TERA-TU-Graz/BatteryManagement_2017/readme.md

# Battery Management System (BMS) with use of STM32 CubeMX
