TERA-TU-Graz/BatteryManagement_2017/HW/projects/ibex/BMS_Ibex/Master/BMS_Master_V6.1_kicad/BMS_Master_V6_kicad.kicad_pcb

## KiCad design HW/projects/ibex/BMS_Ibex/Master/BMS_Master_V6.1_kicad/BMS_Master_V6_kicad.kicad_pcb (2018-10-28, an earlier design)

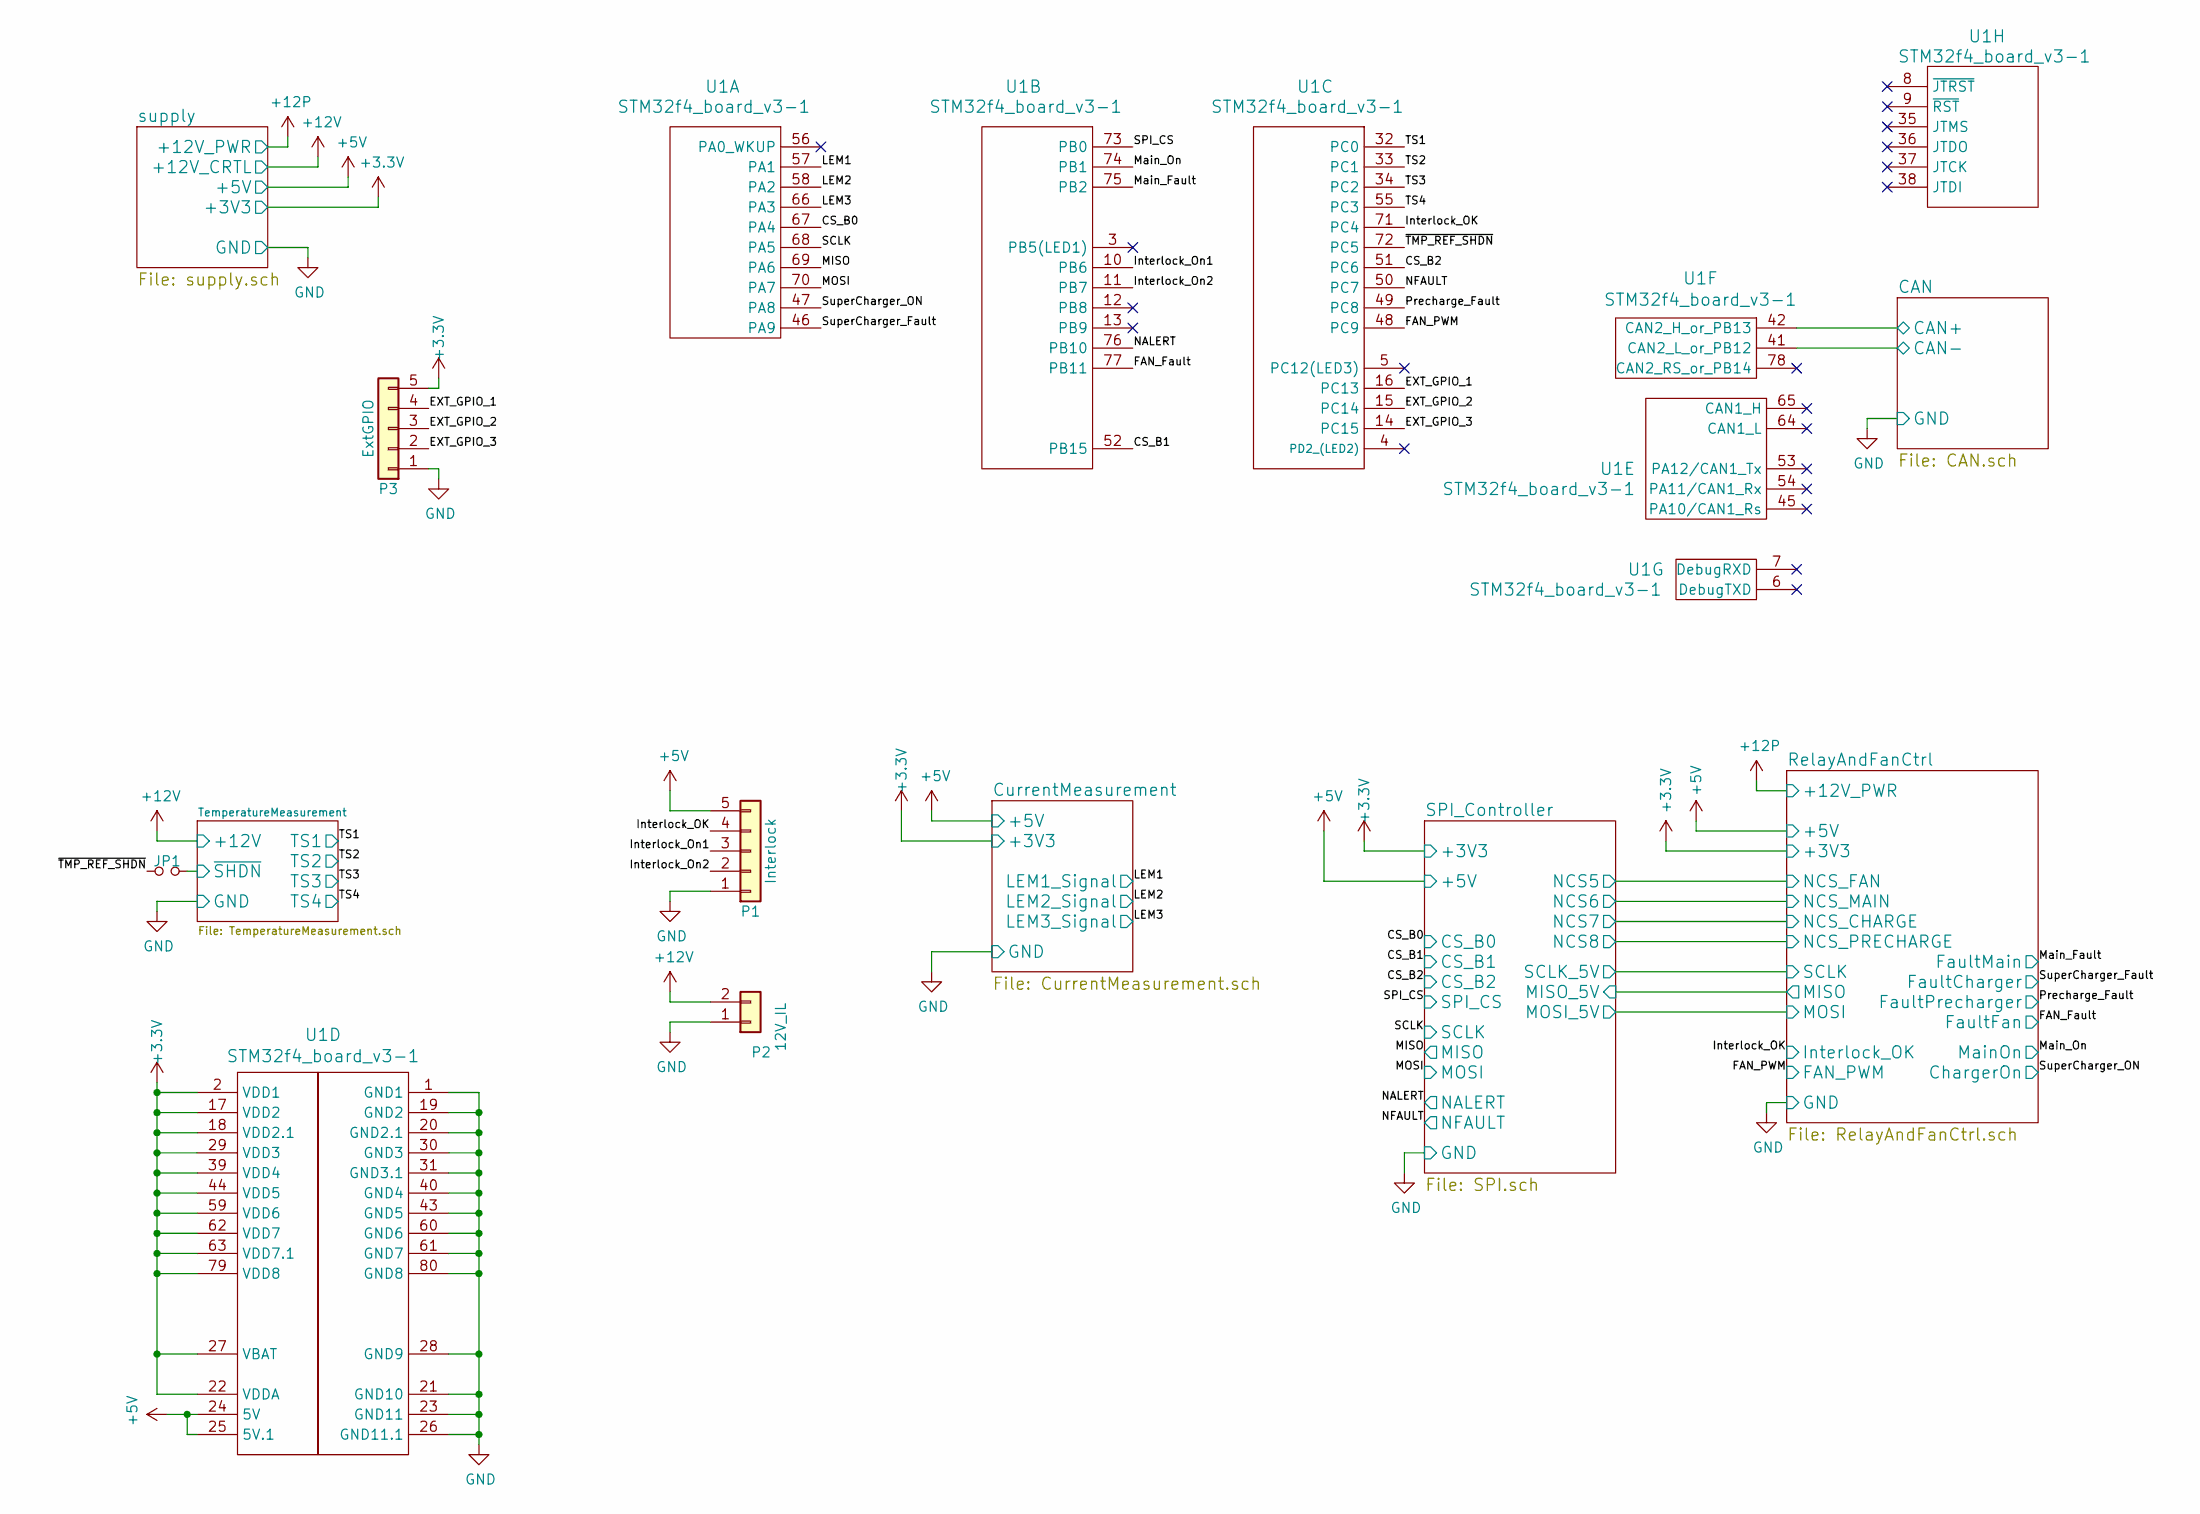
[picture p1: schematic BMS_Master_V6_kicad.sch, BMS Master]

Parts:
JP1: Jumper_NO_Small; SOLDERJUMPER_2
P1: Interlock; JST_XH_B05B-XH-A_05x2.50mm_Straight
P2: 12V_IL; JST_XH_B02B-XH-A_02x2.50mm_Straight
P3: ExtGPIO; JST_EH_B05B-EH-A_05x2.50mm_Straight
U1: STM32f4_board_v3-1; STM32f4-board_v3-1

Connections:
+3V3: P3.5, U1.2 (VDD1), U1.17 (VDD2), U1.18 (VDD2.1), U1.22 (VDDA), U1.27 (VBAT), U1.29 (VDD3), U1.39 (VDD4), U1.44 (VDD5), U1.59 (VDD6), U1.62 (VDD7), U1.63 (VDD7.1), U1.79 (VDD8); also elsewhere on the board
+5V: P1.5, U1.24 (5V), U1.25 (5V.1); also elsewhere on the board
+12V: P2.2; also elsewhere on the board
/CAN/CAN+: U1.42 (CAN2_H_or_PB13); also elsewhere on the board
/CAN/CAN-: U1.41 (CAN2_L_or_PB12); also elsewhere on the board
/CS_B0: U1.67 (PA4); also elsewhere on the board
/CS_B1: U1.52 (PB15); also elsewhere on the board
/CS_B2: U1.51 (PC6); also elsewhere on the board
/EXT_GPIO_1: P3.4, U1.16 (PC13)
/EXT_GPIO_2: P3.3, U1.15 (PC14)
/EXT_GPIO_3: P3.2, U1.14 (PC15)
/FAN_Fault: U1.77 (PB11); also elsewhere on the board
/FAN_PWM: U1.48 (PC9); also elsewhere on the board
/Interlock_OK: P1.4, U1.71 (PC4); also elsewhere on the board
/Interlock_On1: P1.3, U1.10 (PB6)
/Interlock_On2: P1.2, U1.11 (PB7)
/LEM1: U1.57 (PA1); also elsewhere on the board
/LEM2: U1.58 (PA2); also elsewhere on the board
/LEM3: U1.66 (PA3); also elsewhere on the board
/MISO: U1.69 (PA6); also elsewhere on the board
/MOSI: U1.70 (PA7); also elsewhere on the board
/Main_Fault: U1.75 (PB2); also elsewhere on the board
/Main_On: U1.74 (PB1); also elsewhere on the board
/NALERT: U1.76 (PB10); also elsewhere on the board
/NFAULT: U1.50 (PC7); also elsewhere on the board
/Precharge_Fault: U1.49 (PC8); also elsewhere on the board
/SCLK: U1.68 (PA5); also elsewhere on the board
/SPI_CS: U1.73 (PB0); also elsewhere on the board
/SuperCharger_Fault: U1.46 (PA9); also elsewhere on the board
/SuperCharger_ON: U1.47 (PA8); also elsewhere on the board
/TS1: U1.32 (PC0); also elsewhere on the board
/TS2: U1.33 (PC1); also elsewhere on the board
/TS3: U1.34 (PC2); also elsewhere on the board
/TS4: U1.55 (PC3); also elsewhere on the board
/TemperatureMeasurement/~SHDN: JP1.2; also elsewhere on the board
/~TMP_REF_SHDN: JP1.1, U1.72 (PC5)
GND: P1.1, P2.1, P3.1, U1.1 (GND1), U1.19 (GND2), U1.20 (GND2.1), U1.21 (GND10), U1.23 (GND11), U1.26 (GND11.1), U1.28 (GND9), U1.30 (GND3), U1.31 (GND3.1), U1.40 (GND4), U1.43 (GND5), U1.60 (GND6), U1.61 (GND7), U1.80 (GND8); also elsewhere on the board

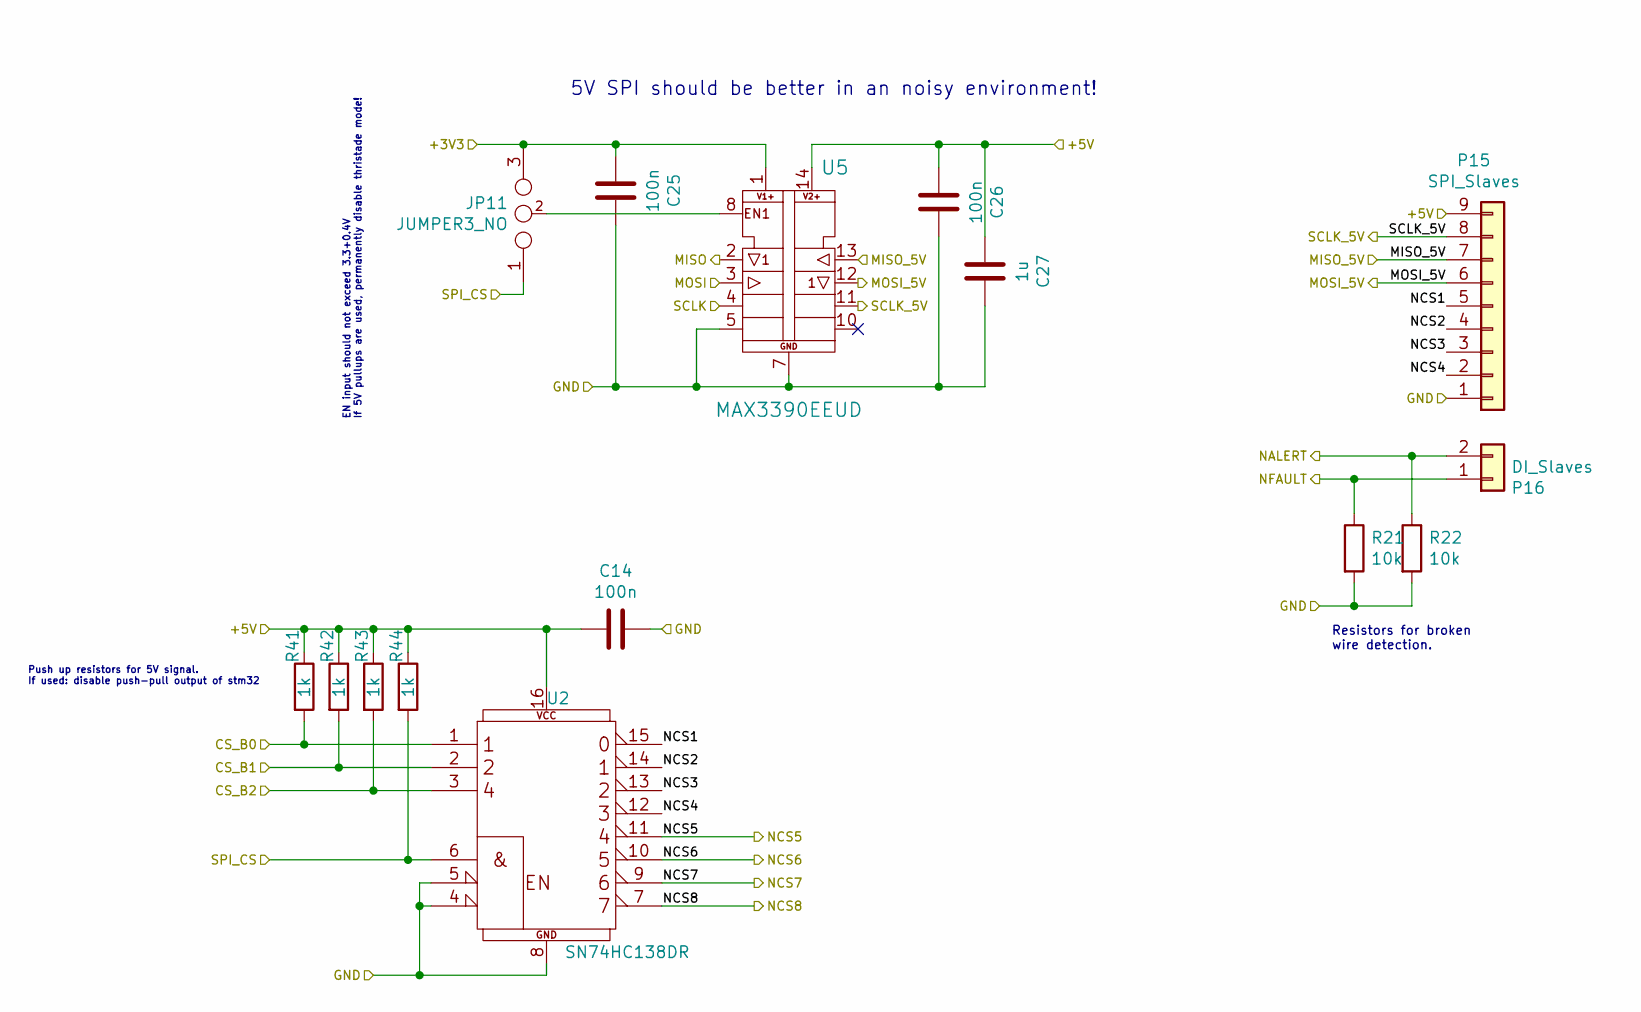
[picture p2: schematic SPI.sch, BMS Master]

Parts:
C14, C25, C26: 100n; C_0603in
C27: 1u; C_0805in
JP11: JUMPER3_NO; SOLDERJUMPER_3
P15: SPI_Slaves; Molex_PicoBlade_53398-0971_09x1.25mm_Straight
P16: DI_Slaves; JST_XH_B02B-XH-A_02x2.50mm_Straight
R21, R22: 10k; R_0805in
R41, R42, R43, R44: 1k; R_0805in
U2: SN74HC138DR
U5: MAX3390EEUD

Connections:
+3V3: C25.2, JP11.3, U5.1 (V1+); also elsewhere on the board
+5V: C14.2, C26.2, C27.2, P15.9, R41.1, R42.1, R43.1, R44.1, U2.16 (VCC), U5.14 (V2+); also elsewhere on the board
/CS_B0: R41.2, U2.1 (A1); also elsewhere on the board
/CS_B1: R42.2, U2.2 (A2); also elsewhere on the board
/CS_B2: R43.2, U2.3 (A4); also elsewhere on the board
/MISO: U5.2 (OUT1); also elsewhere on the board
/MOSI: U5.3 (IN2); also elsewhere on the board
/NALERT: P16.2, R22.1; also elsewhere on the board
/NFAULT: P16.1, R21.1; also elsewhere on the board
/RelayAndFanCtrl/MISO: P15.7, U5.13 (IN1); also elsewhere on the board
/RelayAndFanCtrl/MOSI: P15.6, U5.12 (OUT2); also elsewhere on the board
/RelayAndFanCtrl/SCLK: P15.8, U5.11 (OUT3); also elsewhere on the board
/SCLK: U5.4 (IN3); also elsewhere on the board
/SPI_CS: JP11.1 (m), R44.2, U2.6 (E3); also elsewhere on the board
/SPI_Controller/NCS1: P15.5, U2.15 (O0)
/SPI_Controller/NCS2: P15.4, U2.14 (O1)
/SPI_Controller/NCS3: P15.3, U2.13 (O2)
/SPI_Controller/NCS4: P15.2, U2.12 (O3)
/SPI_Controller/NCS5: U2.11 (O4); also elsewhere on the board
/SPI_Controller/NCS6: U2.10 (O5); also elsewhere on the board
/SPI_Controller/NCS7: U2.9 (O6); also elsewhere on the board
/SPI_Controller/NCS8: U2.7 (O7); also elsewhere on the board
GND: C14.1, C25.1, C26.1, C27.1, P15.1, R21.2, R22.2, U2.4 (E1), U2.5 (E2), U2.8 (GND), U5.5 (IN4), U5.7 (GND); also elsewhere on the board
unnamed: JP11.2, U5.8 (EN1)

Notes on the sheet:
Resistors for broken wire detection.
5V SPI should be better in an noisy environment!
EN input should not exceed 3.3+0.4V If 5V pullups are used, permanently disable thristade mode!
Push up resistors for 5V signal. If used: disable push-pull output of stm32

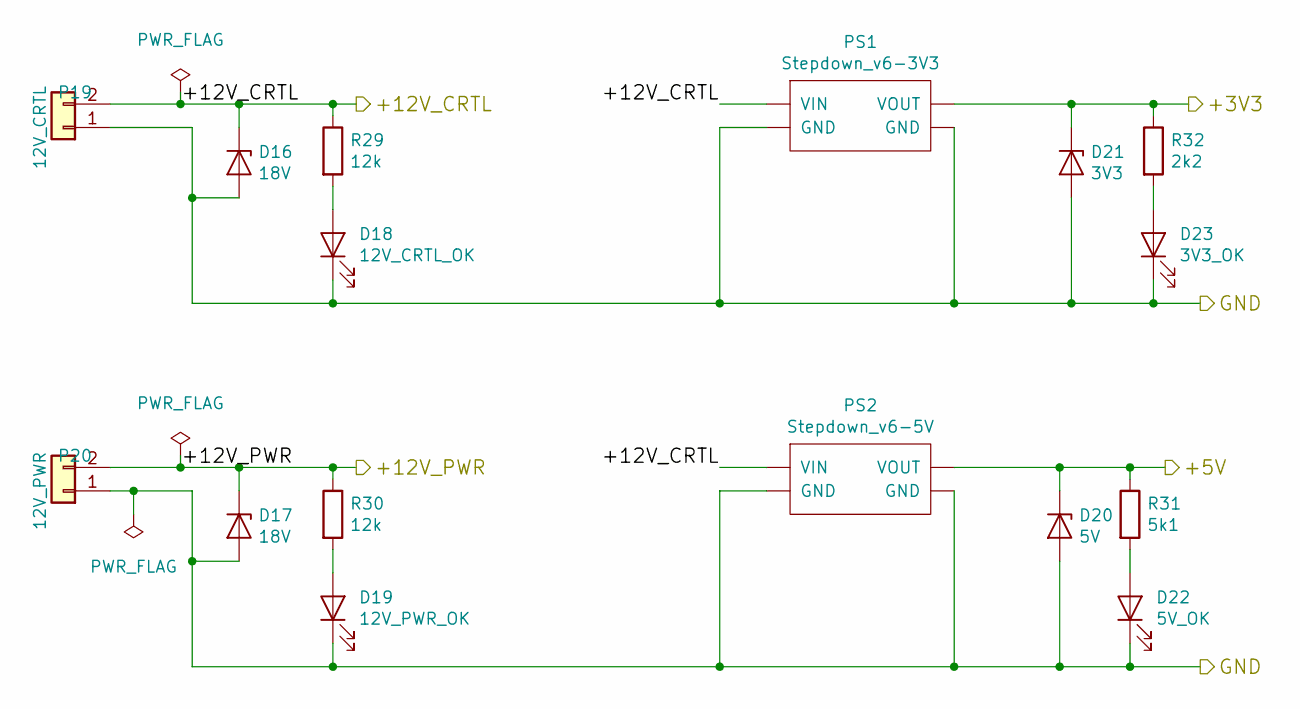
[picture p3: schematic supply.sch, BMS Master]

Parts:
D16, D17: 18V; DO-214AA_with_vias_in_pad
D18: 12V_CRTL_OK; LED_0805
D19: 12V_PWR_OK; LED_0805
D20: 5V; DO-216AA
D21: 3V3; DO-216AA
D22: 5V_OK; LED_0805
D23: 3V3_OK; LED_0805
P19: 12V_CRTL; JST_XH_B02B-XH-A_02x2.50mm_Straight
P20: 12V_PWR; MCV_1.5_2-GF-3.5
PS1: Stepdown_v6-3V3; DCDC_Stepdown_v6
PS2: Stepdown_v6-5V; DCDC_Stepdown_v6
R29, R30: 12k; R_0805in
R31: 5k1; R_0805in
R32: 2k2; R_0805in

Connections:
+3V3: D21.1 (K), PS1.2 (VOUT), R32.1; also elsewhere on the board
+5V: D20.1 (K), PS2.2 (VOUT), R31.1; also elsewhere on the board
+12P: D17.1 (K), P20.2, R30.1; also elsewhere on the board
+12V: D16.1 (K), P19.2, PS1.1 (VIN), PS2.1 (VIN), R29.1; also elsewhere on the board
GND: D16.2 (A), D17.2 (A), D18.1 (K), D19.1 (K), D20.2 (A), D21.2 (A), D22.1 (K), D23.1 (K), P19.1, P20.1, PS1.3 (GND), PS1.4 (GND), PS2.3 (GND), PS2.4 (GND); also elsewhere on the board
unnamed: D18.2 (A), R29.2
unnamed: D19.2 (A), R30.2
unnamed: D22.2 (A), R31.2
unnamed: D23.2 (A), R32.2

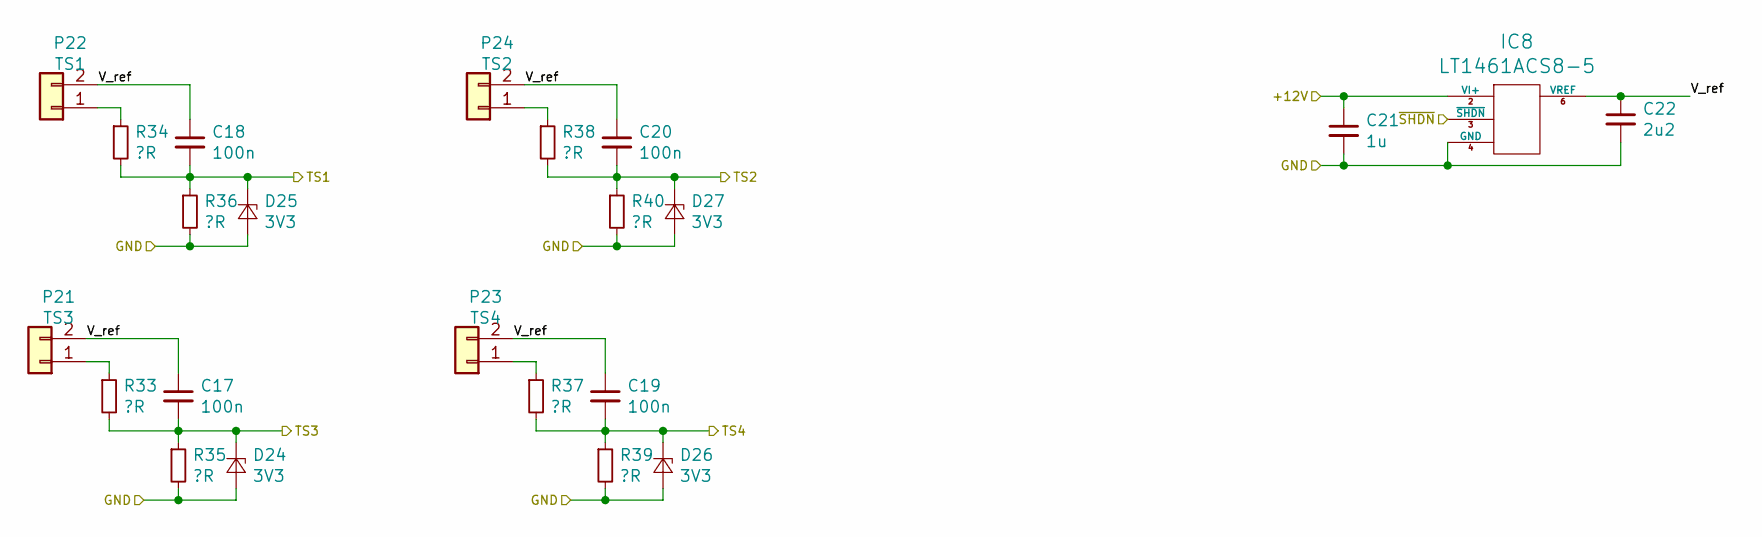
[picture p4: schematic TemperatureMeasurement.sch, BMS Master]

Parts:
C17, C18, C19, C20: 100n; C_0603in
C21: 1u; C_0805in
C22: 2u2; C_0805in
D24, D25, D26, D27: 3V3; DO-216AA
IC8: LT1461ACS8-5; LT1461ACS8
P21: TS3; Molex_PicoBlade_53398-0271_02x1.25mm_Straight
P22: TS1; Molex_PicoBlade_53398-0271_02x1.25mm_Straight
P23: TS4; Molex_PicoBlade_53398-0271_02x1.25mm_Straight
P24: TS2; Molex_PicoBlade_53398-0271_02x1.25mm_Straight
R33, R34, R35, R36, R37, R38, R39, R40: ?R; R_0603in

Connections:
+12V: C21.1, IC8.2 (VI+); also elsewhere on the board
/TS1: C18.2, D25.1 (K), R34.2, R36.1; also elsewhere on the board
/TS2: C20.2, D27.1 (K), R38.2, R40.1; also elsewhere on the board
/TS3: C17.2, D24.1 (K), R33.2, R35.1; also elsewhere on the board
/TS4: C19.2, D26.1 (K), R37.2, R39.1; also elsewhere on the board
/TemperatureMeasurement/V_ref: C17.1, C18.1, C19.1, C20.1, C22.1, IC8.6 (VREF), P21.2, P22.2, P23.2, P24.2
/TemperatureMeasurement/~SHDN: IC8.3 (~SHDN); also elsewhere on the board
GND: C21.2, C22.2, D24.2 (A), D25.2 (A), D26.2 (A), D27.2 (A), IC8.4 (GND), R35.2, R36.2, R39.2, R40.2; also elsewhere on the board
unnamed: P21.1, R33.1
unnamed: P22.1, R34.1
unnamed: P23.1, R37.1
unnamed: P24.1, R38.1

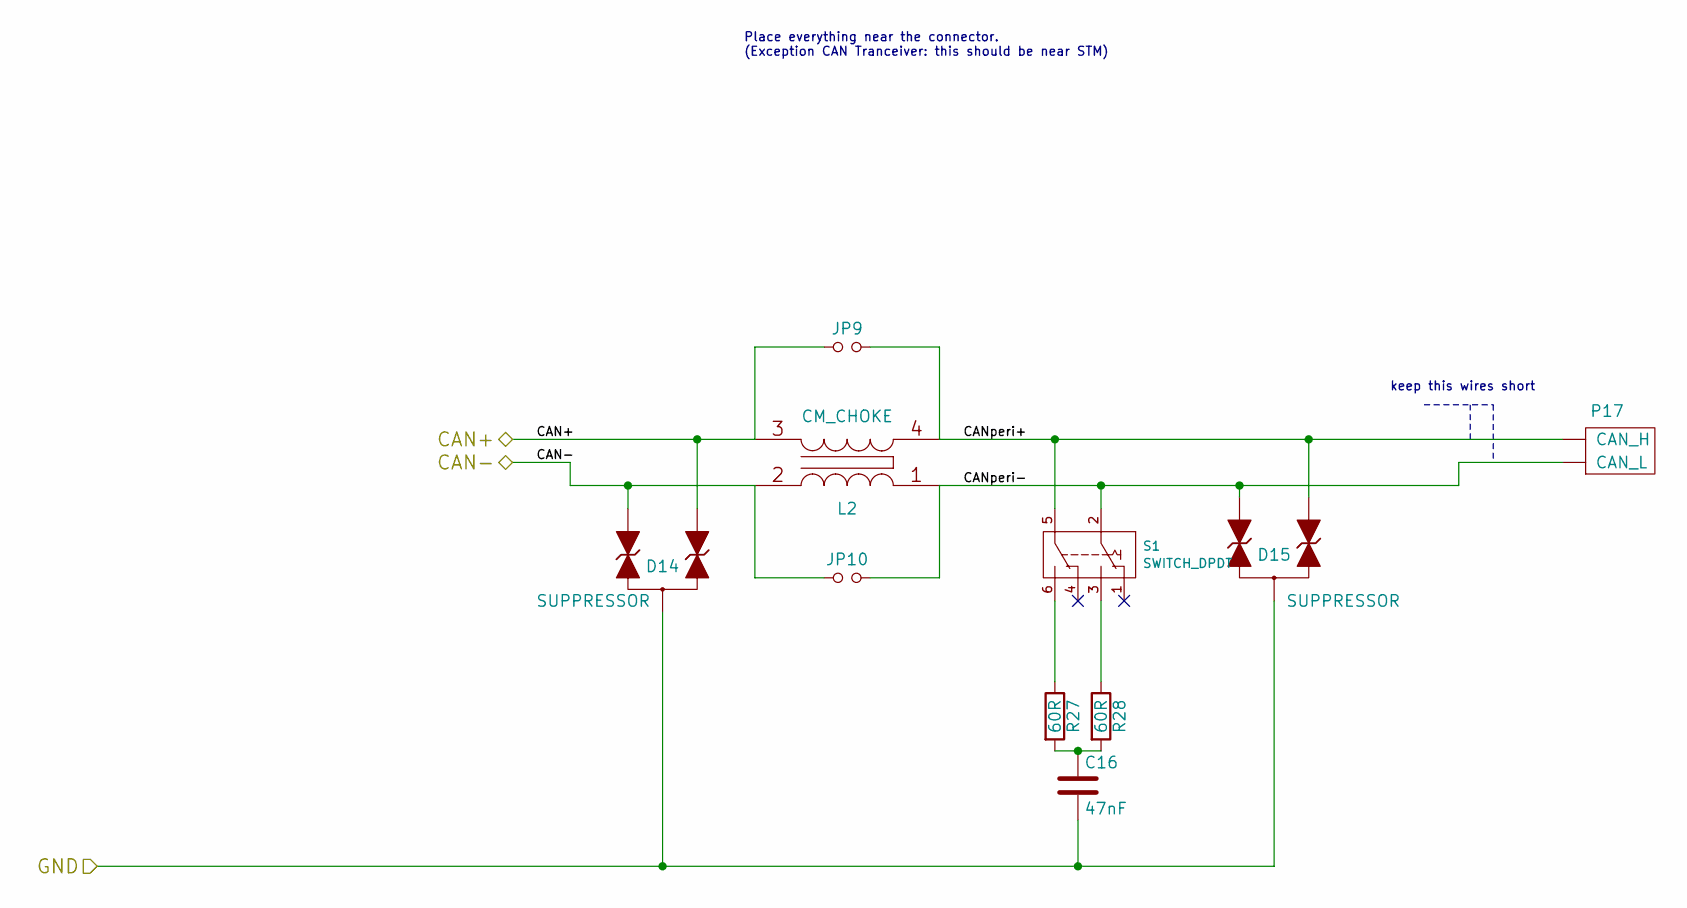
[picture p5: schematic CAN.sch, BMS Master]

Parts:
C15: 47nF; C_0603in
D12, D13: SUPPRESSOR; SOT-23
JP7, JP8: Jumper_NO_Small; SOLDERJUMPER_2
L1: CM_CHOKE; L_ACT45B-XXX-2P_common-mode-choke
P17: CAN_CON_2pol; JST_PH_B2B-PH-K_02x2.00mm_Straight
R24, R25: 60R; R_0603in
S1: SWITCH_DPDT; CuK_JS202011CQN_DPDT

Connections:
/CAN/CANperi+: P17.2 (CAN_H), S1.5; also elsewhere on the board
/CAN/CANperi-: P17.1 (CAN_L), S1.2; also elsewhere on the board
unnamed 93: S1.6; also elsewhere on the board
unnamed 94: S1.3; also elsewhere on the board

Parts of its further copies:
C16: 47nF; C_0603in
D14, D15: SUPPRESSOR; SOT-23
JP9, JP10: Jumper_NO_Small; SOLDERJUMPER_2
L2: CM_CHOKE; L_ACT45B-XXX-2P_common-mode-choke
R27, R28: 60R; R_0603in

Connections of its further copies:
/CAN/CAN+: D14.2 (Pin2), JP9.1, L2.3 (SA); also elsewhere on the board
/CAN/CAN-: D14.1 (Pin1), JP10.1, L2.2 (AB); also elsewhere on the board
/CAN/CANperi+: D15.2 (Pin2), JP9.2, L2.4 (SB); also elsewhere on the board
/CAN/CANperi-: D15.1 (Pin1), JP10.2, L2.1 (AA); also elsewhere on the board
GND: C16.2, D14.3 (Pin3), D15.3 (Pin3); also elsewhere on the board
unnamed: C16.1, R27.2, R28.2
unnamed 93: R27.1; also elsewhere on the board
unnamed 94: R28.1; also elsewhere on the board

Notes on the sheet:
Place everything near the connector. (Exception CAN Tranceiver: this should be near STM)
keep this wires short

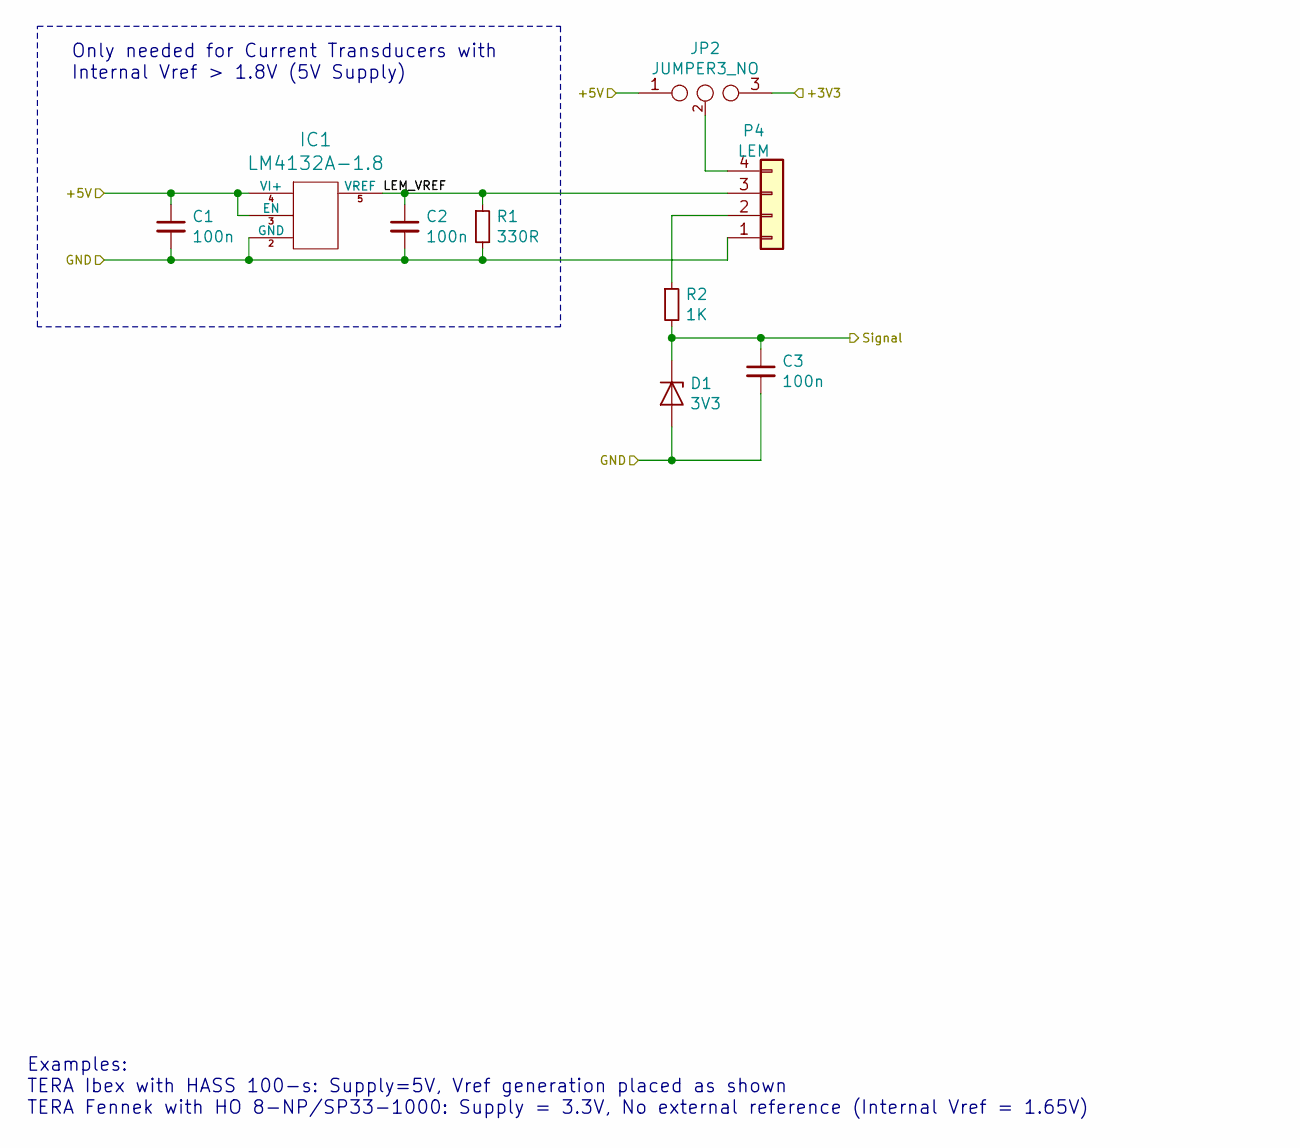
[picture p6: schematic LEM.sch, BMS Master]

Parts:
C1, C2, C3: 100n; C_0603in
D1: 3V3; DO-216AA
IC1: LM4132A-1.8; LM4132A
JP2: JUMPER3_NO; SOLDERJUMPER_3
P4: LEM; Molex_PicoBlade_53398-0471_04x1.25mm_Straight
R1: 330R; R_0603in
R2: 1K; R_0805in

Connections:
+3V3: JP2.3; also elsewhere on the board
+5V: C1.1, IC1.3 (EN), IC1.4 (VI+), JP2.1 (m); also elsewhere on the board
/CurrentMeasurement/LEM1/LEM_VREF: C2.1, IC1.5 (VREF), P4.3, R1.1
/LEM1: C3.1, D1.1 (K), R2.2; also elsewhere on the board
GND: C1.2, C2.2, C3.2, D1.2 (A), IC1.2 (GND), P4.1, R1.2; also elsewhere on the board
unnamed: JP2.2, P4.4
unnamed: P4.2, R2.1

Parts of its further copies:
C4, C5, C6, C7, C8, C9: 100n; C_0603in
D2, D3: 3V3; DO-216AA
IC2, IC3: LM4132A-1.8; LM4132A
JP3, JP4: JUMPER3_NO; SOLDERJUMPER_3
P5, P6: LEM; Molex_PicoBlade_53398-0471_04x1.25mm_Straight
R3, R5: 330R; R_0603in
R4, R6: 1K; R_0805in

Connections of its further copies:
+3V3: JP3.3, JP4.3; also elsewhere on the board
+5V: C4.1, C7.1, IC2.3 (EN), IC2.4 (VI+), IC3.3 (EN), IC3.4 (VI+), JP3.1 (m), JP4.1 (m); also elsewhere on the board
/CurrentMeasurement/LEM2/LEM_VREF: C5.1, IC2.5 (VREF), P5.3, R3.1
/CurrentMeasurement/LEM3/LEM_VREF: C8.1, IC3.5 (VREF), P6.3, R5.1
/LEM2: C6.1, D2.1 (K), R4.2; also elsewhere on the board
/LEM3: C9.1, D3.1 (K), R6.2; also elsewhere on the board
GND: C4.2, C5.2, C6.2, C7.2, C8.2, C9.2, D2.2 (A), D3.2 (A), IC2.2 (GND), IC3.2 (GND), P5.1, P6.1, R3.2, R5.2; also elsewhere on the board
unnamed: JP3.2, P5.4
unnamed: JP4.2, P6.4
unnamed: P5.2, R4.1
unnamed: P6.2, R6.1

Notes on the sheet:
Only needed for Current Transducers with Internal Vref > 1.8V (5V Supply)
Examples: TERA Ibex with HASS 100-s: Supply=5V, Vref generation placed as shown TERA Fennek with HO 8-NP/SP33-1000: Supply = 3.3V, No external reference (Internal Vref = 1.65V)

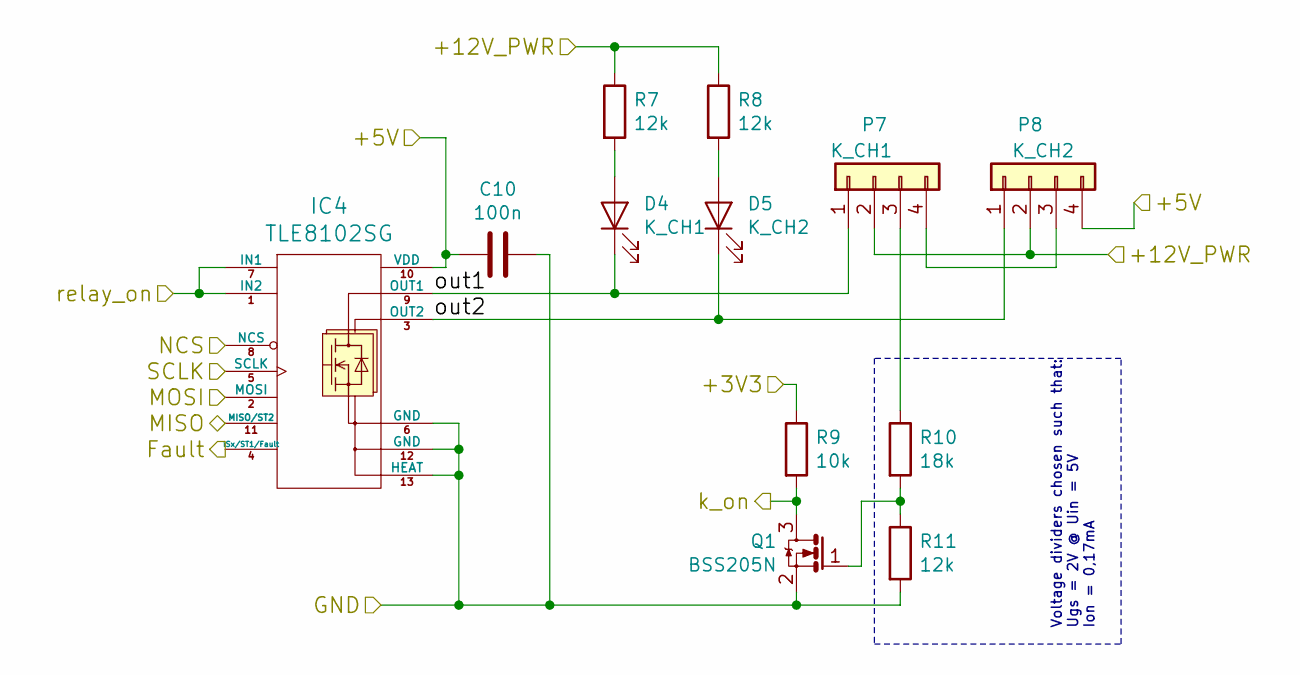
[picture p7: schematic 2xRelaisWithRM.sch, BMS Master]

Parts:
C10: 100n; C_0603in
D4: K_CH1; LED_0805
D5: K_CH2; LED_0805
IC4: TLE8102SG; INF-PG-DSO-12-11-EP_N_EPvias
P7: K_CH1; JST_XH_B04B-XH-A_04x2.50mm_Straight
P8: K_CH2; JST_XH_B04B-XH-A_04x2.50mm_Straight
Q1: BSS205N; SOT-23
R7, R8, R11: 12k; R_0805in
R9: 10k; R_0603in
R10: 18k; R_0805in

Connections:
+3V3: R9.1; also elsewhere on the board
+5V: C10.2, IC4.10 (VDD), P8.4; also elsewhere on the board
+12P: P7.2, P8.2, R7.1, R8.1; also elsewhere on the board
/Interlock_OK: IC4.1 (IN2), IC4.7 (IN1); also elsewhere on the board
/RelayAndFanCtrl/MISO: IC4.11 (MISO/ST2); also elsewhere on the board
/RelayAndFanCtrl/MOSI: IC4.2 (MOSI); also elsewhere on the board
/RelayAndFanCtrl/SCLK: IC4.5 (SCLK); also elsewhere on the board
/RelayAndFanCtrl/SuperChargerRelais/out1: D4.1 (K), IC4.9 (OUT1), P7.1
/RelayAndFanCtrl/SuperChargerRelais/out2: D5.1 (K), IC4.3 (OUT2), P8.1
/SPI_Controller/NCS7: IC4.8 (NCS); also elsewhere on the board
/SuperCharger_Fault: IC4.4 (ISx/ST1/Fault); also elsewhere on the board
/SuperCharger_ON: Q1.3 (D), R9.2; also elsewhere on the board
GND: C10.1, IC4.6 (GND), IC4.12 (GND), IC4.13 (HEAT), Q1.2 (S), R11.2; also elsewhere on the board
unnamed: D4.2 (A), R7.2
unnamed: D5.2 (A), R8.2
unnamed: P7.3, R10.1
unnamed: P7.4, P8.3
unnamed: Q1.1 (G), R10.2, R11.1

Parts of its further copies:
C11: 100n; C_0603in
D6: K_CH1; LED_0805
D7: K_CH2; LED_0805
IC5: TLE8102SG; INF-PG-DSO-12-11-EP_N_EPvias
P9: K_CH1; JST_XH_B04B-XH-A_04x2.50mm_Straight
P10: K_CH2; JST_XH_B04B-XH-A_04x2.50mm_Straight
Q2: BSS205N; SOT-23
R12, R13, R16: 12k; R_0805in
R14: 10k; R_0603in
R15: 18k; R_0805in

Connections of its further copies:
+3V3: R14.1; also elsewhere on the board
+5V: C11.2, IC5.10 (VDD), P10.4; also elsewhere on the board
+12P: P9.2, P10.2, R12.1, R13.1; also elsewhere on the board
/Interlock_OK: IC5.1 (IN2), IC5.7 (IN1); also elsewhere on the board
/Main_Fault: IC5.4 (ISx/ST1/Fault); also elsewhere on the board
/Main_On: Q2.3 (D), R14.2; also elsewhere on the board
/RelayAndFanCtrl/MISO: IC5.11 (MISO/ST2); also elsewhere on the board
/RelayAndFanCtrl/MOSI: IC5.2 (MOSI); also elsewhere on the board
/RelayAndFanCtrl/MainRelais/out1: D6.1 (K), IC5.9 (OUT1), P9.1
/RelayAndFanCtrl/MainRelais/out2: D7.1 (K), IC5.3 (OUT2), P10.1
/RelayAndFanCtrl/SCLK: IC5.5 (SCLK); also elsewhere on the board
/SPI_Controller/NCS6: IC5.8 (NCS); also elsewhere on the board
GND: C11.1, IC5.6 (GND), IC5.12 (GND), IC5.13 (HEAT), Q2.2 (S), R16.2; also elsewhere on the board
unnamed: D6.2 (A), R12.2
unnamed: D7.2 (A), R13.2
unnamed: P9.3, R15.1
unnamed: P9.4, P10.3
unnamed: Q2.1 (G), R15.2, R16.1

Notes on the sheet:
Voltage dividers chosen such that: Ugs = 2V @ Uin = 5V Ion = 0,17mA

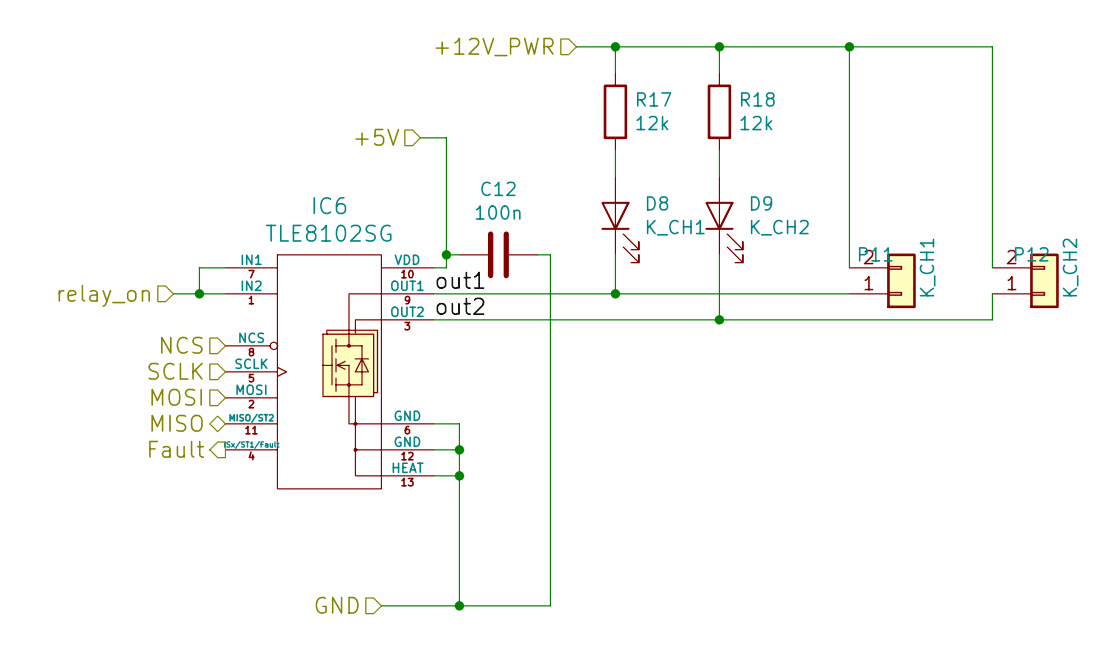
[picture p8: schematic 2xLowSideSwitch8A.sch, BMS Master]

Parts:
C12: 100n; C_0603in
D8: K_CH1; LED_0805
D9: K_CH2; LED_0805
IC6: TLE8102SG; INF-PG-DSO-12-11-EP_N_EPvias
P11: K_CH1; JST_XH_B02B-XH-A_02x2.50mm_Straight
P12: K_CH2; JST_XH_B02B-XH-A_02x2.50mm_Straight
R17, R18: 12k; R_0805in

Connections:
+5V: C12.2, IC6.10 (VDD); also elsewhere on the board
+12P: P11.2, P12.2, R17.1, R18.1; also elsewhere on the board
/Interlock_OK: IC6.1 (IN2), IC6.7 (IN1); also elsewhere on the board
/Precharge_Fault: IC6.4 (ISx/ST1/Fault); also elsewhere on the board
/RelayAndFanCtrl/MISO: IC6.11 (MISO/ST2); also elsewhere on the board
/RelayAndFanCtrl/MOSI: IC6.2 (MOSI); also elsewhere on the board
/RelayAndFanCtrl/PRECHARGER/out1: D8.1 (K), IC6.9 (OUT1), P11.1
/RelayAndFanCtrl/PRECHARGER/out2: D9.1 (K), IC6.3 (OUT2), P12.1
/RelayAndFanCtrl/SCLK: IC6.5 (SCLK); also elsewhere on the board
/SPI_Controller/NCS8: IC6.8 (NCS); also elsewhere on the board
GND: C12.1, IC6.6 (GND), IC6.12 (GND), IC6.13 (HEAT); also elsewhere on the board
unnamed: D8.2 (A), R17.2
unnamed: D9.2 (A), R18.2

Parts of its further copies:
C13: 100n; C_0603in
D10: K_CH1; LED_0805
D11: K_CH2; LED_0805
IC7: TLE8102SG; INF-PG-DSO-12-11-EP_N_EPvias
P13: K_CH1; JST_XH_B02B-XH-A_02x2.50mm_Straight
P14: K_CH2; JST_XH_B02B-XH-A_02x2.50mm_Straight
R19, R20: 12k; R_0805in

Connections of its further copies:
+5V: C13.2, IC7.10 (VDD); also elsewhere on the board
+12P: P13.2, P14.2, R19.1, R20.1; also elsewhere on the board
/FAN_Fault: IC7.4 (ISx/ST1/Fault); also elsewhere on the board
/FAN_PWM: IC7.1 (IN2), IC7.7 (IN1); also elsewhere on the board
/RelayAndFanCtrl/FANS/out1: D10.1 (K), IC7.9 (OUT1), P13.1
/RelayAndFanCtrl/FANS/out2: D11.1 (K), IC7.3 (OUT2), P14.1
/RelayAndFanCtrl/MISO: IC7.11 (MISO/ST2); also elsewhere on the board
/RelayAndFanCtrl/MOSI: IC7.2 (MOSI); also elsewhere on the board
/RelayAndFanCtrl/SCLK: IC7.5 (SCLK); also elsewhere on the board
/SPI_Controller/NCS5: IC7.8 (NCS); also elsewhere on the board
GND: C13.1, IC7.6 (GND), IC7.12 (GND), IC7.13 (HEAT); also elsewhere on the board
unnamed: D10.2 (A), R19.2
unnamed: D11.2 (A), R20.2

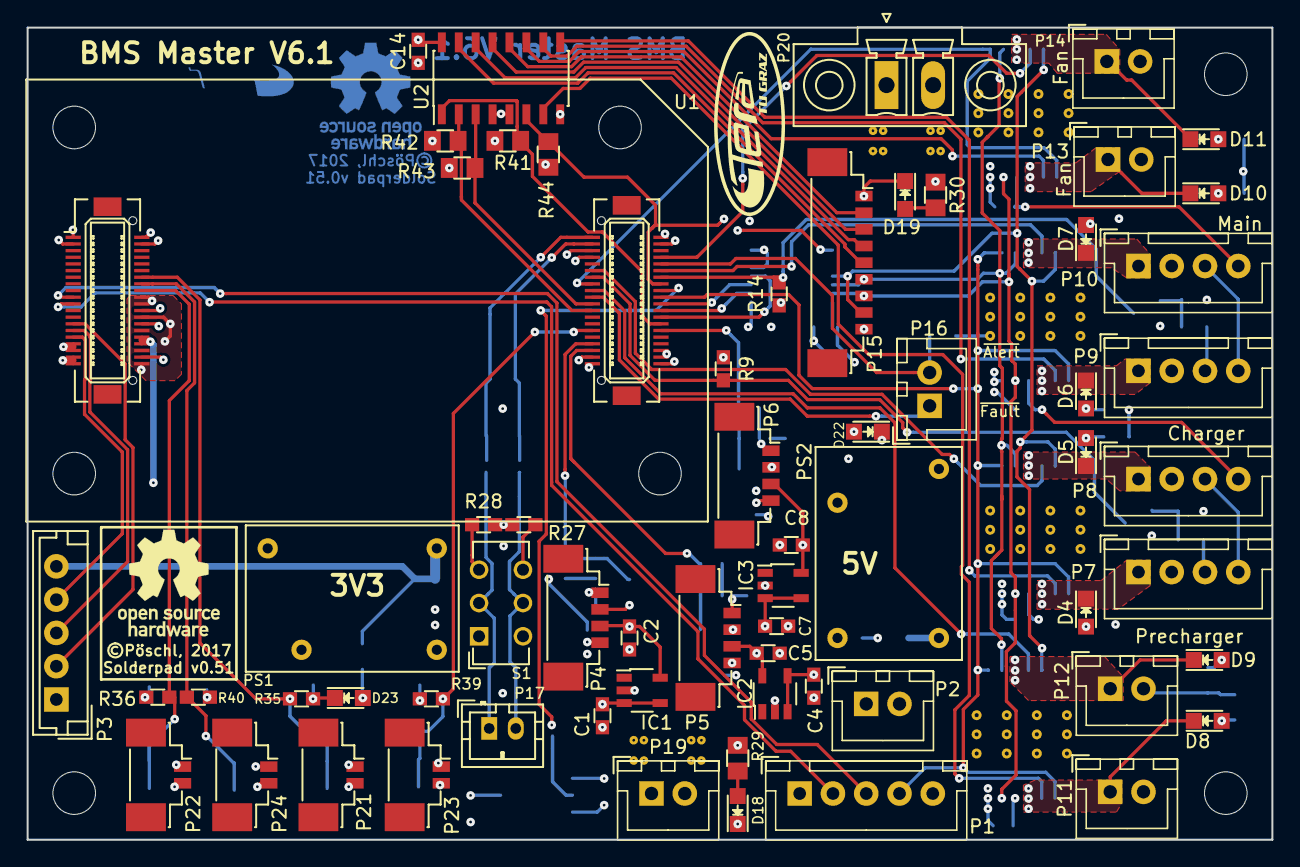
[picture p9: board BMS_Master_V6_kicad.kicad_pcb from above]

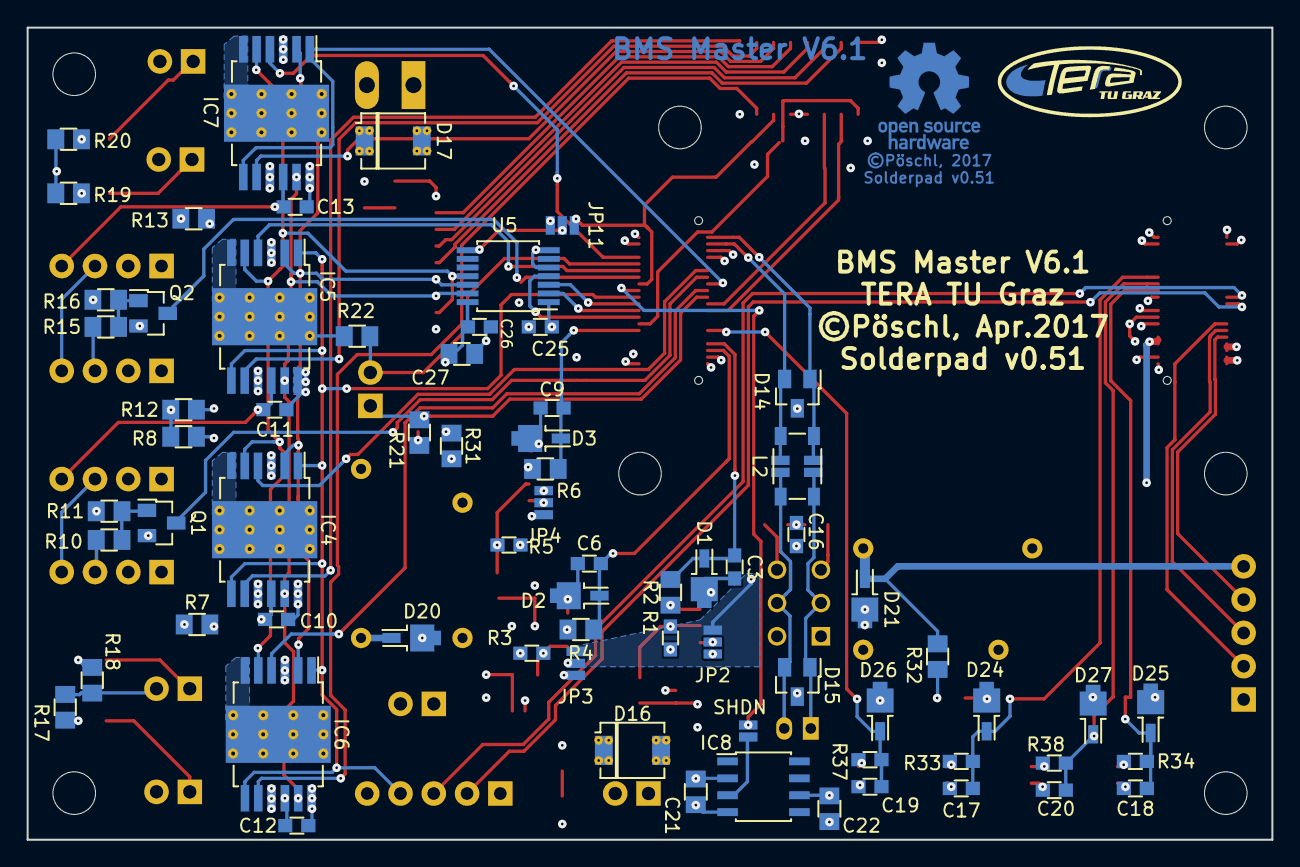
[picture p10: board BMS_Master_V6_kicad.kicad_pcb from below]

Board: 4 copper layers, 93.5 x 61.0 mm, 138 parts (73 on the bottom side), 95 nets.

Other parts of the board:
svg2mod: G***; TERA_Logo_SilkS_5x12.5mm
svg2mod#2: G***; TERA_Logo_SilkS_and_Cu_5x12.5mm
