TERA-TU-Graz/BatteryManagement_2017/HW/projects/ibex/BMS_Ibex/Interlock/InterlockV2.1-kicad/Interlock.kicad_pcb

## KiCad design HW/projects/ibex/BMS_Ibex/Interlock/InterlockV2.1-kicad/Interlock.kicad_pcb (2018-10-28, an earlier design)

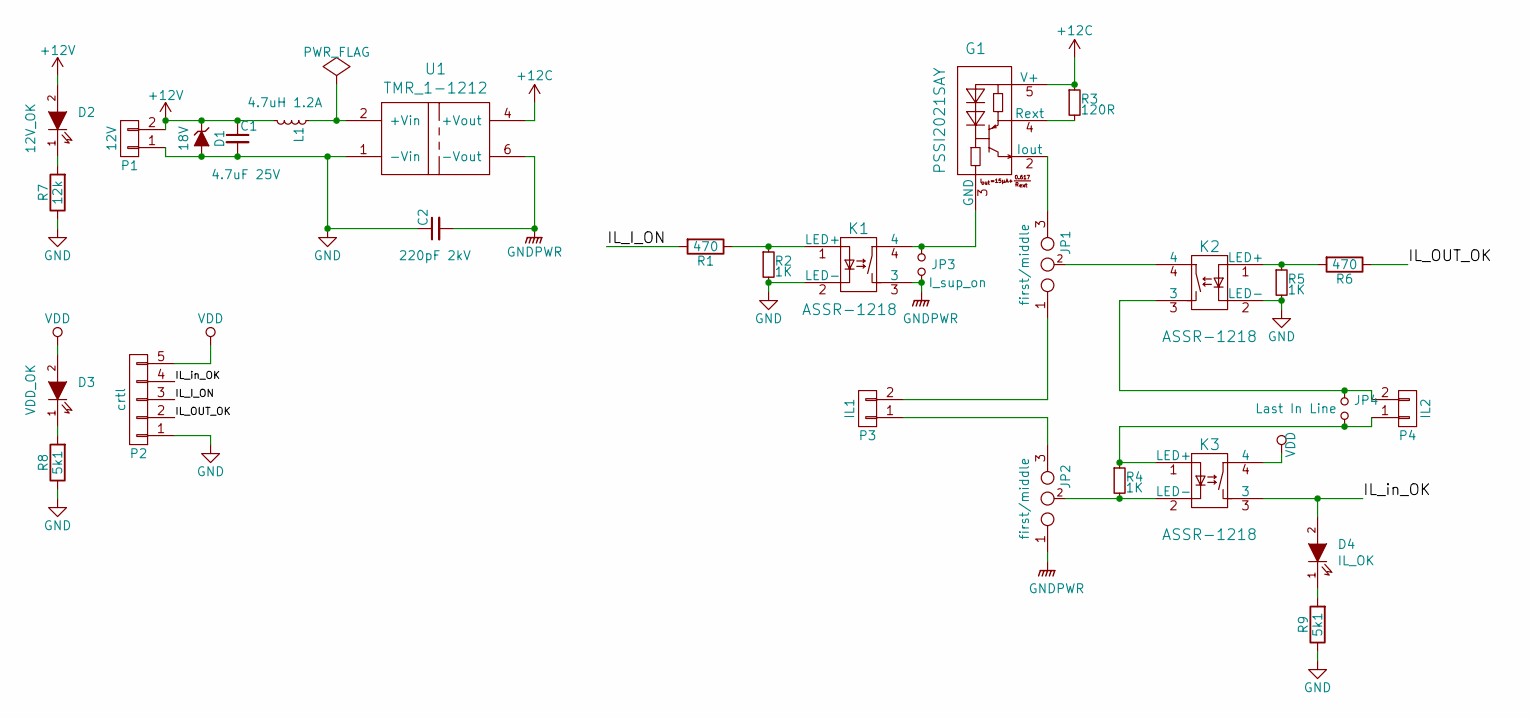
[picture p11: schematic Interlock.sch, BMS Interlock]

Parts:
C1: 4.7uF 25V; C_0805in
C2: 220pF 2kV; C_1206in_HV
D1: 18V; DO-214AA
D2: 12V_OK; LED_0805
D3: VDD_OK; LED_0805
D4: IL_OK; LED_0805
G1: PSSI2021SAY
JP1, JP2: first/middle; SOLDERJUMPER_3
JP3: I_sup_on; SOLDERJUMPER_2
JP4: Last In Line; SOLDERJUMPER_2
K1, K2, K3: ASSR-1218; SO-4
L1: 4.7uH 1.2A; L_muarta_LQH32PN
P1: 12V; JST_XH_B02B-XH-A_02x2.50mm_Straight
P2: crtl; JST_XH_B05B-XH-A_05x2.50mm_Straight
P3: IL1; JST_EH_B02B-EH-A_02x2.50mm_Straight
P4: IL2; JST_EH_B02B-EH-A_02x2.50mm_Straight
R1, R6: 470; R_0603in
R2, R4, R5: 1K; R_0603in
R3: 120R; R_0603in
R7: 12k; R_0603in
R8, R9: 5k1; R_0603in
U1: TMR_1-1212; TMR_1-XX1X

Connections:
+12C: G1.5 (V+), R3.1, U1.4 (+Vout)
+12V: C1.1, D1.1 (K), D2.2 (A), L1.2, P1.2
/IL_I_ON: P2.3, R1.2
/IL_OUT_OK: P2.2, R6.1
/IL_in_OK: D4.2 (A), K3.3, P2.4
GND: C1.2, C2.1, D1.2 (A), K1.2 (LED-), K2.2 (LED-), P1.1, P2.1, R2.2, R5.2, R7.1, R8.1, R9.1, U1.1 (-Vin)
GNDPWR: C2.2, JP2.1 (m), JP3.2, K1.3, U1.6 (-Vout)
unnamed: D2.1 (K), R7.2
unnamed: D3.1 (K), R8.2
unnamed: D4.1 (K), R9.2
unnamed: G1.2 (Iout), JP1.3
unnamed: G1.3 (GND), JP3.1, K1.4
unnamed: G1.4 (Rext), R3.2
unnamed: JP1.1 (m), P3.2
unnamed: JP1.2, K2.4
unnamed: JP2.2, K3.2 (LED-), R4.2
unnamed: JP2.3, P3.1
unnamed: JP4.1, K2.3, P4.2
unnamed: JP4.2, K3.1 (LED+), P4.1, R4.1
unnamed: K1.1 (LED+), R1.1, R2.1
unnamed: K2.1 (LED+), R5.1, R6.2
unnamed: L1.1, U1.2 (+Vin)
VDD: D3.2 (A), K3.4, P2.5

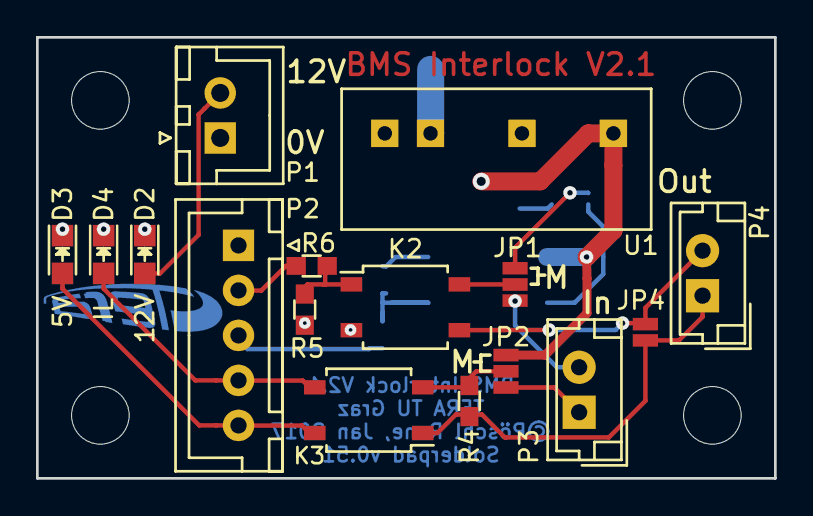
[picture p12: board Interlock.kicad_pcb from above]

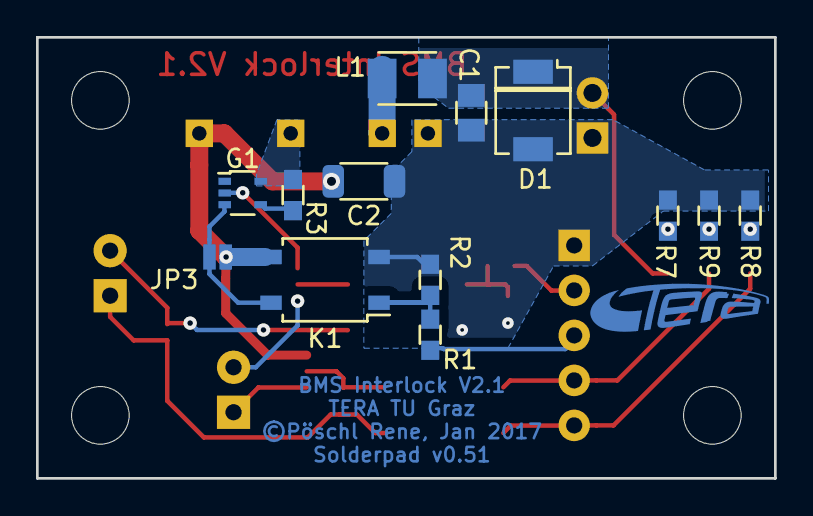
[picture p13: board Interlock.kicad_pcb from below]

Board: 2 copper layers, 41.0 x 24.5 mm, 30 parts (14 on the bottom side), 23 nets.

Other parts of the board:
svg2mod: G***; TERA_TextOnly_Cu_2.5x9.5mm
