TERA-TU-Graz/BatteryManagement_2017/HW/projects/ibex/BMS_Ibex/Vorladeschaltung/PreCharger V2/PreCharger V2.kicad_pcb

## KiCad design HW/projects/ibex/BMS_Ibex/Vorladeschaltung/PreCharger V2/PreCharger V2.kicad_pcb (2018-10-28)

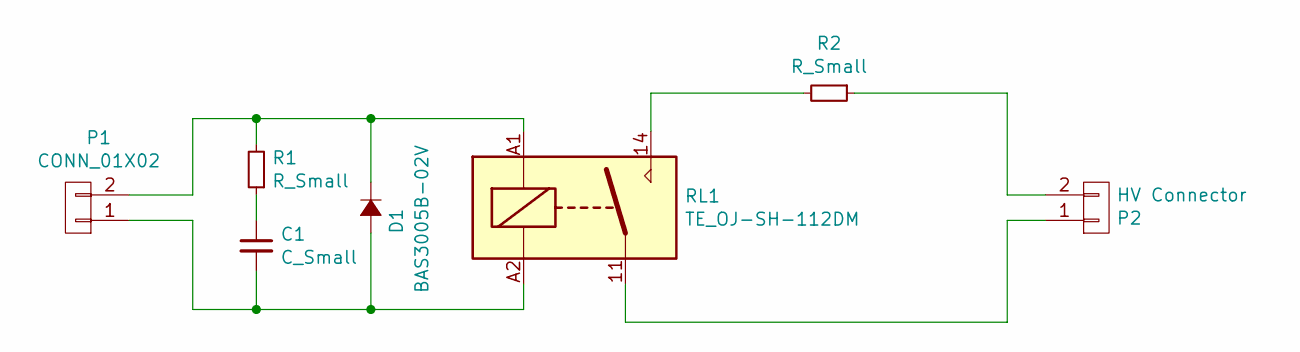
[picture p14: schematic PreCharger V2.sch]

Parts:
C1: C_Small; C_0805in
D1: BAS3005B-02V; BAS3005B-02V__sc79
P1: CONN_01X02; JST_XH_B02B-XH-A_02x2.50mm_Straight
P2: HV Connector; MCV_1.5_2-GF-3.5_MountHole
R1: R_Small; R_0805in
R2: R_Small; R_WH25
RL1: TE_OJ-SH-112DM; RELAIS-TE-OJ

Connections:
unnamed: C1.1, R1.1
unnamed: C1.2, D1.2 (A), P1.1, RL1.A2
unnamed: D1.1 (K), P1.2, R1.2, RL1.A1
unnamed: P2.1, RL1.11
unnamed: P2.2, R2.1
unnamed: R2.2, RL1.14

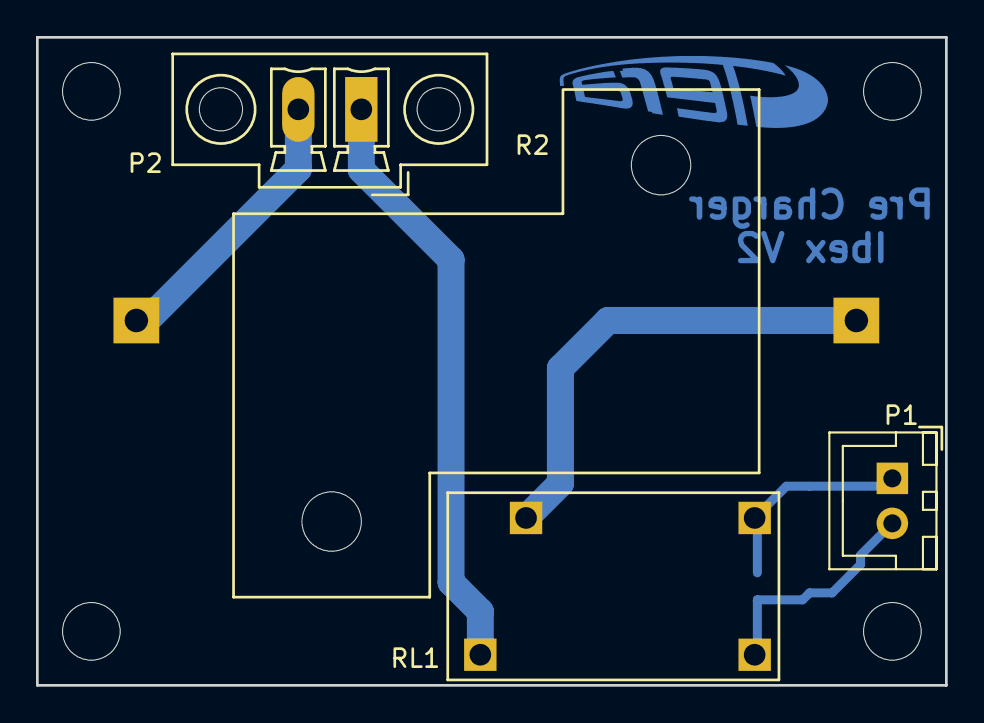
[picture p15: board PreCharger V2.kicad_pcb from above]

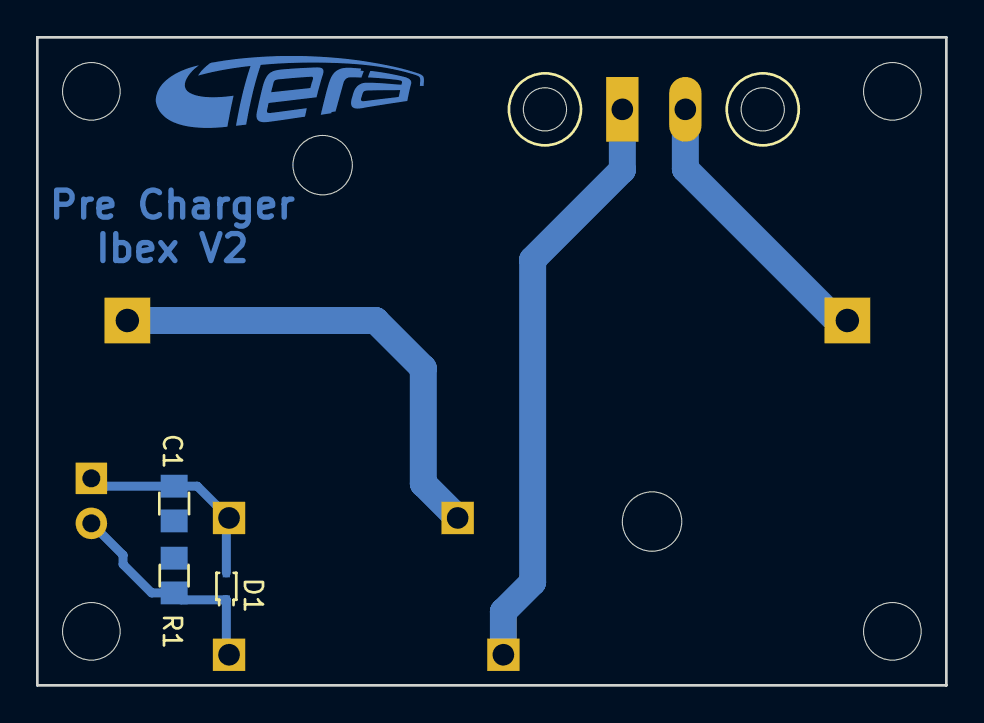
[picture p16: board PreCharger V2.kicad_pcb from below]

Board: 2 copper layers, 50.5 x 36.0 mm, 8 parts (4 on the bottom side), 6 nets.

Other parts of the board:
svg2mod: G***; TERA_TextOnly_Cu_3.75x14mm
