TERA-TU-Graz/BatteryManagement_2017/HW/projects/ibex/BMS_Ibex/Messboard/bms_board_V5.1/bms_board.kicad_pcb

## KiCad design HW/projects/ibex/BMS_Ibex/Messboard/bms_board_V5.1/bms_board.kicad_pcb (2018-10-28)

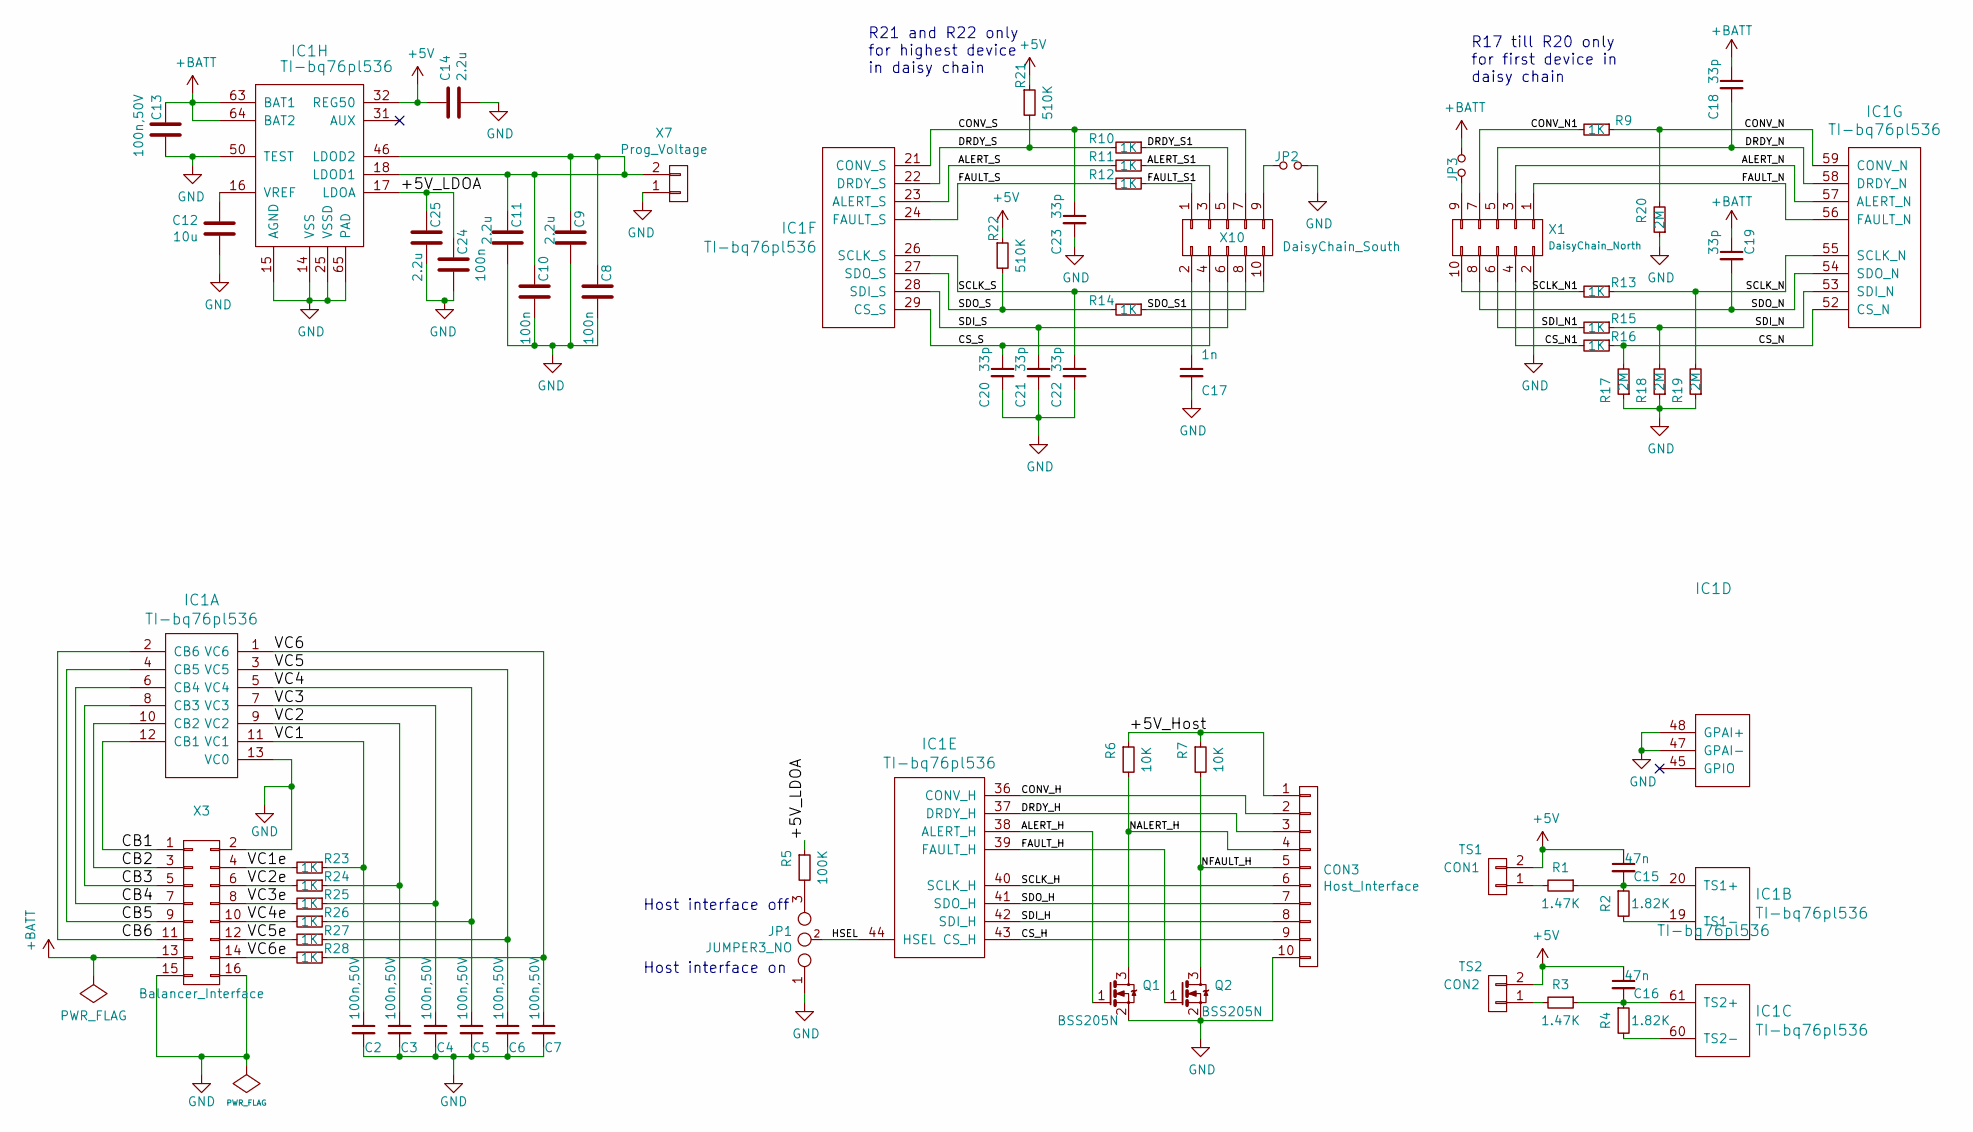
[picture p17: schematic bms_board.sch, BMS Monitor]

Parts:
C2, C3, C4, C5, C6, C7, C13: 100n,50V; C_0805in
C8, C10, C24: 100n; C_0603in
C9, C11, C14, C25: 2.2u; C_0805in
C12: 10u; C_0805in
C15, C16: 47n; C_0603in
C17: 1n; C_0603in
C18, C19, C20, C21, C22, C23: 33p; C_0603in
CON1: TS1; Molex_PicoBlade_53398-0271_02x1.25mm_Straight
CON2: TS2; Molex_PicoBlade_53398-0271_02x1.25mm_Straight
CON3: Host_Interface; Molex_PicoBlade_53261-1071_10x1.25mm_Angled
IC1: TI-bq76pl536; TI_bq76PL536
JP1: JUMPER3_NO; SOLDERJUMPER_3
JP2, JP3: Jumper_NO_Small; SOLDERJUMPER_2_1mm
Q1, Q2: BSS205N
R1, R3: 1.47K; R_0603in
R2, R4: 1.82K; R_0603in
R5: 100K; R_0603in
R6, R7: 10K; R_0603in
R9, R10, R11, R12, R13, R14, R15, R16, R23, R24, R25, R26, R27, R28: 1K; R_0603in
R17, R18, R19, R20: 2M; R_0603in
R21, R22: 510K; R_0603in
X1: DaisyChain_North; IDC_02X05_Angled
X3: Balancer_Interface; Socket_Strip_Straight_2x08
X7: Prog_Voltage; Socket_Strip_Straight_1x02
X10: DaisyChain_South; IDC_02X05_Angled

Connections:
+5V: C14.1, C15.1, C16.1, CON1.2, CON2.2, IC1.32 (REG50), R21.1, R22.1
+BATT: C13.2, C18.1, C19.1, IC1.63 (BAT1), IC1.64 (BAT2), JP3.1, X3.13
/+5V_Host: CON3.1, R6.1, R7.1
/+5V_LDOA: C24.1, C25.1, IC1.17 (LDOA), R5.1
/ALERT_H: IC1.38 (ALERT_H), Q1.1 (G)
/ALERT_N: IC1.57 (ALERT_N), X1.3
/ALERT_S: IC1.23 (ALERT_S), R11.2
/ALERT_S1: R11.1, X10.3
/CB1: IC1.12 (CB1), X3.1
/CB2: IC1.10 (CB2), X3.3
/CB3: IC1.8 (CB3), X3.5
/CB4: IC1.6 (CB4), X3.7
/CB5: IC1.4 (CB5), X3.9
/CB6: IC1.2 (CB6), X3.11
/CONV_H: CON3.2, IC1.36 (CONV_H)
/CONV_N: IC1.59 (CONV_N), R9.1, R20.2
/CONV_N1: R9.2, X1.7
/CONV_S: C23.1, IC1.21 (CONV_S), X10.7
/CS_H: CON3.9, IC1.43 (CS_H)
/CS_N: IC1.52 (CS_N), R16.1, R17.2
/CS_N1: R16.2, X1.4
/CS_S: C20.1, IC1.29 (CS_S), X10.4
/DRDY_H: CON3.3, IC1.37 (DRDY_H)
/DRDY_N: C18.2, IC1.58 (DRDY_N), X1.5
/DRDY_S: IC1.22 (DRDY_S), R10.2, R21.2
/DRDY_S1: R10.1, X10.5
/FAULT_H: IC1.39 (FAULT_H), Q2.1 (G)
/FAULT_N: IC1.56 (FAULT_N), X1.1
/FAULT_S: IC1.24 (FAULT_S), R12.2
/FAULT_S1: R12.1, X10.1
/HSEL: IC1.44 (HSEL), JP1.2
/NALERT_H: CON3.4, Q1.3 (D), R6.2
/NFAULT_H: CON3.5, Q2.3 (D), R7.2
/SCLK_H: CON3.6, IC1.40 (SCLK_H)
/SCLK_N: IC1.55 (SCLK_N), R13.1, R19.2
/SCLK_N1: R13.2, X1.10
/SCLK_S: C22.1, IC1.26 (SCLK_S), X10.10
/SDI_H: CON3.8, IC1.42 (SDI_H)
/SDI_N: IC1.53 (SDI_N), R15.1, R18.2
/SDI_N1: R15.2, X1.6
/SDI_S: C21.1, IC1.28 (SDI_S), X10.6
/SDO_H: CON3.7, IC1.41 (SDO_H)
/SDO_N: C19.2, IC1.54 (SDO_N), X1.8
/SDO_S: IC1.27 (SDO_S), R14.2, R22.2
/SDO_S1: R14.1, X10.8
/VC1: C2.1, IC1.11 (VC1), R23.1
/VC1e: R23.2, X3.4
/VC2: C3.1, IC1.9 (VC2), R24.1
/VC2e: R24.2, X3.6
/VC3: C4.1, IC1.7 (VC3), R25.1
/VC3e: R25.2, X3.8
/VC4: C5.1, IC1.5 (VC4), R26.1
/VC4e: R26.2, X3.10
/VC5: C6.1, IC1.3 (VC5), R27.1
/VC5e: R27.2, X3.12
/VC6: C7.1, IC1.1 (VC6), R28.1
/VC6e: R28.2, X3.14
GND: C2.2, C3.2, C4.2, C5.2, C6.2, C7.2, C8.2, C9.2, C10.2, C11.2, C12.2, C13.1, C14.2, C17.2, C20.2, C21.2, C22.2, C23.2, C24.2, C25.2, CON3.10, IC1.13 (VC0), IC1.14 (VSS), IC1.15 (AGND), IC1.25 (VSSD), IC1.33 (VSS), IC1.34 (VSS), IC1.35 (VSS), IC1.47 (GPAI-), IC1.48 (GPAI+), IC1.49 (VSSD), IC1.50 (TEST), IC1.65 (PAD), JP1.1 (m), JP2.1, Q1.2 (S), Q2.2 (S), R17.1, R18.1, R19.1, R20.1, X1.2, X3.2, X3.15, X3.16, X7.1
unnamed: C8.1, C9.1, C10.1, C11.1, IC1.18 (LDOD1), IC1.46 (LDOD2), X7.2
unnamed: C12.1, IC1.16 (VREF)
unnamed: C15.2, IC1.20 (TS1+), R1.1, R2.1
unnamed: C16.2, IC1.61 (TS2+), R3.1, R4.1
unnamed: C17.1, X10.2
unnamed: CON1.1, R1.2
unnamed: CON2.1, R3.2
unnamed: IC1.19 (TS1-), R2.2
unnamed: IC1.60 (TS2-), R4.2
unnamed: JP1.3, R5.2
unnamed: JP2.2, X10.9
unnamed: JP3.2, X1.9

Notes on the sheet:
R21 and R22 only for highest device in daisy chain
R17 till R20 only for first device in daisy chain
Host interface on
Host interface off

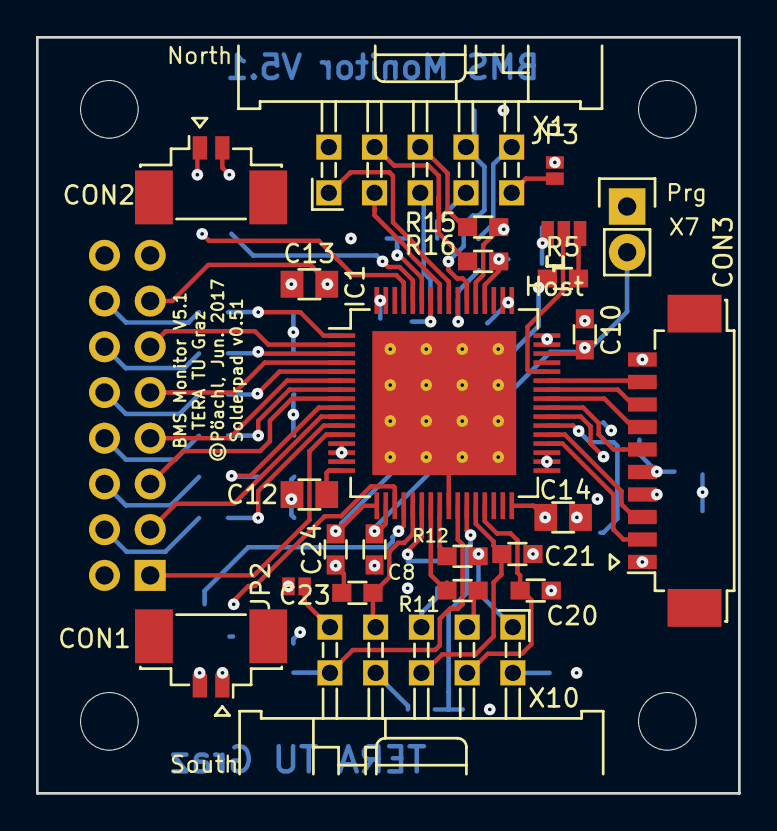
[picture p18: board HW/projects/ibex/BMS_Ibex/Messboard/bms_board_V5.1/bms_board.kicad_pcb from above]

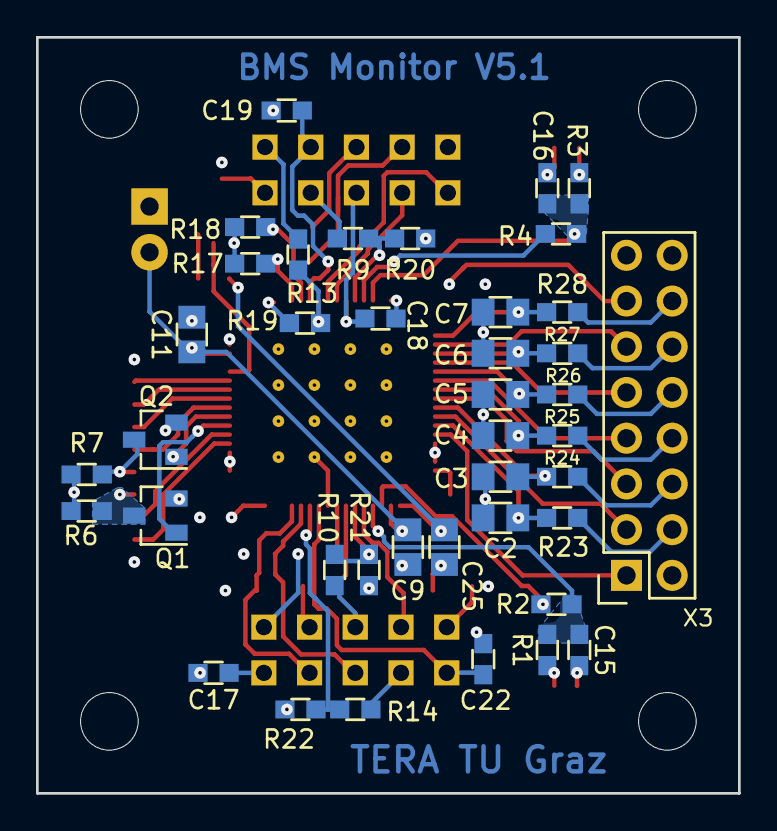
[picture p19: board HW/projects/ibex/BMS_Ibex/Messboard/bms_board_V5.1/bms_board.kicad_pcb from below]

Board: 4 copper layers, 39.0 x 42.0 mm, 64 parts (40 on the bottom side), 70 nets.
