TERA-TU-Graz/BatteryManagement_2017/HW/projects/ibex/BMS_Ibex/HostInterfaceFilter/HostInterfaceFilter.kicad_pcb

## KiCad design HW/projects/ibex/BMS_Ibex/HostInterfaceFilter/HostInterfaceFilter.kicad_pcb (2018-10-28)

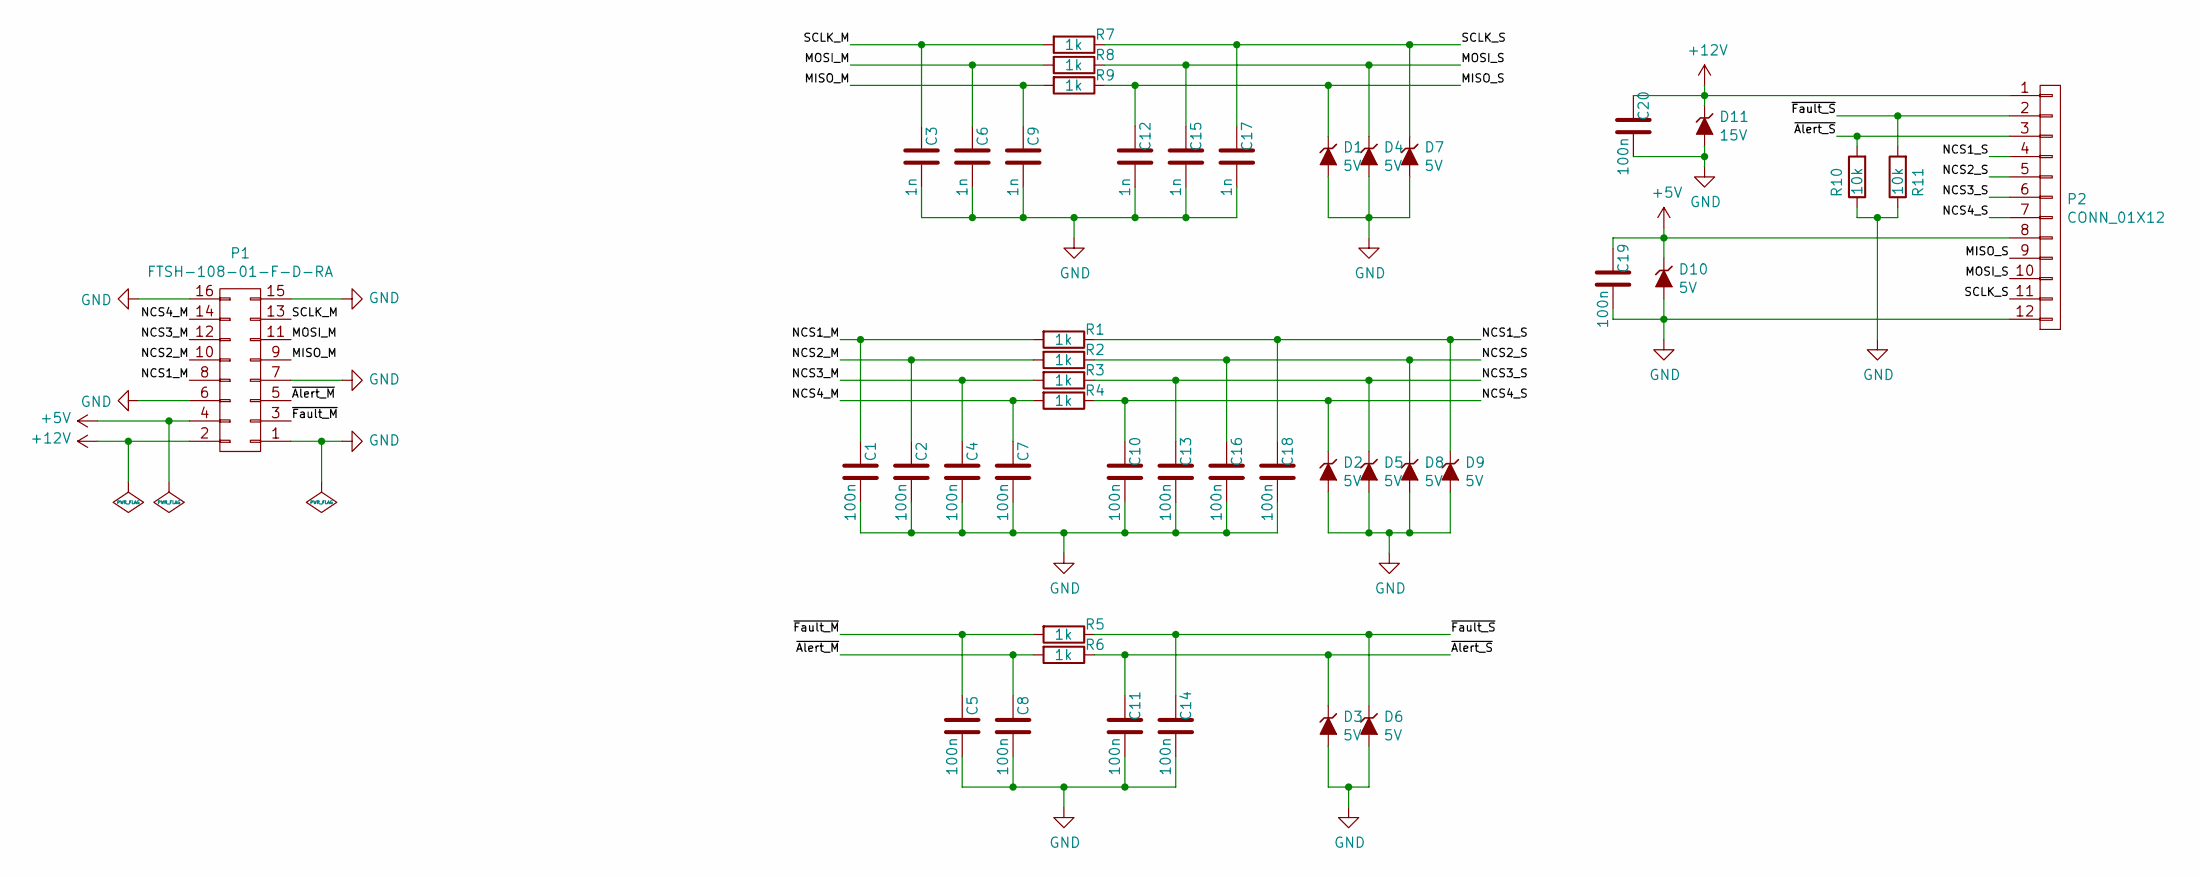
[picture p20: schematic HostInterfaceFilter.sch]

Parts:
C1, C2, C4, C5, C7, C8, C10, C11, C13, C14, C16, C18, C19, C20: 100n; C_0603in
C3, C6, C9, C12, C15, C17: 1n; C_0603in
D1, D2, D3, D4, D5, D6, D7, D8, D9, D10: 5V; SD05_tvs_5v
D11: 15V; CDSOD323-T15S_tvs_15v
P1: FTSH-108-01-F-D-RA; Molex_87760-1616
P2: CONN_01X12; Molex_PicoBlade_53261-1271_12x1.25mm_Angled
R1, R2, R3, R4, R5, R6, R7, R8, R9: 1k; R_0603in
R10, R11: 10k; R_0603in

Connections:
+5V: C19.2, D10.1 (K), P1.4, P2.8
+12V: C20.2, D11.1 (K), P1.2, P2.1
/MISO_M: C9.2, P1.9, R9.2
/MISO_S: C12.2, D1.1 (K), P2.9, R9.1
/MOSI_M: C6.2, P1.11, R8.2
/MOSI_S: C15.2, D4.1 (K), P2.10, R8.1
/NCS1_M: C1.2, P1.8, R1.2
/NCS1_S: C18.2, D9.1 (K), P2.4, R1.1
/NCS2_M: C2.2, P1.10, R2.2
/NCS2_S: C16.2, D8.1 (K), P2.5, R2.1
/NCS3_M: C4.2, P1.12, R3.2
/NCS3_S: C13.2, D5.1 (K), P2.6, R3.1
/NCS4_M: C7.2, P1.14, R4.2
/NCS4_S: C10.2, D2.1 (K), P2.7, R4.1
/SCLK_M: C3.2, P1.13, R7.2
/SCLK_S: C17.2, D7.1 (K), P2.11, R7.1
/~Alert_M: C8.2, P1.5, R6.2
/~Alert_S: C11.2, D3.1 (K), P2.3, R6.1, R10.2
/~Fault_M: C5.2, P1.3, R5.2
/~Fault_S: C14.2, D6.1 (K), P2.2, R5.1, R11.2
GND: C1.1, C2.1, C3.1, C4.1, C5.1, C6.1, C7.1, C8.1, C9.1, C10.1, C11.1, C12.1, C13.1, C14.1, C15.1, C16.1, C17.1, C18.1, C19.1, C20.1, D1.2 (A), D2.2 (A), D3.2 (A), D4.2 (A), D5.2 (A), D6.2 (A), D7.2 (A), D8.2 (A), D9.2 (A), D10.2 (A), D11.2 (A), P1.1, P1.6, P1.7, P1.15, P1.16, P2.12, R10.1, R11.1

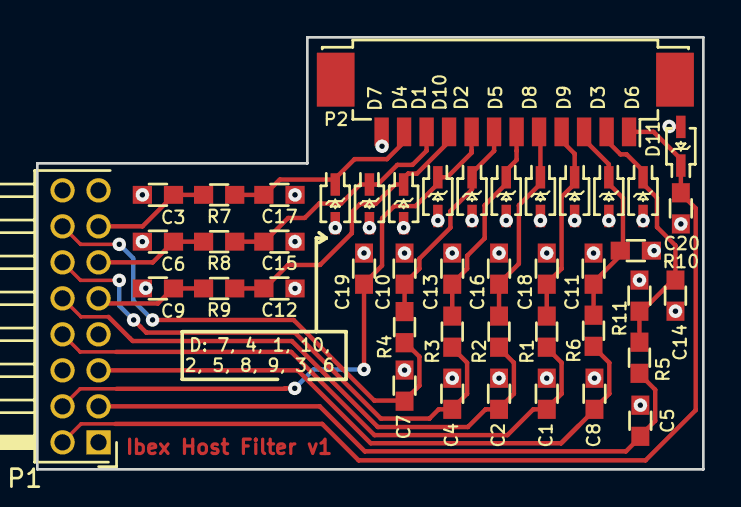
[picture p21: board HostInterfaceFilter.kicad_pcb from above]

Board: 2 copper layers, 37.0 x 24.0 mm, 44 parts (0 on the bottom side), 21 nets.
