TERA-TU-Graz/BatteryManagement_2017/HW/projects/ibex/BMS_Ibex/Bus_Isolator/Bus_Isolator_V3.2/Bus_Isolator_V3-2.kicad_pcb

## KiCad design HW/projects/ibex/BMS_Ibex/Bus_Isolator/Bus_Isolator_V3.2/Bus_Isolator_V3-2.kicad_pcb (2018-10-28, an earlier design)

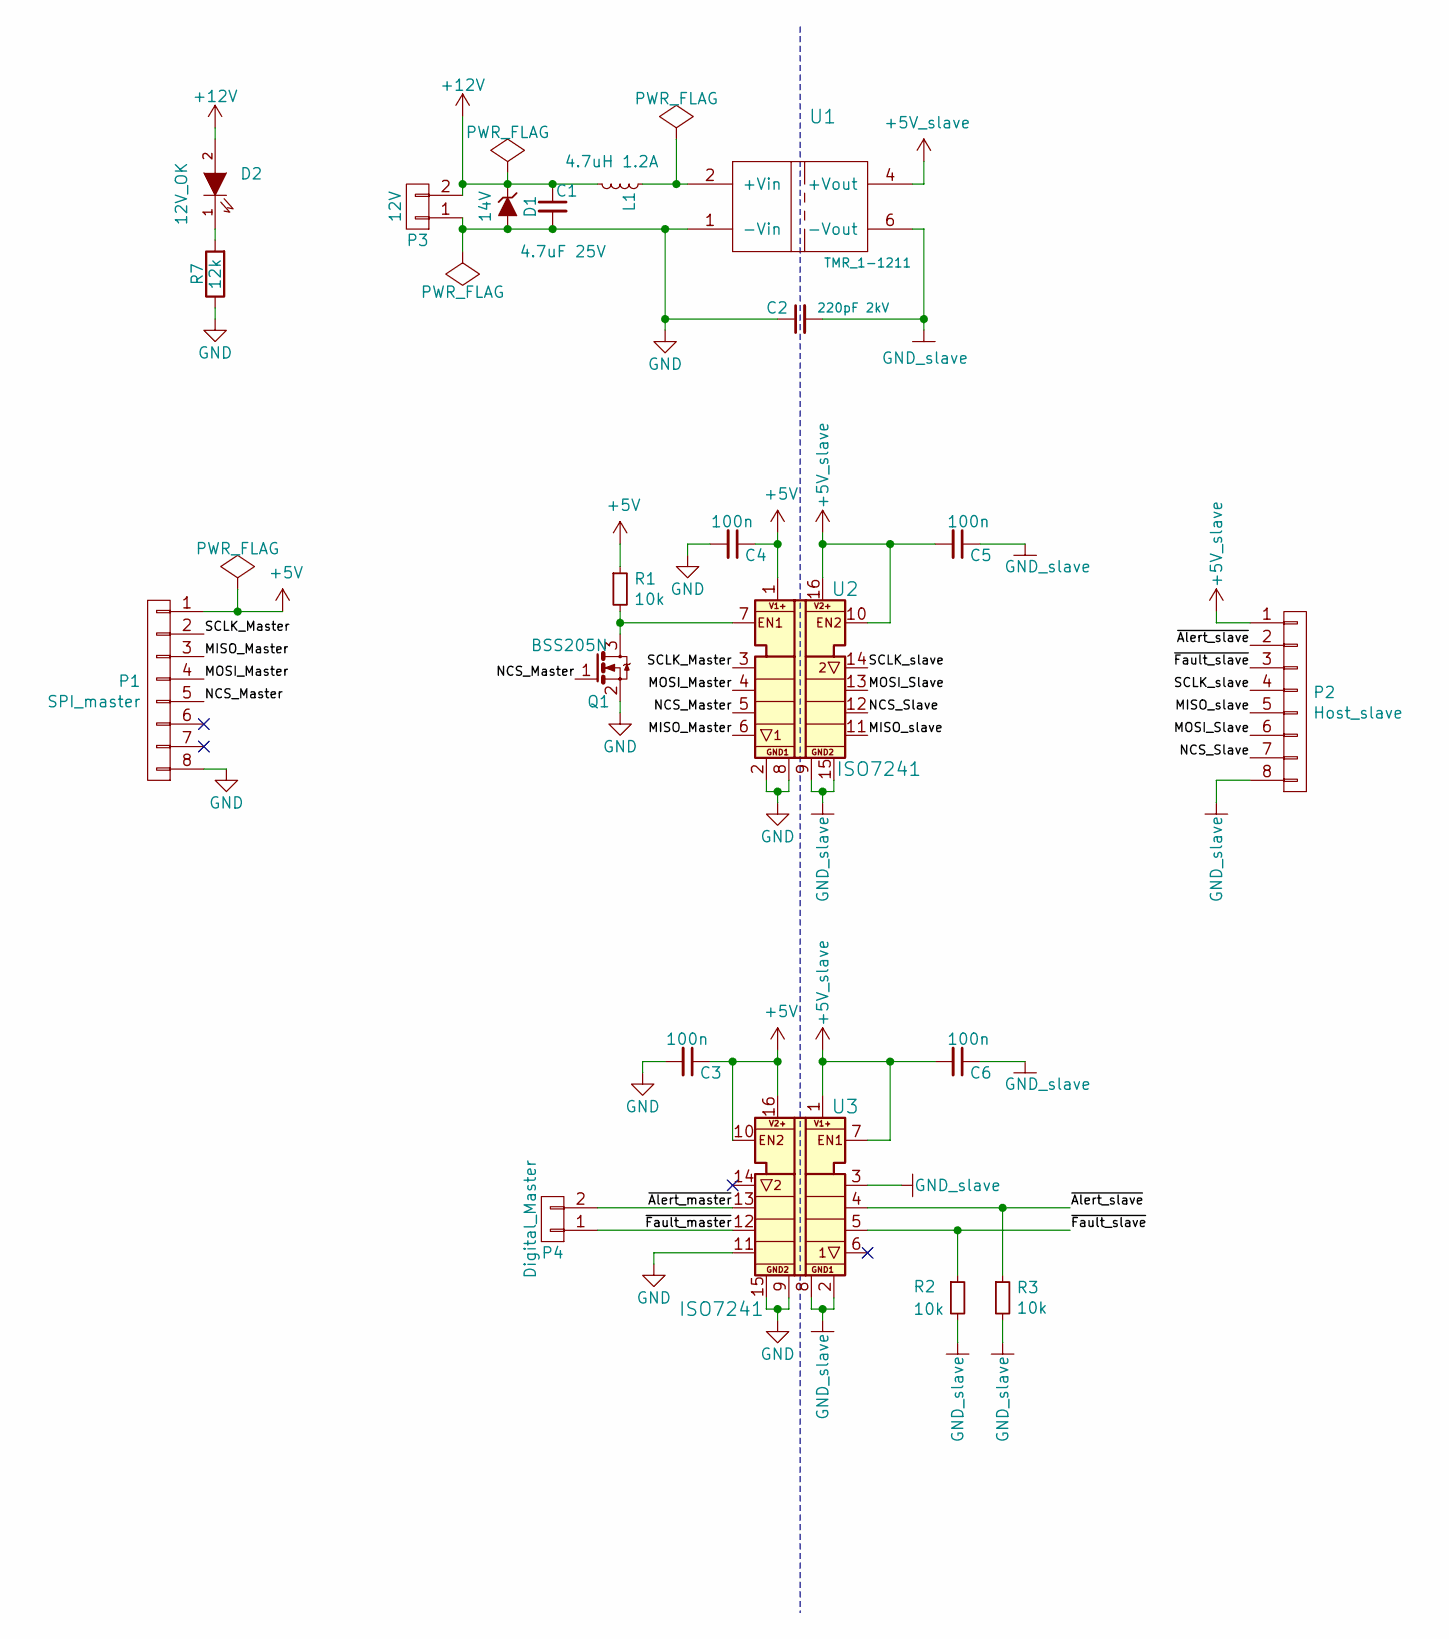
[picture p22: schematic Bus_Isolator_V3-2.sch, BMS Host Interface (SPI+DI/DO) Isolator]

Parts:
C1: 4.7uF 25V; C_0805in
C2: 220pF 2kV; C_1206in_HV
C3, C4, C5, C6: 100n; C_0805in
D1: 14V; SOD128
D2: 12V_OK; LED_0805
L1: 4.7uH 1.2A; L_muarta_LQH32PN
P1: SPI_master; Molex_PicoBlade_53398-0871_08x1.25mm_Straight
P2: Host_slave; Molex_PicoBlade_53398-0871_08x1.25mm_Straight
P3: 12V; JST_XH_B02B-XH-A_02x2.50mm_Straight
P4: Digital_Master; JST_EH_B02B-EH-A_02x2.50mm_Straight
Q1: BSS205N
R1, R2, R3: 10k; R_0805in
R7: 12k; R_0603in
U1: TMR_1-1211; TMR_1-XX1X
U2, U3: ISO7241

Connections:
+5V: C3.1, C4.1, P1.1, R1.1, U2.1 (V1+), U3.10 (EN2), U3.16 (V2+)
+5V_slave: C5.2, C6.2, P2.1, U1.4 (+Vout), U2.10 (EN2), U2.16 (V2+), U3.1 (V1+), U3.7 (EN1)
+12V: C1.1, D1.1 (K), D2.2 (A), L1.2, P3.2
/MISO_Master: P1.3, U2.6 (OUT1)
/MISO_slave: P2.5, U2.11 (IN1)
/MOSI_Master: P1.4, U2.4 (IN3)
/MOSI_Slave: P2.6, U2.13 (OUT3)
/NCS_Master: P1.5, Q1.1 (G), U2.5 (IN4)
/NCS_Slave: P2.7, U2.12 (OUT4)
/SCLK_Master: P1.2, U2.3 (IN2)
/SCLK_slave: P2.4, U2.14 (OUT2)
/~Alert_master: P4.2, U3.13 (OUT3)
/~Alert_slave: P2.2, R3.1, U3.4 (IN3)
/~Fault_master: P4.1, U3.12 (OUT4)
/~Fault_slave: P2.3, R2.1, U3.5 (IN4)
GND: C1.2, C2.1, C3.2, C4.2, D1.2 (A), P1.8, P3.1, Q1.2 (S), R7.1, U1.1 (-Vin), U2.2 (GND1), U2.8 (GND1), U3.9 (GND2), U3.11 (IN1), U3.15 (GND2)
GND_slave: C2.2, C5.1, C6.1, P2.8, R2.2, R3.2, U1.6 (-Vout), U2.9 (GND2), U2.15 (GND2), U3.2 (GND1), U3.3 (IN2), U3.8 (GND1)
unnamed: D2.1 (K), R7.2
unnamed: L1.1, U1.2 (+Vin)
unnamed: Q1.3 (D), R1.2, U2.7 (EN1)

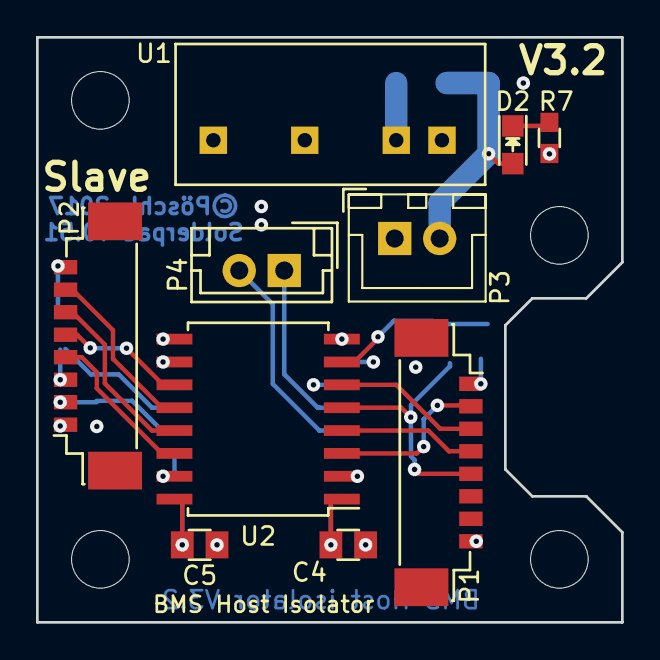
[picture p23: board Bus_Isolator_V3-2.kicad_pcb from above]

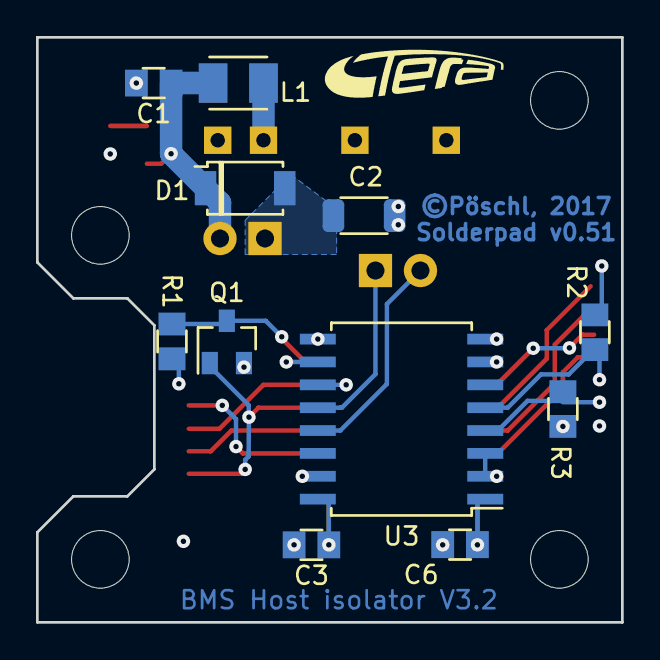
[picture p24: board Bus_Isolator_V3-2.kicad_pcb from below]

Board: 4 copper layers, 32.5 x 32.5 mm, 22 parts (12 on the bottom side), 20 nets.

Other parts of the board:
svg2mod: G***; TERA_TextOnly_SilkS_2.5x9.5mm
