TERA-TU-Graz/BatteryManagement_2017/HW/projects/ibex/BMS_Ibex/HostInterfaceSplitter/HostInterfaceSplitter-V2/HostInterfaceSplitter-V2.kicad_pcb

## KiCad design HW/projects/ibex/BMS_Ibex/HostInterfaceSplitter/HostInterfaceSplitter-V2/HostInterfaceSplitter-V2.kicad_pcb (2018-10-28, an earlier design)

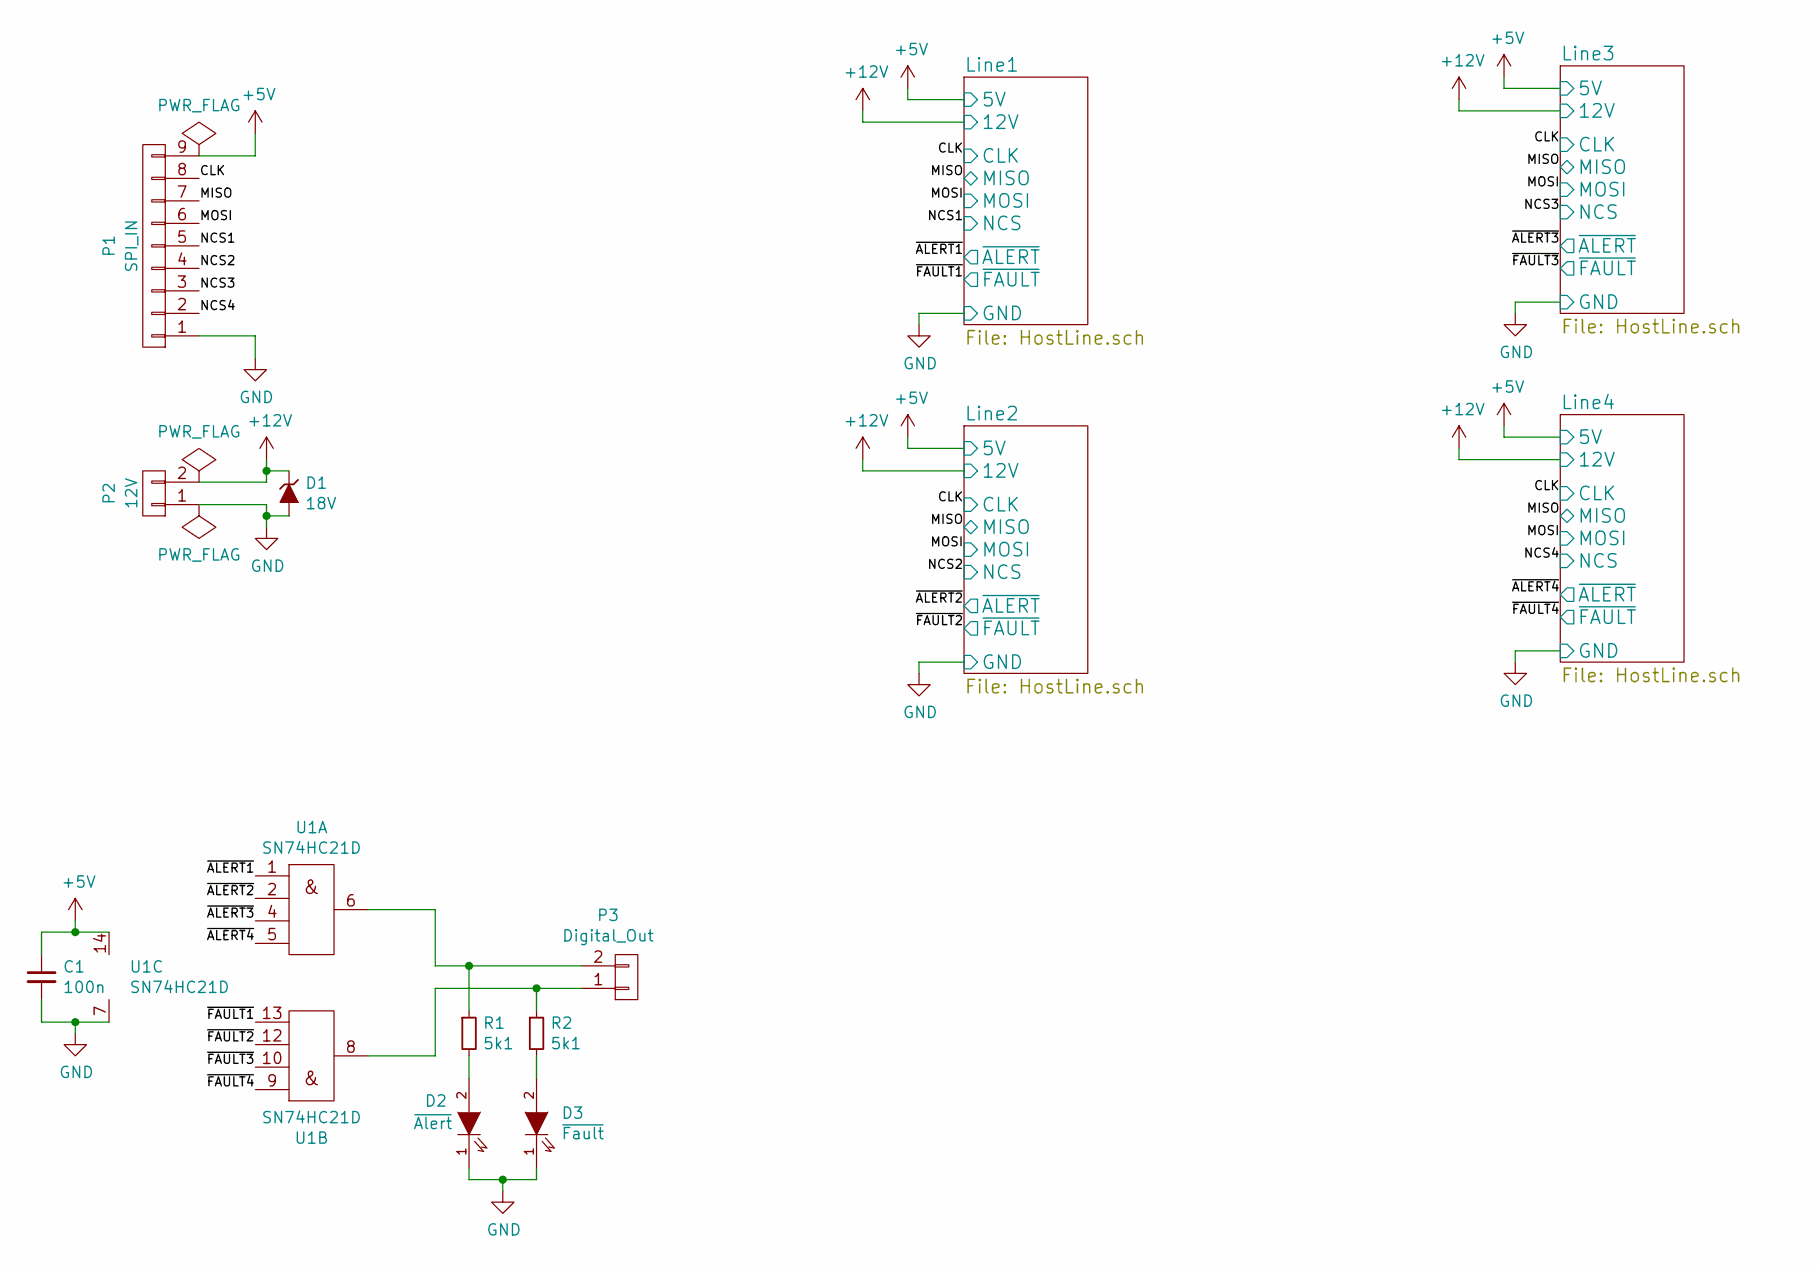
[picture p25: schematic HostInterfaceSplitter-V2.sch, BMS Host Interface Splitter]

Parts:
C1: 100n; C_0805in
D1: 18V; DO-214AA_with_vias_in_pad
D2: ~Alert; LED_0805
D3: ~Fault; LED_0805
P1: SPI_IN; JST_XH_B09B-XH-A_09x2.50mm_Straight
P2: 12V; JST_XH_B02B-XH-A_02x2.50mm_Straight
P3: Digital_Out; JST_EH_B02B-EH-A_02x2.50mm_Straight
R1, R2: 5k1; C_0805in
U1: SN74HC21D

Connections:
+5V: C1.1, P1.9, U1.14 (VCC); also elsewhere on the board
+12V: D1.1 (K), P2.2; also elsewhere on the board
/CLK: P1.8; also elsewhere on the board
/MISO: P1.7; also elsewhere on the board
/MOSI: P1.6; also elsewhere on the board
/NCS1: P1.5; also elsewhere on the board
/NCS2: P1.4; also elsewhere on the board
/NCS3: P1.3; also elsewhere on the board
/NCS4: P1.2; also elsewhere on the board
/~ALERT1: U1.1 (1A); also elsewhere on the board
/~ALERT2: U1.2 (1B); also elsewhere on the board
/~ALERT3: U1.4 (1C); also elsewhere on the board
/~ALERT4: U1.5 (1D); also elsewhere on the board
/~FAULT1: U1.13 (2D); also elsewhere on the board
/~FAULT2: U1.12 (2C); also elsewhere on the board
/~FAULT3: U1.10 (2B); also elsewhere on the board
/~FAULT4: U1.9 (2A); also elsewhere on the board
GND: C1.2, D1.2 (A), D2.1 (K), D3.1 (K), P1.1, P2.1, U1.7 (GND); also elsewhere on the board
unnamed: D2.2 (A), R1.2
unnamed: D3.2 (A), R2.2
unnamed: P3.1, R2.1, U1.8 (2Y)
unnamed: P3.2, R1.1, U1.6 (1Y)
