TERA-TU-Graz/BatteryManagement_2017/HW/projects/ibex/BMS_Ibex/HostInterfaceSplitter/HostInterfaceSplitter-V2/HostInterfaceSplitter-V2.kicad_pcb

## KiCad design HW/projects/ibex/BMS_Ibex/HostInterfaceSplitter/HostInterfaceSplitter-V2/HostInterfaceSplitter-V2.kicad_pcb (continued)

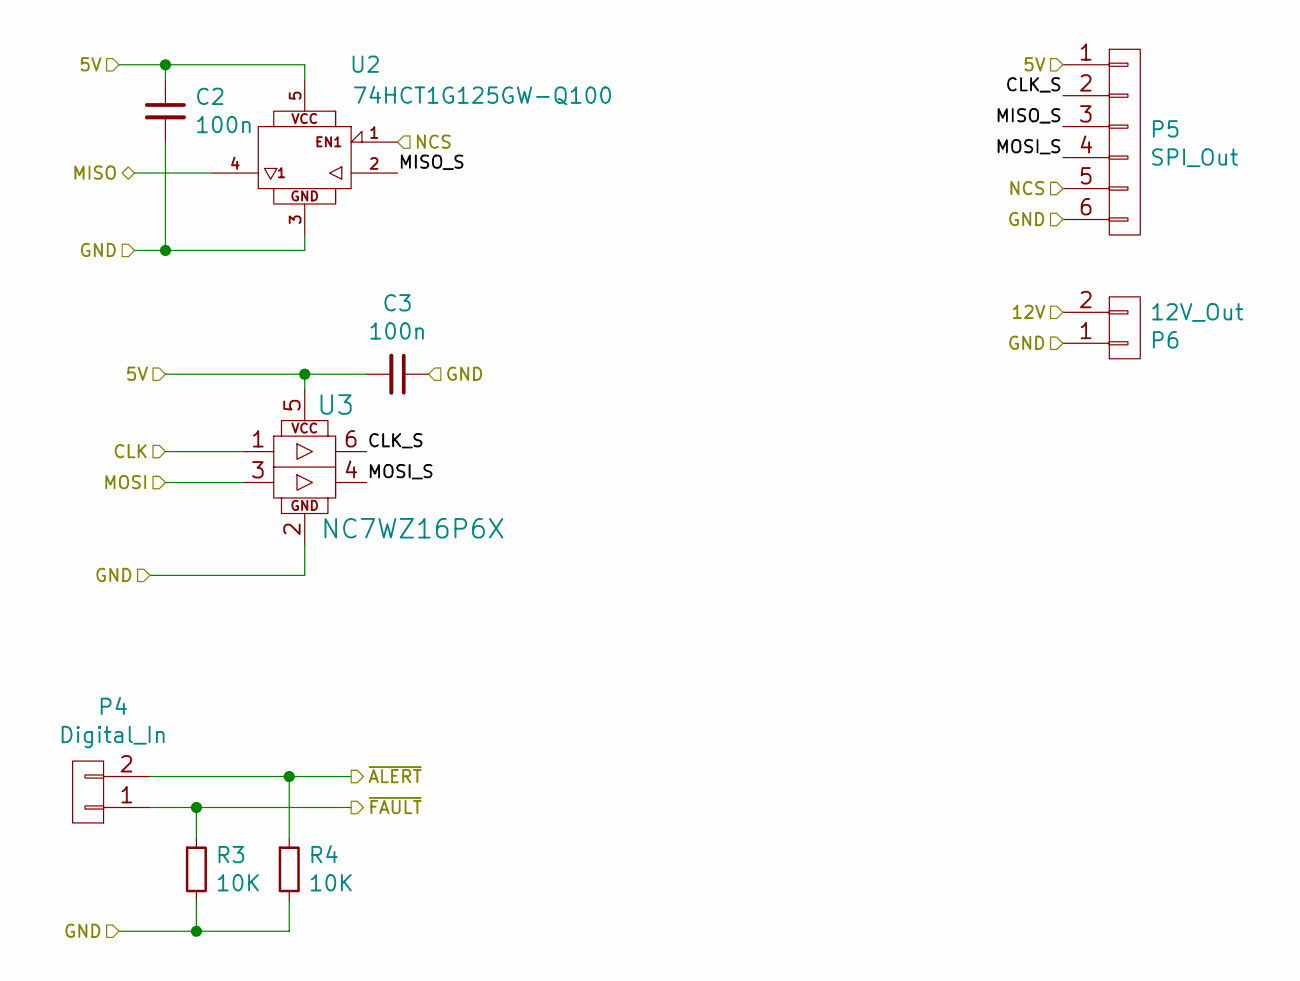
[picture p26: schematic HostLine.sch, BMS Host Interface Splitter]

Parts:
C2, C3: 100n; C_0603in
P4: Digital_In; JST_EH_B02B-EH-A_02x2.50mm_Straight
P5: SPI_Out; Molex_PicoBlade_53398-0671_06x1.25mm_Straight
P6: 12V_Out; JST_XH_B02B-XH-A_02x2.50mm_Straight
R3, R4: 10K; R_0805in
U2: 74HCT1G125GW-Q100; 74HCT1G125GW-Q100H
U3: NC7WZ16P6X

Connections:
+5V: C2.1, C3.2, P5.1, U2.5 (VCC), U3.5 (VCC); also elsewhere on the board
+12V: P6.2; also elsewhere on the board
/CLK: U3.1 (A1); also elsewhere on the board
/Line1/CLK_S: P5.2, U3.6 (Y1)
/Line1/MISO_S: P5.3, U2.2 (A)
/Line1/MOSI_S: P5.4, U3.4 (Y2)
/MISO: U2.4 (O); also elsewhere on the board
/MOSI: U3.3 (A2); also elsewhere on the board
/NCS1: P5.5, U2.1 (EN); also elsewhere on the board
/~ALERT1: P4.2, R4.1; also elsewhere on the board
/~FAULT1: P4.1, R3.1; also elsewhere on the board
GND: C2.2, C3.1, P5.6, P6.1, R3.2, R4.2, U2.3 (GND), U3.2 (GND); also elsewhere on the board

Parts of its further copies:
C4, C5, C6, C7, C8, C9: 100n; C_0603in
P7, P10, P13: Digital_In; JST_EH_B02B-EH-A_02x2.50mm_Straight
P8, P11, P14: SPI_Out; Molex_PicoBlade_53398-0671_06x1.25mm_Straight
P9, P12, P15: 12V_Out; JST_XH_B02B-XH-A_02x2.50mm_Straight
R5, R6, R7, R8, R9, R10: 10K; R_0805in
U4, U6, U8: 74HCT1G125GW-Q100; 74HCT1G125GW-Q100H
U5, U7, U9: NC7WZ16P6X

Connections of its further copies:
+5V: C4.1, C5.2, C6.1, C7.2, C8.1, C9.2, P8.1, P11.1, P14.1, U4.5 (VCC), U5.5 (VCC), U6.5 (VCC), U7.5 (VCC), U8.5 (VCC), U9.5 (VCC); also elsewhere on the board
+12V: P9.2, P12.2, P15.2; also elsewhere on the board
/CLK: U5.1 (A1), U7.1 (A1), U9.1 (A1); also elsewhere on the board
/Line2/CLK_S: P8.2, U5.6 (Y1)
/Line2/MISO_S: P8.3, U4.2 (A)
/Line2/MOSI_S: P8.4, U5.4 (Y2)
/Line3/CLK_S: P11.2, U7.6 (Y1)
/Line3/MISO_S: P11.3, U6.2 (A)
/Line3/MOSI_S: P11.4, U7.4 (Y2)
/Line4/CLK_S: P14.2, U9.6 (Y1)
/Line4/MISO_S: P14.3, U8.2 (A)
/Line4/MOSI_S: P14.4, U9.4 (Y2)
/MISO: U4.4 (O), U6.4 (O), U8.4 (O); also elsewhere on the board
/MOSI: U5.3 (A2), U7.3 (A2), U9.3 (A2); also elsewhere on the board
/NCS2: P8.5, U4.1 (EN); also elsewhere on the board
/NCS3: P11.5, U6.1 (EN); also elsewhere on the board
/NCS4: P14.5, U8.1 (EN); also elsewhere on the board
/~ALERT2: P7.2, R6.1; also elsewhere on the board
/~ALERT3: P10.2, R8.1; also elsewhere on the board
/~ALERT4: P13.2, R10.1; also elsewhere on the board
/~FAULT2: P7.1, R5.1; also elsewhere on the board
/~FAULT3: P10.1, R7.1; also elsewhere on the board
/~FAULT4: P13.1, R9.1; also elsewhere on the board
GND: C4.2, C5.1, C6.2, C7.1, C8.2, C9.1, P8.6, P9.1, P11.6, P12.1, P14.6, P15.1, R5.2, R6.2, R7.2, R8.2, R9.2, R10.2, U4.3 (GND), U5.2 (GND), U6.3 (GND), U7.2 (GND), U8.3 (GND), U9.2 (GND); also elsewhere on the board

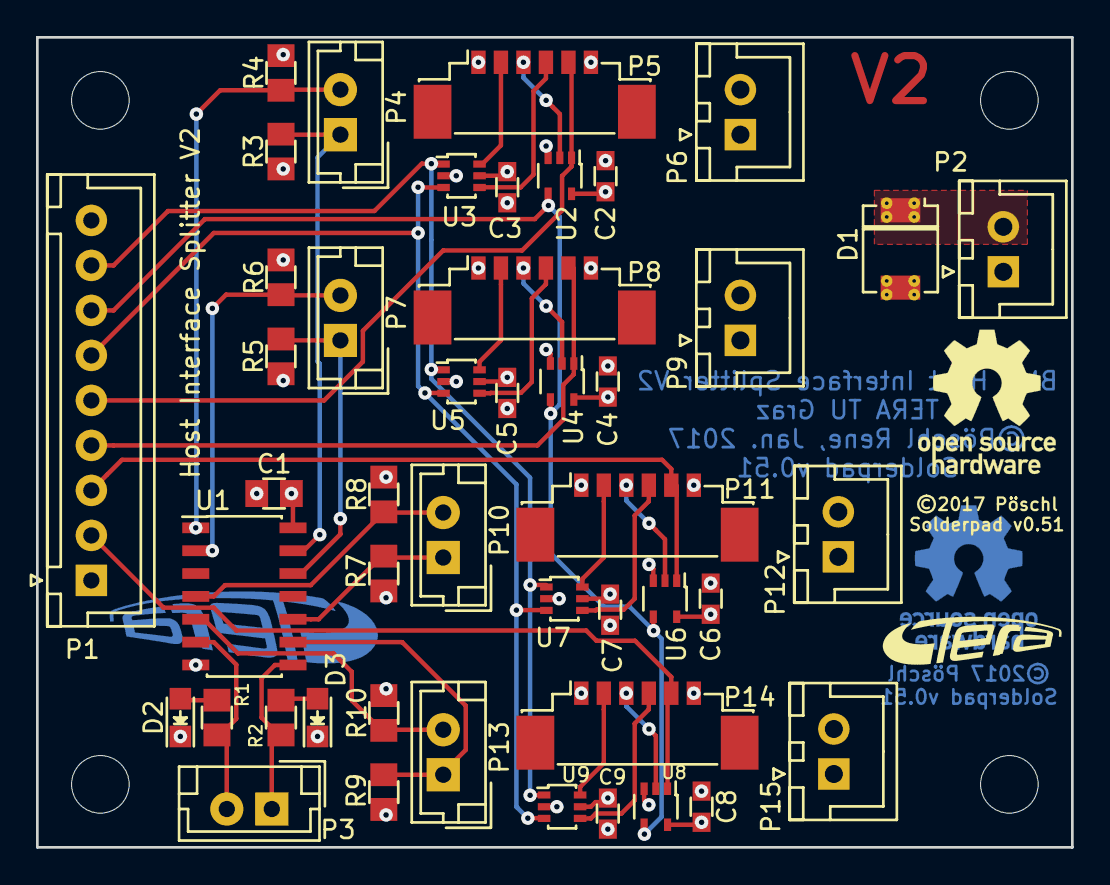
[picture p27: board HW/projects/ibex/BMS_Ibex/HostInterfaceSplitter/HostInterfaceSplitter… from above]

Board: 4 copper layers, 57.5 x 45.0 mm, 48 parts (1 on the bottom side), 34 nets.

Other parts of the board:
svg2mod: G***; TERA_TextOnly_SilkS_2.5x9.5mm
svg2mod#2: G***; TERA_TextOnly_Cu_3.75x14mm
