TERA-TU-Graz/BatteryManagement_2017/HW/projects/ibex/BMS_Ibex/HostInterfaceSplitter/HostInterfaceSplitter-V2.1/HostInterfaceSplitter-V2.kicad_pcb

## KiCad design HW/projects/ibex/BMS_Ibex/HostInterfaceSplitter/HostInterfaceSplitter-V2.1/HostInterfaceSplitter-V2.kicad_pcb (2018-10-28)

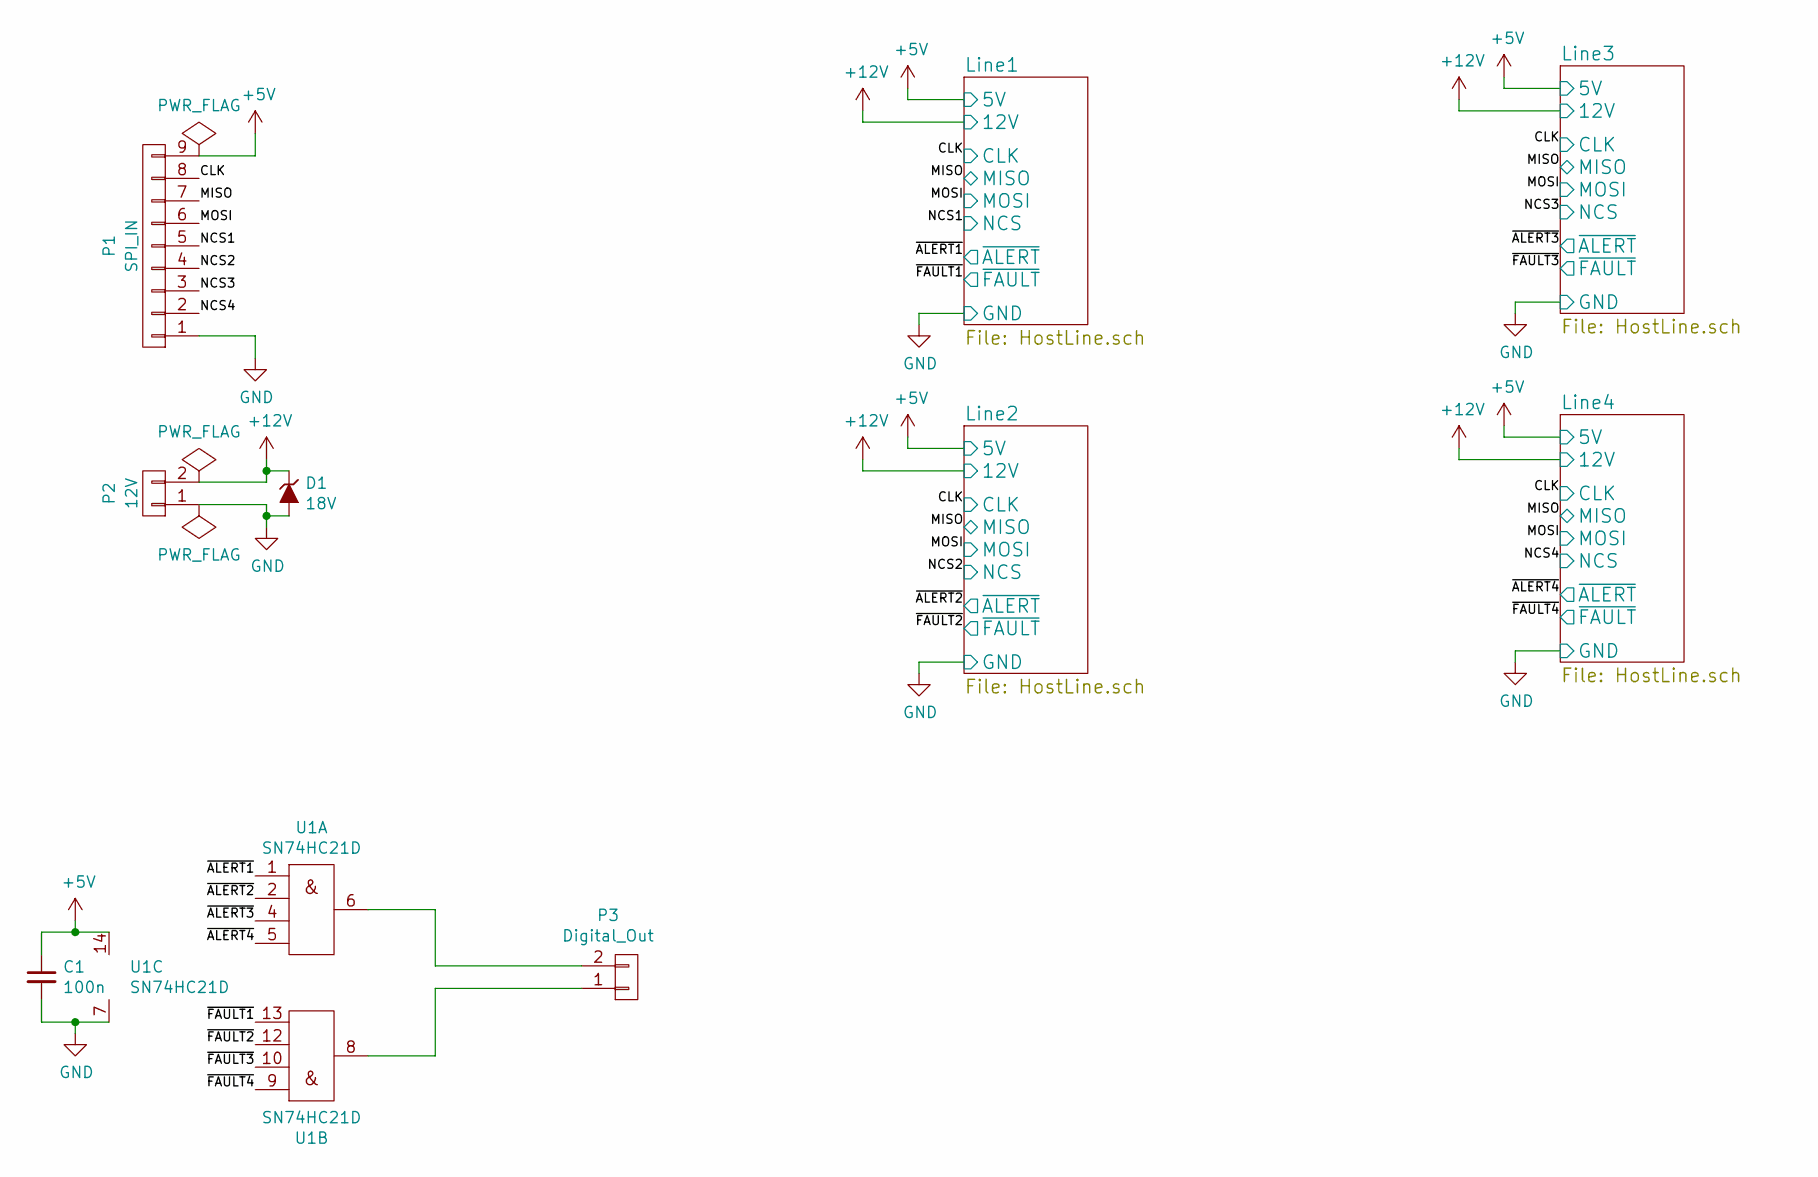
[picture p28: schematic HostInterfaceSplitter-V2.sch, BMS Host Interface Splitter]

Parts:
C1: 100n; C_0603in
D1: 18V; DO-214AA_with_vias_in_pad
P1: SPI_IN; JST_XH_B09B-XH-A_09x2.50mm_Straight
P2: 12V; JST_XH_B02B-XH-A_02x2.50mm_Straight
P3: Digital_Out; JST_EH_B02B-EH-A_02x2.50mm_Straight
U1: SN74HC21D

Connections:
+5V: C1.1, P1.9, U1.14 (VCC); also elsewhere on the board
+12V: D1.1 (K), P2.2; also elsewhere on the board
/CLK: P1.8; also elsewhere on the board
/MISO: P1.7; also elsewhere on the board
/MOSI: P1.6; also elsewhere on the board
/NCS1: P1.5; also elsewhere on the board
/NCS2: P1.4; also elsewhere on the board
/NCS3: P1.3; also elsewhere on the board
/NCS4: P1.2; also elsewhere on the board
/~ALERT1: U1.1 (1A); also elsewhere on the board
/~ALERT2: U1.2 (1B); also elsewhere on the board
/~ALERT3: U1.4 (1C); also elsewhere on the board
/~ALERT4: U1.5 (1D); also elsewhere on the board
/~FAULT1: U1.13 (2D); also elsewhere on the board
/~FAULT2: U1.12 (2C); also elsewhere on the board
/~FAULT3: U1.10 (2B); also elsewhere on the board
/~FAULT4: U1.9 (2A); also elsewhere on the board
GND: C1.2, D1.2 (A), P1.1, P2.1, U1.7 (GND); also elsewhere on the board
unnamed: P3.1, U1.8 (2Y)
unnamed: P3.2, U1.6 (1Y)

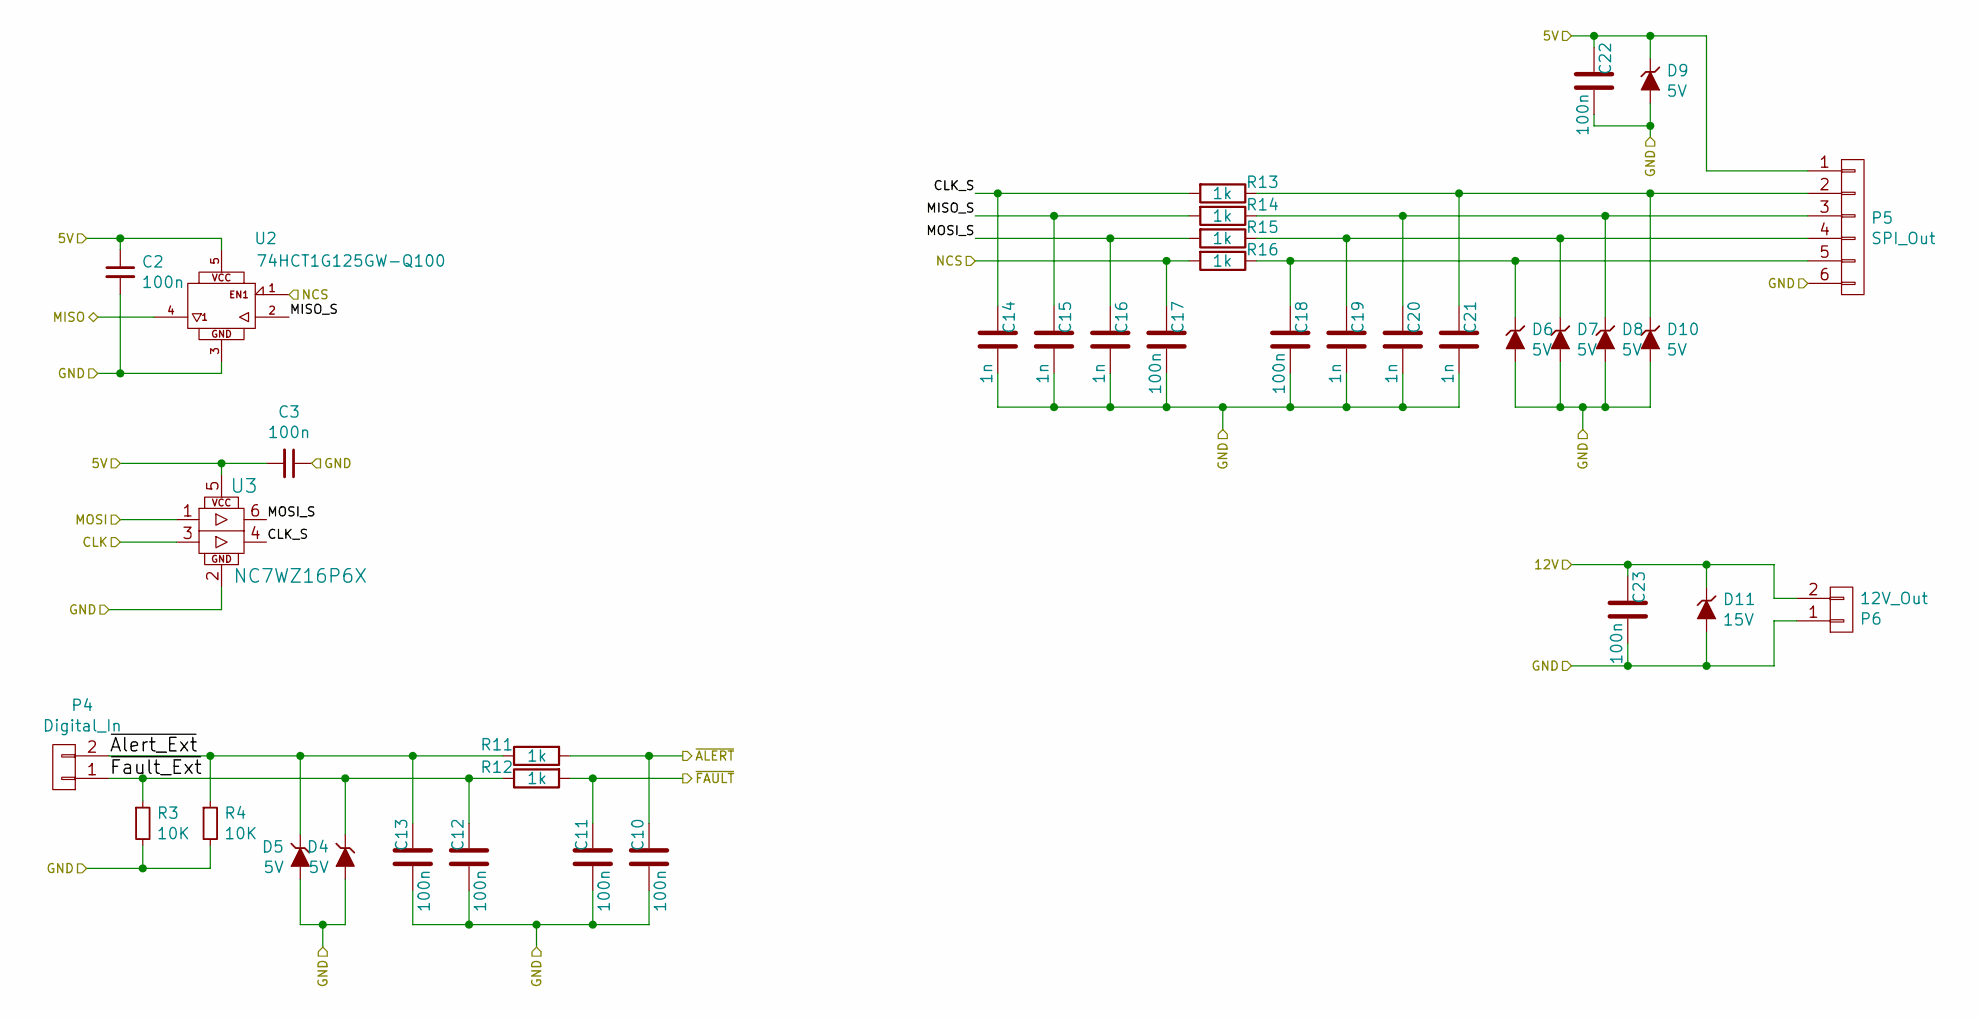
[picture p29: schematic HostLine.sch, BMS Host Interface Splitter]

Parts:
C2, C3, C10, C11, C12, C13, C17, C18, C22, C23: 100n; C_0603in
C14, C15, C16, C19, C20, C21: 1n; C_0603in
D4, D5, D6, D7, D8, D9, D10: 5V; SD05_tvs_5v
D11: 15V; CDSOD323-T15S_tvs_15v
P4: Digital_In; JST_EH_B02B-EH-A_02x2.50mm_Straight
P5: SPI_Out; Molex_PicoBlade_53398-0671_06x1.25mm_Straight
P6: 12V_Out; JST_XH_B02B-XH-A_02x2.50mm_Straight
R3, R4: 10K; R_0603in
R11, R12, R13, R14, R15, R16: 1k; R_0603in
U2: 74HCT1G125GW-Q100; 74HCT1G125GW-Q100H
U3: NC7WZ16P6X

Connections:
+5V: C2.1, C3.2, C22.2, D9.1 (K), P5.1, U2.5 (VCC), U3.5 (VCC); also elsewhere on the board
+12V: C23.2, D11.1 (K), P6.2; also elsewhere on the board
/CLK: U3.3 (A2); also elsewhere on the board
/Line1/CLK_S: C14.2, R13.2, U3.4 (Y2)
/Line1/MISO_S: C15.2, R14.2, U2.2 (A)
/Line1/MOSI_S: C16.2, R15.2, U3.6 (Y1)
/Line1/~Alert_Ext: C13.2, D5.1 (K), P4.2, R4.1, R11.1
/Line1/~Fault_Ext: C12.2, D4.1 (K), P4.1, R3.1, R12.1
/MISO: U2.4 (O); also elsewhere on the board
/MOSI: U3.1 (A1); also elsewhere on the board
/NCS1: C17.2, R16.2, U2.1 (EN); also elsewhere on the board
/~ALERT1: C10.2, R11.2; also elsewhere on the board
/~FAULT1: C11.2, R12.2; also elsewhere on the board
GND: C2.2, C3.1, C10.1, C11.1, C12.1, C13.1, C14.1, C15.1, C16.1, C17.1, C18.1, C19.1, C20.1, C21.1, C22.1, C23.1, D4.2 (A), D5.2 (A), D6.2 (A), D7.2 (A), D8.2 (A), D9.2 (A), D10.2 (A), D11.2 (A), P5.6, P6.1, R3.2, R4.2, U2.3 (GND), U3.2 (GND); also elsewhere on the board
unnamed: C18.2, D6.1 (K), P5.5, R16.1
unnamed: C19.2, D7.1 (K), P5.4, R15.1
unnamed: C20.2, D8.1 (K), P5.3, R14.1
unnamed: C21.2, D10.1 (K), P5.2, R13.1

Parts of its further copies:
C4, C5, C6, C7, C8, C9, C24, C25, C26, C27, C31, C32, C36, C37, C38, C39, C40, C41, C45, C46, C50, C51, C52, C53, C54, C55, C59, C60, C64, C65: 100n; C_0603in
C28, C29, C30, C33, C34, C35, C42, C43, C44, C47, C48, C49, C56, C57, C58, C61, C62, C63: 1n; C_0603in
D12, D13, D14, D15, D16, D17, D18, D20, D21, D22, D23, D24, D25, D26, D28, D29, D30, D31, D32, D33, D34: 5V; SD05_tvs_5v
D19, D27, D35: 15V; CDSOD323-T15S_tvs_15v
P7, P10, P13: Digital_In; JST_EH_B02B-EH-A_02x2.50mm_Straight
P8, P11, P14: SPI_Out; Molex_PicoBlade_53398-0671_06x1.25mm_Straight
P9, P12, P15: 12V_Out; JST_XH_B02B-XH-A_02x2.50mm_Straight
R5, R6, R7, R8, R9, R10: 10K; R_0603in
R17, R18, R19, R20, R21, R22, R23, R24, R25, R26, R27, R28, R29, R30, R31, R32, R33, R34: 1k; R_0603in
U4, U6, U8: 74HCT1G125GW-Q100; 74HCT1G125GW-Q100H
U5, U7, U9: NC7WZ16P6X

Connections of its further copies:
+5V: C4.1, C5.2, C6.1, C7.2, C8.1, C9.2, C36.2, C50.2, C64.2, D17.1 (K), D25.1 (K), D33.1 (K), P8.1, P11.1, P14.1, U4.5 (VCC), U5.5 (VCC), U6.5 (VCC), U7.5 (VCC), U8.5 (VCC), U9.5 (VCC); also elsewhere on the board
+12V: C37.2, C51.2, C65.2, D19.1 (K), D27.1 (K), D35.1 (K), P9.2, P12.2, P15.2; also elsewhere on the board
/CLK: U5.3 (A2), U7.3 (A2), U9.3 (A2); also elsewhere on the board
/Line2/CLK_S: C28.2, R19.2, U5.4 (Y2)
/Line2/MISO_S: C29.2, R20.2, U4.2 (A)
/Line2/MOSI_S: C30.2, R21.2, U5.6 (Y1)
/Line2/~Alert_Ext: C27.2, D13.1 (K), P7.2, R6.1, R17.1
/Line2/~Fault_Ext: C26.2, D12.1 (K), P7.1, R5.1, R18.1
/Line3/CLK_S: C42.2, R25.2, U7.4 (Y2)
/Line3/MISO_S: C43.2, R26.2, U6.2 (A)
/Line3/MOSI_S: C44.2, R27.2, U7.6 (Y1)
/Line3/~Alert_Ext: C41.2, D21.1 (K), P10.2, R8.1, R23.1
/Line3/~Fault_Ext: C40.2, D20.1 (K), P10.1, R7.1, R24.1
/Line4/CLK_S: C56.2, R31.2, U9.4 (Y2)
/Line4/MISO_S: C57.2, R32.2, U8.2 (A)
/Line4/MOSI_S: C58.2, R33.2, U9.6 (Y1)
/Line4/~Alert_Ext: C55.2, D29.1 (K), P13.2, R10.1, R29.1
/Line4/~Fault_Ext: C54.2, D28.1 (K), P13.1, R9.1, R30.1
/MISO: U4.4 (O), U6.4 (O), U8.4 (O); also elsewhere on the board
/MOSI: U5.1 (A1), U7.1 (A1), U9.1 (A1); also elsewhere on the board
/NCS2: C31.2, R22.2, U4.1 (EN); also elsewhere on the board
/NCS3: C45.2, R28.2, U6.1 (EN); also elsewhere on the board
/NCS4: C59.2, R34.2, U8.1 (EN); also elsewhere on the board
/~ALERT2: C24.2, R17.2; also elsewhere on the board
/~ALERT3: C38.2, R23.2; also elsewhere on the board
/~ALERT4: C52.2, R29.2; also elsewhere on the board
/~FAULT2: C25.2, R18.2; also elsewhere on the board
/~FAULT3: C39.2, R24.2; also elsewhere on the board
/~FAULT4: C53.2, R30.2; also elsewhere on the board
GND: C4.2, C5.1, C6.2, C7.1, C8.2, C9.1, C24.1, C25.1, C26.1, C27.1, C28.1, C29.1, C30.1, C31.1, C32.1, C33.1, C34.1, C35.1, C36.1, C37.1, C38.1, C39.1, C40.1, C41.1, C42.1, C43.1, C44.1, C45.1, C46.1, C47.1, C48.1, C49.1, C50.1, C51.1, C52.1, C53.1, C54.1, C55.1, C56.1, C57.1, C58.1, C59.1, C60.1, C61.1, C62.1, C63.1, C64.1, C65.1, D12.2 (A), D13.2 (A), D14.2 (A), D15.2 (A), D16.2 (A), D17.2 (A), D18.2 (A), D19.2 (A), D20.2 (A), D21.2 (A), D22.2 (A), D23.2 (A), D24.2 (A), D25.2 (A), D26.2 (A), D27.2 (A), D28.2 (A), D29.2 (A), D30.2 (A), D31.2 (A), D32.2 (A), D33.2 (A), D34.2 (A), D35.2 (A), P8.6, P9.1, P11.6, P12.1, P14.6, P15.1, R5.2, R6.2, R7.2, R8.2, R9.2, R10.2, U4.3 (GND), U5.2 (GND), U6.3 (GND), U7.2 (GND), U8.3 (GND), U9.2 (GND); also elsewhere on the board
unnamed: C32.2, D14.1 (K), P8.5, R22.1
unnamed: C33.2, D15.1 (K), P8.4, R21.1
unnamed: C34.2, D16.1 (K), P8.3, R20.1
unnamed: C35.2, D18.1 (K), P8.2, R19.1
unnamed: C46.2, D22.1 (K), P11.5, R28.1
unnamed: C47.2, D23.1 (K), P11.4, R27.1
unnamed: C48.2, D24.1 (K), P11.3, R26.1
unnamed: C49.2, D26.1 (K), P11.2, R25.1
unnamed: C60.2, D30.1 (K), P14.5, R34.1
unnamed: C61.2, D31.1 (K), P14.4, R33.1
unnamed: C62.2, D32.1 (K), P14.3, R32.1
unnamed: C63.2, D34.1 (K), P14.2, R31.1

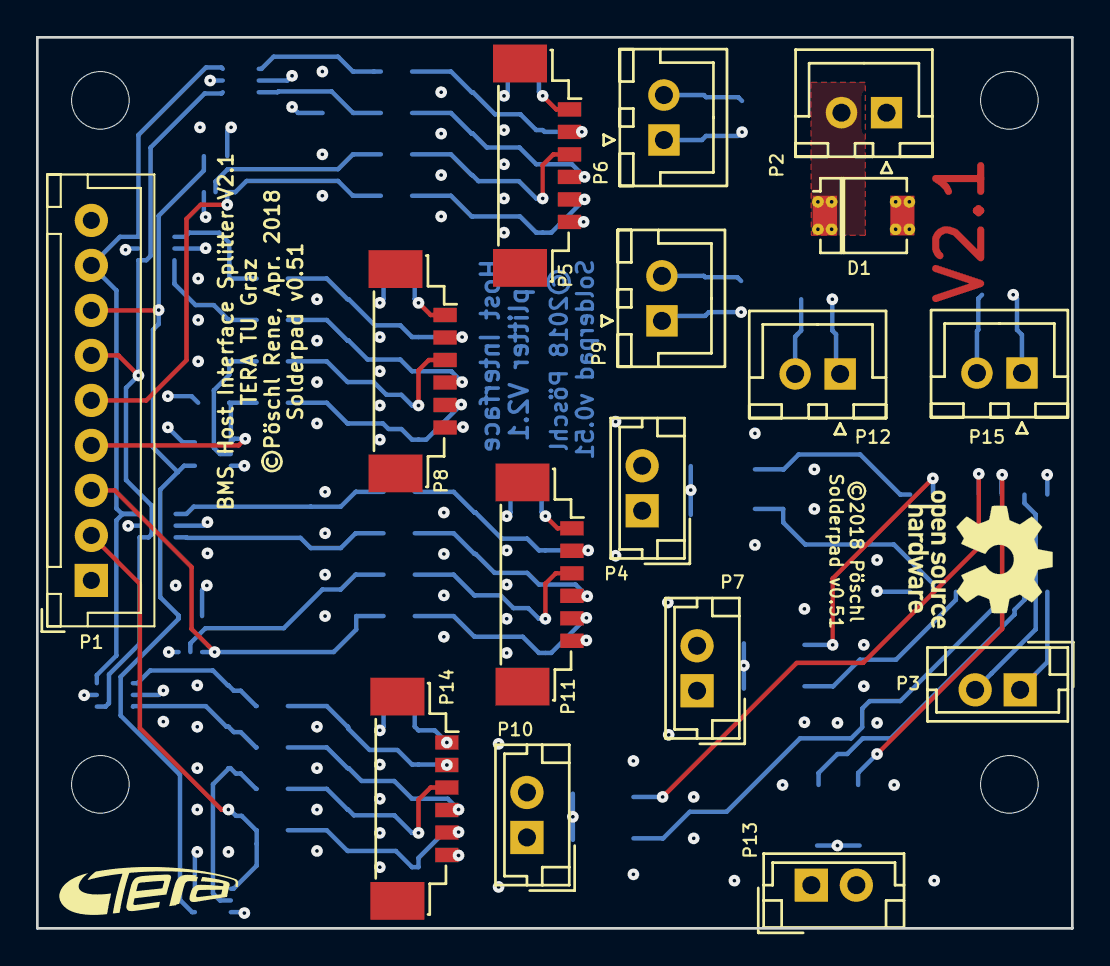
[picture p30: board HW/projects/ibex/BMS_Ibex/HostInterfaceSplitter/HostInterfaceSplitter… from above]

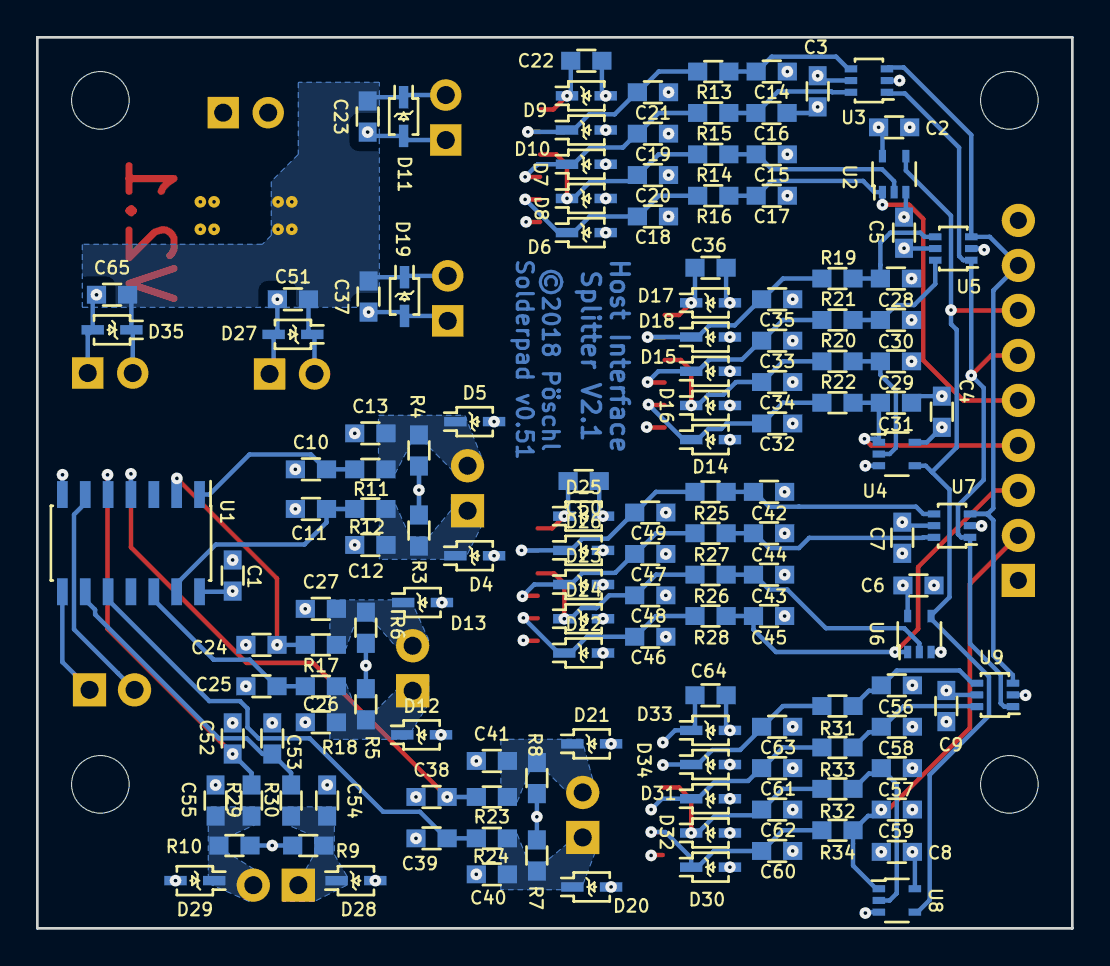
[picture p31: board HW/projects/ibex/BMS_Ibex/HostInterfaceSplitter/HostInterfaceSplitter… from below]

Board: 4 copper layers, 57.5 x 49.5 mm, 155 parts (138 on the bottom side), 56 nets.

Other parts of the board:
svg2mod: G***; TERA_TextOnly_SilkS_2.5x9.5mm
