TERA-TU-Graz/BatteryManagement_2017/HW/projects/ibex/BMS_Ibex/Balancer/bms_balance_v4/bms_balance_v4.kicad_pcb

## KiCad design HW/projects/ibex/BMS_Ibex/Balancer/bms_balance_v4/bms_balance_v4.kicad_pcb (2018-10-28, an earlier design)

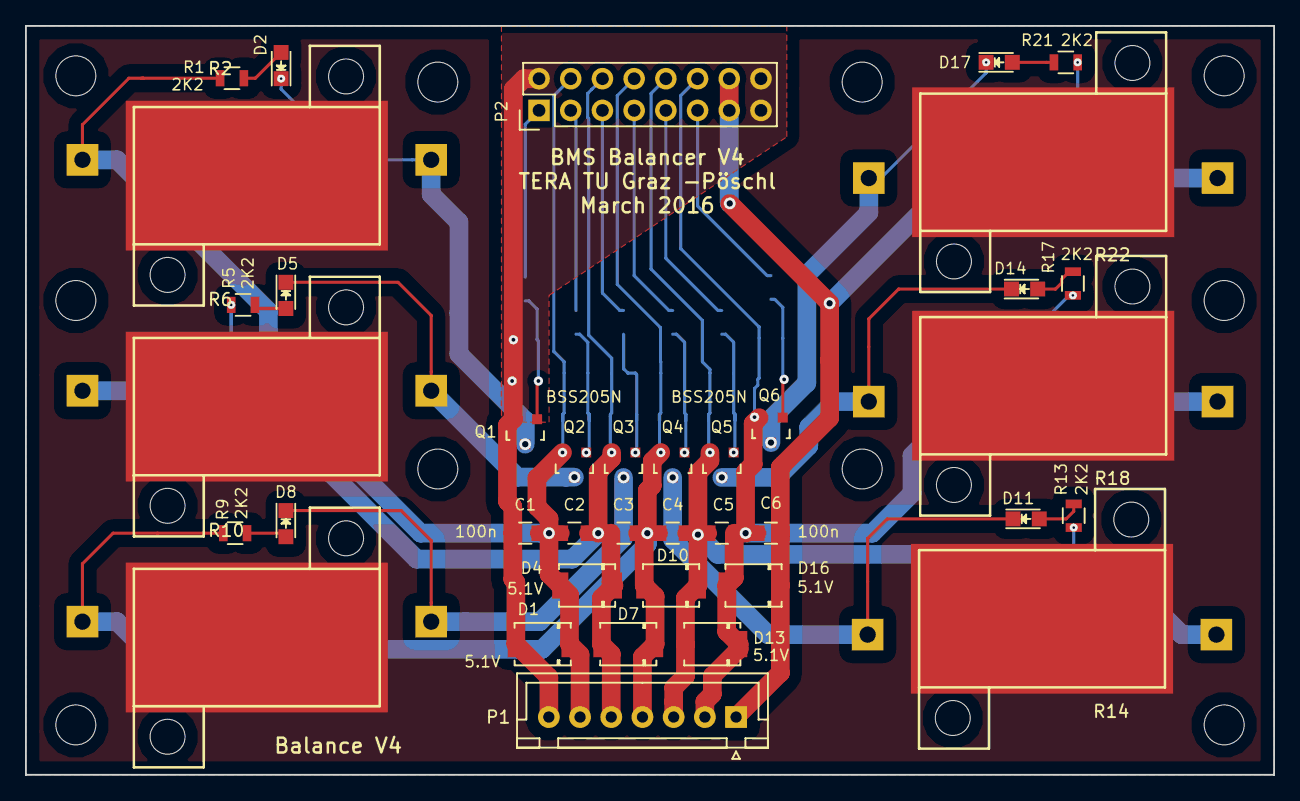
[picture p32: board bms_balance_v4.kicad_pcb from above]

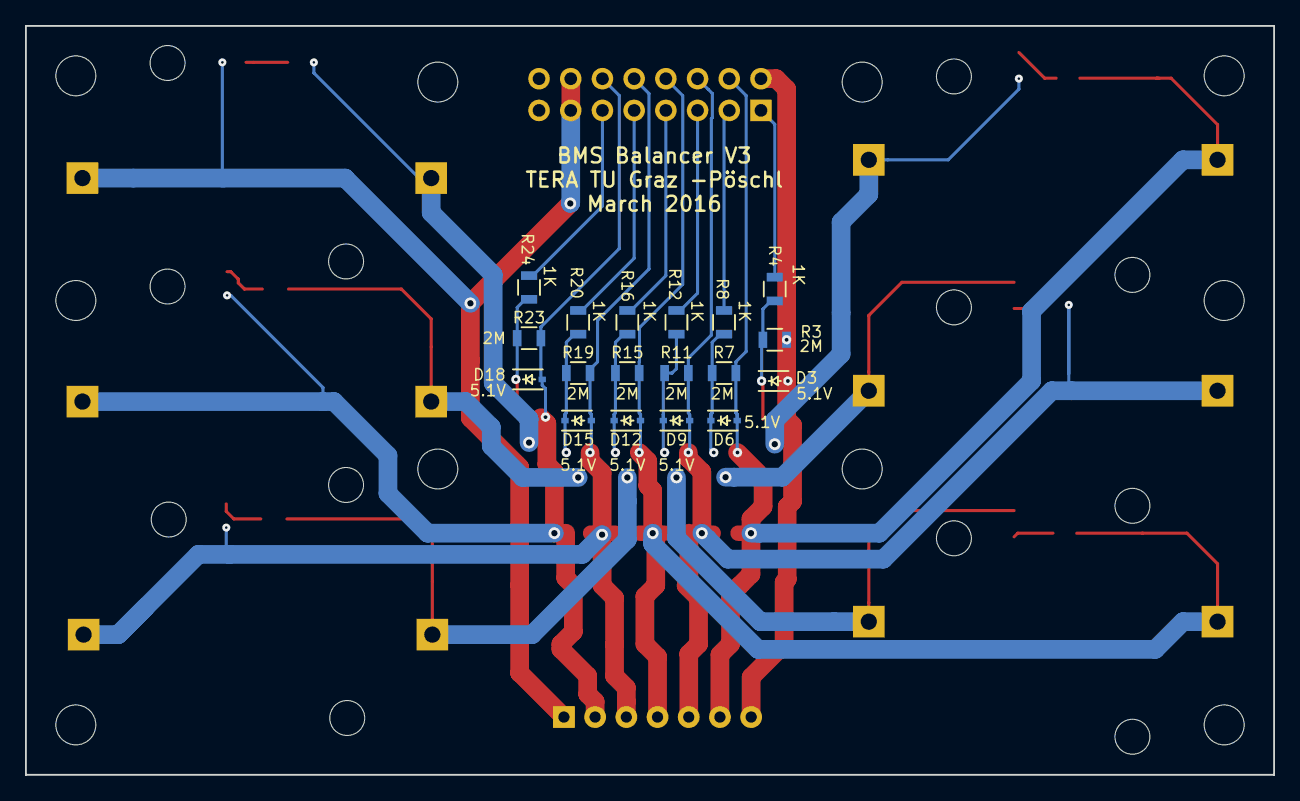
[picture p33: board bms_balance_v4.kicad_pcb from below]

Board: 2 copper layers, 100.0 x 60.0 mm, 56 parts (18 on the bottom side), 32 nets.

Parts:
C1, C2, C3, C4, C5, C6: 100n; C_0805
D1, D4, D7, D10, D13, D16: 5.1V; DO-214AA
D2, D5, D8, D11, D14, D17: LED; LED_0805
D3, D6, D9, D12, D15, D18: 5.1V; SOD-323
P1: CONN_01X07; JST_XH_B07B-XH-A_07x2.50mm_Straight
P2: CONN_02X08; Pin_Header_Straight_2x08
Q1, Q2, Q3, Q4, Q5, Q6: BSS205N; SOT-23
R1, R5, R9, R13, R17, R21: 2K2; R_0805
R2, R6, R10, R14, R18, R22: 3R3; HS15-1EP
R3, R7, R11, R15, R19, R23: 2M; R_0805
R4, R8, R12, R16, R20, R24: 1K; R_0805

Connections:
+BATT: C6.1, D16.1, P1.1, P2.13, P2.14, R21.1, R22.1
/BalancerCell1/Heat: R2.3, R6.3, R10.3, R14.3, R18.3, R22.3
/CB1: P2.1, R4.1
/CB2: P2.3, R8.1
/CB3: P2.5, R12.1
/CB4: P2.7, R16.1
/CB5: P2.9, R20.1
/CB6: P2.11, R24.1
/V1: C1.1, C2.2, D1.1, D4.2, D6.2, P1.6, P2.4, Q2.2, R1.1, R2.1, R7.2
/V2: C2.1, C3.2, D4.1, D7.2, D9.2, P1.5, P2.6, Q3.2, R5.1, R6.1, R11.2
/V3: C3.1, C4.2, D7.1, D10.2, D12.2, P1.4, P2.8, Q4.2, R9.1, R10.1, R15.2
/V4: C4.1, C5.2, D10.1, D13.2, D15.2, P1.3, P2.10, Q5.2, R13.1, R14.1, R19.2
/V5: C5.1, C6.2, D13.1, D16.2, D18.2, P1.2, P2.12, Q6.2, R17.1, R18.1, R23.2
GND: C1.2, D1.2, D3.2, P1.7, P2.2, P2.15, P2.16, Q1.2, R3.2
unnamed: D2.1, Q1.3, R2.2
unnamed: D2.2, R1.2
unnamed: D3.1, Q1.1, R3.1, R4.2
unnamed: D5.1, Q2.3, R6.2
unnamed: D5.2, R5.2
unnamed: D6.1, Q2.1, R7.1, R8.2
unnamed: D8.1, Q3.3, R10.2
unnamed: D8.2, R9.2
unnamed: D9.1, Q3.1, R11.1, R12.2
unnamed: D11.1, Q4.3, R14.2
unnamed: D11.2, R13.2
unnamed: D12.1, Q4.1, R15.1, R16.2
unnamed: D14.1, Q5.3, R18.2
unnamed: D14.2, R17.2
unnamed: D15.1, Q5.1, R19.1, R20.2
unnamed: D17.1, Q6.3, R22.2
unnamed: D17.2, R21.2
unnamed: D18.1, Q6.1, R23.1, R24.2
