TERA-TU-Graz/BatteryManagement_2017/HW/projects/fennek_2017_18/BMS/master_fennek18/BMS_Master_V7 -- fennek18/BMS_Master_V7_kicad.kicad_pcb

## KiCad design HW/projects/fennek_2017_18/BMS/master_fennek18/BMS_Master_V7 -- fennek18/BMS_Master_V7_kicad.kicad_pcb (2018-10-28)

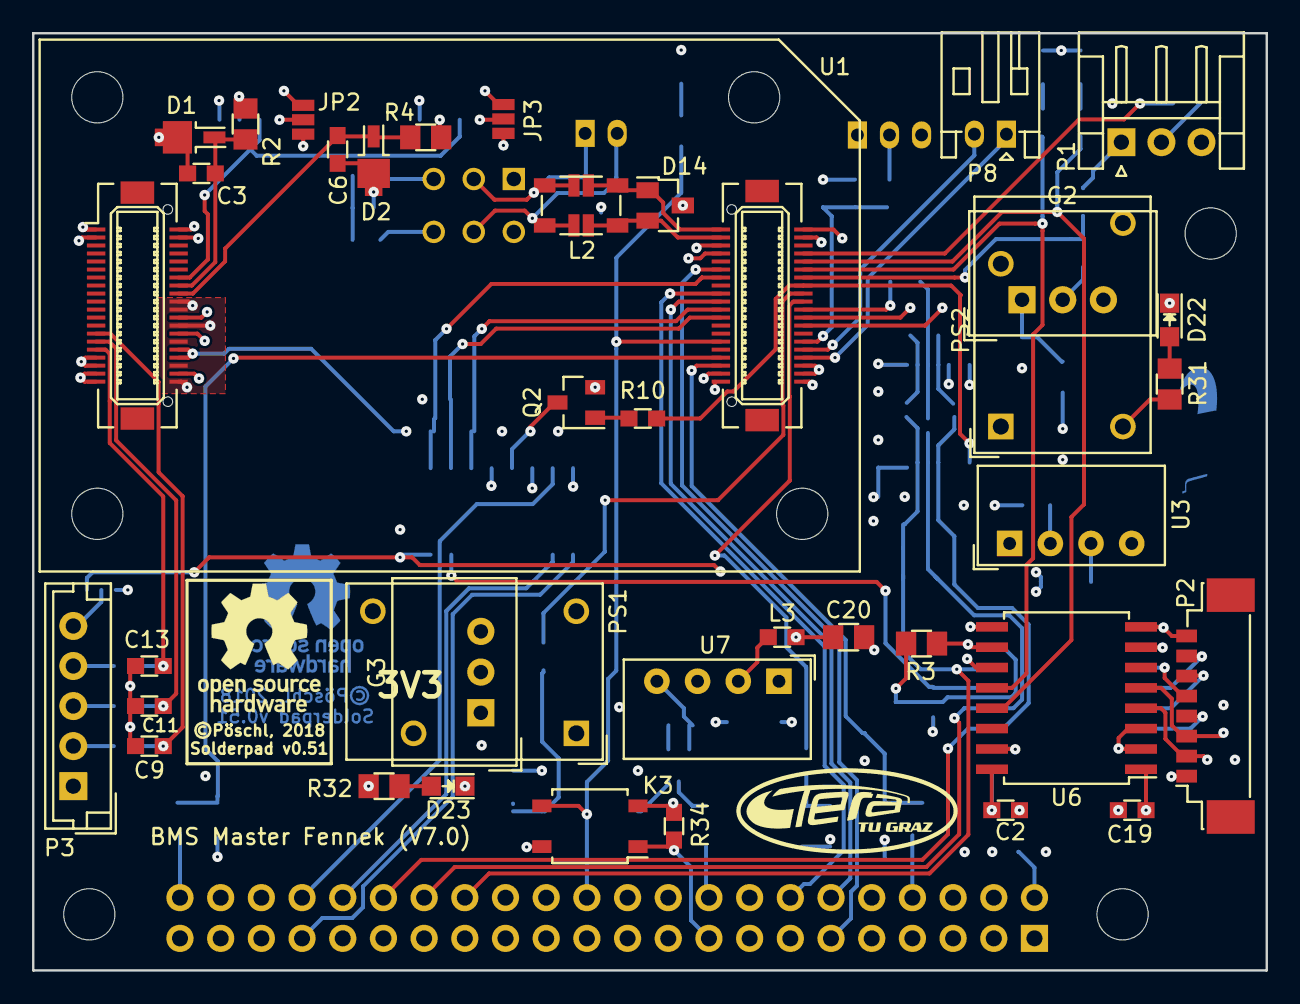
[picture p39: board BMS_Master_V7_kicad.kicad_pcb from above]

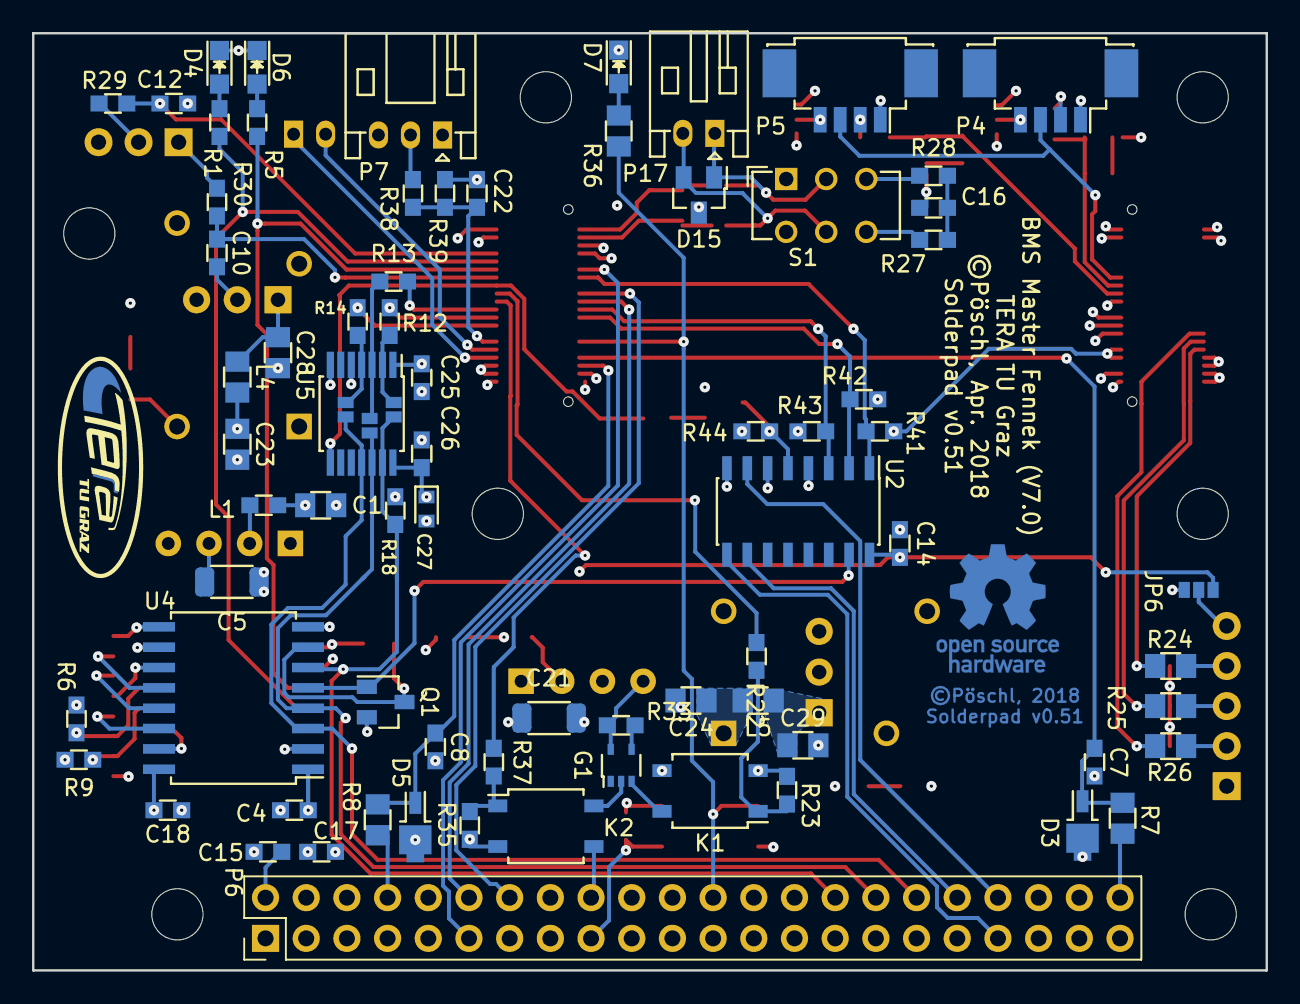
[picture p40: board BMS_Master_V7_kicad.kicad_pcb from below]

Board: 4 copper layers, 77.0 x 58.5 mm, 118 parts (77 on the bottom side), 92 nets.

Parts:
C1, C20: 4.7uF 25V; C_0805in
C2, C3, C4, C6, C7, C8, C9, C10, C11, C12, C13, C14, C15, C17, C18, C19, C22, C25, C26: 100n; C_0603in
C5, C21: 220pF 2kV; C_1206in_HV
C16: 47nF; C_0603in
C23, C24, C28, C29: 4u7; C_0805in
C27: 1u; TantalC_SizeM-1608mm_H0.9mm
D1, D2, D3, D5: 3V3; DO-216AA
D4: ~Alert; LED_0805
D6: ~Fault; LED_0805
D7: IL_OK; LED_0805
D14, D15: SUPPRESSOR; SOT-23
D22: 5V_OK; LED_0805
D23: 3V3_OK; LED_0805
G1: PSSI2021SAY
G2: TSR_0.5-2450; TSR_0.5
G3: TSR_0.5-2433; TSR_0.5
JP1, JP4, JP5: Jumper_NO_Small; SOLDERJUMPER_2_1mm
JP2, JP3: JUMPER3_NO; SOLDERJUMPER_3
JP6: JUMPER3_NO; SOLDERJUMPER_3_1mm
JP9, JP10: Jumper_NO_Small; SOLDERJUMPER_2
K1, K2, K3: ASSR-1218; SO-4
L1, L3: 4.7uH 50mA; L_0603in
L2: CM_CHOKE; L_ACT45B-XXX-2P_common-mode-choke
L4, L5: 3u3; L_0805in
P1: Buttons; JST_EH_S03B-EH_03x2.50mm_Angled
P2: Host_slave; Molex_PicoBlade_53398-0871_08x1.25mm_Straight
P3: ExtGPIO; JST_EH_B05B-EH-A_05x2.50mm_Straight
P4, P5: LEM; Molex_PicoBlade_53261-0471_04x1.25mm_Angled
P6: CONN_02X22; DW-22-08-L-D-200
P7: WheelSpeed; JST_PH_S3B-PH-K_03x2.00mm_Angled
P8, P17: CAN_CON_2pol; JST_PH_S2B-PH-K_02x2.00mm_Angled
PS1: Stepdown_v6-3V3; DCDC_Stepdown_v6
PS2: Stepdown_v6-5V; DCDC_Stepdown_v6
Q1, Q2: BSS205N
R1, R5: 5k1; R_0603in
R2, R4, R7, R8, R24, R25, R26: 1K; R_0805in
R3: 10k; R_0805in
R6, R9, R18: 100k; R_0603in
R10: 1k; R_0603in
R12, R13, R14: 100R; R_0603in
R22, R37: 470; R_0603in
R23, R29, R30, R34, R35: 1K; R_0603in
R27, R28: 60R; R_0603in
R31, R36: 5k1; R_0805in
R32: 2k2; R_0805in
R33: 120R; R_0603in
R38: 0R; R_0603in
R39: 22k; R_0603in
R41, R42, R43, R44: 10k; R_0603in
S1: SWITCH_DPDT; CuK_JS202011CQN_DPDT
U1: STM32f4_board_v3-1; STM32f4-board_v3-1
U2: SN74HC138DR
U3: Muarta_LME1205SC; Muarta_LME-SIP
U4, U6: ISO7241
U5: MAX3390EEUD
U7: Muarta_LME1212SC; Muarta_LME-SIP
svg2mod: G***; TERA_Logo_SilkS_5x12.5mm
svg2mod#2: G***; TERA_Logo_SilkS_and_Cu_5x12.5mm

Connections:
+3V3: C25.2, G3.3, JP2.3, JP3.3, JP6.1, P6.6, P6.42, PS1.2, R32.1, U1.2, U1.17, U1.18, U1.22, U1.27, U1.29, U1.39, U1.44, U1.59, U1.62, U1.63, U1.79, U5.1
+5V: C2.1, C4.1, C14.2, C26.1, C27.1, G2.3, JP2.1, JP3.1, JP6.3, K3.4, P1.3, P6.28, P7.3, PS2.2, R3.1, R31.1, R41.1, R42.1, R43.1, R44.2, U1.24, U1.25, U2.6, U2.16, U4.1, U5.14, U6.10, U6.16
+5V_SLAVE: C18.2, C19.2, P2.1, U3.4, U4.10, U4.16, U6.1, U6.7
+12V: C1.1, C17.2, C20.1, C23.1, C24.1, L1.2, L3.2, L4.2, L5.2, P6.4, PS1.1, PS2.1
/12V_Relay_Fault: P6.11, U1.46
/Alegro_1: P6.44, R7.1
/Alegro_1_Filtered: C7.1, D3.1, R7.2, U1.57
/Alegro_2: P6.8, R8.1
/Alegro_2_Filtered: C8.1, D5.1, R8.2, U1.58
/Button_Off: C10.1, R30.2, U1.74
/Button_On: C12.1, R29.2, U1.77
/CAN/CAN1+: P8.2, U1.65
/CAN/CAN1-: P8.1, U1.64
/CAN/CAN2+: D14.2, JP10.1, L2.2, U1.42
/CAN/CAN2-: D14.1, JP9.1, L2.3, U1.41
/CAN/CANperi+: D15.2, JP10.2, L2.1, P17.2, S1.5
/CAN/CANperi-: D15.1, JP9.2, L2.4, P17.1, S1.2
/CS_B0: R41.2, U1.47, U2.1
/CS_B1: R42.2, U1.52, U2.2
/CS_B2: R43.2, U1.51, U2.3
/EXT_GPIO_1: C13.1, R24.2, U1.16
/EXT_GPIO_2: C11.1, R25.2, U1.15
/EXT_GPIO_3: C9.1, R26.2, U1.14
/IL_next+: K2.3, P6.18
/IL_next-: K3.1, P6.17, R34.1
/Interlock/IL_Iconst: G1.2, K2.4
/Interlock_OK: K3.3, P6.24, R36.2, U1.55
/Interlock_On1: R22.2, U1.72
/Interlock_On2: R37.1, U1.71
/LEM1: C3.1, D1.1, R2.2, U1.33
/LEM2: C6.1, D2.1, R4.2, U1.32
/LEM_Standby: P4.3, P5.3, U1.34
/MISO: R12.2, U1.69
/MOSI: R13.2, U1.70
/Main Connector/+12VDC_BMS_Switched: C15.2, P6.2
/Main_Fault: P6.12, U1.50
/NALERT: R1.1, U1.76, U6.13
/NCS_12V_Relay: P6.37, U2.9
/NCS_MainRelay: P6.36, U2.10
/NCS_PreCharge: P6.38, U2.7
/NFAULT: R5.1, U1.75, U6.12
/Precharge_Fault: P6.14, U1.49
/SCLK: R14.2, U1.68
/SPI_CLK_5V: JP5.2, P6.34, U4.3, U5.11
/SPI_CS: R10.2, U1.73, U5.8
/SPI_Controller/MISO_1: JP1.1, R12.1, U5.2
/SPI_Controller/MOSI_1: JP4.1, R13.1, U5.3
/SPI_Controller/NCS1: Q1.1, U2.15, U4.5
/SPI_Controller/SCLK_1: JP5.1, R14.1, U5.4
/SPI_Controller/SPI Isolator/MISO_slave: P2.5, U4.11
/SPI_Controller/SPI Isolator/MOSI_Slave: P2.6, U4.13
/SPI_Controller/SPI Isolator/NCS_Slave: P2.7, U4.12
/SPI_Controller/SPI Isolator/SCLK_slave: P2.4, U4.14
/SPI_Controller/SPI Isolator/~Alert_slave: P2.2, R9.1, U6.4
/SPI_Controller/SPI Isolator/~Fault_slave: P2.3, R6.1, U6.5
/SPI_Controller/SPI_NCS_5V: Q2.3, R44.1, U2.5
/SPI_MISO_5V: JP1.2, P6.30, R18.1, U4.6, U5.13
/SPI_MOSI_5V: JP4.2, P6.32, U4.4, U5.12
/WheelSpeed: C22.1, R38.2, R39.2, U1.66
GND: C1.2, C2.2, C3.2, C4.2, C5.1, C6.2, C7.2, C8.2, C9.2, C10.2, C11.2, C12.2, C13.2, C14.1, C15.1, C16.2, C17.1, C20.2, C21.1, C22.2, C23.2, C24.2, C25.1, C26.2, C27.2, C28.2, C29.2, D1.2, D2.2, D3.2, D4.1, D5.2, D6.1, D7.1, D14.3, D15.3, D22.1, D23.1, G2.2, G3.2, K1.2, K2.2, P3.1, P4.1, P5.1, P6.1, P6.3, P6.5, P6.7, P6.9, P6.10, P6.13, P6.21, P6.22, P6.23, P6.25, P6.26, P6.27, P6.29, P6.31, P6.33, P6.35, P6.39, P6.40, P6.41, P6.43, P7.1, PS1.3, PS1.4, PS2.3, PS2.4, Q1.2, Q2.2, R18.2, R23.2, R35.2, R39.1, U1.1, U1.19, U1.20, U1.21, U1.23, U1.26, U1.28, U1.30, U1.31, U1.40, U1.43, U1.60, U1.61, U1.80, U2.4, U2.8, U3.1, U4.2, U4.8, U5.5, U5.7, U6.9, U6.11, U6.15, U7.1
GND_slave: C5.2, C18.1, C19.1, P2.8, R6.2, R9.2, U3.3, U4.9, U4.15, U6.2, U6.3, U6.8
IL_V+: G1.5, R33.1, U7.4
IL_V-: C21.2, K1.3, K3.2, R34.2, U7.3
unnamed: C16.1, R27.2, R28.2
unnamed: C28.1, G2.1, L4.1
unnamed: C29.1, G3.1, L5.1
unnamed: D4.2, R1.2
unnamed: D6.2, R5.2
unnamed: D7.2, R36.1
unnamed: D22.2, R31.2
unnamed: D23.2, R32.2
unnamed: G1.3, K1.4
unnamed: G1.4, R33.2
unnamed: JP2.2, P4.4
unnamed: JP3.2, P5.4
unnamed: JP6.2, P3.5
unnamed: K1.1, R22.1, R23.1
unnamed: K2.1, R35.1, R37.2
unnamed: L1.1, U3.2
unnamed: L3.1, U7.2
unnamed: P1.1, R30.1
unnamed: P1.2, R29.1
unnamed: P3.2, R26.1
unnamed: P3.3, R25.1
unnamed: P3.4, R24.1
unnamed: P4.2, R2.1
unnamed: P5.2, R4.1
unnamed: P7.2, R38.1
unnamed: Q1.3, R3.2, U4.7
unnamed: Q2.1, R10.1
unnamed: R27.1, S1.6
unnamed: R28.1, S1.3
