TERA-TU-Graz/BatteryManagement_2017/HW/projects/fennek_2017_18/BMS/Current_Sense/current_sense_v1_lem/current_sense.kicad_pcb

## KiCad design HW/projects/fennek_2017_18/BMS/Current_Sense/current_sense_v1_lem/current_sense.kicad_pcb (2018-10-28)

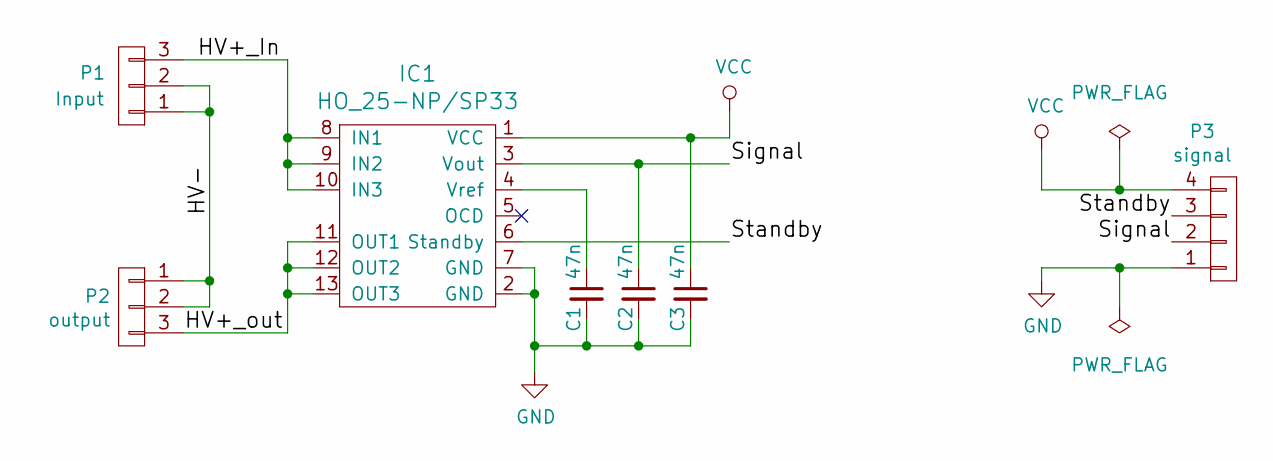
[picture p43: schematic current_sense.sch]

Parts:
C1, C2, C3: 47n; C_0603in
IC1: HO_25-NP/SP33; HO_25-NP_SP33
P1: Input; PhoenixContact_MSTBVA-G_03x5.08mm_Vertical
P2: output; PhoenixContact_MSTBA-G_03x5.08mm_Angled
P3: signal; Molex_PicoBlade_53261-0471_04x1.25mm_Angled

Connections:
/HV+_In: IC1.8 (IN1), IC1.9 (IN2), IC1.10 (IN3), P1.3
/HV+_out: IC1.11 (OUT1), IC1.12 (OUT2), IC1.13 (OUT3), P2.3
/HV-: P1.1, P1.2, P2.1, P2.2
/Signal: C2.1, IC1.3 (Vout), P3.2
/Standby: IC1.6 (Standby), P3.3
GND: C1.2, C2.2, C3.2, IC1.2 (GND), IC1.7 (GND), P3.1
unnamed: C1.1, IC1.4 (Vref)
VCC: C3.1, IC1.1 (VCC), P3.4

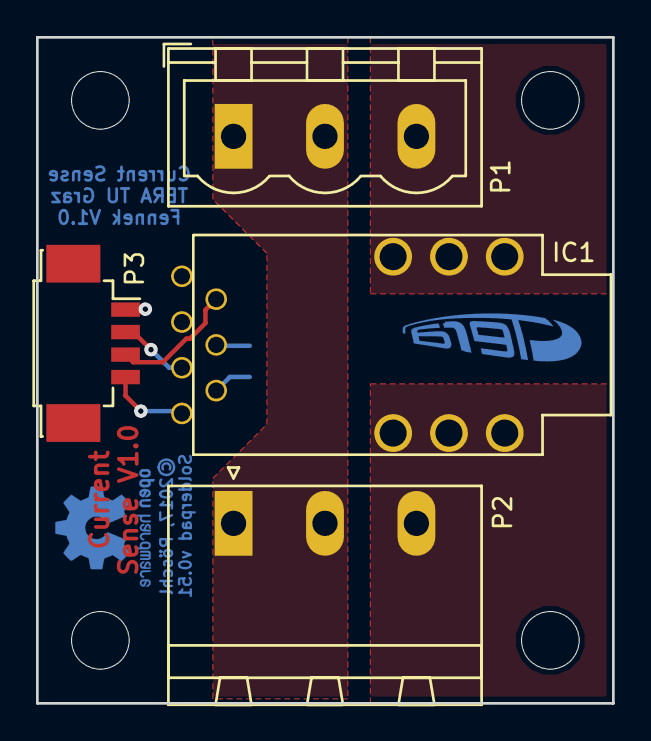
[picture p44: board current_sense.kicad_pcb from above]

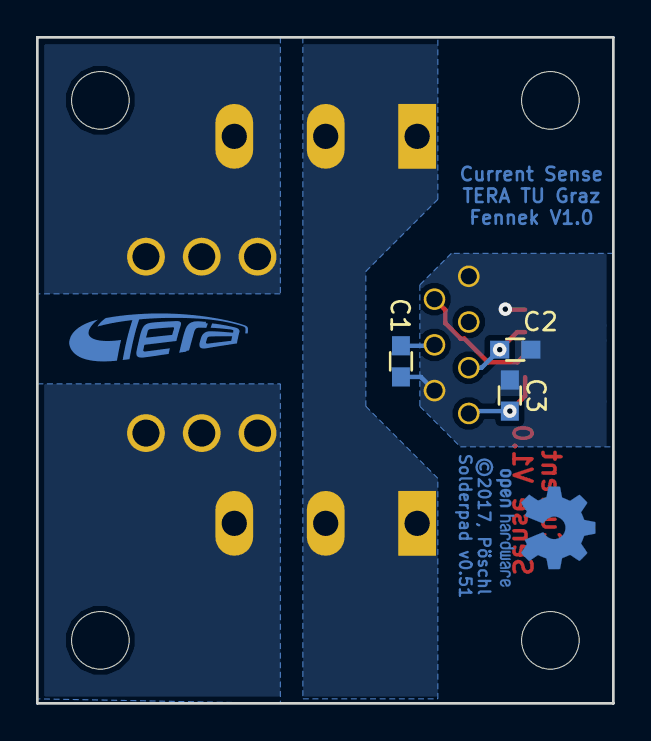
[picture p45: board current_sense.kicad_pcb from below]

Board: 2 copper layers, 32.0 x 37.0 mm, 8 parts (4 on the bottom side), 8 nets.

Other parts of the board:
svg2mod: G***; TERA_TextOnly_Cu_2.5x9.5mm
