TERA-TU-Graz/BatteryManagement_2017/HW/projects/ibex/BMS_Ibex/Master/BMS_Master_V3/BMS_Master.brd

## EAGLE design HW/projects/ibex/BMS_Ibex/Master/BMS_Master_V3/BMS_Master.brd (2017-08-10, an earlier design)

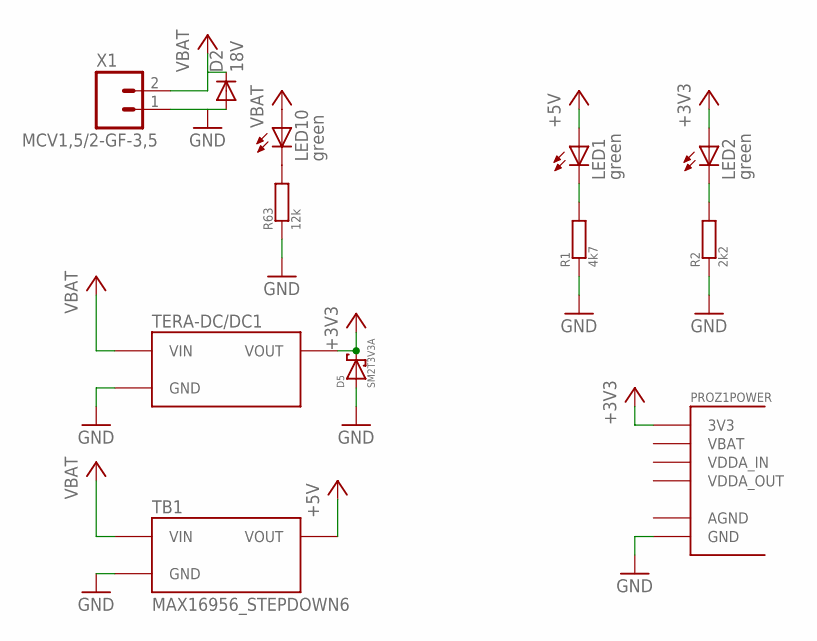
[picture p46: schematic BMS_Master.sch, sheet 1, Supply]

Parts:
D2: 18V; DO214AA
D5: SM2T3V3A
LED1, LED2, LED10: green; CHIP-LED0805
PROZ1: STM32F4_PROZESSORBOARDRPZ; STM32F4_PROZESSORBOARD
R1: 4k7; R0805
R2: 2k2; R0805
R63: 12k; R0805
TB1: MAX16956_STEPDOWN6
TERA-DC/DC1: MAX5035_STEPDOWN3
X1: MCV1,5/2-GF-3,5

Connections:
+3V3: D5.P$2, LED2.A, PROZ1.45 (3V3), PROZ1.46 (3V3), TERA-DC/DC1.VOUT; also elsewhere on the board
+5V: LED1.A, TB1.VOUT; also elsewhere on the board
GND: D2.A, D5.P$1, D5.P$11, PROZ1.47 (GND), PROZ1.48 (GND), R1.1, R2.1, R63.1, TB1.GND, TB1.GND2 (GND), TERA-DC/DC1.GND@1 (GND), TERA-DC/DC1.GND@2 (GND), X1.1; also elsewhere on the board
unnamed: LED1.C, R1.2
unnamed: LED2.C, R2.2
unnamed: LED10.C, R63.2
VBAT: D2.C, LED10.A, TB1.VIN, TERA-DC/DC1.VIN, X1.2; also elsewhere on the board

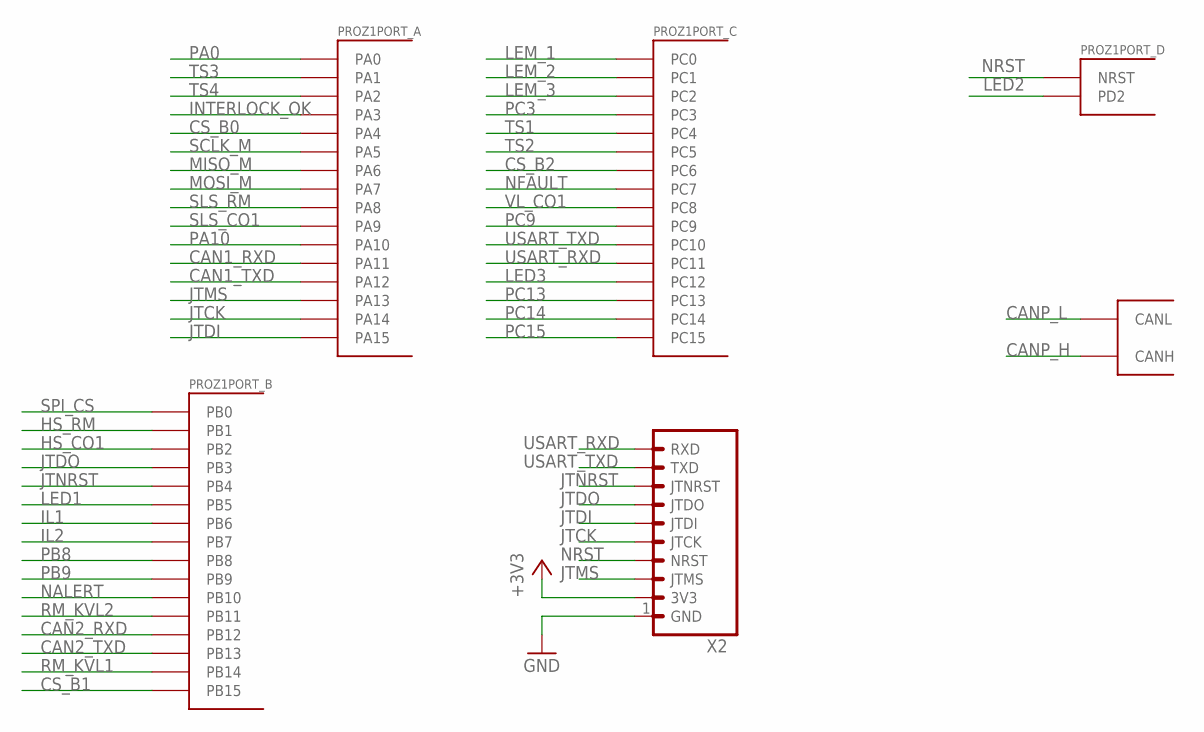
[picture p47: schematic BMS_Master.sch, sheet 2, Processor Interface]

Parts:
PROZ1: STM32F4_PROZESSORBOARDRPZ; STM32F4_PROZESSORBOARD
X2: TERA-PROG-DEBUG-10GERADE; 90130-1110

Connections:
+3V3: X2.2 (3V3); also elsewhere on the board
CAN1_RXD: PROZ1.26 (PA11); also elsewhere on the board
CAN1_TXD: PROZ1.24 (PA12); also elsewhere on the board
CAN2_RXD: PROZ1.50 (PB12); also elsewhere on the board
CAN2_TXD: PROZ1.49 (PB13); also elsewhere on the board
CANP_H: PROZ1.31 (CANH); also elsewhere on the board
CANP_L: PROZ1.32 (CANL); also elsewhere on the board
CS_B0: PROZ1.43 (PA4); also elsewhere on the board
CS_B1: PROZ1.51 (PB15); also elsewhere on the board
CS_B2: PROZ1.52 (PC6); also elsewhere on the board
GND: X2.1 (GND); also elsewhere on the board
HS_CO1: PROZ1.36 (PB2); also elsewhere on the board
HS_RM: PROZ1.37 (PB1); also elsewhere on the board
IL1: PROZ1.14 (PB6); also elsewhere on the board
IL2: PROZ1.12 (PB7); also elsewhere on the board
INTERLOCK_OK: PROZ1.44 (PA3); also elsewhere on the board
JTCK: PROZ1.18 (PA14), X2.5 (JTCK)
JTDI: PROZ1.16 (PA15), X2.6 (JTDI)
JTDO: PROZ1.20 (PB3), X2.7 (JTDO)
JTMS: PROZ1.59 (PA13), X2.3 (JTMS)
JTNRST: PROZ1.22 (PB4), X2.8 (JTNRST)
LED1: PROZ1.25 (PB5)
LED2: PROZ1.27 (PD2)
LED3: PROZ1.29 (PC12)
LEM_1: PROZ1.15 (PC0); also elsewhere on the board
LEM_2: PROZ1.13 (PC1); also elsewhere on the board
LEM_3: PROZ1.11 (PC2); also elsewhere on the board
MISO_M: PROZ1.42 (PA6); also elsewhere on the board
MOSI_M: PROZ1.41 (PA7); also elsewhere on the board
NALERT: PROZ1.35 (PB10); also elsewhere on the board
NFAULT: PROZ1.53 (PC7); also elsewhere on the board
NRST: PROZ1.17 (NRST), X2.4 (NRST)
PA0: PROZ1.7 (PA0)
PA10: PROZ1.58 (PA10)
PB8: PROZ1.10 (PB8)
PB9: PROZ1.8 (PB9)
PC3: PROZ1.9 (PC3)
PC9: PROZ1.55 (PC9)
PC13: PROZ1.23 (PC13)
PC14: PROZ1.21 (PC14)
PC15: PROZ1.19 (PC15)
RM_KVL1: PROZ1.33 (PB14); also elsewhere on the board
RM_KVL2: PROZ1.34 (PB11); also elsewhere on the board
SCLK_M: PROZ1.60 (PA5); also elsewhere on the board
SLS_CO1: PROZ1.57 (PA9); also elsewhere on the board
SLS_RM: PROZ1.56 (PA8); also elsewhere on the board
SPI_CS: PROZ1.38 (PB0); also elsewhere on the board
TS1: PROZ1.40 (PC4); also elsewhere on the board
TS2: PROZ1.39 (PC5); also elsewhere on the board
TS3: PROZ1.5 (PA1); also elsewhere on the board
TS4: PROZ1.3 (PA2); also elsewhere on the board
USART_RXD: PROZ1.30 (PC11), X2.10 (RXD)
USART_TXD: PROZ1.28 (PC10), X2.9 (TXD)
VL_CO1: PROZ1.54 (PC8); also elsewhere on the board

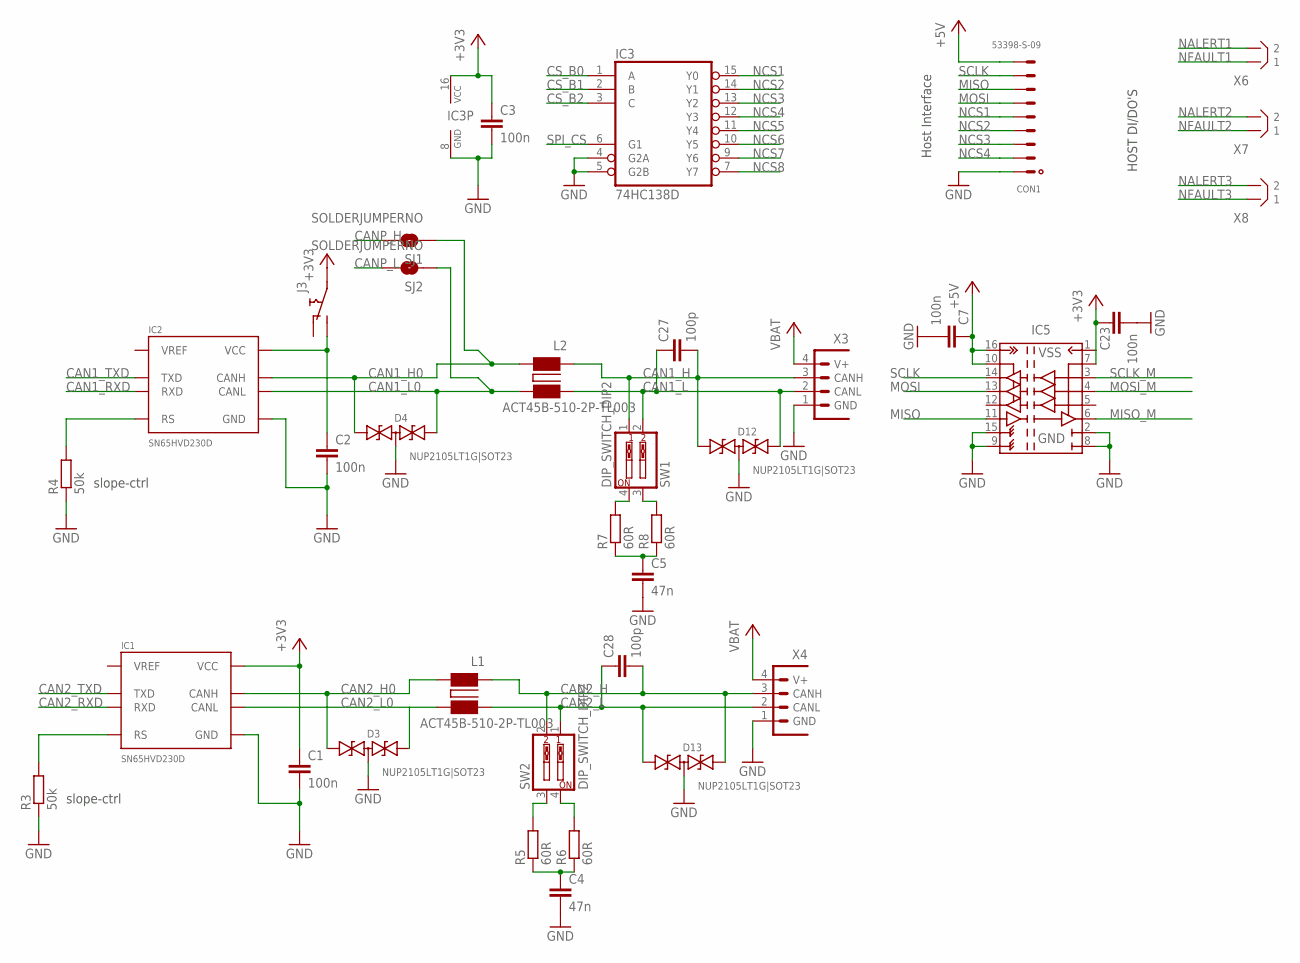
[picture p48: schematic BMS_Master.sch, sheet 3, Bus Systems (CAN, SPI)]

Parts:
C1, C2, C3: 100n; C0805
C4, C5: 47n; C0603
C7, C23: 100n; C0603
C27, C28: 100p; C0603
CON1: 53398-S-09; 53398-09-S
D3, D4, D12, D13: NUP2105LT1G|SOT23; SOT23
IC1, IC2: SN65HVD230D; SO08
IC3: 74HC138D; SO16
IC5: ISO7241; R-PDSO-G16
J3: JUMPER_SWITCHS; J_OR_S
L1, L2: ACT45B-510-2P-TL003; ACT45B
R3, R4: 50k; R0805
R5, R6, R7, R8: 60R; R0603
SJ1, SJ2: SOLDERJUMPERNO; SJ_2S-NO
SW1, SW2: DIP_SWITCH_DIP2; DIPSWITCH-02
X3, X4: CIOC_4-1-FV-A_CAN-BELEGUNG; CIOC_4-1-FV
X6, X7, X8: B2B-XH

Connections:
+3V3: C1.1, C3.1, C23.2, IC1.3 (VCC), IC3.16 (VCC), IC5.1 (VCC1), IC5.7 (EN1), J3.P$1; also elsewhere on the board
+5V: C7.2, CON1.9, IC5.10 (EN2), IC5.16 (VCC2); also elsewhere on the board
CAN1_H: C27.2, D12.1, L2.P$3 (3), SW1.1, X3.3 (CANH)
CAN1_H0: D4.1, IC2.7 (CANH), L2.P$4 (4), SJ1.1
CAN1_L: C27.1, D12.2, L2.P$1 (1), SW1.2, X3.2 (CANL)
CAN1_L0: D4.2, IC2.6 (CANL), L2.P$2 (2), SJ2.1
CAN1_RXD: IC2.4 (RXD); also elsewhere on the board
CAN1_TXD: IC2.1 (TXD); also elsewhere on the board
CAN2_H: C28.2, D13.2, L1.P$3 (3), SW2.2, X4.3 (CANH)
CAN2_H0: D3.1, IC1.7 (CANH), L1.P$4 (4)
CAN2_L: C28.1, D13.1, L1.P$1 (1), SW2.1, X4.2 (CANL)
CAN2_L0: D3.2, IC1.6 (CANL), L1.P$2 (2)
CAN2_RXD: IC1.4 (RXD); also elsewhere on the board
CAN2_TXD: IC1.1 (TXD); also elsewhere on the board
CANP_H: SJ1.2; also elsewhere on the board
CANP_L: SJ2.2; also elsewhere on the board
CS_B0: IC3.1 (A); also elsewhere on the board
CS_B1: IC3.2 (B); also elsewhere on the board
CS_B2: IC3.3 (C); also elsewhere on the board
GND: C1.2, C2.2, C3.2, C4.2, C5.2, C7.1, C23.1, CON1.1, D3.3, D4.3, D12.3, D13.3, IC1.2 (GND), IC2.2 (GND), IC3.4 (G2A), IC3.5 (G2B), IC3.8 (GND), IC5.2 (GND11), IC5.8 (GND12), IC5.9 (GND22), IC5.15 (GND21), R3.1, R4.1, X3.1 (GND), X4.1 (GND); also elsewhere on the board
MISO: CON1.7, IC5.11 (IN_D); also elsewhere on the board
MISO_M: IC5.6 (OUT_D); also elsewhere on the board
MOSI: CON1.6, IC5.13 (OUT_B); also elsewhere on the board
MOSI_M: IC5.4 (IN_B); also elsewhere on the board
unnamed: C5.1, R7.1, R8.1
unnamed: C2.1, IC2.3 (VCC), J3.P$2
unnamed: IC2.8 (RS), R4.2
unnamed: C4.1, R5.1, R6.1
unnamed: R7.2, SW1.4
unnamed: IC1.8 (RS), R3.2
unnamed: R5.2, SW2.3
unnamed: R6.2, SW2.4
unnamed: R8.2, SW1.3
NALERT1: X6.P$2 (2); also elsewhere on the board
NALERT2: X7.P$2 (2); also elsewhere on the board
NALERT3: X8.P$2 (2); also elsewhere on the board
NCS1: CON1.5, IC3.15 (Y0)
NCS2: CON1.4, IC3.14 (Y1)
NCS3: CON1.3, IC3.13 (Y2)
NCS4: CON1.2, IC3.12 (Y3)
NCS5: IC3.11 (Y4)
NCS6: IC3.10 (Y5); also elsewhere on the board
NCS7: IC3.9 (Y6); also elsewhere on the board
NCS8: IC3.7 (Y7); also elsewhere on the board
NFAULT1: X6.P$1 (1); also elsewhere on the board
NFAULT2: X7.P$1 (1); also elsewhere on the board
NFAULT3: X8.P$1 (1); also elsewhere on the board
SCLK: CON1.8, IC5.14 (OUT_A); also elsewhere on the board
SCLK_M: IC5.3 (IN_A); also elsewhere on the board
SPI_CS: IC3.6 (G1); also elsewhere on the board
VBAT: X3.4 (V+), X4.4 (V+); also elsewhere on the board

Notes on the sheet:
slope-ctrl
Host Interface
HOST DI/DO'S

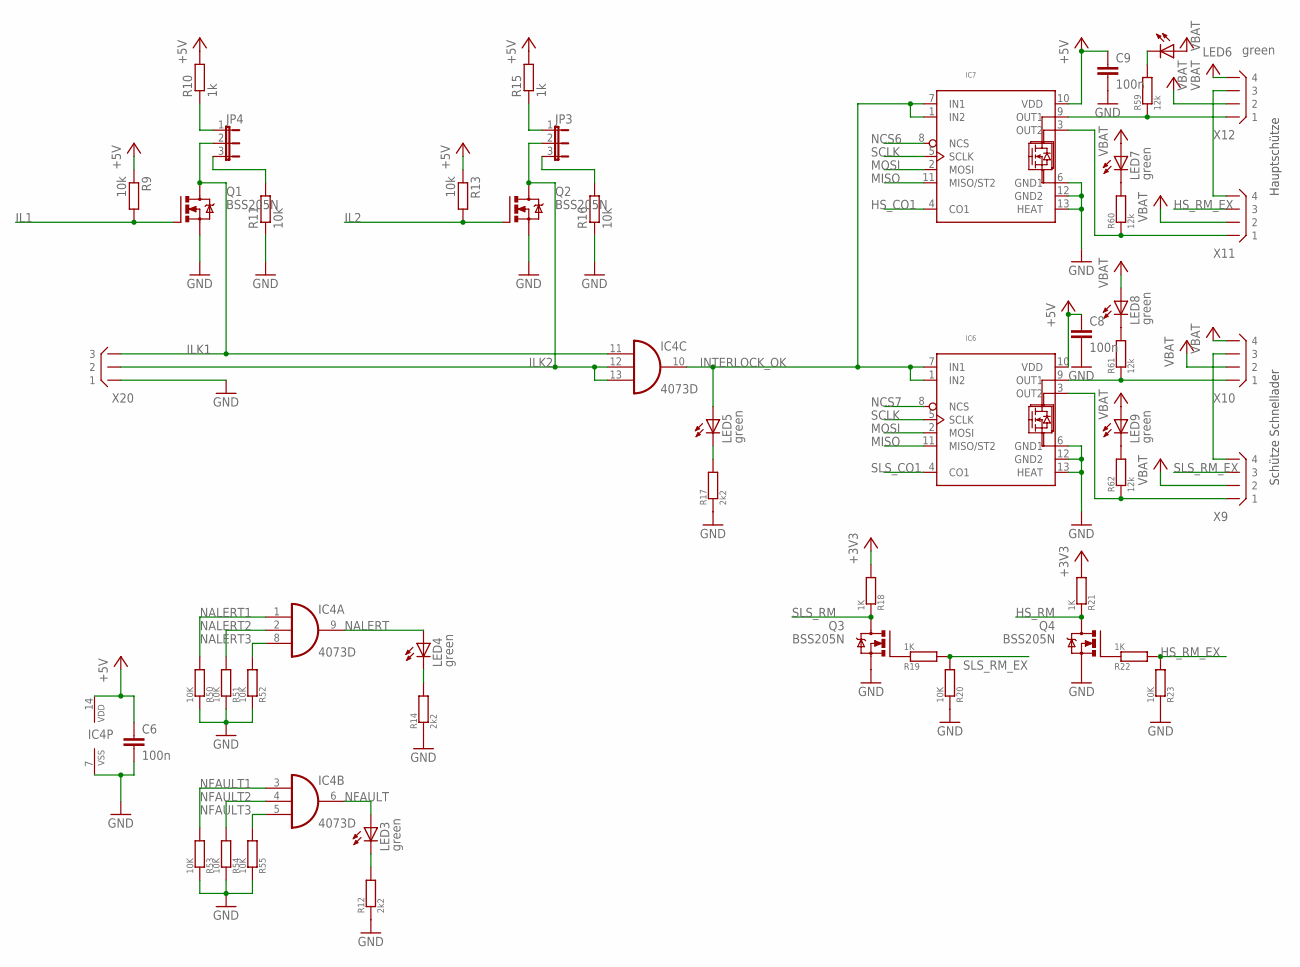
[picture p49: schematic BMS_Master.sch, sheet 4, Safety Systems]

Parts:
C6, C8, C9: 100n; C0603
IC4: 4073D; SO14
IC6, IC7: TLE8102SGN; INF-PG-DSO-12-11_N_1PRIMARY
JP3, JP4: JUMPER_OR; JP2_OCT
LED3, LED4, LED5: green; CHIPLED_0805
LED6, LED7, LED8, LED9: green; CHIP-LED0805
Q1, Q2, Q3, Q4: BSS205N; SOT23
R9, R11, R13, R16: 10k; R0603
R10, R15: 1k; R0603
R12, R14, R17: 2k2; R0805
R18, R21: 1K; R0603
R19, R22: 1K; R0805
R20, R23: 10K; R0805
R50, R51, R52, R53, R54, R55: 10K; R0603
R59, R60, R61, R62: 12k; R0805
X9, X10, X11, X12: B4B-XH
X20: B3B-XH

Connections:
+3V3: R18.2, R21.2; also elsewhere on the board
+5V: C6.1, C8.1, C9.1, IC4.14 (VDD), IC6.10 (VDD), IC7.10 (VDD), R9.1, R10.2, R13.1, R15.2; also elsewhere on the board
GND: C6.2, C8.2, C9.2, IC4.7 (VSS), IC6.6 (GND1), IC6.12 (GND2), IC6.13 (HEAT), IC7.6 (GND1), IC7.12 (GND2), IC7.13 (HEAT), Q1.2 (S), Q2.2 (S), Q3.2 (S), Q4.2 (S), R11.1, R12.1, R14.1, R16.1, R17.1, R20.1, R23.1, R50.1, R51.1, R52.1, R53.1, R54.1, R55.1, X20.P$1 (1); also elsewhere on the board
HS_CO1: IC7.4 (CO1); also elsewhere on the board
HS_RM: Q4.3 (D), R21.1; also elsewhere on the board
HS_RM_EX: R22.2, R23.2, X11.P$3 (3)
IL1: Q1.1 (G), R9.2; also elsewhere on the board
IL2: Q2.1 (G), R13.2; also elsewhere on the board
ILK1: IC4.11 (I0), JP4.2, Q1.3 (D), X20.P$3 (3)
ILK2: IC4.12 (I1), IC4.13 (I2), JP3.2, Q2.3 (D), X20.P$2 (2)
INTERLOCK_OK: IC4.10 (O), IC6.1 (IN2), IC6.7 (IN1), IC7.1 (IN2), IC7.7 (IN1), LED5.A; also elsewhere on the board
MISO: IC6.11 (MISO/ST2), IC7.11 (MISO/ST2); also elsewhere on the board
MOSI: IC6.2 (MOSI), IC7.2 (MOSI); also elsewhere on the board
unnamed: X9.P$4 (4), X10.P$3 (3)
unnamed: IC7.3 (OUT2), R60.1, X11.P$1 (1)
unnamed: IC6.9 (OUT1), R61.1, X10.P$1 (1)
unnamed: X11.P$4 (4), X12.P$3 (3)
unnamed: IC6.3 (OUT2), R62.1, X9.P$1 (1)
unnamed: IC7.9 (OUT1), R59.1, X12.P$1 (1)
unnamed: JP4.1, R10.1
unnamed: JP3.1, R15.1
unnamed: JP3.3, R16.2
unnamed: JP4.3, R11.2
unnamed: LED5.C, R17.2
unnamed: LED4.C, R14.2
unnamed: LED3.C, R12.2
unnamed: Q3.1 (G), R19.1
unnamed: Q4.1 (G), R22.1
unnamed: LED6.C, R59.2
unnamed: LED7.C, R60.2
unnamed: LED8.C, R61.2
unnamed: LED9.C, R62.2
NALERT: IC4.9 (O), LED4.A; also elsewhere on the board
NALERT1: IC4.1 (I0), R50.2; also elsewhere on the board
NALERT2: IC4.2 (I1), R51.2; also elsewhere on the board
NALERT3: IC4.8 (I2), R52.2; also elsewhere on the board
NCS6: IC7.8 (NCS); also elsewhere on the board
NCS7: IC6.8 (NCS); also elsewhere on the board
NFAULT: IC4.6 (O), LED3.A; also elsewhere on the board
NFAULT1: IC4.3 (I0), R53.2; also elsewhere on the board
NFAULT2: IC4.4 (I1), R54.2; also elsewhere on the board
NFAULT3: IC4.5 (I2), R55.2; also elsewhere on the board
SCLK: IC6.5 (SCLK), IC7.5 (SCLK); also elsewhere on the board
SLS_CO1: IC6.4 (CO1); also elsewhere on the board
SLS_RM: Q3.3 (D), R18.1; also elsewhere on the board
SLS_RM_EX: R19.2, R20.2, X9.P$3 (3)
VBAT: LED6.A, LED7.A, LED8.A, LED9.A, X9.P$2 (2), X10.P$2 (2), X10.P$4 (4), X11.P$2 (2), X12.P$2 (2), X12.P$4 (4); also elsewhere on the board

Notes on the sheet:
Hauptschütze
Schütze Schnellader

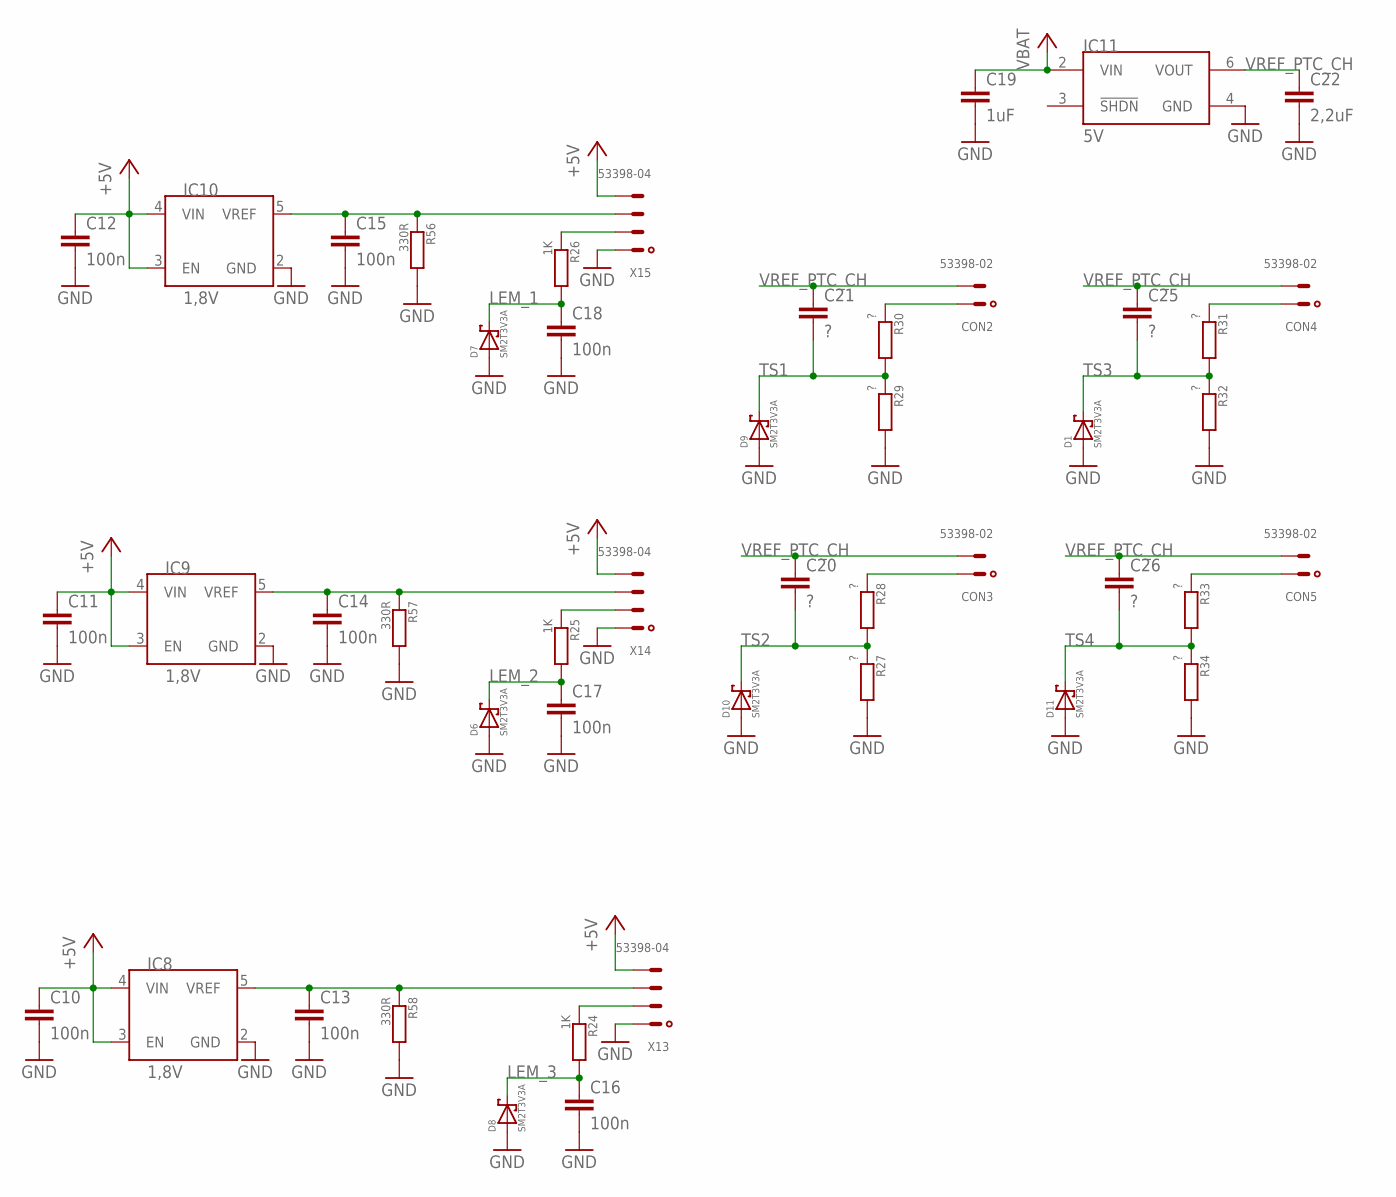
[picture p50: schematic BMS_Master.sch, sheet 5, Analog: - Current Measurment - Charger Temperatur]

Parts:
C10, C11, C12, C13, C14, C15, C16, C17, C18: 100n; C0805
C19: 1uF; C0805
C20, C21, C25, C26: ?; C0603
C22: 2,2uF; C0805
CON2, CON3, CON4, CON5: 53398-02
D1, D6, D7, D8, D9, D10, D11: SM2T3V3A
IC8, IC9, IC10: 1,8V; SOT23-5L
IC11: 5V; SO08
R24, R25, R26: 1K; R0805
R27, R28, R29, R30, R31, R32, R33, R34: ?; R0603
R56, R57, R58: 330R; R0805
X13, X14, X15: 53398-04

Connections:
+5V: C10.1, C11.1, C12.1, IC8.3 (EN), IC8.4 (VIN), IC9.3 (EN), IC9.4 (VIN), IC10.3 (EN), IC10.4 (VIN), X13.4, X14.4, X15.4; also elsewhere on the board
GND: C10.2, C11.2, C12.2, C13.2, C14.2, C15.2, C16.2, C17.2, C18.2, C19.2, C22.2, D1.P$1, D1.P$11, D6.P$1, D6.P$11, D7.P$1, D7.P$11, D8.P$1, D8.P$11, D9.P$1, D9.P$11, D10.P$1, D10.P$11, D11.P$1, D11.P$11, IC8.2 (GND), IC9.2 (GND), IC10.2 (GND), IC11.4 (GND), R27.2, R29.2, R32.2, R34.2, R56.2, R57.2, R58.2, X13.1, X14.1, X15.1; also elsewhere on the board
LEM_1: C18.1, D7.P$2, R26.2; also elsewhere on the board
LEM_2: C17.1, D6.P$2, R25.2; also elsewhere on the board
LEM_3: C16.1, D8.P$2, R24.2; also elsewhere on the board
unnamed: C13.1, IC8.5 (VREF), R58.1, X13.3
unnamed: R26.1, X15.2
unnamed: C14.1, IC9.5 (VREF), R57.1, X14.3
unnamed: CON4.1, R31.1
unnamed: CON5.1, R33.1
unnamed: CON2.1, R30.1
unnamed: R25.1, X14.2
unnamed: C15.1, IC10.5 (VREF), R56.1, X15.3
unnamed: R24.1, X13.2
unnamed: CON3.1, R28.1
TS1: C21.2, D9.P$2, R29.1, R30.2; also elsewhere on the board
TS2: C20.2, D10.P$2, R27.1, R28.2; also elsewhere on the board
TS3: C25.2, D1.P$2, R31.2, R32.1; also elsewhere on the board
TS4: C26.2, D11.P$2, R33.2, R34.1; also elsewhere on the board
VBAT: C19.1, IC11.2 (VIN); also elsewhere on the board
VREF_PTC_CH: C20.1, C21.1, C22.1, C25.1, C26.1, CON2.2, CON3.2, CON4.2, CON5.2, IC11.6 (VOUT)

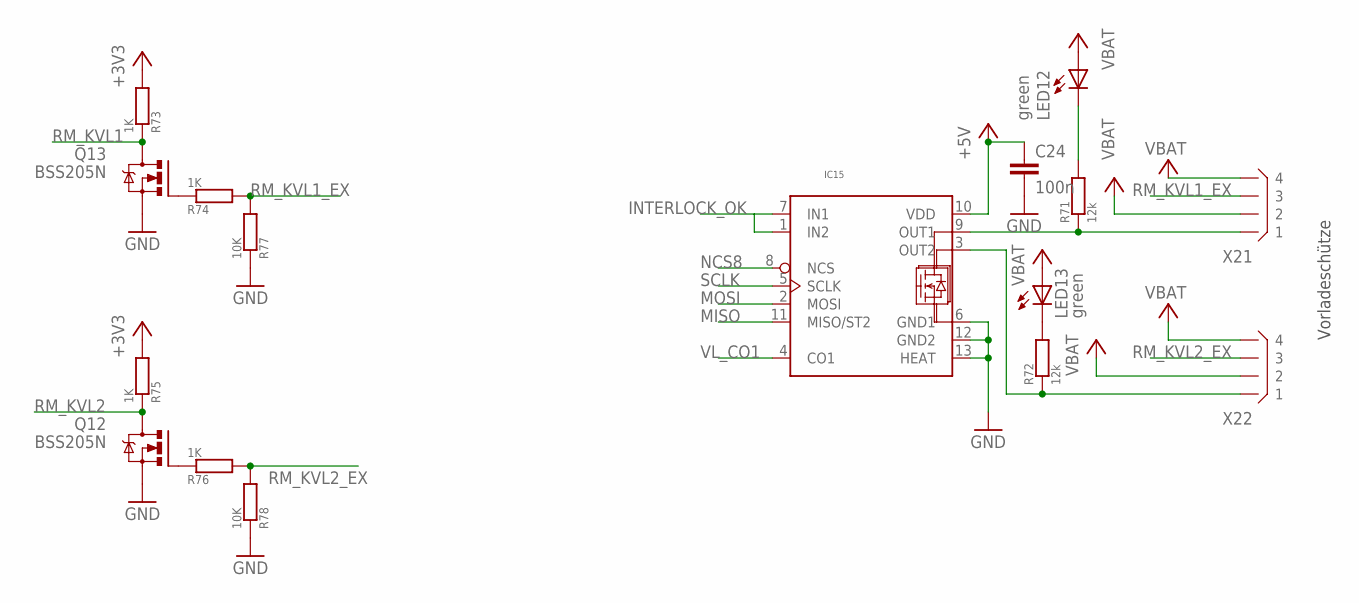
[picture p51: schematic BMS_Master.sch, sheet 6, Vorlade schütze]

Parts:
C24: 100n; C0603
IC15: TLE8102SGN; INF-PG-DSO-12-11_N_1PRIMARY
LED12, LED13: green; CHIP-LED0805
Q12, Q13: BSS205N; SOT23
R71, R72: 12k; R0805
R73, R74, R75, R76: 1K; R0805
R77, R78: 10K; R0805
X21, X22: B4B-XH

Connections:
+3V3: R73.2, R75.2; also elsewhere on the board
+5V: C24.1, IC15.10 (VDD); also elsewhere on the board
GND: C24.2, IC15.6 (GND1), IC15.12 (GND2), IC15.13 (HEAT), Q12.2 (S), Q13.2 (S), R77.1, R78.1; also elsewhere on the board
INTERLOCK_OK: IC15.1 (IN2), IC15.7 (IN1); also elsewhere on the board
MISO: IC15.11 (MISO/ST2); also elsewhere on the board
MOSI: IC15.2 (MOSI); also elsewhere on the board
unnamed: IC15.3 (OUT2), R72.1, X22.P$1 (1)
unnamed: IC15.9 (OUT1), R71.1, X21.P$1 (1)
unnamed: LED12.C, R71.2
unnamed: LED13.C, R72.2
unnamed: Q12.1 (G), R76.1
unnamed: Q13.1 (G), R74.1
NCS8: IC15.8 (NCS); also elsewhere on the board
RM_KVL1: Q13.3 (D), R73.1; also elsewhere on the board
RM_KVL1_EX: R74.2, R77.2, X21.P$3 (3)
RM_KVL2: Q12.3 (D), R75.1; also elsewhere on the board
RM_KVL2_EX: R76.2, R78.2, X22.P$3 (3)
SCLK: IC15.5 (SCLK); also elsewhere on the board
VBAT: LED12.A, LED13.A, X21.P$2 (2), X21.P$4 (4), X22.P$2 (2), X22.P$4 (4); also elsewhere on the board
VL_CO1: IC15.4 (CO1); also elsewhere on the board

Notes on the sheet:
Vorladeschütze

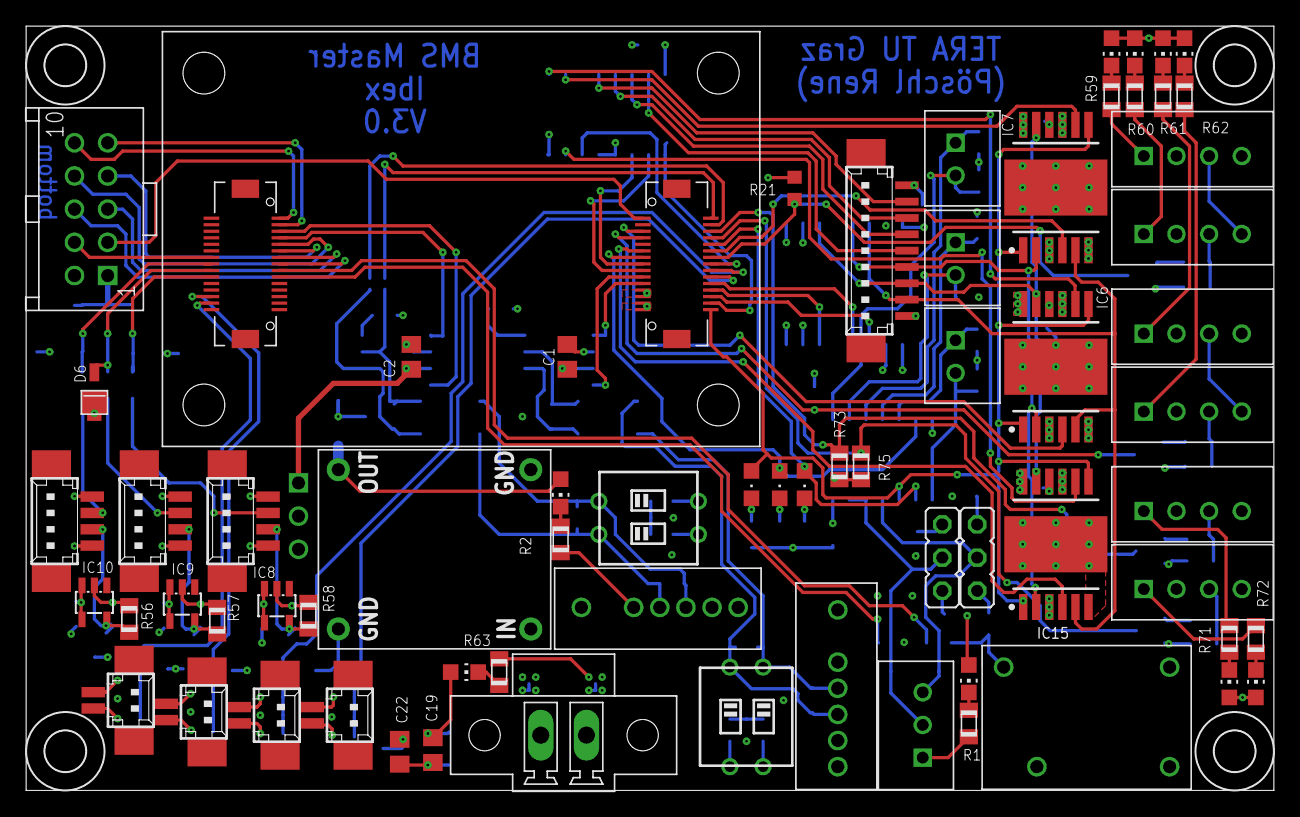
[picture p52: board HW/projects/ibex/BMS_Ibex/Master/BMS_Master_V3/BMS_Master.brd from above]

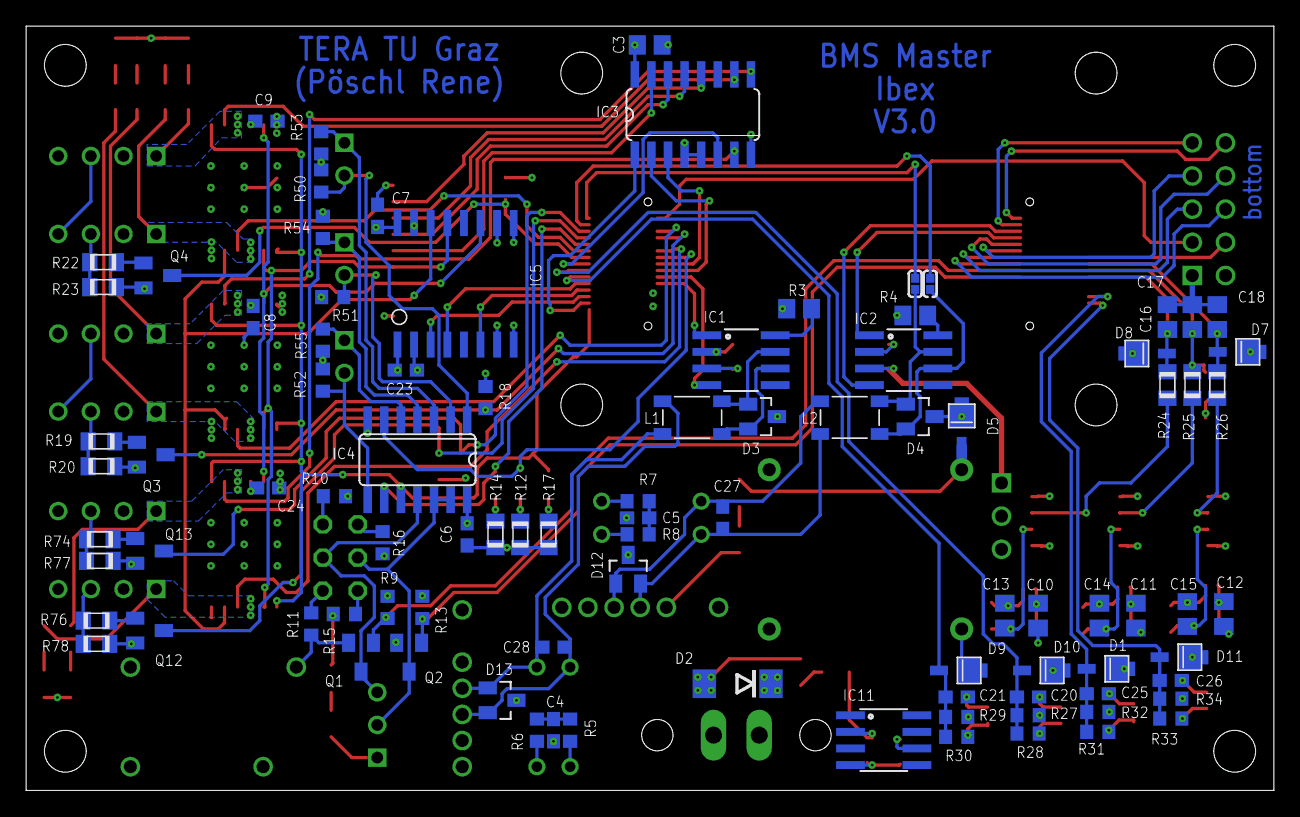
[picture p53: board HW/projects/ibex/BMS_Ibex/Master/BMS_Master_V3/BMS_Master.brd from below]

Board: 4 copper layers, 95.5 x 58.5 mm, 165 parts (93 on the bottom side), 122 nets.

Other parts of the board:
H1, H2, H3, H4: MOUNT-HOLE3.2; 3,2
