TERA-TU-Graz/BatteryManagement_2017/HW/projects/ibex/BMS_Ibex/Messboard/bms_board_V2/bms_board.brd

## EAGLE design HW/projects/ibex/BMS_Ibex/Messboard/bms_board_V2/bms_board.brd (2017-08-10, an earlier design)

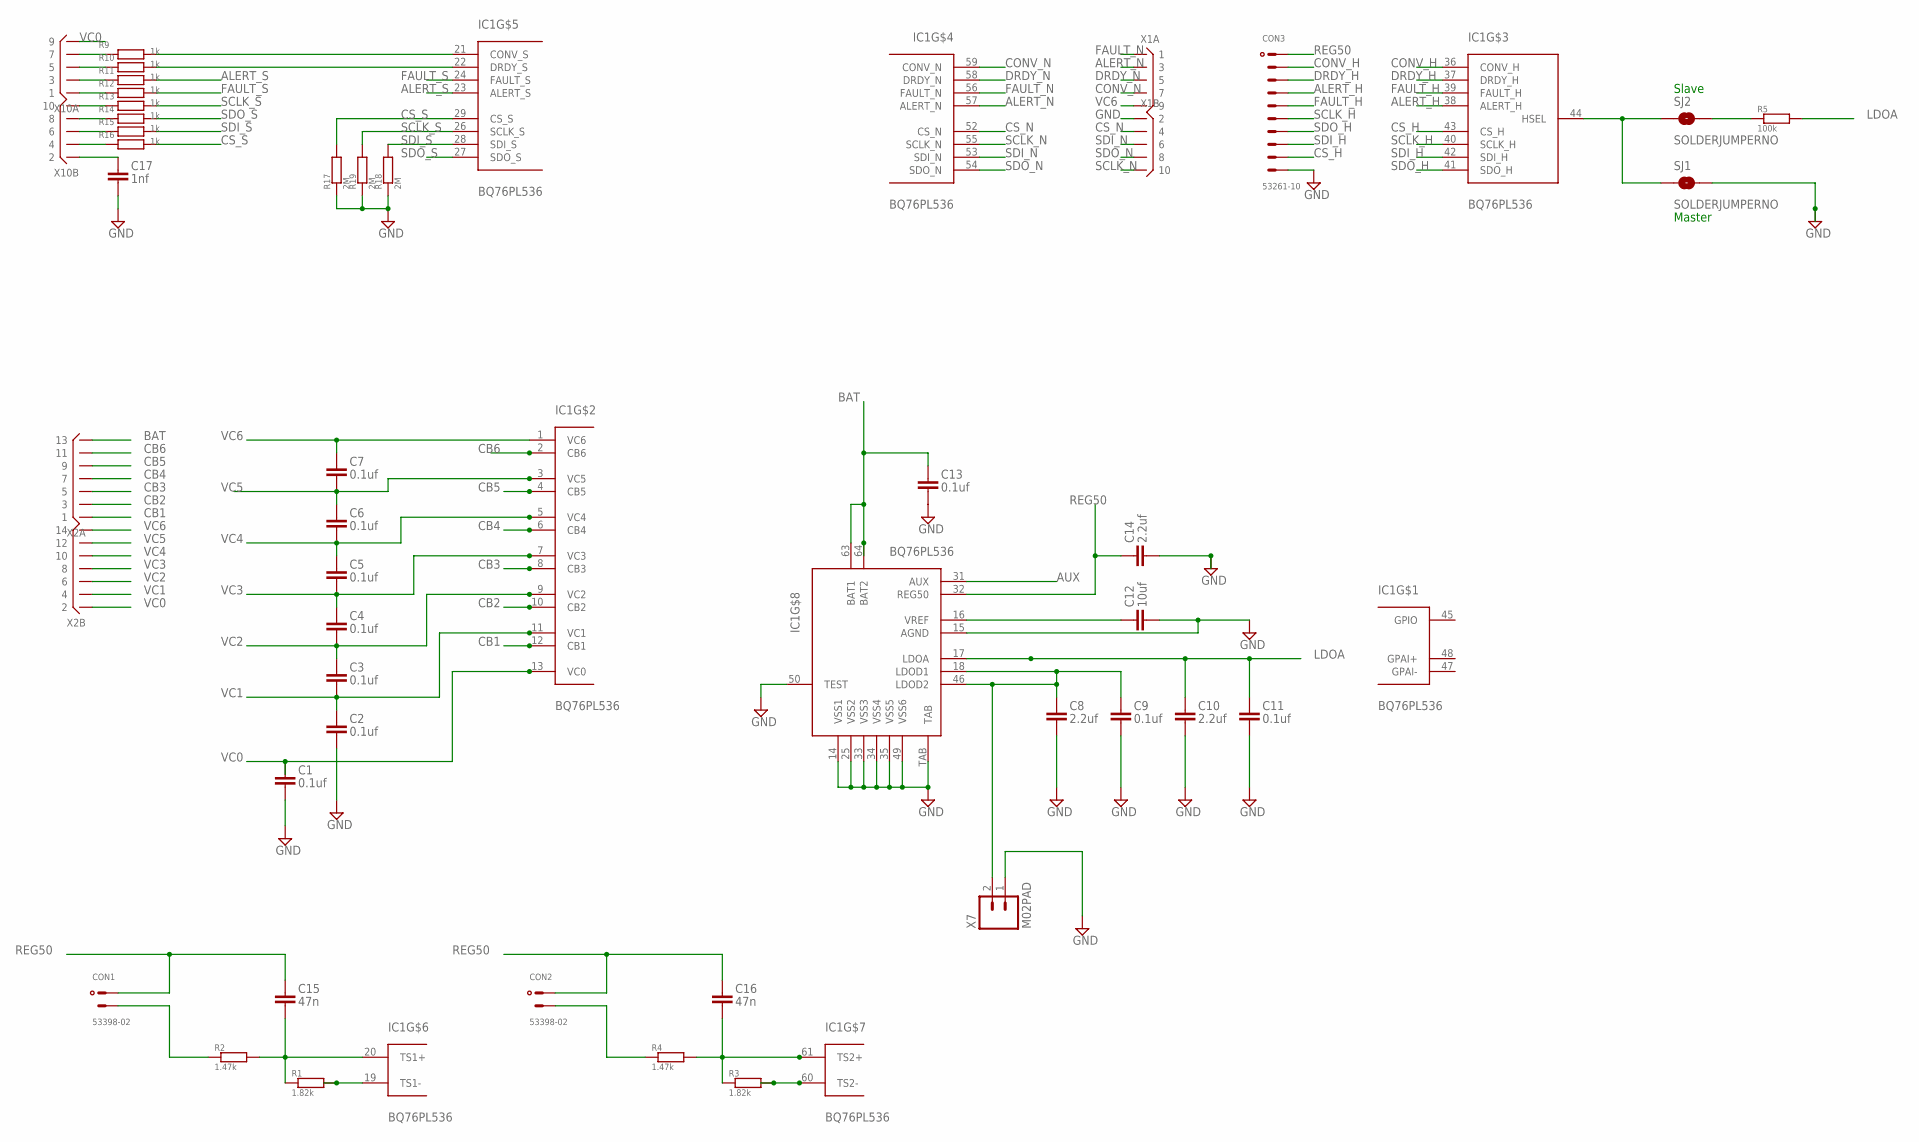
[picture p54: schematic bms_board.sch]

Parts:
C1, C2, C3, C4, C5, C6, C7, C9, C11, C13: 0.1uf; C0805
C8, C10, C14: 2.2uf; C0805
C12: 10uf; C0805
C15, C16: 47n; C0805
C17: 1nf; C0805
CON1, CON2: 53398-02
CON3: 53261-10
IC1: BQ76PL536; LQFP-64
R1, R3: 1.82k; R0805
R2, R4: 1.47k; R0805
R5: 100k; R0805
R9, R10, R11, R12, R13, R14, R15, R16: 1k; R0805
R17, R18, R19: 2M; R0805
SJ1, SJ2: SOLDERJUMPERNO; SJ_2S-NO
X1, X10: X05X2ICR; X10ICR
X2: X07X2IR; X14R-IDC
X7: M02PAD; 1X02

Connections:
ALERT_H: CON3.4, IC1.38 (ALERT_H)
ALERT_N: IC1.57 (ALERT_N), X1.3
ALERT_S: IC1.23 (ALERT_S), R11.2
AUX: IC1.31 (AUX)
BAT: C13.2, IC1.63 (BAT1), IC1.64 (BAT2), X2.13
CB1: IC1.12 (CB1), X2.1
CB2: IC1.10 (CB2), X2.3
CB3: IC1.8 (CB3), X2.5
CB4: IC1.6 (CB4), X2.7
CB5: IC1.4 (CB5), X2.9
CB6: IC1.2 (CB6), X2.11
CONV_H: CON3.2, IC1.36 (CONV_H)
CONV_N: IC1.59 (CONV_N), X1.7
CONV_S: IC1.21 (CONV_S), R9.2
CS_H: CON3.9, IC1.43 (CS_H)
CS_N: IC1.52 (CS_N), X1.4
CS_S: IC1.29 (CS_S), R16.2, R17.2
DRDY_H: CON3.3, IC1.37 (DRDY_H)
DRDY_N: IC1.58 (DRDY_N), X1.5
DRDY_S: IC1.22 (DRDY_S), R10.2
FAULT_H: CON3.5, IC1.39 (FAULT_H)
FAULT_N: IC1.56 (FAULT_N), X1.1
FAULT_S: IC1.24 (FAULT_S), R12.2
GND: C1.1, C2.1, C8.1, C9.1, C10.1, C11.1, C12.1, C13.1, C14.1, C17.1, CON3.10, IC1.14 (VSS1), IC1.15 (AGND), IC1.25 (VSS2), IC1.33 (VSS3), IC1.34 (VSS4), IC1.35 (VSS5), IC1.49 (VSS6), IC1.50 (TEST), IC1.TAB, R17.1, R18.1, R19.1, SJ1.2, X1.2, X7.1
LDOA: C10.2, C11.2, IC1.17 (LDOA), R5.2
unnamed: IC1.44 (HSEL), SJ1.1, SJ2.1
unnamed: C8.2, C9.2, IC1.18 (LDOD1), IC1.46 (LDOD2), X7.2
unnamed: C12.2, IC1.16 (VREF)
unnamed: IC1.19 (TS1-), R1.2
unnamed: CON1.2, R2.1
unnamed: C15.1, IC1.20 (TS1+), R1.1, R2.2
unnamed: IC1.60 (TS2-), R3.2
unnamed: C16.1, IC1.61 (TS2+), R3.1, R4.2
unnamed: CON2.2, R4.1
unnamed: R5.1, SJ2.2
unnamed: R16.1, X10.4
unnamed: R15.1, X10.6
unnamed: R14.1, X10.8
unnamed: R13.1, X10.10
unnamed: R12.1, X10.1
unnamed: R11.1, X10.3
unnamed: R10.1, X10.5
unnamed: R9.1, X10.7
unnamed: C17.2, X10.2
REG50: C14.2, C15.2, C16.2, CON1.1, CON2.1, CON3.1, IC1.32 (REG50)
SCLK_H: CON3.6, IC1.40 (SCLK_H)
SCLK_N: IC1.55 (SCLK_N), X1.10
SCLK_S: IC1.26 (SCLK_S), R13.2, R19.2
SDI_H: CON3.8, IC1.42 (SDI_H)
SDI_N: IC1.53 (SDI_N), X1.6
SDI_S: IC1.28 (SDI_S), R15.2, R18.2
SDO_H: CON3.7, IC1.41 (SDO_H)
SDO_N: IC1.54 (SDO_N), X1.8
SDO_S: IC1.27 (SDO_S), R14.2
VC0: C1.2, IC1.13 (VC0), X2.2, X10.9
VC1: C2.2, C3.1, IC1.11 (VC1), X2.4
VC2: C3.2, C4.1, IC1.9 (VC2), X2.6
VC3: C4.2, C5.1, IC1.7 (VC3), X2.8
VC4: C5.2, C6.1, IC1.5 (VC4), X2.10
VC5: C6.2, C7.1, IC1.3 (VC5), X2.12
VC6: C7.2, IC1.1 (VC6), X1.9, X2.14

Notes on the sheet:
Master
Slave

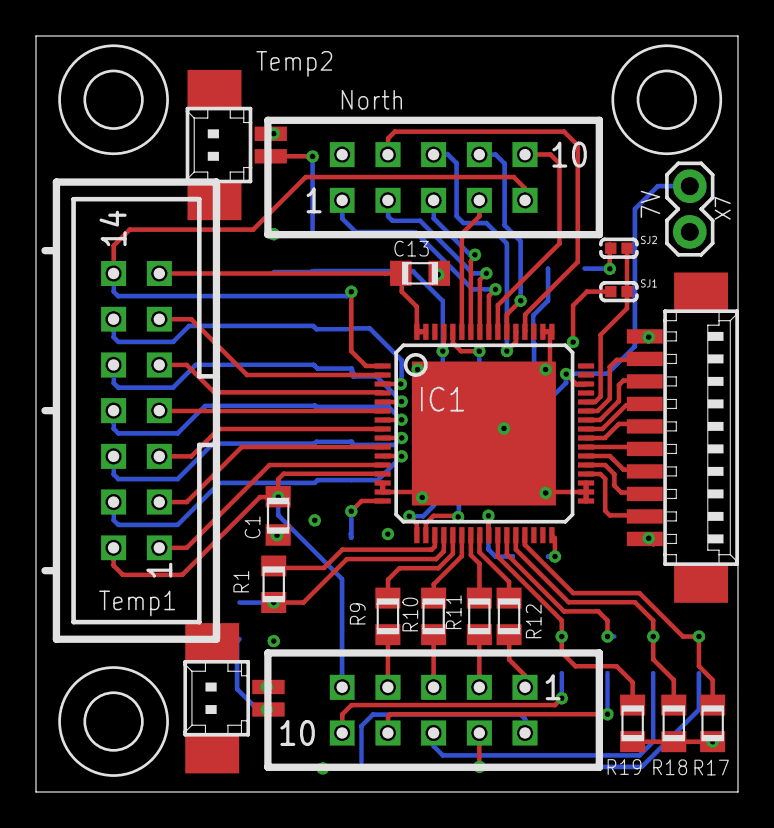
[picture p55: board bms_board.brd from above]

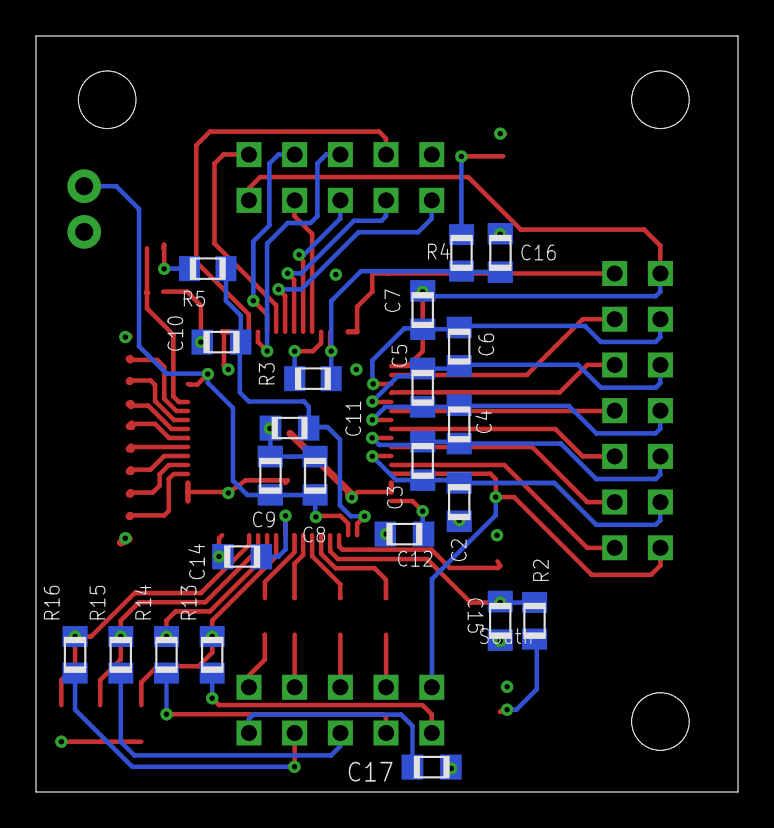
[picture p56: board bms_board.brd from below]

Board: 4 copper layers, 39.0 x 42.0 mm, 46 parts (23 on the bottom side), 60 nets.

Other parts of the board:
U$3, U$4, U$6: 3,2
