TERA-TU-Graz/BatteryManagement_2017/HW/projects/ibex/BMS_Ibex/Bus_Isolator/Bus_Isolator_V4/Bus_Isolator.brd

## EAGLE design HW/projects/ibex/BMS_Ibex/Bus_Isolator/Bus_Isolator_V4/Bus_Isolator.brd (2017-08-10)

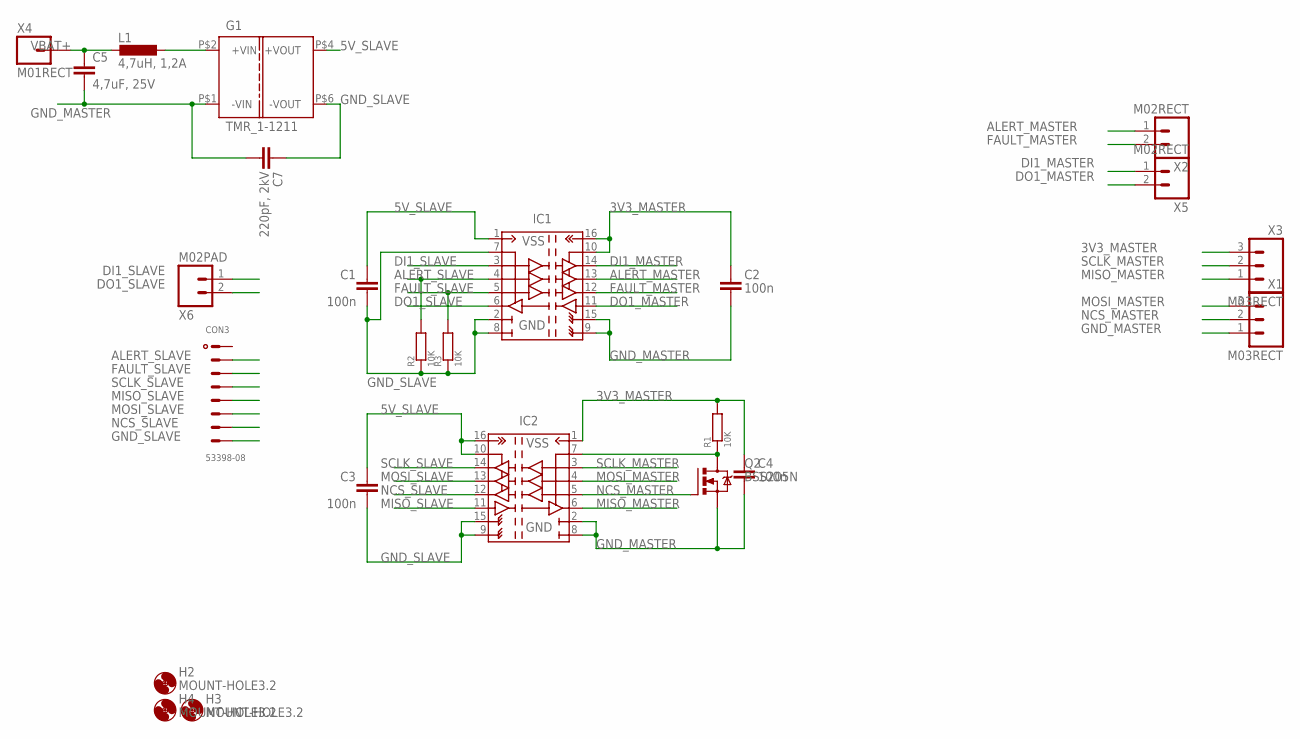
[picture p57: schematic Bus_Isolator.sch]

Parts:
C1, C2, C3, C4: 100n; C0805
C5: 4,7uF, 25V; C0805
C7: 220pF, 2kV; C1210_HV
CON3: 53398-08
G1: TMR_1-1211; TMR_1-??1?
H2, H3, H4: MOUNT-HOLE3.2; 3,2
IC1, IC2: ISO7241; R-PDSO-G16
L1: 4,7uH, 1,2A; L3225M
Q2: BSS205N; SOT23
R1: 10K; R0603
R2, R3: 10K; R0805
X1, X3: M03RECT; 1X03_RECT
X2, X5: M02RECT; 1X02_RECT
X4: M01RECT; 1X01_RECT
X6: M02PAD; 1X02

Connections:
3V3_MASTER: C2.2, C4.2, IC1.10 (EN2), IC1.16 (VCC2), IC2.1 (VCC1), R1.2, X3.3
5V_SLAVE: C1.2, C3.2, G1.P$4 (+VOUT), IC1.1 (VCC1), IC2.10 (EN2), IC2.16 (VCC2)
ALERT_MASTER: IC1.13 (OUT_B), X2.1
ALERT_SLAVE: CON3.2, IC1.4 (IN_B), R2.2
DI1_MASTER: IC1.14 (OUT_A), X5.1
DI1_SLAVE: IC1.3 (IN_A), X6.1
DO1_MASTER: IC1.11 (IN_D), X5.2
DO1_SLAVE: IC1.6 (OUT_D), X6.2
FAULT_MASTER: IC1.12 (OUT_C), X2.2
FAULT_SLAVE: CON3.3, IC1.5 (IN_C), R3.2
GND_MASTER: C2.1, C4.1, C5.2, C7.P$1 (1), G1.P$1 (-VIN), IC1.9 (GND22), IC1.15 (GND21), IC2.2 (GND11), IC2.8 (GND12), Q2.2 (S), X1.1
GND_SLAVE: C1.1, C3.1, C7.P$2 (2), CON3.8, G1.P$6 (-VOUT), IC1.2 (GND11), IC1.7 (EN1), IC1.8 (GND12), IC2.9 (GND22), IC2.15 (GND21), R2.1, R3.1
MISO_MASTER: IC2.6 (OUT_D), X3.1
MISO_SLAVE: CON3.5, IC2.11 (IN_D)
MOSI_MASTER: IC2.4 (IN_B), X1.3
MOSI_SLAVE: CON3.6, IC2.13 (OUT_B)
unnamed: IC2.7 (EN1), Q2.3 (D), R1.1
unnamed: G1.P$2 (+VIN), L1.1
NCS_MASTER: IC2.5 (IN_C), Q2.1 (G), X1.2
NCS_SLAVE: CON3.7, IC2.12 (OUT_C)
SCLK_MASTER: IC2.3 (IN_A), X3.2
SCLK_SLAVE: CON3.4, IC2.14 (OUT_A)
VBAT+: C5.1, L1.2, X4.1

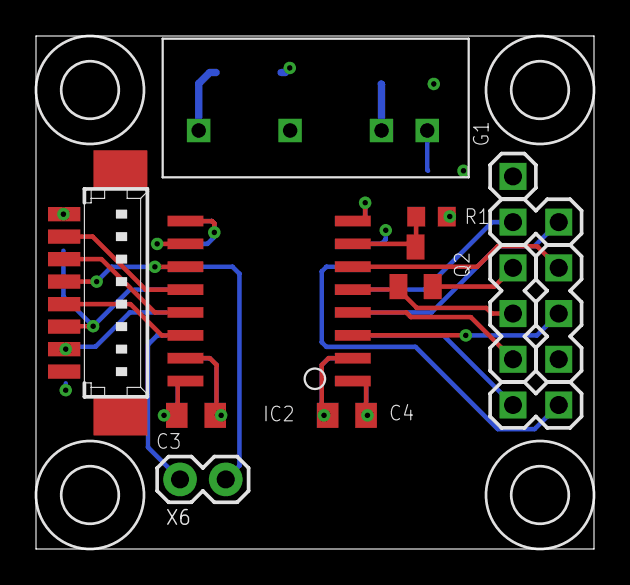
[picture p58: board HW/projects/ibex/BMS_Ibex/Bus_Isolator/Bus_Isolator_V4/Bus_Isolator.b… from above]

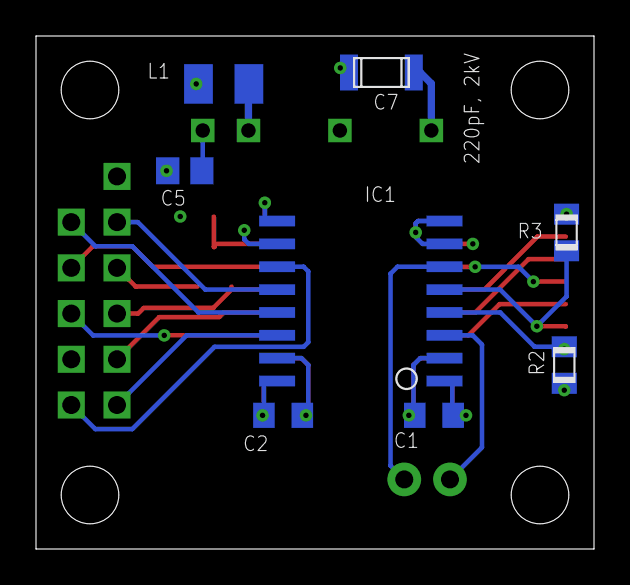
[picture p59: board HW/projects/ibex/BMS_Ibex/Bus_Isolator/Bus_Isolator_V4/Bus_Isolator.b… from below]

Board: 4 copper layers, 31.0 x 28.5 mm, 25 parts (8 on the bottom side), 23 nets.

Other parts of the board:
H1: MOUNT-HOLE3.2; 3,2
