TERA-TU-Graz/BatteryManagement_2017/HW/projects/ibex/bordnet_and_charger_interface/BordnetzwandlerV2_1/Bordnetzwandler.brd

## EAGLE design HW/projects/ibex/bordnet_and_charger_interface/BordnetzwandlerV2_1/Bordnetzwandler.brd (2017-08-10, an earlier design)

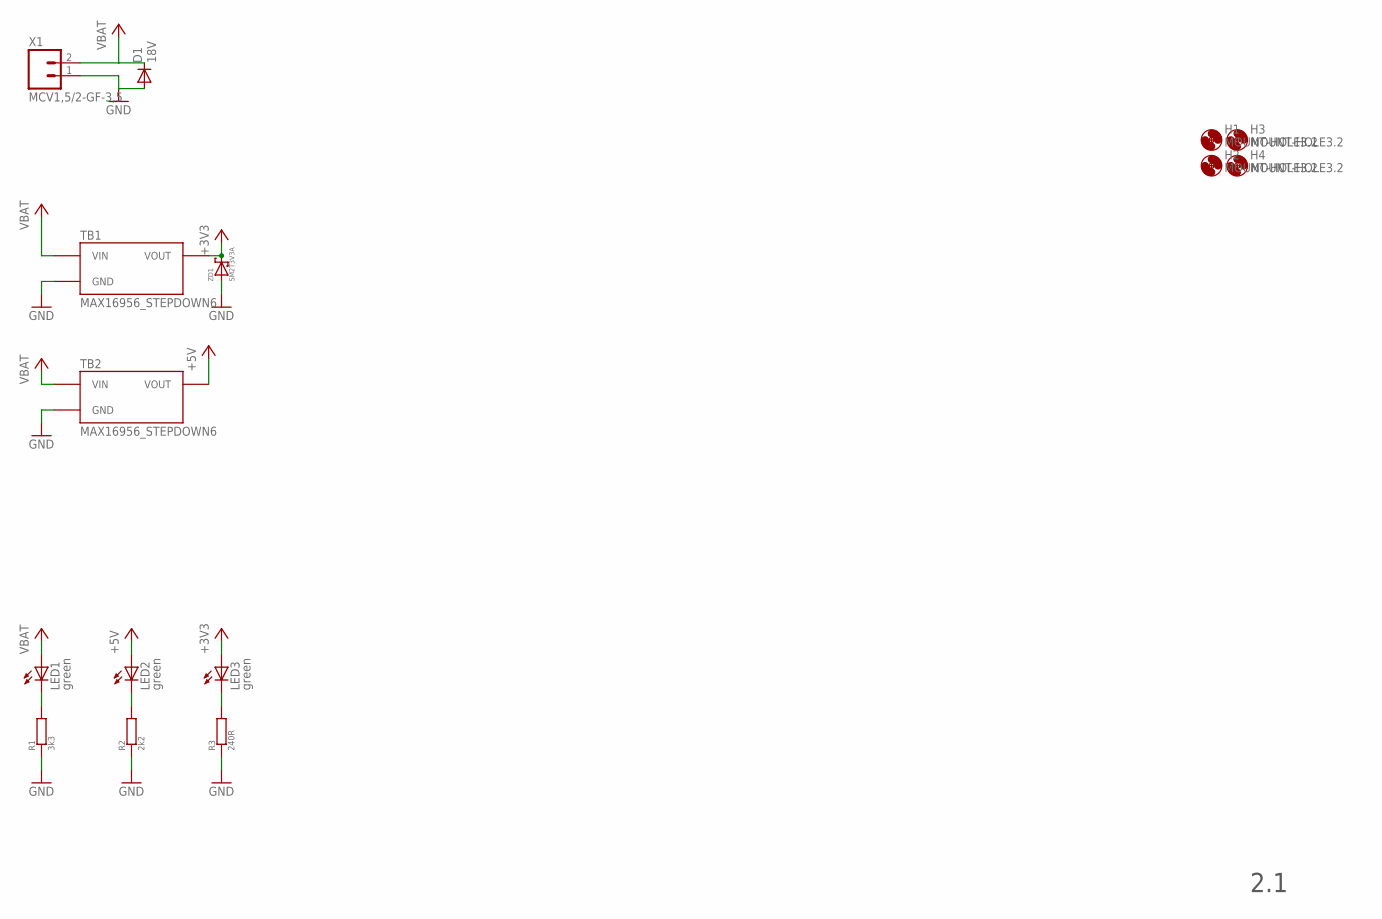
[picture p60: schematic Bordnetzwandler.sch, sheet 1, Supply]

Parts:
D1: 18V; DO214AA
H1, H2, H3, H4: MOUNT-HOLE3.2; 3,2
LED1, LED2, LED3: green; CHIP-LED0805
R1: 3k3; R0805
R2: 2k2; R0805
R3: 240R; R0805
TB1, TB2: MAX16956_STEPDOWN6
X1: MCV1,5/2-GF-3,5
ZD1: SM2T3V3A

Connections:
+3V3: LED3.A, TB1.VOUT, ZD1.P$2; also elsewhere on the board
+5V: LED2.A, TB2.VOUT; also elsewhere on the board
GND: D1.A, R1.1, R2.1, R3.1, TB1.GND, TB1.GND2 (GND), TB2.GND, TB2.GND2 (GND), X1.1, ZD1.P$1, ZD1.P$11; also elsewhere on the board
unnamed: LED2.C, R2.2
unnamed: LED3.C, R3.2
unnamed: LED1.C, R1.2
VBAT: D1.C, LED1.A, TB1.VIN, TB2.VIN, X1.2; also elsewhere on the board

Notes on the sheet:
2.1

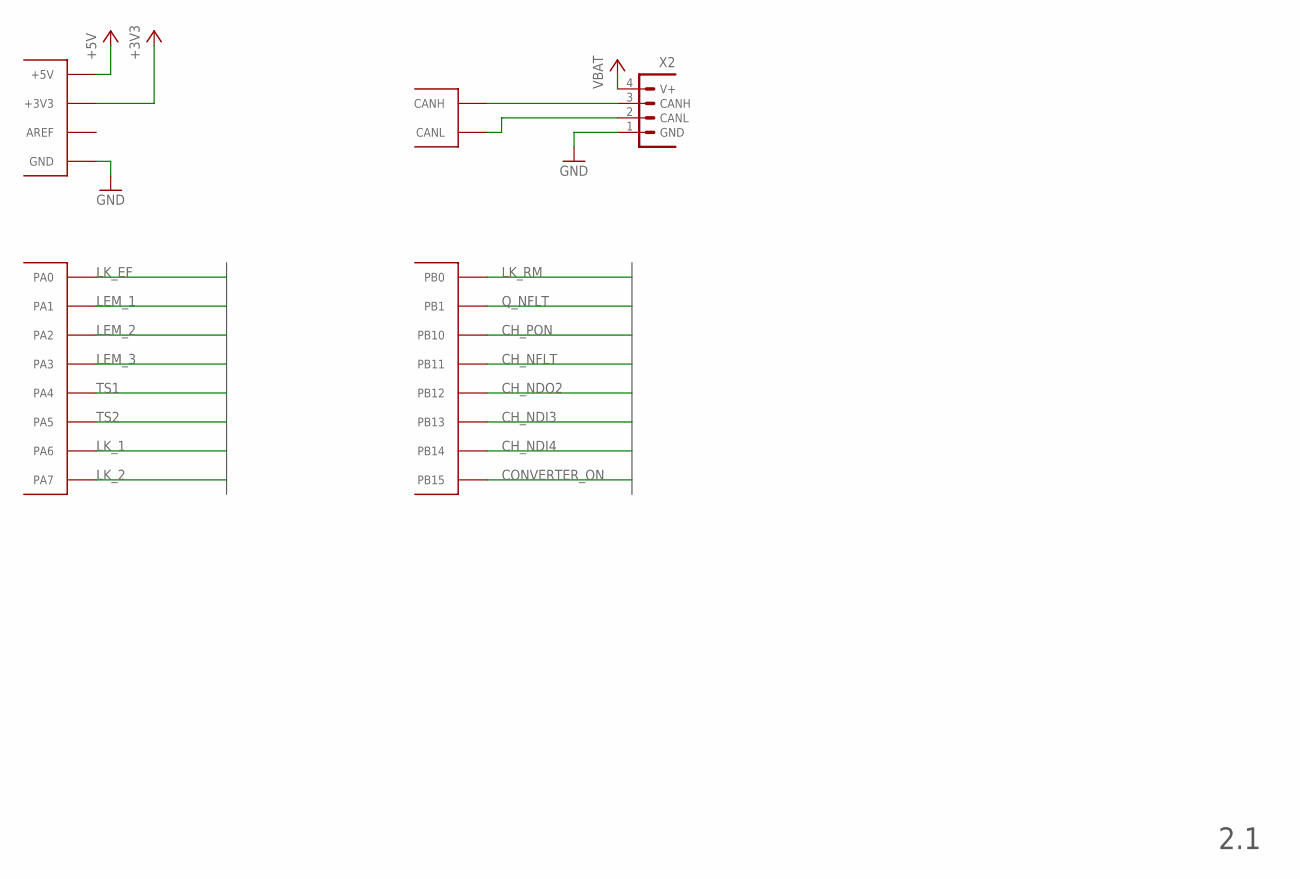
[picture p61: schematic Bordnetzwandler.sch, sheet 2, Prozessor]

Parts:
CANIO_1: STM32F103XX_CAN-IO-EXPANDER; STM32F103XX_CANIO-EXPANDER
X2: CIOC_4-1-FV-A_CAN-BELEGUNG; CIOC_4-1-FV

Connections:
+3V3: CANIO_1.VCC (+3V3); also elsewhere on the board
+5V: CANIO_1.+5V; also elsewhere on the board
CAN1_H: CANIO_1.CANH, X2.3 (CANH)
CAN1_L: CANIO_1.CANL, X2.2 (CANL)
CH_NDI3: CANIO_1.PB13; also elsewhere on the board
CH_NDI4: CANIO_1.PB14; also elsewhere on the board
CH_NDO2: CANIO_1.PB12; also elsewhere on the board
CH_NFLT: CANIO_1.PB11; also elsewhere on the board
CH_PON: CANIO_1.PB10; also elsewhere on the board
CONVERTER_ON: CANIO_1.PB15; also elsewhere on the board
GND: CANIO_1.GND1 (GND), X2.1 (GND); also elsewhere on the board
LEM_1: CANIO_1.PA1; also elsewhere on the board
LEM_2: CANIO_1.PA2; also elsewhere on the board
LEM_3: CANIO_1.PA3; also elsewhere on the board
LK_1: CANIO_1.PA6; also elsewhere on the board
LK_2: CANIO_1.PA7; also elsewhere on the board
LK_EF: CANIO_1.PA0; also elsewhere on the board
LK_RM: CANIO_1.PB0; also elsewhere on the board
Q_NFLT: CANIO_1.PB1; also elsewhere on the board
TS1: CANIO_1.PA4; also elsewhere on the board
TS2: CANIO_1.PA5; also elsewhere on the board
VBAT: X2.4 (V+); also elsewhere on the board

Notes on the sheet:
2.1

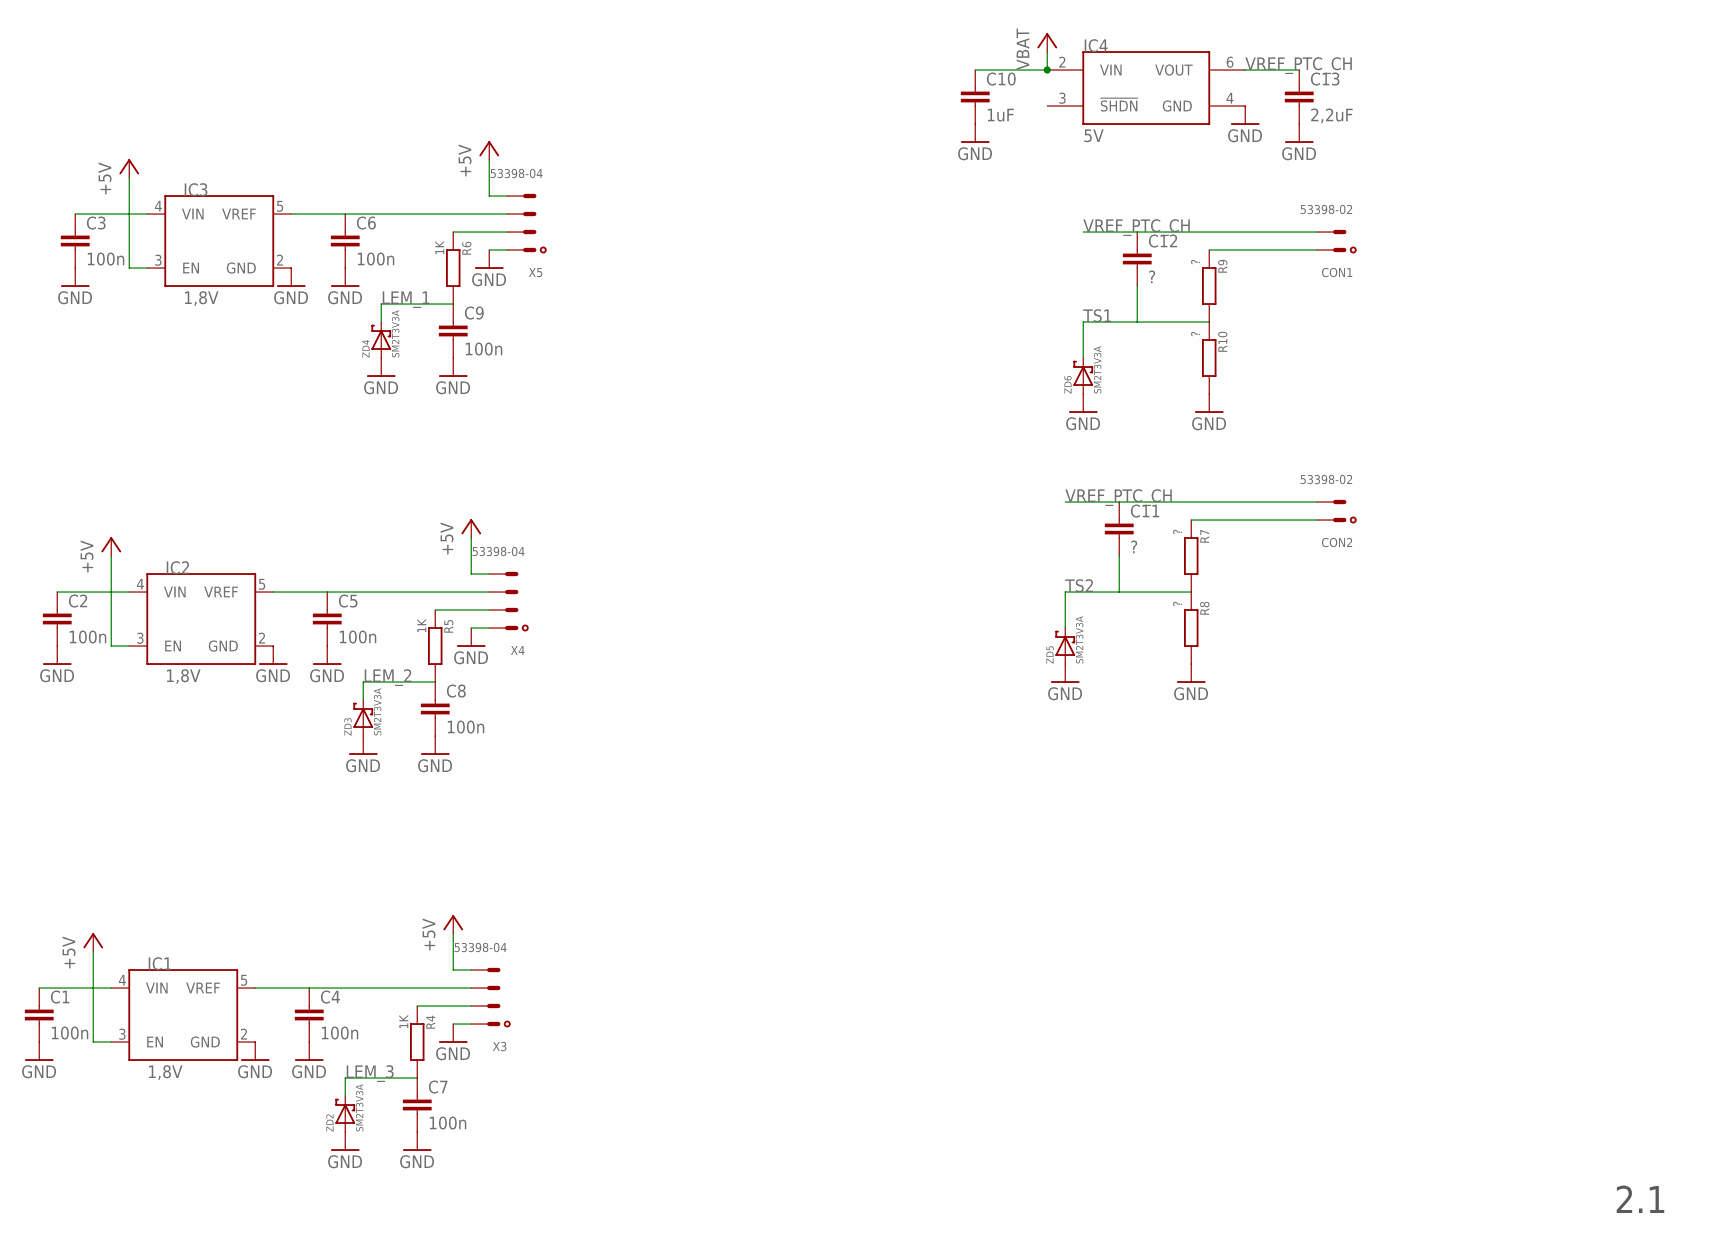
[picture p62: schematic Bordnetzwandler.sch, sheet 3, IO]

Parts:
C1, C2, C3, C4, C5, C6, C7, C8, C9: 100n; C0805
C10: 1uF; C0805
C11, C12: ?; C0805
C13: 2,2uF; C0805
CON1, CON2: 53398-02
IC1, IC2, IC3: 1,8V; SOT23-5L
IC4: 5V; SO08
R4, R5, R6: 1K; R0805
R7, R8, R9, R10: ?; R0805
X3, X4, X5: 53398-04
ZD2, ZD3, ZD4, ZD5, ZD6: SM2T3V3A

Connections:
+5V: C1.1, C2.1, C3.1, IC1.3 (EN), IC1.4 (VIN), IC2.3 (EN), IC2.4 (VIN), IC3.3 (EN), IC3.4 (VIN), X3.4, X4.4, X5.4; also elsewhere on the board
GND: C1.2, C2.2, C3.2, C4.2, C5.2, C6.2, C7.2, C8.2, C9.2, C10.2, C13.2, IC1.2 (GND), IC2.2 (GND), IC3.2 (GND), IC4.4 (GND), R8.2, R10.2, X3.1, X4.1, X5.1, ZD2.P$1, ZD2.P$11, ZD3.P$1, ZD3.P$11, ZD4.P$1, ZD4.P$11, ZD5.P$1, ZD5.P$11, ZD6.P$1, ZD6.P$11; also elsewhere on the board
LEM_1: C9.1, R6.2, ZD4.P$2; also elsewhere on the board
LEM_2: C8.1, R5.2, ZD3.P$2; also elsewhere on the board
LEM_3: C7.1, R4.2, ZD2.P$2; also elsewhere on the board
unnamed: C4.1, IC1.5 (VREF), X3.3
unnamed: R6.1, X5.2
unnamed: C5.1, IC2.5 (VREF), X4.3
unnamed: CON1.1, R9.1
unnamed: R5.1, X4.2
unnamed: C6.1, IC3.5 (VREF), X5.3
unnamed: R4.1, X3.2
unnamed: CON2.1, R7.1
TS1: C12.2, R9.2, R10.1, ZD6.P$2; also elsewhere on the board
TS2: C11.2, R7.2, R8.1, ZD5.P$2; also elsewhere on the board
VBAT: C10.1, IC4.2 (VIN); also elsewhere on the board
VREF_PTC_CH: C11.1, C12.1, C13.1, CON1.2, CON2.2, IC4.6 (VOUT)

Notes on the sheet:
2.1

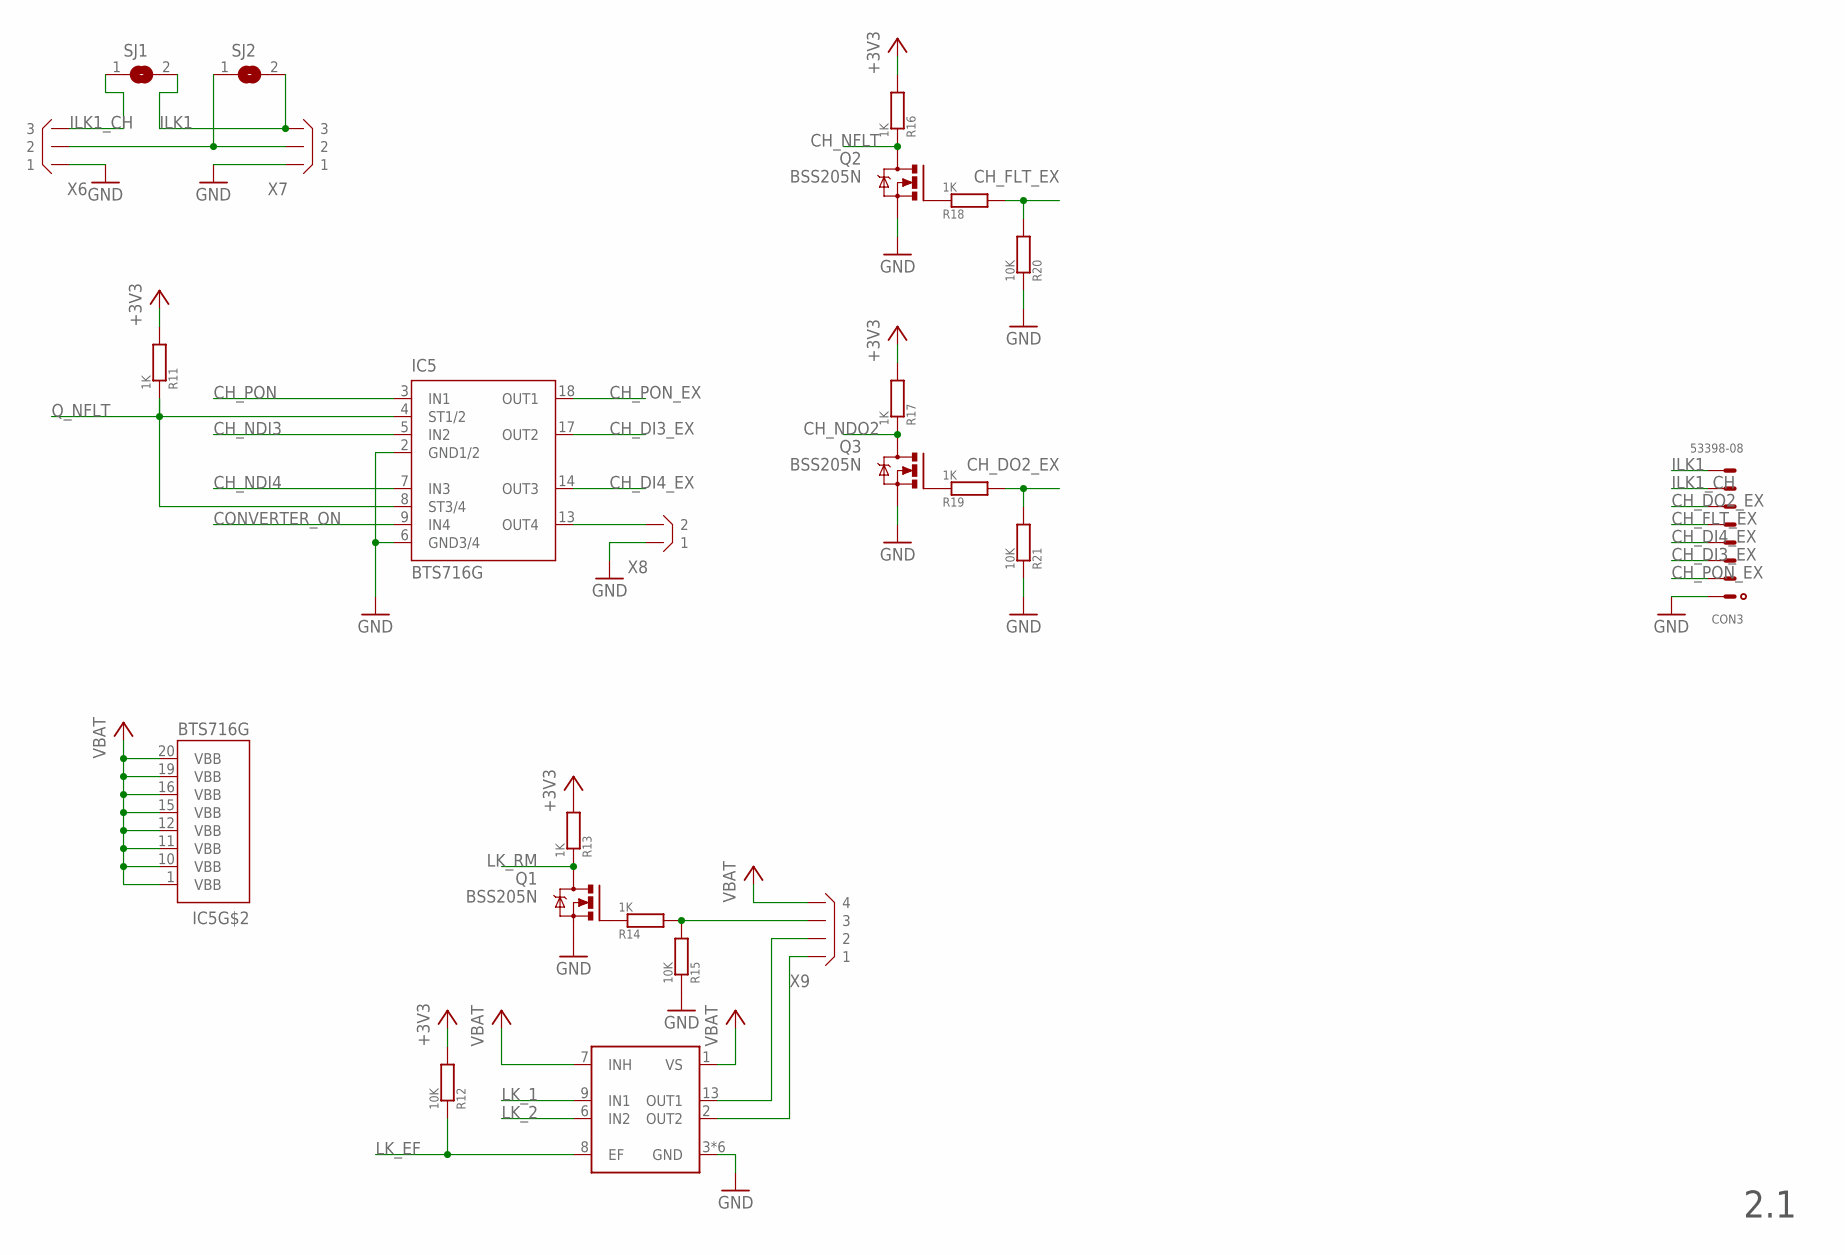
[picture p63: schematic Bordnetzwandler.sch, sheet 4, Laderegler und Ladestecker]

Parts:
CON3: 53398-08
IC5: BTS716G; PG-DSO-20
IC6: TLE4207GN; INF-PG-DSO-14-22_N_1PRIMARY
Q1, Q2, Q3: BSS205N; SOT23
R11, R16, R17, R18, R19: 1K; R0603
R12, R15: 10K; R0805
R13, R14: 1K; R0805
R20, R21: 10K; R0603
SJ1, SJ2: SJ
X6, X7: B3B-XH
X8: B2B-XH
X9: B4B-XH

Connections:
+3V3: R11.2, R12.2, R13.2, R16.2, R17.2; also elsewhere on the board
CH_DI3_EX: CON3.3, IC5.17 (OUT2)
CH_DI4_EX: CON3.4, IC5.14 (OUT3)
CH_DO2_EX: CON3.6, R19.2, R21.2
CH_FLT_EX: CON3.5, R18.2, R20.2
CH_NDI3: IC5.5 (IN2); also elsewhere on the board
CH_NDI4: IC5.7 (IN3); also elsewhere on the board
CH_NDO2: Q3.3 (D), R17.1; also elsewhere on the board
CH_NFLT: Q2.3 (D), R16.1; also elsewhere on the board
CH_PON: IC5.3 (IN1); also elsewhere on the board
CH_PON_EX: CON3.2, IC5.18 (OUT1)
CONVERTER_ON: IC5.9 (IN4); also elsewhere on the board
GND: CON3.1, IC5.2 (GND1/2), IC5.6 (GND3/4), IC6.3 (GND), IC6.4 (GND), IC6.5 (GND), IC6.10 (GND), IC6.11 (GND), IC6.12 (GND), Q1.2 (S), Q2.2 (S), Q3.2 (S), R15.1, R20.1, R21.1, X6.P$1 (1), X7.P$1 (1), X8.P$1 (1); also elsewhere on the board
ILK1: CON3.8, SJ1.2, SJ2.2, X7.P$3 (3)
ILK1_CH: CON3.7, SJ1.1, X6.P$3 (3)
ILK2: SJ2.1, X6.P$2 (2), X7.P$2 (2)
LK_1: IC6.9 (IN1); also elsewhere on the board
LK_2: IC6.6 (IN2); also elsewhere on the board
LK_EF: IC6.8 (EF), R12.1; also elsewhere on the board
LK_RM: Q1.3 (D), R13.1; also elsewhere on the board
unnamed: IC5.13 (OUT4), X8.P$2 (2)
unnamed: Q3.1 (G), R19.1
unnamed: Q1.1 (G), R14.1
unnamed: R14.2, R15.2, X9.P$3 (3)
unnamed: IC6.13 (OUT1), X9.P$2 (2)
unnamed: IC6.2 (OUT2), X9.P$1 (1)
unnamed: Q2.1 (G), R18.1
Q_NFLT: IC5.4 (ST1/2), IC5.8 (ST3/4), R11.1; also elsewhere on the board
VBAT: IC5.1 (VBB), IC5.10 (VBB), IC5.11 (VBB), IC5.12 (VBB), IC5.15 (VBB), IC5.16 (VBB), IC5.19 (VBB), IC5.20 (VBB), IC6.1 (VS), IC6.7 (INH), X9.P$4 (4); also elsewhere on the board

Notes on the sheet:
2.1

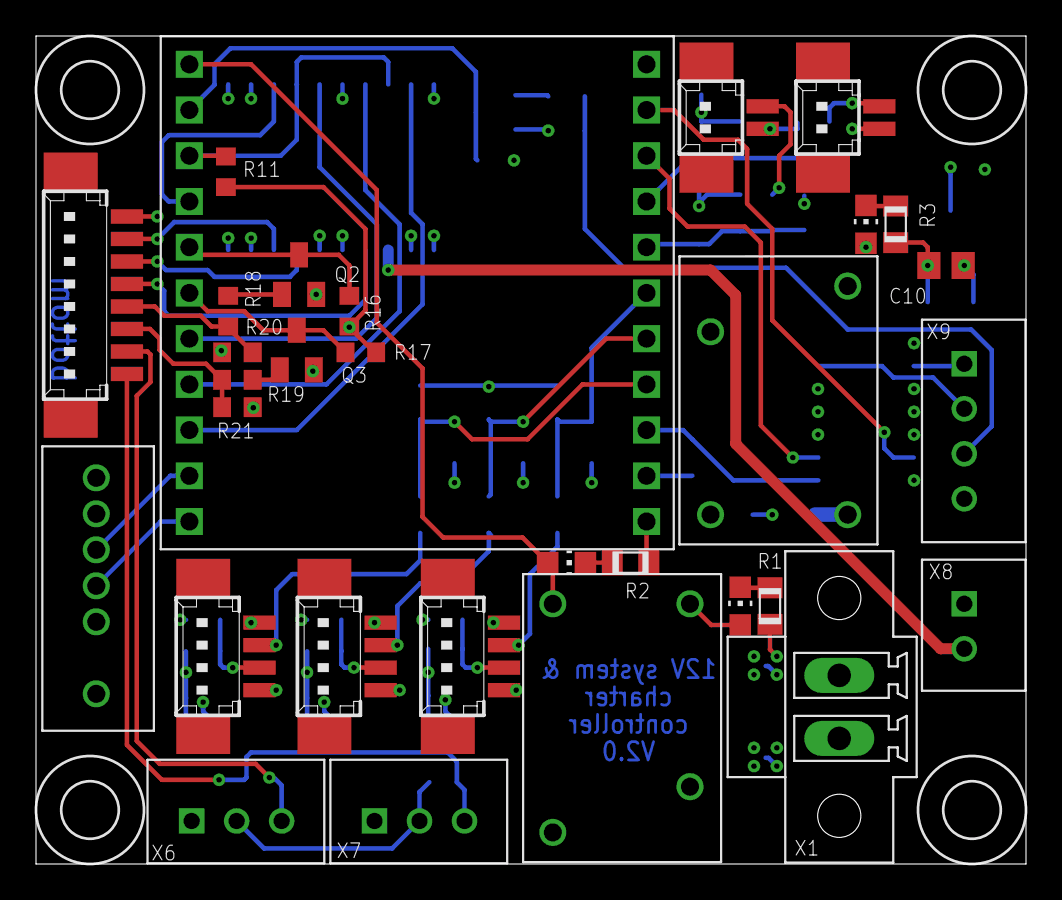
[picture p64: board HW/projects/ibex/bordnet_and_charger_interface/BordnetzwandlerV2_1/Bo… from above]

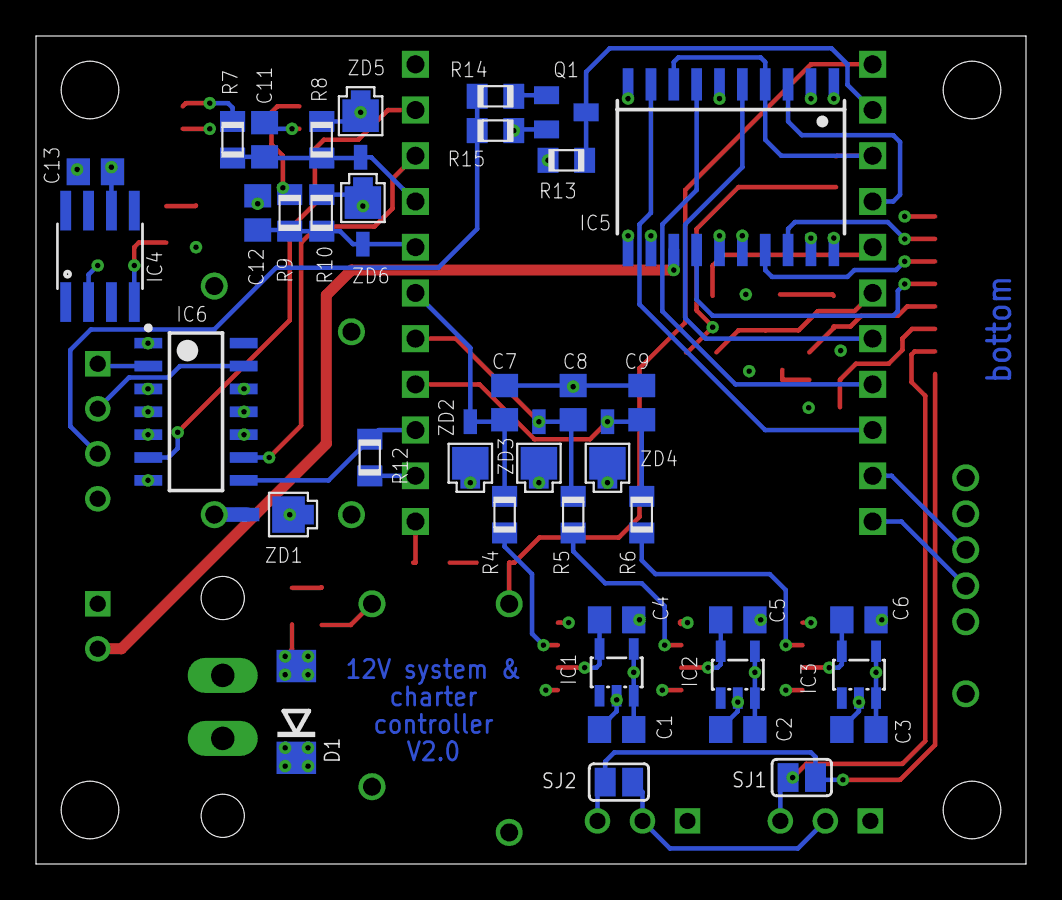
[picture p65: board HW/projects/ibex/bordnet_and_charger_interface/BordnetzwandlerV2_1/Bo… from below]

Board: 4 copper layers, 55.0 x 46.0 mm, 74 parts (39 on the bottom side), 49 nets.
