TERA-TU-Graz/BatteryManagement_2017/HW/projects/ibex/BMS_Ibex/Balancer/bms_balance_v1/balance.brd

## EAGLE design HW/projects/ibex/BMS_Ibex/Balancer/bms_balance_v1/balance.brd (2017-08-10, an earlier design)

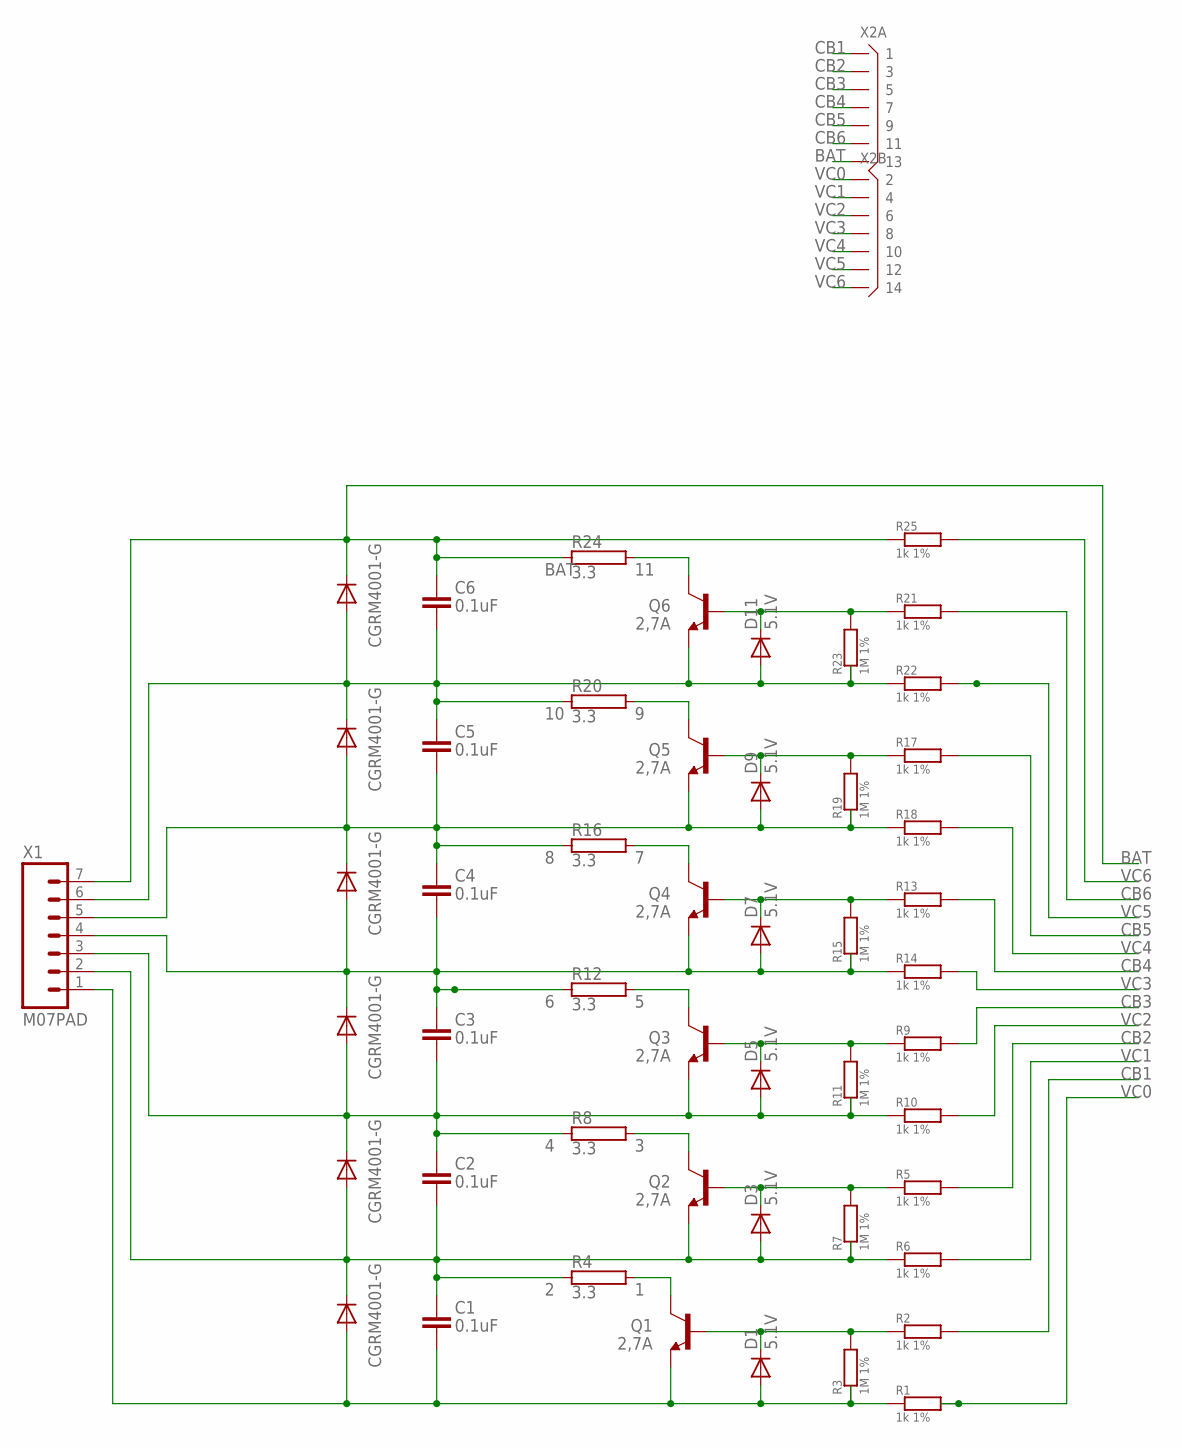
[picture p66: schematic balance.sch]

Parts:
C1, C2, C3, C4, C5, C6: 0.1uF; C0805
D1, D3, D5, D7, D9, D11: 5.1V; SOD-323
D2, D4, D6, D8, D10, D12: CGRM4001-G; SOD-123_MINI-SMA
Q1, Q2, Q3, Q4, Q5, Q6: 2,7A; SOT23
R1, R2, R5, R6, R9, R10, R13, R14, R17, R18, R21, R22, R25: 1k 1%; R0805
R3, R7, R11, R15, R19, R23: 1M 1%; R0805
R4, R8, R12, R16, R20, R24: 3.3; HS15
X1: M07PAD; 1X07
X2: X07X2IR; X14R-IDC

Connections:
1: Q1.3 (C), R4.2
2: C1.2, C2.1, D2.C, D3.2 (A), D4.A, Q2.2 (E), R4.1, R6.1, R7.1, X1.2
3: Q2.3 (C), R8.2
4: C2.2, C3.1, D4.C, D5.2 (A), D6.A, Q3.2 (E), R8.1, R10.1, R11.1, X1.3
5: Q3.3 (C), R12.2
6: C3.2, C4.1, D6.C, D7.2 (A), D8.A, Q4.2 (E), R12.1, R14.1, R15.1, X1.4
7: Q4.3 (C), R16.2
8: C4.2, C5.1, D8.C, D9.2 (A), D10.A, Q5.2 (E), R16.1, R18.1, R19.1, X1.5
9: Q5.3 (C), R20.2
10: C5.2, C6.1, D10.C, D11.2 (A), D12.A, Q6.2 (E), R20.1, R22.1, R23.1, X1.6
11: Q6.3 (C), R24.2
BAT: C6.2, D12.C, R24.1, R25.1, X1.7, X2.13
CB1: R2.2, X2.1
CB2: R5.2, X2.3
CB3: R9.2, X2.5
CB4: R13.2, X2.7
CB5: R17.2, X2.9
CB6: R21.2, X2.11
unnamed: D1.1 (C), Q1.1 (B), R2.1, R3.2
unnamed: D3.1 (C), Q2.1 (B), R5.1, R7.2
unnamed: D5.1 (C), Q3.1 (B), R9.1, R11.2
unnamed: D7.1 (C), Q4.1 (B), R13.1, R15.2
unnamed: D9.1 (C), Q5.1 (B), R17.1, R19.2
unnamed: D11.1 (C), Q6.1 (B), R21.1, R23.2
unnamed: C1.1, D1.2 (A), D2.A, Q1.2 (E), R1.1, R3.1, X1.1
VC0: R1.2, X2.2
VC1: R6.2, X2.4
VC2: R10.2, X2.6
VC3: R14.2, X2.8
VC4: R18.2, X2.10
VC5: R22.2, X2.12
VC6: R25.2, X2.14

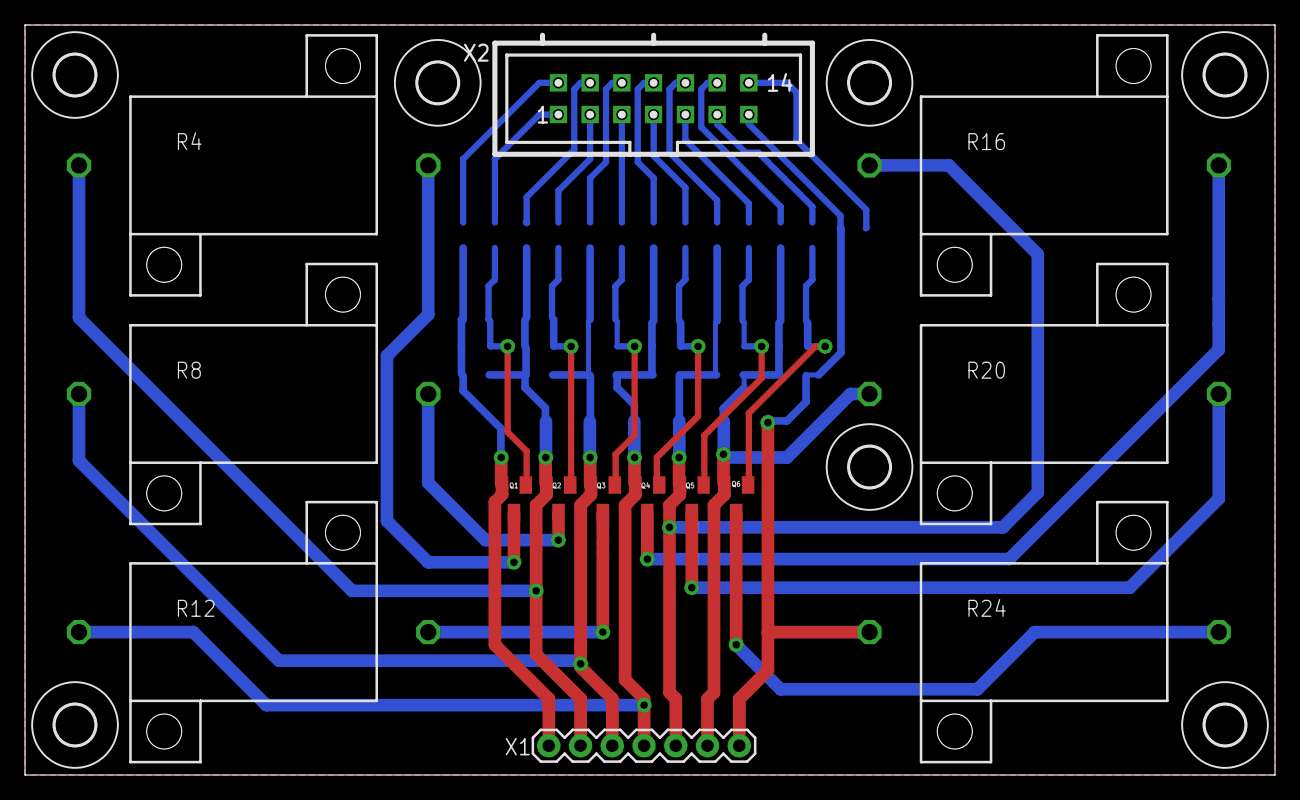
[picture p67: board HW/projects/ibex/BMS_Ibex/Balancer/bms_balance_v1/balance.brd from above]

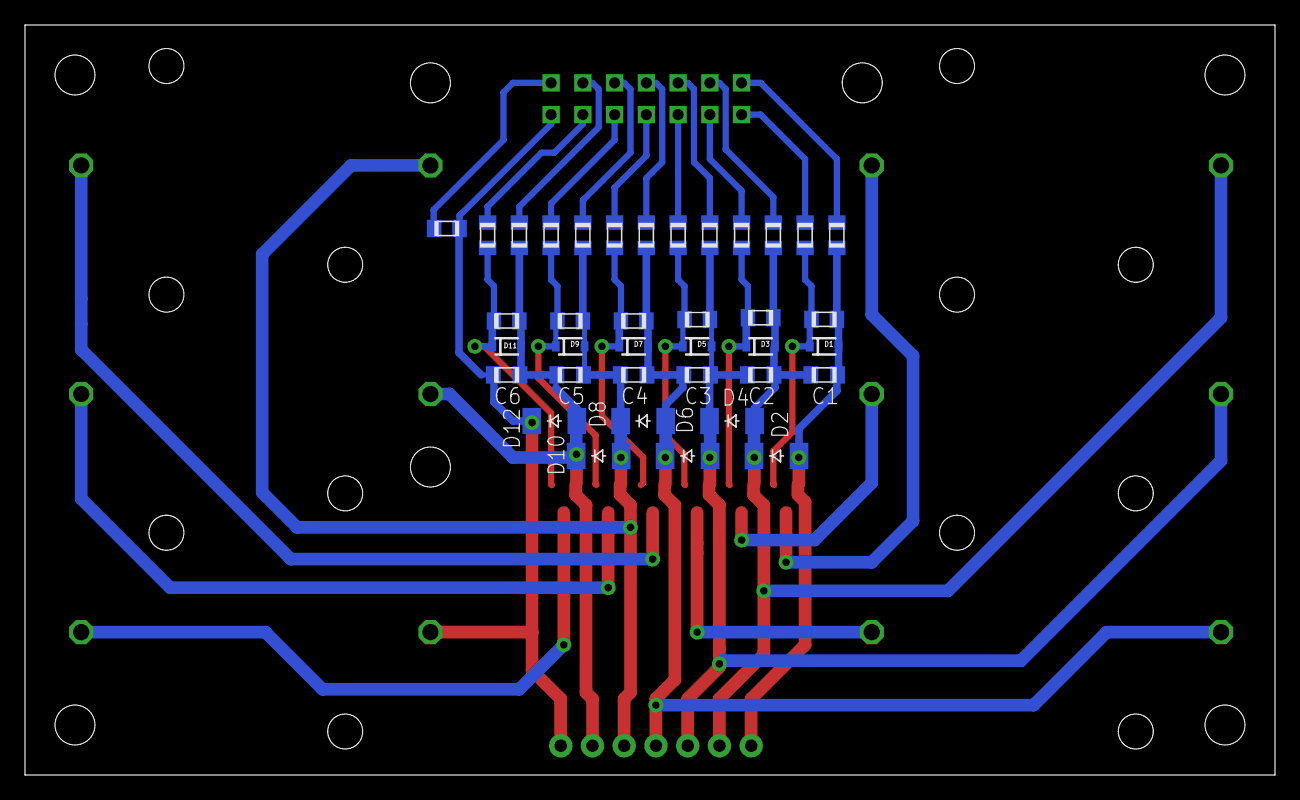
[picture p68: board HW/projects/ibex/BMS_Ibex/Balancer/bms_balance_v1/balance.brd from below]

Board: 4 copper layers, 100.0 x 60.0 mm, 58 parts (37 on the bottom side), 32 nets.

Other parts of the board:
U$1, U$2, U$3, U$4, U$5, U$6, U$7: 3,2
