TERA-TU-Graz/BatteryManagement_2017/HW/projects/ibex/bordnet_and_charger_interface/BordnetzwandlerV3/charger_and_dc_dc_ctrl.brd

## EAGLE design HW/projects/ibex/bordnet_and_charger_interface/BordnetzwandlerV3/charger_and_dc_dc_ctrl.brd (2017-08-10)

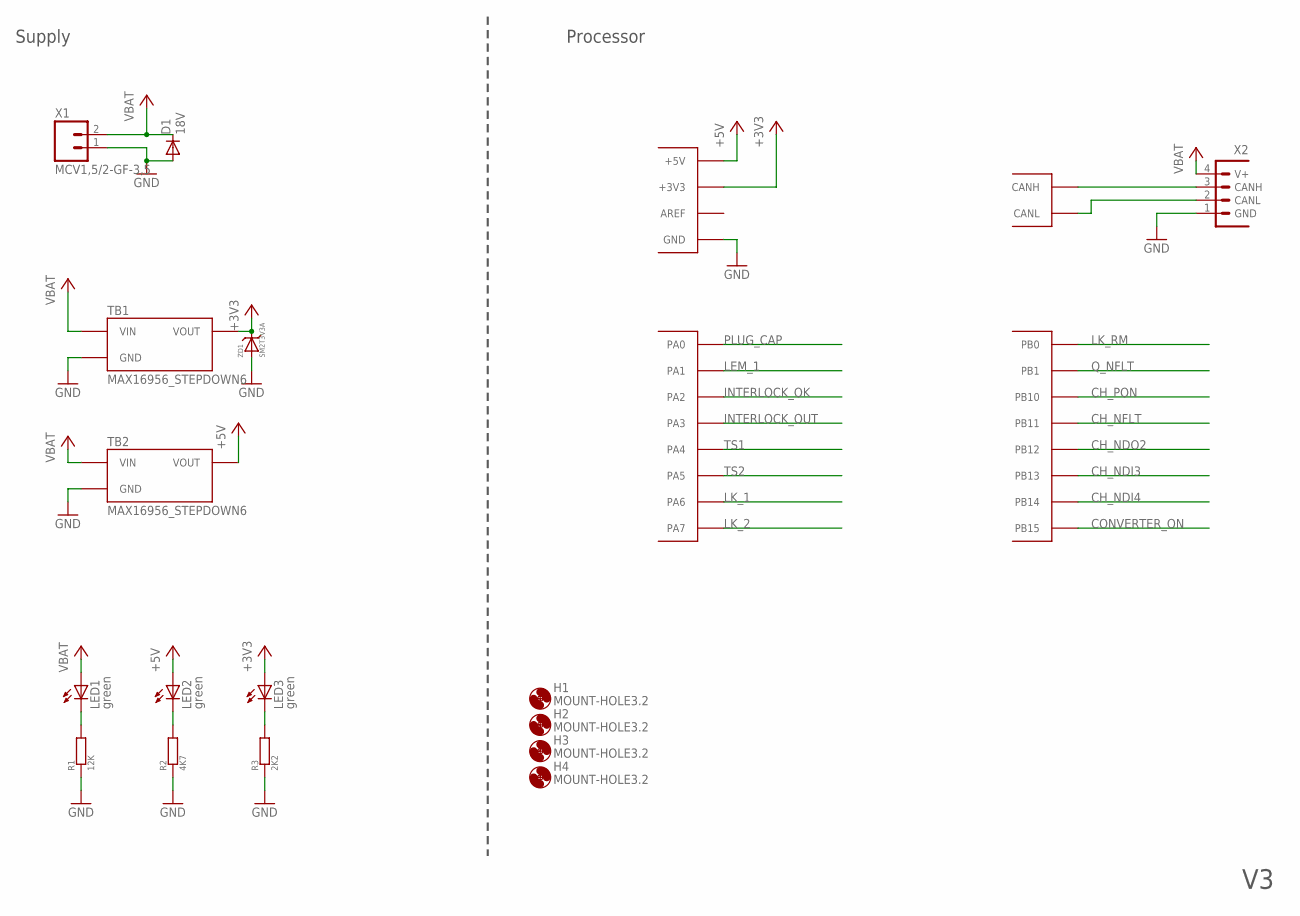
[picture p69: schematic charger_and_dc_dc_ctrl.sch, sheet 1, Processor and Supply]

Parts:
CANIO_1: STM32F103XX_CAN-IO-EXPANDERC; STM32F103XX_CANIO-EXPANDER3
D1: 18V; DO214AA
H1, H2, H3, H4: MOUNT-HOLE3.2; 3,2
LED1, LED2, LED3: green; CHIP-LED0805
R1: 12K; R0805
R2: 4K7; R0805
R3: 2K2; R0805
TB1, TB2: MAX16956_STEPDOWN6
X1: MCV1,5/2-GF-3,5
X2: CIOC_4-1-FV-A_CAN-BELEGUNG; CIOC_4-1-FV
ZD1: SM2T3V3A

Connections:
+3V3: CANIO_1.VCC (+3V3), LED3.A, TB1.VOUT, ZD1.P$2; also elsewhere on the board
+5V: CANIO_1.+5V, LED2.A, TB2.VOUT; also elsewhere on the board
CAN1_H: CANIO_1.CANH, X2.3 (CANH)
CAN1_L: CANIO_1.CANL, X2.2 (CANL)
CH_NDI3: CANIO_1.PB13; also elsewhere on the board
CH_NDI4: CANIO_1.PB14; also elsewhere on the board
CH_NDO2: CANIO_1.PB12; also elsewhere on the board
CH_NFLT: CANIO_1.PB11; also elsewhere on the board
CH_PON: CANIO_1.PB10; also elsewhere on the board
CONVERTER_ON: CANIO_1.PB15; also elsewhere on the board
GND: CANIO_1.GND1 (GND), D1.A, R1.1, R2.1, R3.1, TB1.GND, TB1.GND2 (GND), TB2.GND, TB2.GND2 (GND), X1.1, X2.1 (GND), ZD1.P$1, ZD1.P$11; also elsewhere on the board
INTERLOCK_OK: CANIO_1.PA2; also elsewhere on the board
INTERLOCK_OUT: CANIO_1.PA3; also elsewhere on the board
LEM_1: CANIO_1.PA1; also elsewhere on the board
LK_1: CANIO_1.PA6; also elsewhere on the board
LK_2: CANIO_1.PA7; also elsewhere on the board
LK_RM: CANIO_1.PB0; also elsewhere on the board
unnamed: LED2.C, R2.2
unnamed: LED3.C, R3.2
unnamed: LED1.C, R1.2
PLUG_CAP: CANIO_1.PA0; also elsewhere on the board
Q_NFLT: CANIO_1.PB1; also elsewhere on the board
TS1: CANIO_1.PA4; also elsewhere on the board
TS2: CANIO_1.PA5; also elsewhere on the board
VBAT: D1.C, LED1.A, TB1.VIN, TB2.VIN, X1.2, X2.4 (V+); also elsewhere on the board

Notes on the sheet:
Supply
Processor
