TERA-TU-Graz/BatteryManagement_2017/HW/projects/ibex/bordnet_and_charger_interface/BordnetzwandlerV3/charger_and_dc_dc_ctrl.brd

## EAGLE design HW/projects/ibex/bordnet_and_charger_interface/BordnetzwandlerV3/charger_and_dc_dc_ctrl.brd (continued)

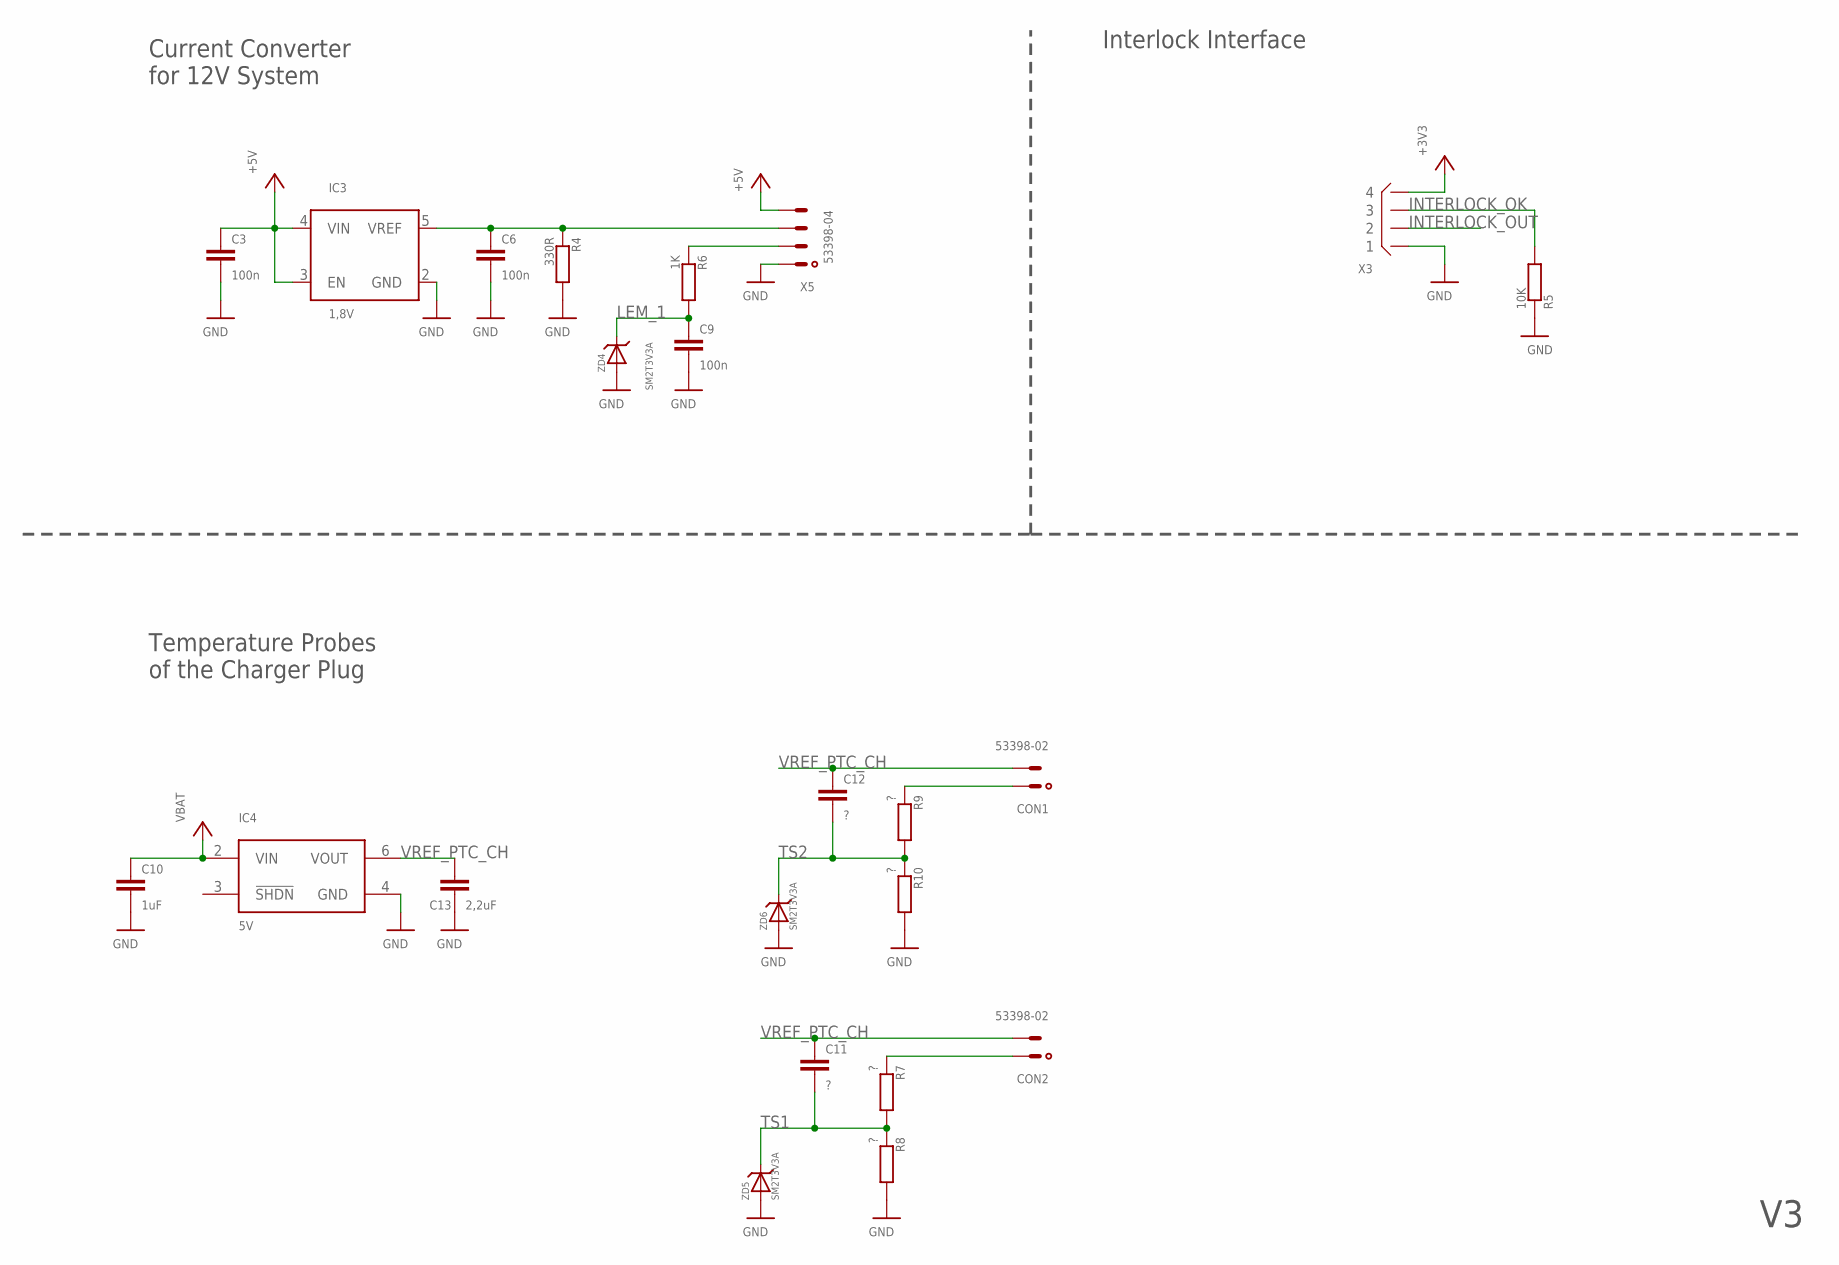
[picture p70: schematic charger_and_dc_dc_ctrl.sch, sheet 2, IO]

Parts:
C3, C6, C9: 100n; C0805
C10: 1uF; C0805
C11, C12: ?; C0805
C13: 2,2uF; C0805
CON1, CON2: 53398-02
IC3: 1,8V; SOT23-5L
IC4: 5V; SO08
R4: 330R; R0805
R5: 10K; R0603
R6: 1K; R0805
R7, R8, R9, R10: ?; R0805
X3: B4B-XH
X5: 53398-04
ZD4, ZD5, ZD6: SM2T3V3A

Connections:
+3V3: X3.P$4 (4); also elsewhere on the board
+5V: C3.1, IC3.3 (EN), IC3.4 (VIN), X5.4; also elsewhere on the board
GND: C3.2, C6.2, C9.2, C10.2, C13.2, IC3.2 (GND), IC4.4 (GND), R4.2, R5.1, R8.2, R10.2, X3.P$1 (1), X5.1, ZD4.P$1, ZD4.P$11, ZD5.P$1, ZD5.P$11, ZD6.P$1, ZD6.P$11; also elsewhere on the board
INTERLOCK_OK: R5.2, X3.P$3 (3); also elsewhere on the board
INTERLOCK_OUT: X3.P$2 (2); also elsewhere on the board
LEM_1: C9.1, R6.2, ZD4.P$2; also elsewhere on the board
unnamed: R6.1, X5.2
unnamed: CON1.1, R9.1
unnamed: C6.1, IC3.5 (VREF), R4.1, X5.3
unnamed: CON2.1, R7.1
TS1: C11.2, R7.2, R8.1, ZD5.P$2; also elsewhere on the board
TS2: C12.2, R9.2, R10.1, ZD6.P$2; also elsewhere on the board
VBAT: C10.1, IC4.2 (VIN); also elsewhere on the board
VREF_PTC_CH: C11.1, C12.1, C13.1, CON1.2, CON2.2, IC4.6 (VOUT)

Notes on the sheet:
Current Converter for 12V System
Temperature Probes of the Charger Plug
Interlock Interface

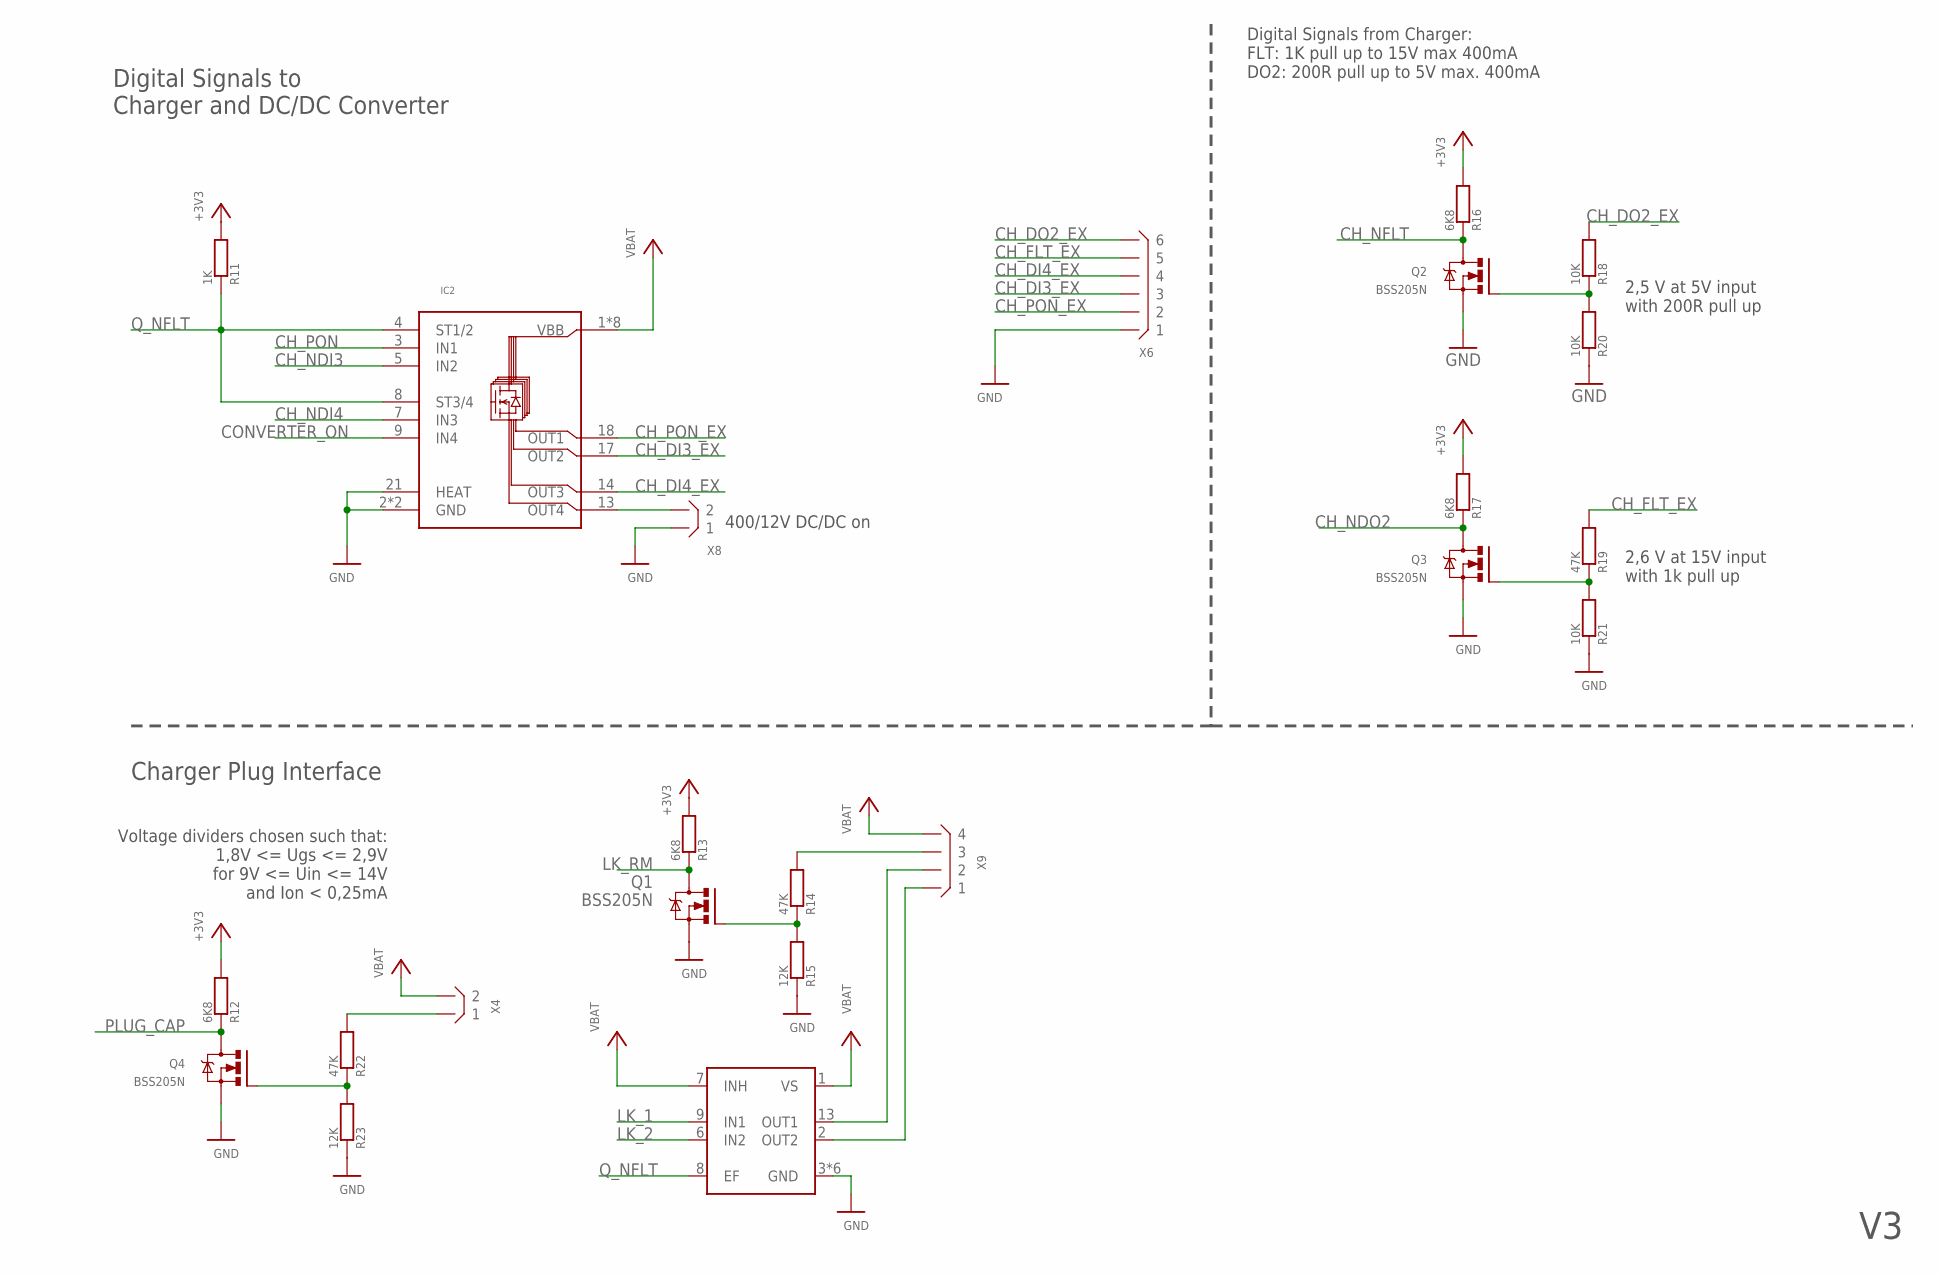
[picture p71: schematic charger_and_dc_dc_ctrl.sch, sheet 3, Laderegler und Ladestecker]

Parts:
IC2: BTS716G-NEWM; INF-PG-DSO-20-30_M_1PRIMARY
IC6: TLE4207GN; INF-PG-DSO-14-22_N_1PRIMARY
Q1, Q2, Q3, Q4: BSS205N; SOT23
R11: 1K; R0603
R12, R16, R17: 6K8; R0603
R13: 6K8; R0805
R14: 47K; R0805
R15: 12K; R0805
R18, R20, R21: 10K; R0603
R19, R22: 47K; R0603
R23: 12K; R0603
X4, X8: B2B-XH
X6: B6B-XH
X9: B4B-XH

Connections:
+3V3: R11.2, R12.2, R13.2, R16.2, R17.2; also elsewhere on the board
CH_DI3_EX: IC2.17 (OUT2), X6.P$3 (3)
CH_DI4_EX: IC2.14 (OUT3), X6.P$4 (4)
CH_DO2_EX: R18.2, X6.P$6 (6)
CH_FLT_EX: R19.2, X6.P$5 (5)
CH_NDI3: IC2.5 (IN2); also elsewhere on the board
CH_NDI4: IC2.7 (IN3); also elsewhere on the board
CH_NDO2: Q3.3 (D), R17.1; also elsewhere on the board
CH_NFLT: Q2.3 (D), R16.1; also elsewhere on the board
CH_PON: IC2.3 (IN1); also elsewhere on the board
CH_PON_EX: IC2.18 (OUT1), X6.P$2 (2)
CONVERTER_ON: IC2.9 (IN4); also elsewhere on the board
GND: IC2.2 (GND), IC2.6 (GND), IC2.21 (HEAT), IC6.3 (GND), IC6.4 (GND), IC6.5 (GND), IC6.10 (GND), IC6.11 (GND), IC6.12 (GND), Q1.2 (S), Q2.2 (S), Q3.2 (S), Q4.2 (S), R15.1, R20.1, R21.1, R23.1, X6.P$1 (1), X8.P$1 (1); also elsewhere on the board
LK_1: IC6.9 (IN1); also elsewhere on the board
LK_2: IC6.6 (IN2); also elsewhere on the board
LK_RM: Q1.3 (D), R13.1; also elsewhere on the board
unnamed: IC2.13 (OUT4), X8.P$2 (2)
unnamed: Q4.1 (G), R22.1, R23.2
unnamed: R22.2, X4.P$1 (1)
unnamed: Q3.1 (G), R19.1, R21.2
unnamed: Q1.1 (G), R14.1, R15.2
unnamed: R14.2, X9.P$3 (3)
unnamed: IC6.13 (OUT1), X9.P$2 (2)
unnamed: IC6.2 (OUT2), X9.P$1 (1)
unnamed: Q2.1 (G), R18.1, R20.2
PLUG_CAP: Q4.3 (D), R12.1; also elsewhere on the board
Q_NFLT: IC2.4 (ST1/2), IC2.8 (ST3/4), IC6.8 (EF), R11.1; also elsewhere on the board
VBAT: IC2.1 (VBB), IC2.10 (VBB), IC2.11 (VBB), IC2.12 (VBB), IC2.15 (VBB), IC2.16 (VBB), IC2.19 (VBB), IC2.20 (VBB), IC6.1 (VS), IC6.7 (INH), X4.P$2 (2), X9.P$4 (4); also elsewhere on the board

Notes on the sheet:
Voltage dividers chosen such that: 1,8V <= Ugs <= 2,9V for 9V <= Uin <= 14V and Ion < 0,25mA
Digital Signals from Charger: FLT: 1K pull up to 15V max 400mA DO2: 200R pull up to 5V max. 400mA
2,6 V at 15V input with 1k pull up
2,5 V at 5V input with 200R pull up
400/12V DC/DC on
Charger Plug Interface
Digital Signals to Charger and DC/DC Converter

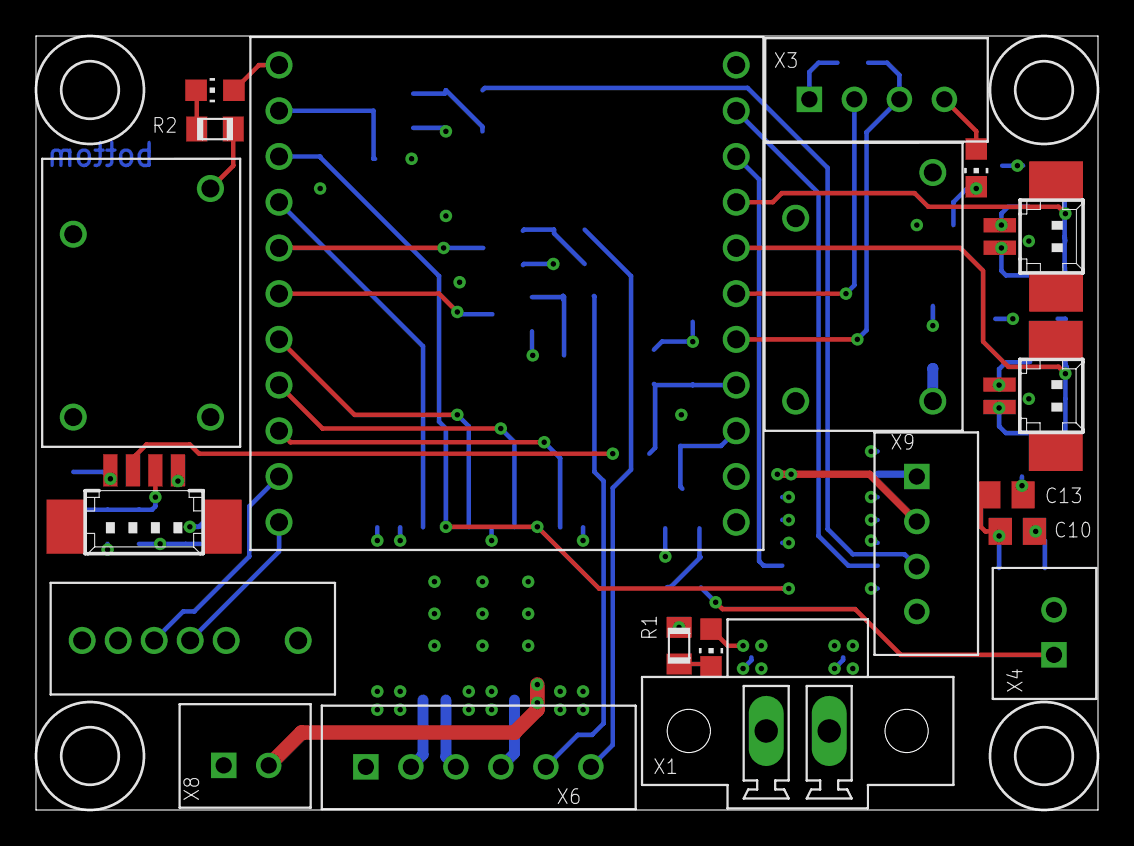
[picture p72: board charger_and_dc_dc_ctrl.brd from above]

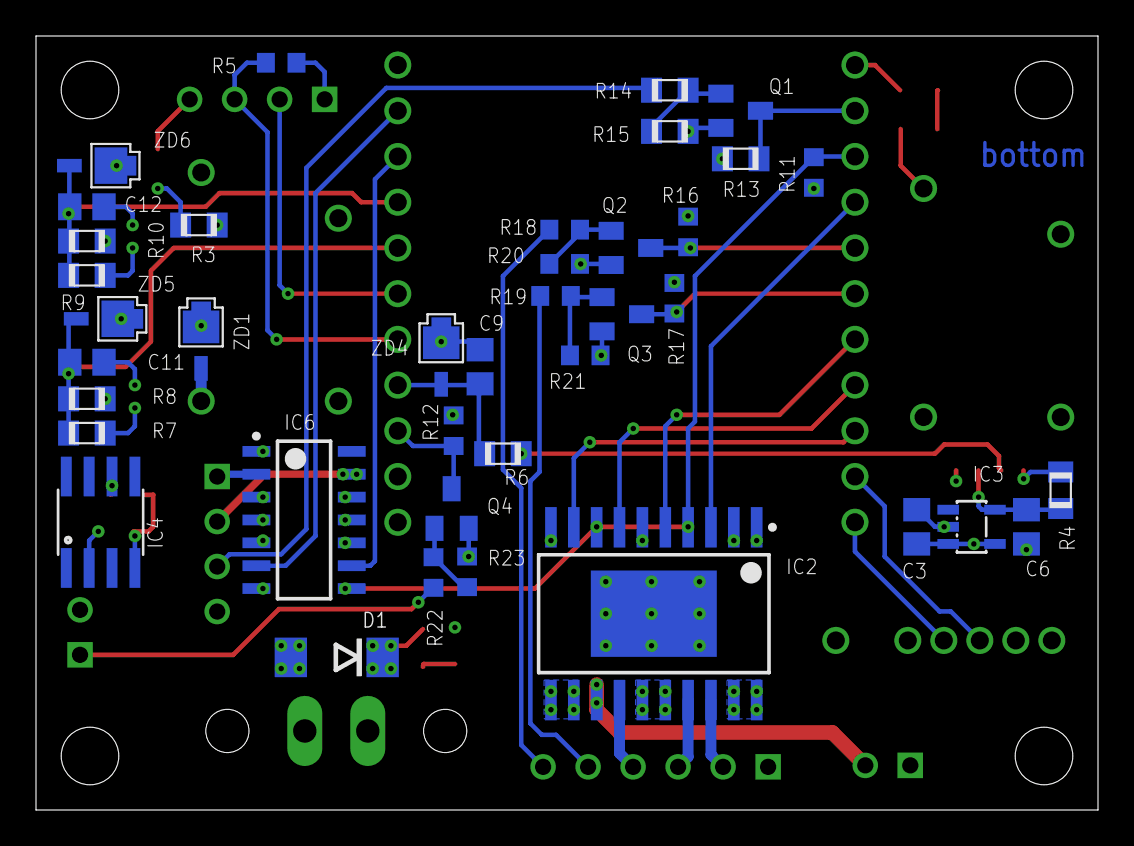
[picture p73: board charger_and_dc_dc_ctrl.brd from below]

Board: 4 copper layers, 59.0 x 43.0 mm, 63 parts (39 on the bottom side), 44 nets.
