TERA-TU-Graz/BatteryManagement_2017/HW/projects/ibex/BMS_Ibex/Interlock/InterlockV2/Interlock.brd

## EAGLE design HW/projects/ibex/BMS_Ibex/Interlock/InterlockV2/Interlock.brd (2017-08-10)

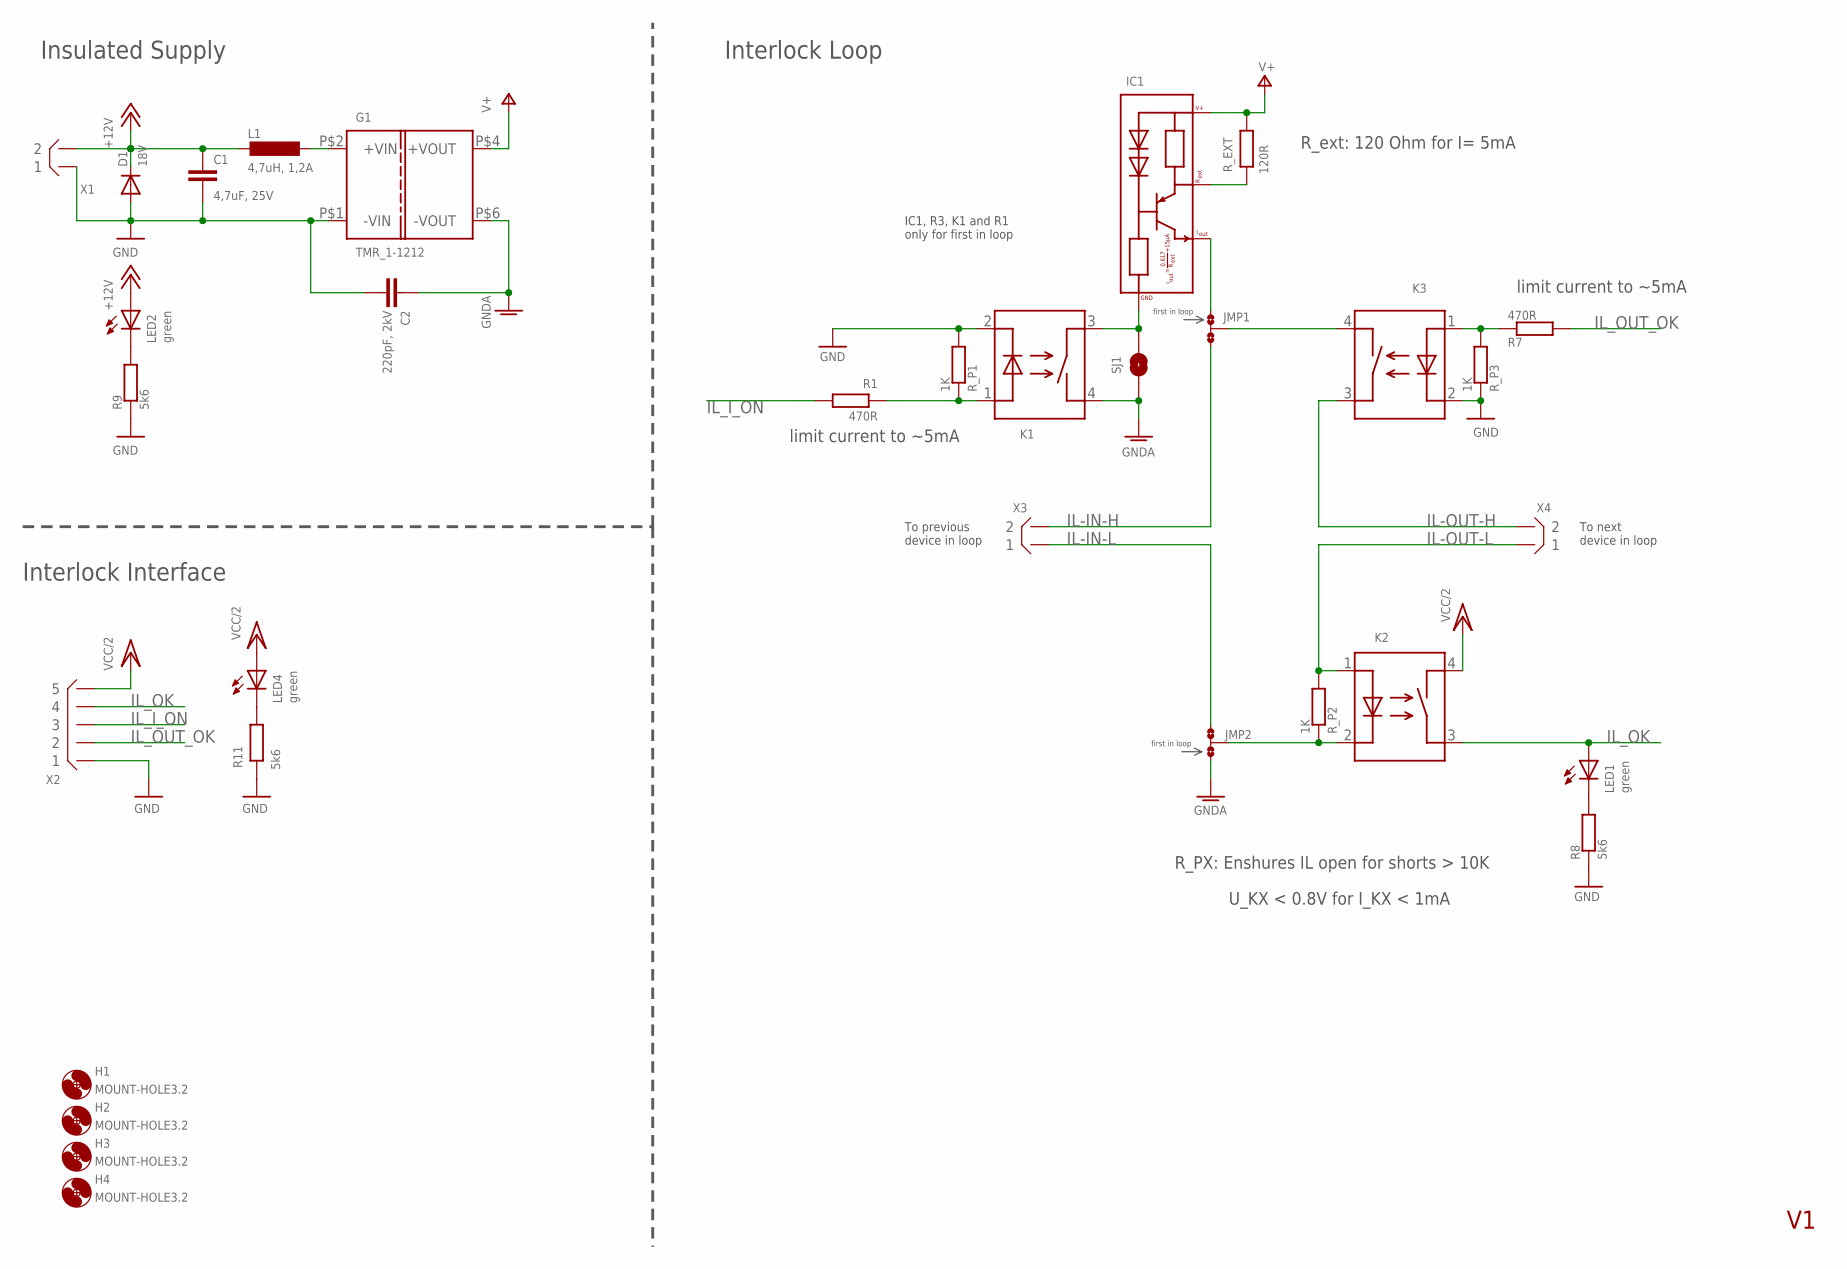
[picture p74: schematic Interlock.sch]

Parts:
C1: 4,7uF, 25V; C0805
C2: 220pF, 2kV; C1210_HV
D1: 18V; DO214AA
G1: TMR_1-1212; TMR_1-??1?
H1, H2, H3, H4: MOUNT-HOLE3.2; 3,2
IC1: PSSI2021SAY; SOT353
JMP1, JMP2: 0R-JUMPA; A0R-JMP
K1, K2, K3: ASSR-1218; SO-4
L1: 4,7uH, 1,2A; L3225M
LED1, LED2, LED4: green; CHIPLED_0805
R1, R7: 470R; R0805
R8, R9, R11: 5k6; R0805
R_EXT: 120R; R0805
R_P1, R_P2, R_P3: 1K; R0603
SJ1: SOLDERJUMPERNO; SJ_2S-NO
X1, X3, X4: B2B-XH
X2: B5B-XH

Connections:
+12V: C1.1, D1.C, L1.2, LED2.A, X1.P$2 (2)
GND: C1.2, C2.P$1 (1), D1.A, G1.P$1 (-VIN), K1.2 (I-), K3.2 (I-), R8.1, R9.1, R11.1, R_P1.2, R_P3.1, X1.P$1 (1), X2.P$1 (1)
GNDA: C2.P$2 (2), G1.P$6 (-VOUT), JMP2.1, K1.4 (O1), SJ1.1
IL-IN-H: JMP1.3, X3.P$2 (2)
IL-IN-L: JMP2.3, X3.P$1 (1)
IL-OUT-H: K3.3 (O2), X4.P$2 (2)
IL-OUT-L: K2.1 (I+), R_P2.2, X4.P$1 (1)
IL_I_ON: R1.2, X2.P$3 (3)
IL_OK: K2.3 (O2), LED1.A, X2.P$4 (4)
IL_OUT_OK: R7.2, X2.P$2 (2)
unnamed: IC1.4 (REXT), R_EXT.1
unnamed: G1.P$2 (+VIN), L1.1
unnamed: K3.1 (I+), R7.1, R_P3.2
unnamed: JMP1.2, K3.4 (O1)
unnamed: IC1.2 (IOUT), JMP1.1
unnamed: JMP2.2, K2.2 (I-), R_P2.1
unnamed: IC1.3 (GND), K1.3 (O2), SJ1.2
unnamed: LED2.C, R9.2
unnamed: K1.1 (I+), R1.1, R_P1.1
unnamed: LED4.C, R11.2
unnamed: LED1.C, R8.2
V+: G1.P$4 (+VOUT), IC1.5 (VSS), R_EXT.2
VCC/2: K2.4 (O1), LED4.A, X2.P$5 (5)

Notes on the sheet:
R_ext: 120 Ohm for I= 5mA
limit current to ~5mA
Insulated Supply
Interlock Loop
Interlock Interface
IC1, R3, K1 and R1 only for first in loop
first in loop
To previous device in loop
To next device in loop
U_KX < 0.8V for I_KX < 1mA
R_PX: Enshures IL open for shorts > 10K

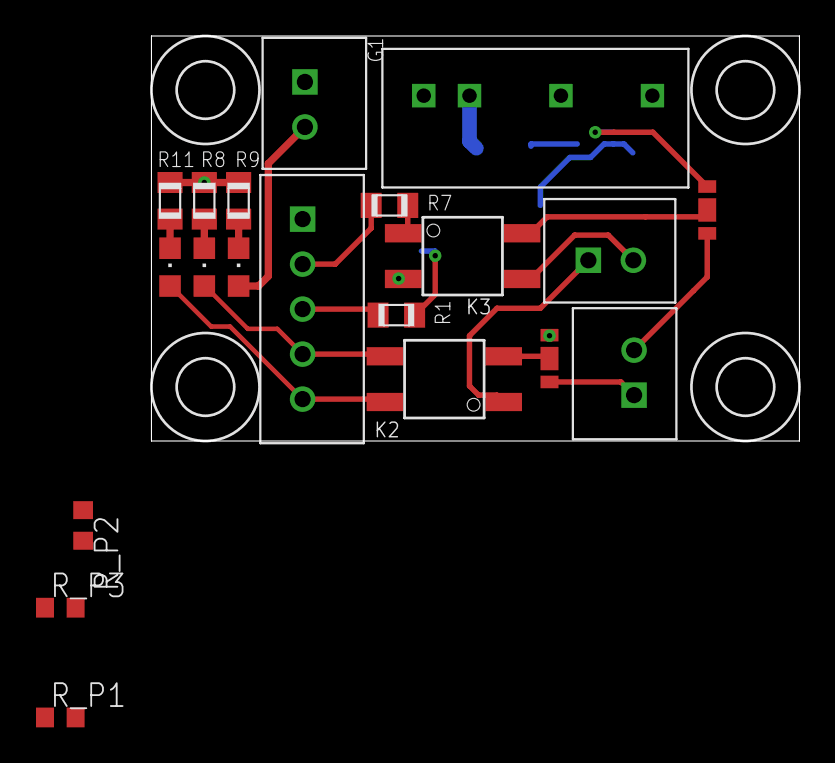
[picture p75: board HW/projects/ibex/BMS_Ibex/Interlock/InterlockV2/Interlock.brd from above]

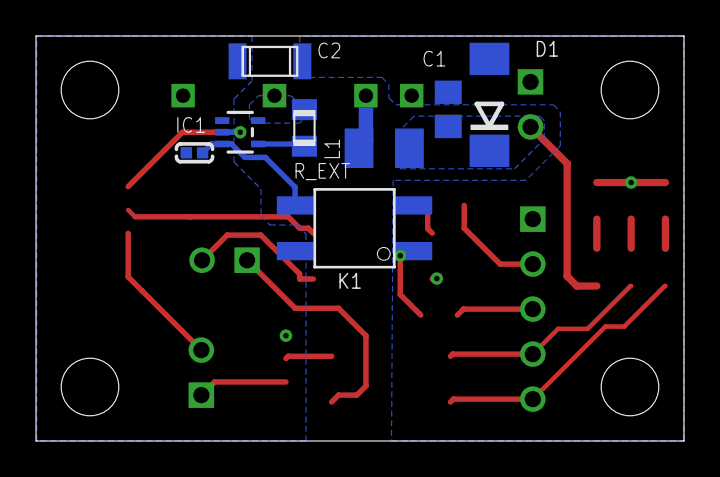
[picture p76: board HW/projects/ibex/BMS_Ibex/Interlock/InterlockV2/Interlock.brd from below]

Board: 4 copper layers, 36.0 x 22.5 mm, 32 parts (8 on the bottom side), 23 nets.
