TERA-TU-Graz/BatteryManagement_2017/HW/projects/ibex/BMS_Ibex/Balancer/bms_balance_v3/balance.brd

## EAGLE design HW/projects/ibex/BMS_Ibex/Balancer/bms_balance_v3/balance.brd (2017-08-10, an earlier design)

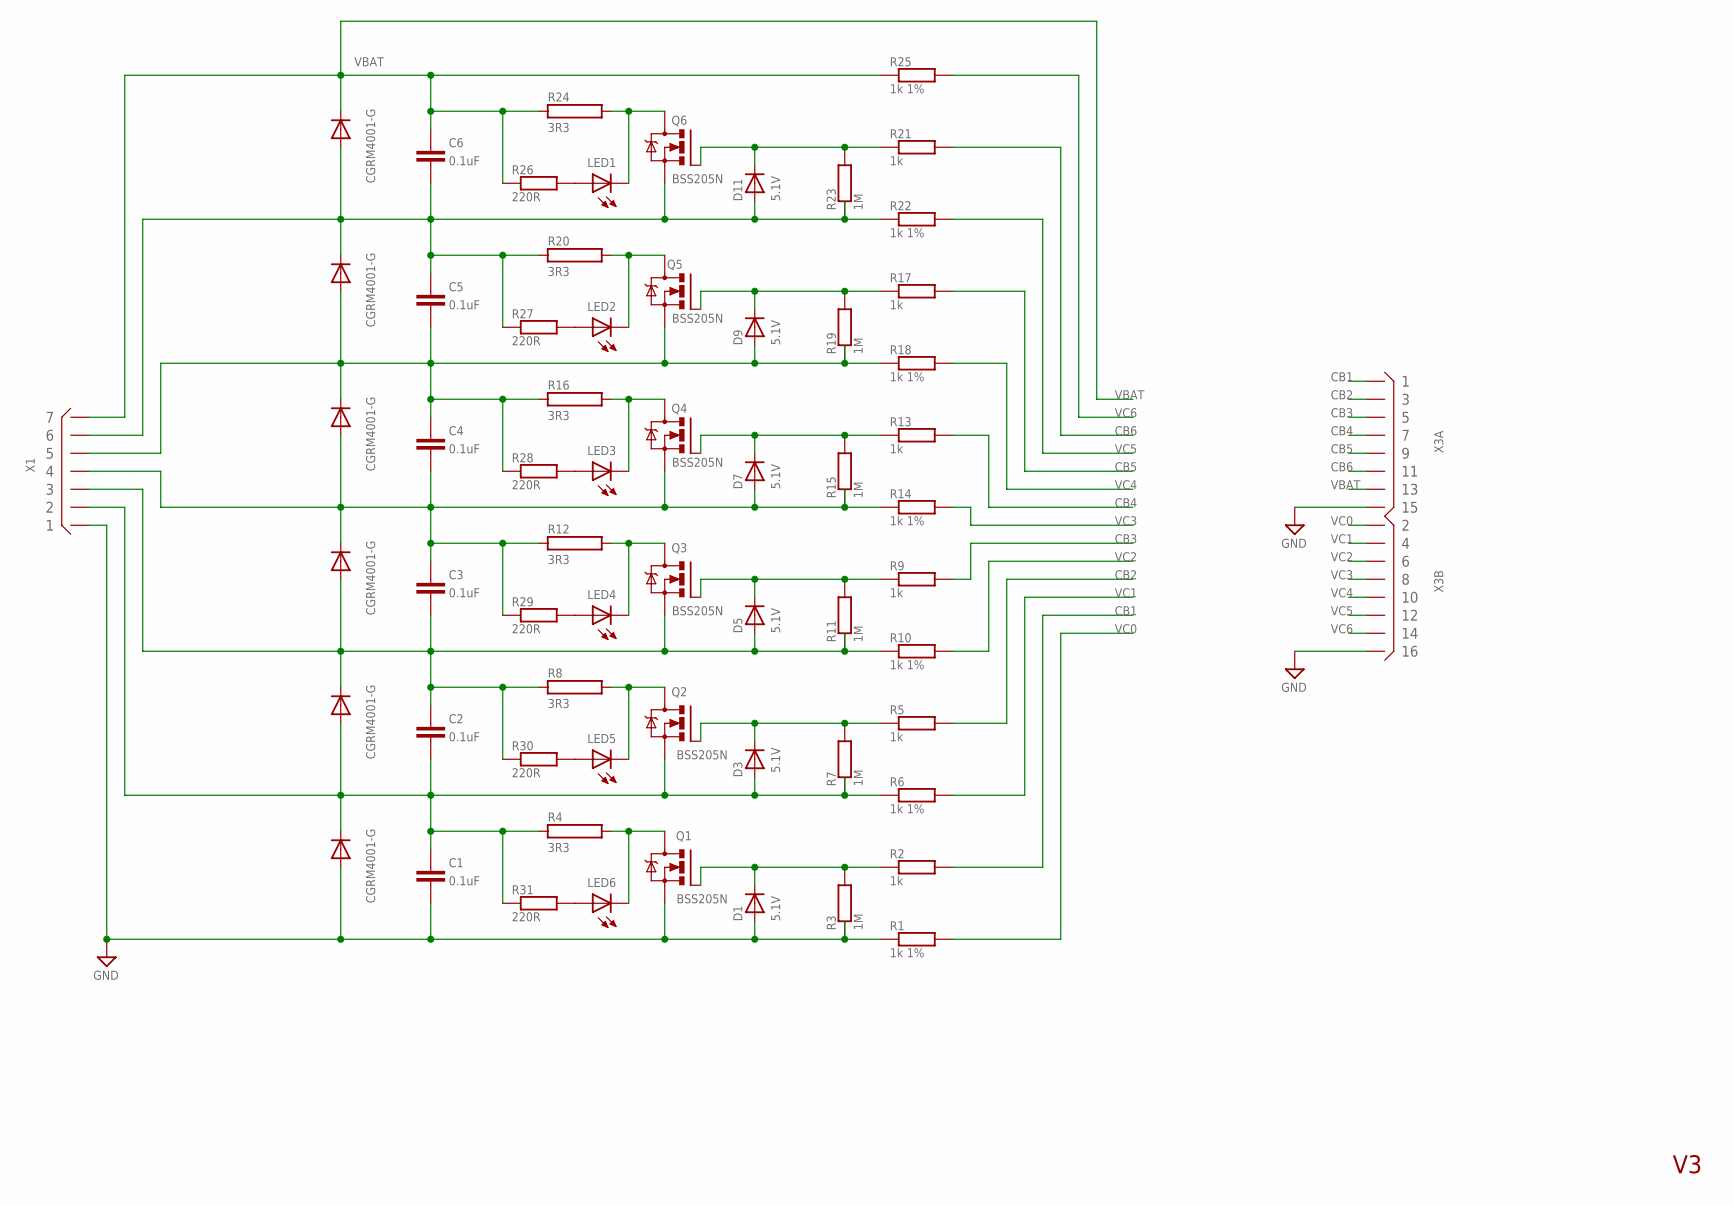
[picture p77: schematic balance.sch]

Parts:
C1, C2, C3, C4, C5, C6: 0.1uF; C0805
D1, D3, D5, D7, D9, D11: 5.1V; SOD-323
D2, D4, D6, D8, D10, D12: CGRM4001-G; SOD-123_MINI-SMA
LED1, LED2, LED3, LED4, LED5, LED6: LEDCHIP-LED0805; CHIP-LED0805
Q1, Q2, Q3, Q4, Q5, Q6: BSS205N; SOT23
R1, R6, R10, R14, R18, R22, R25: 1k 1%; R0805
R2, R5, R9, R13, R17, R21: 1k; R0805
R3, R7, R11, R15, R19, R23: 1M; R0805
R4, R8, R12, R16, R20, R24: 3R3; HS15
R26, R27, R28, R29, R30, R31: 220R; R0805
X1: B7B-XH
X3: X08X2DR; X16R-DIL

Connections:
1: LED6.C, Q1.3 (D), R4.2
2: C1.2, C2.1, D2.C, D3.2 (A), D4.A, Q2.2 (S), R4.1, R6.1, R7.1, R31.1, X1.P$2 (2)
3: LED5.C, Q2.3 (D), R8.2
4: C2.2, C3.1, D4.C, D5.2 (A), D6.A, Q3.2 (S), R8.1, R10.1, R11.1, R30.1, X1.P$3 (3)
5: LED4.C, Q3.3 (D), R12.2
6: C3.2, C4.1, D6.C, D7.2 (A), D8.A, Q4.2 (S), R12.1, R14.1, R15.1, R29.1, X1.P$4 (4)
7: LED3.C, Q4.3 (D), R16.2
8: C4.2, C5.1, D8.C, D9.2 (A), D10.A, Q5.2 (S), R16.1, R18.1, R19.1, R28.1, X1.P$5 (5)
9: LED2.C, Q5.3 (D), R20.2
10: C5.2, C6.1, D10.C, D11.2 (A), D12.A, Q6.2 (S), R20.1, R22.1, R23.1, R27.1, X1.P$6 (6)
11: LED1.C, Q6.3 (D), R24.2
CB1: R2.2, X3.1
CB2: R5.2, X3.3
CB3: R9.2, X3.5
CB4: R13.2, X3.7
CB5: R17.2, X3.9
CB6: R21.2, X3.11
GND: C1.1, D1.2 (A), D2.A, Q1.2 (S), R1.1, R3.1, X1.P$1 (1), X3.15, X3.16
unnamed: D1.1 (C), Q1.1 (G), R2.1, R3.2
unnamed: D3.1 (C), Q2.1 (G), R5.1, R7.2
unnamed: LED1.A, R26.2
unnamed: LED2.A, R27.2
unnamed: LED3.A, R28.2
unnamed: D5.1 (C), Q3.1 (G), R9.1, R11.2
unnamed: LED4.A, R29.2
unnamed: LED5.A, R30.2
unnamed: LED6.A, R31.2
unnamed: D7.1 (C), Q4.1 (G), R13.1, R15.2
unnamed: D9.1 (C), Q5.1 (G), R17.1, R19.2
unnamed: D11.1 (C), Q6.1 (G), R21.1, R23.2
VBAT: C6.2, D12.C, R24.1, R25.1, R26.1, X1.P$7 (7), X3.13
VC0: R1.2, X3.2
VC1: R6.2, X3.4
VC2: R10.2, X3.6
VC3: R14.2, X3.8
VC4: R18.2, X3.10
VC5: R22.2, X3.12
VC6: R25.2, X3.14

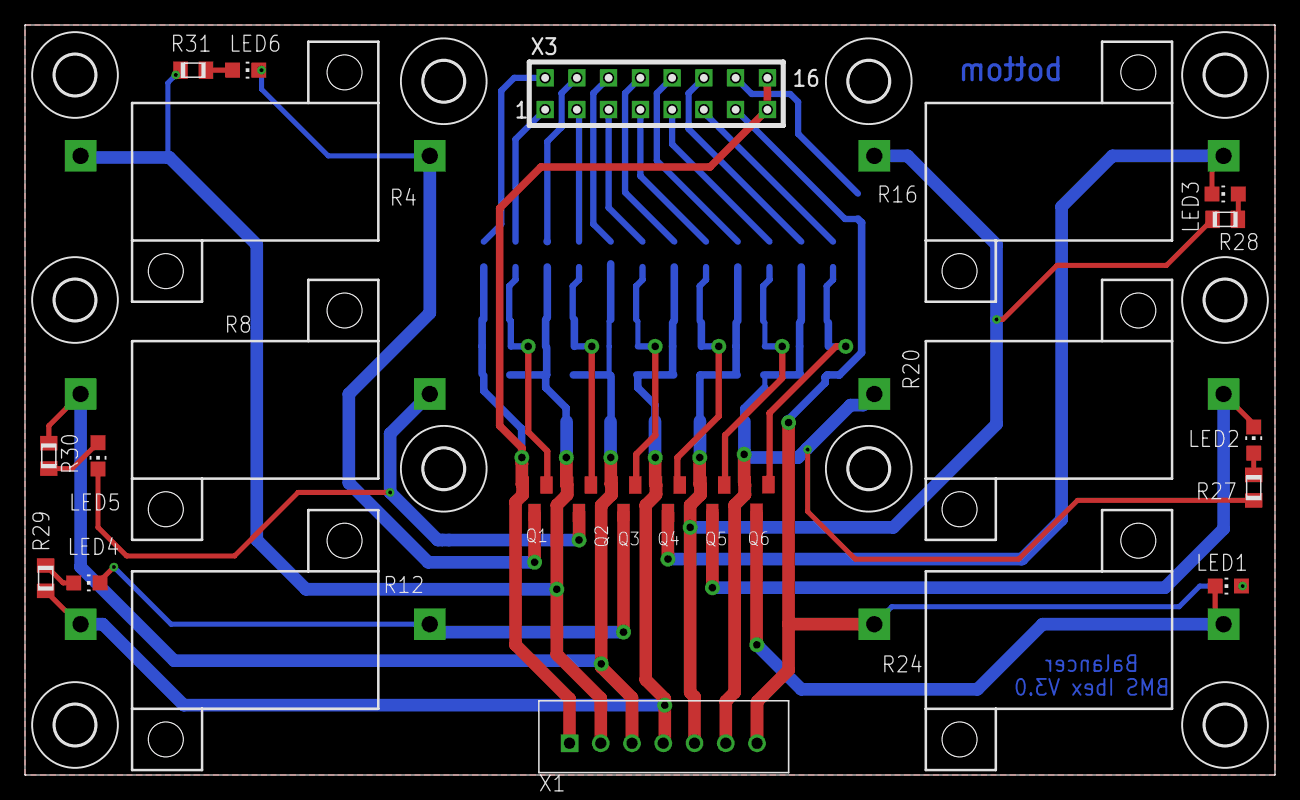
[picture p78: board HW/projects/ibex/BMS_Ibex/Balancer/bms_balance_v3/balance.brd from above]

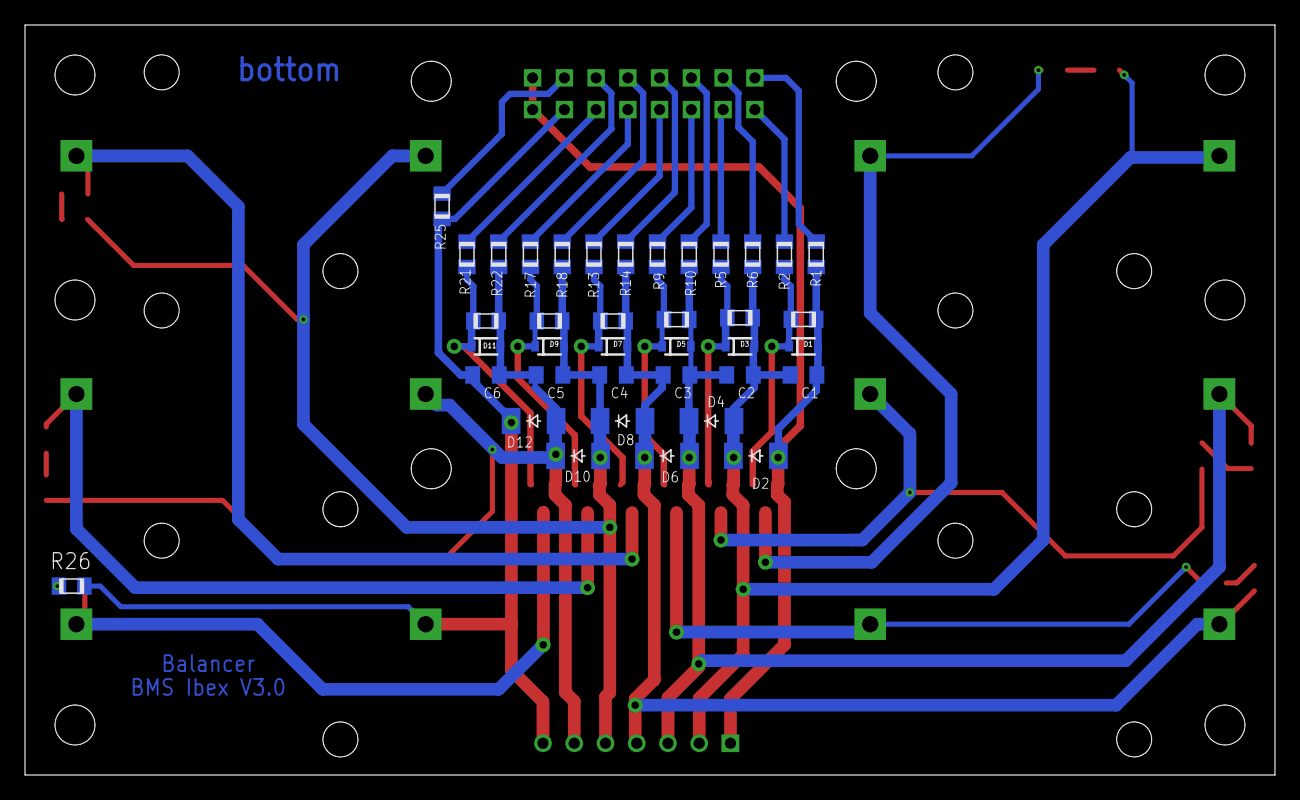
[picture p79: board HW/projects/ibex/BMS_Ibex/Balancer/bms_balance_v3/balance.brd from below]

Board: 4 copper layers, 100.0 x 60.0 mm, 73 parts (38 on the bottom side), 38 nets.

Other parts of the board:
U$1, U$2, U$3, U$4, U$5, U$6, U$7, U$8, U$9, U$10: 3,2
