TERA-TU-Graz/BatteryManagement_2017/HW/projects/ibex/BMS_Ibex/Master/BMS_Master_V1/BMS_Master.brd

## EAGLE design HW/projects/ibex/BMS_Ibex/Master/BMS_Master_V1/BMS_Master.brd (2017-08-10, an earlier design)

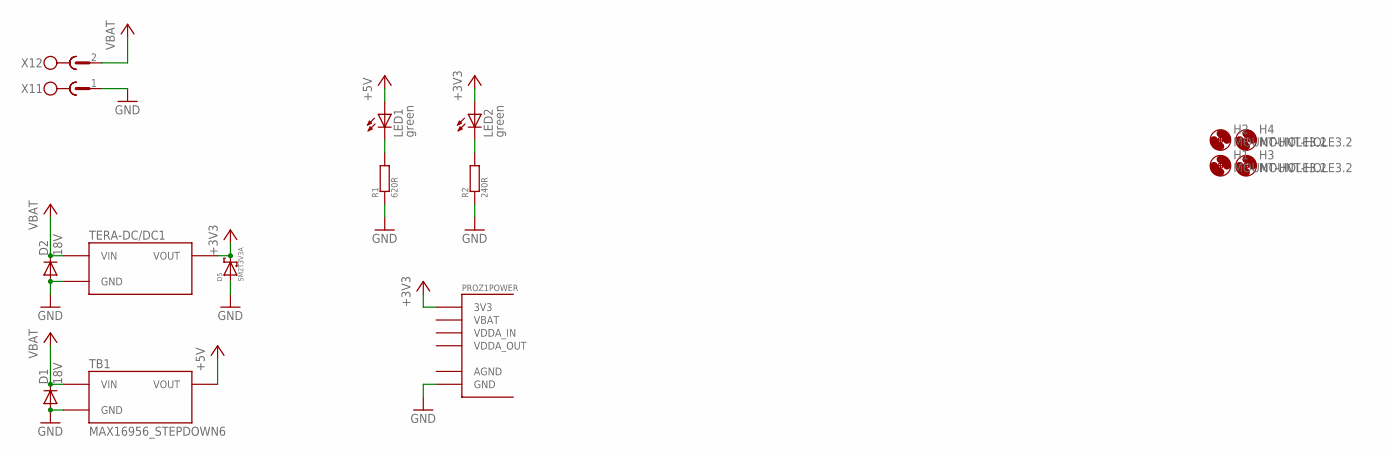
[picture p80: schematic BMS_Master.sch, sheet 1, Supply]

Parts:
D1, D2: 18V; DO214AA
D5: SM2T3V3A
H1, H2, H3, H4: MOUNT-HOLE3.2; 3,2
LED1, LED2: green; CHIP-LED0805
PROZ1: STM32F4_PROZESSORBOARDRPZ; STM32F4_PROZESSORBOARD
R1: 620R; R0805
R2: 240R; R0805
TB1: MAX16956_STEPDOWN6
TERA-DC/DC1: MAX5035_STEPDOWN3
X1: MSTBX2MSTBV2_GF; MSTBV2_GF

Connections:
+3V3: D5.P$2, LED2.A, PROZ1.45 (3V3), PROZ1.46 (3V3), TERA-DC/DC1.VOUT; also elsewhere on the board
+5V: LED1.A, TB1.VOUT; also elsewhere on the board
GND: D1.A, D2.A, D5.P$1, D5.P$11, PROZ1.47 (GND), PROZ1.48 (GND), R1.1, R2.1, TB1.GND, TB1.GND2 (GND), TERA-DC/DC1.GND@1 (GND), TERA-DC/DC1.GND@2 (GND), X1.1; also elsewhere on the board
unnamed: LED1.C, R1.2
unnamed: LED2.C, R2.2
VBAT: D1.C, D2.C, TB1.VIN, TERA-DC/DC1.VIN, X1.2; also elsewhere on the board

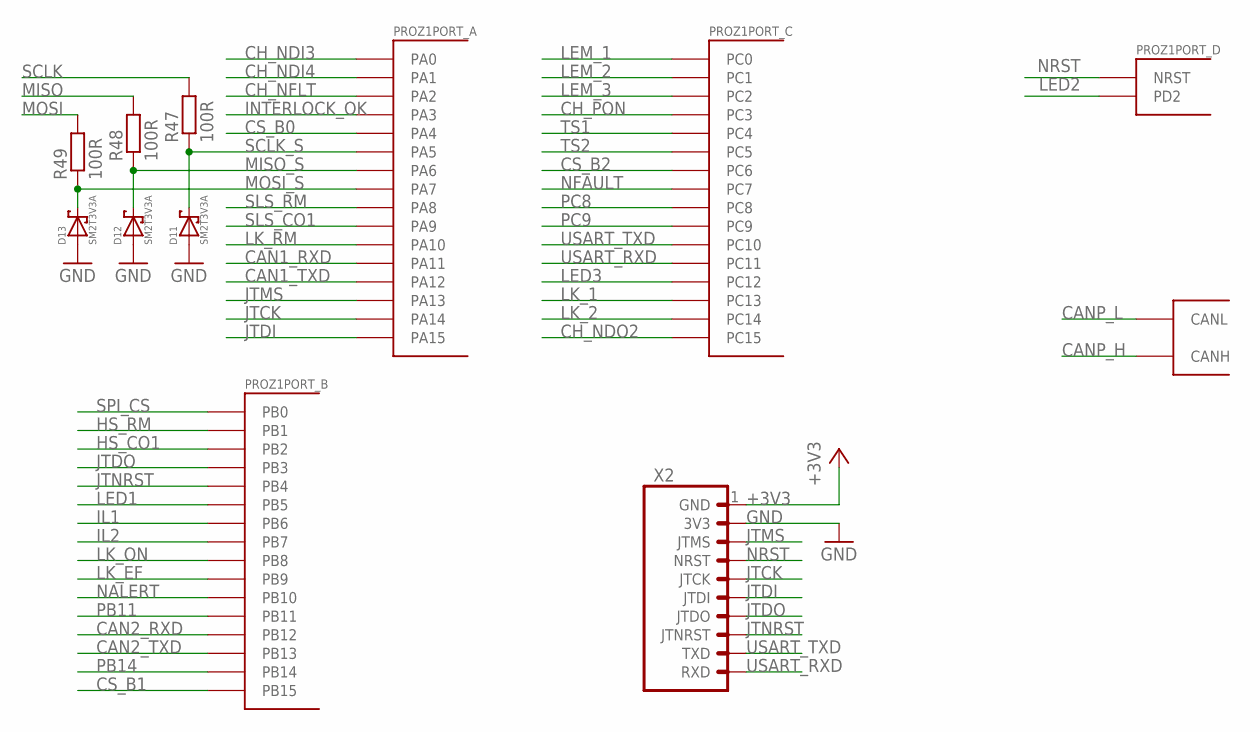
[picture p81: schematic BMS_Master.sch, sheet 2, Processor Interface]

Parts:
D11, D12, D13: SM2T3V3A
PROZ1: STM32F4_PROZESSORBOARDRPZ; STM32F4_PROZESSORBOARD
R47, R48, R49: 100R; R0805
X2: TERA-PROG-DEBUG-10GERADE; 90130-1110

Connections:
+3V3: X2.1 (GND); also elsewhere on the board
CAN1_RXD: PROZ1.26 (PA11); also elsewhere on the board
CAN1_TXD: PROZ1.24 (PA12); also elsewhere on the board
CAN2_RXD: PROZ1.50 (PB12); also elsewhere on the board
CAN2_TXD: PROZ1.49 (PB13); also elsewhere on the board
CANP_H: PROZ1.31 (CANH); also elsewhere on the board
CANP_L: PROZ1.32 (CANL); also elsewhere on the board
CH_NDI3: PROZ1.7 (PA0); also elsewhere on the board
CH_NDI4: PROZ1.5 (PA1); also elsewhere on the board
CH_NDO2: PROZ1.19 (PC15); also elsewhere on the board
CH_NFLT: PROZ1.3 (PA2); also elsewhere on the board
CH_PON: PROZ1.9 (PC3); also elsewhere on the board
CS_B0: PROZ1.43 (PA4); also elsewhere on the board
CS_B1: PROZ1.51 (PB15); also elsewhere on the board
CS_B2: PROZ1.52 (PC6); also elsewhere on the board
GND: D11.P$1, D11.P$11, D12.P$1, D12.P$11, D13.P$1, D13.P$11, X2.2 (3V3); also elsewhere on the board
HS_CO1: PROZ1.36 (PB2); also elsewhere on the board
HS_RM: PROZ1.37 (PB1); also elsewhere on the board
IL1: PROZ1.14 (PB6); also elsewhere on the board
IL2: PROZ1.12 (PB7); also elsewhere on the board
INTERLOCK_OK: PROZ1.44 (PA3); also elsewhere on the board
JTCK: PROZ1.18 (PA14), X2.5 (JTCK)
JTDI: PROZ1.16 (PA15), X2.6 (JTDI)
JTDO: PROZ1.20 (PB3), X2.7 (JTDO)
JTMS: PROZ1.59 (PA13), X2.3 (JTMS)
JTNRST: PROZ1.22 (PB4), X2.8 (JTNRST)
LED1: PROZ1.25 (PB5)
LED2: PROZ1.27 (PD2)
LED3: PROZ1.29 (PC12)
LEM_1: PROZ1.15 (PC0); also elsewhere on the board
LEM_2: PROZ1.13 (PC1); also elsewhere on the board
LEM_3: PROZ1.11 (PC2); also elsewhere on the board
LK_1: PROZ1.23 (PC13); also elsewhere on the board
LK_2: PROZ1.21 (PC14); also elsewhere on the board
LK_EF: PROZ1.8 (PB9); also elsewhere on the board
LK_ON: PROZ1.10 (PB8); also elsewhere on the board
LK_RM: PROZ1.58 (PA10); also elsewhere on the board
MISO: R48.2; also elsewhere on the board
MISO_S: D12.P$2, PROZ1.42 (PA6), R48.1
MOSI: R49.2; also elsewhere on the board
MOSI_S: D13.P$2, PROZ1.41 (PA7), R49.1
NALERT: PROZ1.35 (PB10); also elsewhere on the board
NFAULT: PROZ1.53 (PC7); also elsewhere on the board
NRST: PROZ1.17 (NRST), X2.4 (NRST)
PB11: PROZ1.34 (PB11)
PB14: PROZ1.33 (PB14)
PC8: PROZ1.54 (PC8)
PC9: PROZ1.55 (PC9)
SCLK: R47.2; also elsewhere on the board
SCLK_S: D11.P$2, PROZ1.60 (PA5), R47.1
SLS_CO1: PROZ1.57 (PA9); also elsewhere on the board
SLS_RM: PROZ1.56 (PA8); also elsewhere on the board
SPI_CS: PROZ1.38 (PB0); also elsewhere on the board
TS1: PROZ1.40 (PC4); also elsewhere on the board
TS2: PROZ1.39 (PC5); also elsewhere on the board
USART_RXD: PROZ1.30 (PC11), X2.10 (RXD)
USART_TXD: PROZ1.28 (PC10), X2.9 (TXD)
