TERA-TU-Graz/BatteryManagement_2017/HW/projects/ibex/BMS_Ibex/Master/BMS_Master_V1/BMS_Master.brd

## EAGLE design HW/projects/ibex/BMS_Ibex/Master/BMS_Master_V1/BMS_Master.brd (continued)

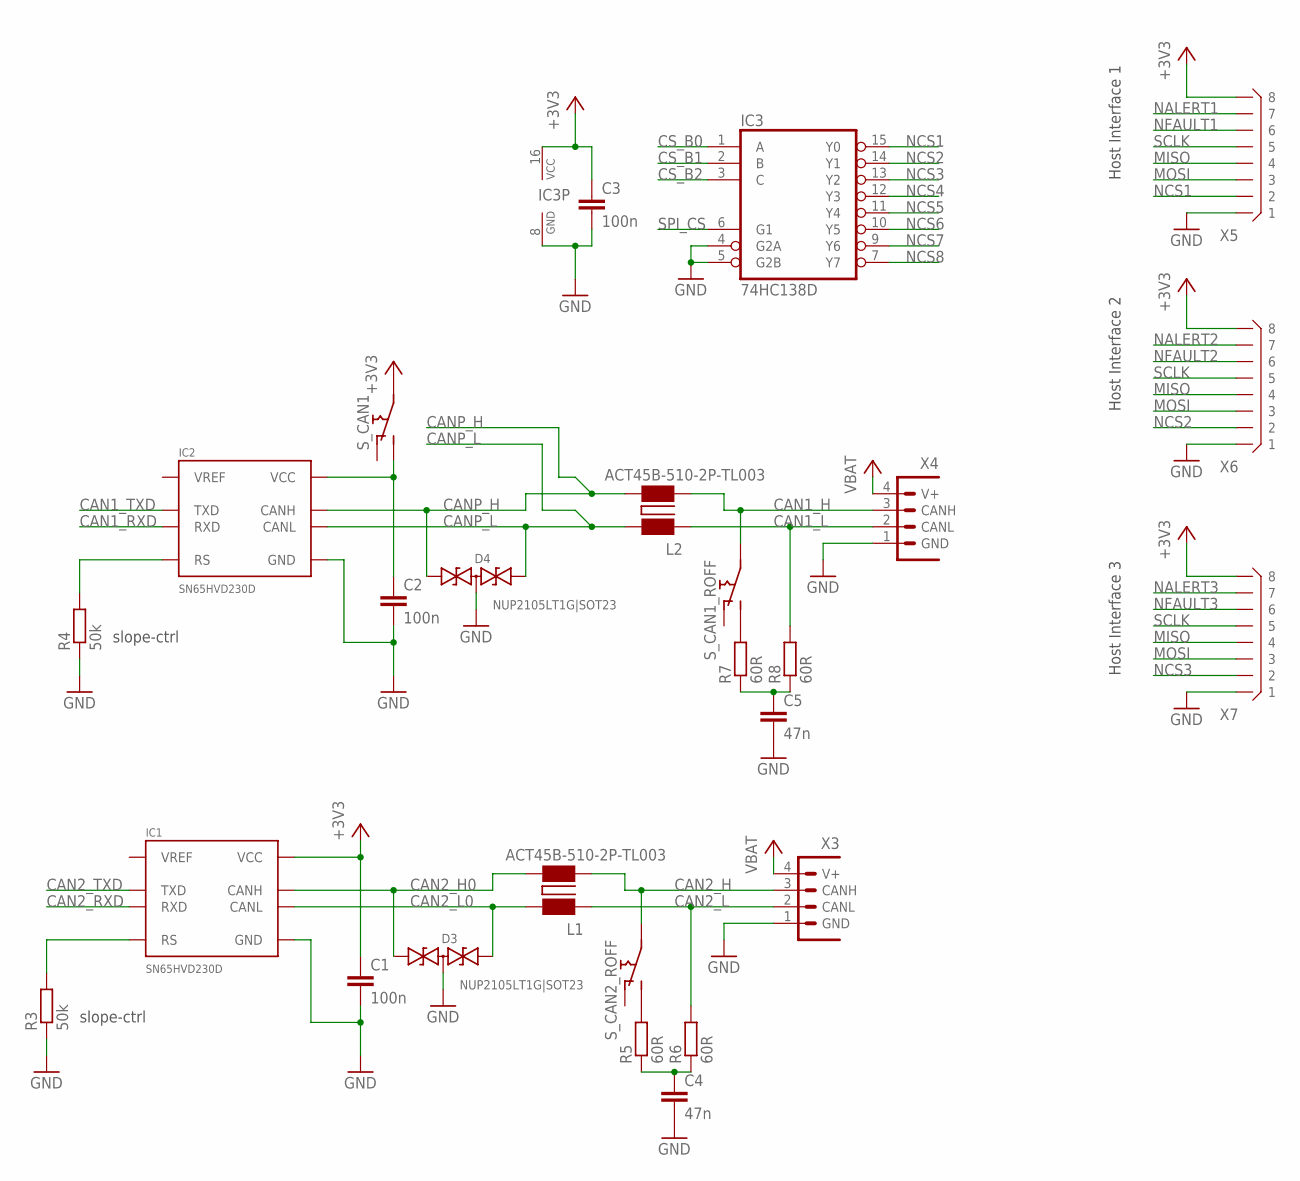
[picture p82: schematic BMS_Master.sch, sheet 3, Bus Systems (CAN, SPI)]

Parts:
C1, C2, C3: 100n; C0805
C4, C5: 47n; C0805
D3, D4: NUP2105LT1G|SOT23; SOT23
IC1, IC2: SN65HVD230D; SO08
IC3: 74HC138D; SO16
L1, L2: ACT45B-510-2P-TL003; ACT45B
R3, R4: 50k; R0805
R5, R6, R7, R8: 60R; R0805
S_CAN1, S_CAN1_ROFF, S_CAN2_ROFF: JUMPER_ORS; J_OR_S
X3, X4: CIOC_4-1-FV-A_CAN-BELEGUNG; CIOC_4-1-FV
X5, X6, X7: B8B-XH

Connections:
+3V3: C1.1, C3.1, IC1.3 (VCC), IC3.16 (VCC), S_CAN1.P$1, X5.P$8 (8), X6.P$8 (8), X7.P$8 (8); also elsewhere on the board
CAN1_H: L2.P$1 (1), S_CAN1_ROFF.P$1, X4.3 (CANH)
CAN1_L: L2.P$3 (3), R8.2, X4.2 (CANL)
CAN1_RXD: IC2.4 (RXD); also elsewhere on the board
CAN1_TXD: IC2.1 (TXD); also elsewhere on the board
CAN2_H: L1.P$1 (1), S_CAN2_ROFF.P$1, X3.3 (CANH)
CAN2_H0: D3.1, IC1.7 (CANH), L1.P$2 (2)
CAN2_L: L1.P$3 (3), R6.2, X3.2 (CANL)
CAN2_L0: D3.2, IC1.6 (CANL), L1.P$4 (4)
CAN2_RXD: IC1.4 (RXD); also elsewhere on the board
CAN2_TXD: IC1.1 (TXD); also elsewhere on the board
CANP_H: D4.1, IC2.7 (CANH), L2.P$2 (2); also elsewhere on the board
CANP_L: D4.2, IC2.6 (CANL), L2.P$4 (4); also elsewhere on the board
CS_B0: IC3.1 (A); also elsewhere on the board
CS_B1: IC3.2 (B); also elsewhere on the board
CS_B2: IC3.3 (C); also elsewhere on the board
GND: C1.2, C2.2, C3.2, C4.2, C5.2, D3.3, D4.3, IC1.2 (GND), IC2.2 (GND), IC3.4 (G2A), IC3.5 (G2B), IC3.8 (GND), R3.1, R4.1, X3.1 (GND), X4.1 (GND), X5.P$1 (1), X6.P$1 (1), X7.P$1 (1); also elsewhere on the board
MISO: X5.P$4 (4), X6.P$4 (4), X7.P$4 (4); also elsewhere on the board
MOSI: X5.P$3 (3), X6.P$3 (3), X7.P$3 (3); also elsewhere on the board
unnamed: C5.1, R7.1, R8.1
unnamed: C2.1, IC2.3 (VCC), S_CAN1.P$2
unnamed: IC2.8 (RS), R4.2
unnamed: C4.1, R5.1, R6.1
unnamed: R7.2, S_CAN1_ROFF.P$2
unnamed: IC1.8 (RS), R3.2
unnamed: R5.2, S_CAN2_ROFF.P$2
NALERT1: X5.P$7 (7); also elsewhere on the board
NALERT2: X6.P$7 (7); also elsewhere on the board
NALERT3: X7.P$7 (7); also elsewhere on the board
NCS1: IC3.15 (Y0), X5.P$2 (2)
NCS2: IC3.14 (Y1), X6.P$2 (2)
NCS3: IC3.13 (Y2), X7.P$2 (2)
NCS4: IC3.12 (Y3); also elsewhere on the board
NCS5: IC3.11 (Y4); also elsewhere on the board
NCS6: IC3.10 (Y5)
NCS7: IC3.9 (Y6)
NCS8: IC3.7 (Y7)
NFAULT1: X5.P$6 (6); also elsewhere on the board
NFAULT2: X6.P$6 (6); also elsewhere on the board
NFAULT3: X7.P$6 (6); also elsewhere on the board
SCLK: X5.P$5 (5), X6.P$5 (5), X7.P$5 (5); also elsewhere on the board
SPI_CS: IC3.6 (G1); also elsewhere on the board
VBAT: X3.4 (V+), X4.4 (V+); also elsewhere on the board

Notes on the sheet:
slope-ctrl
Host Interface 1
Host Interface 2
Host Interface 3

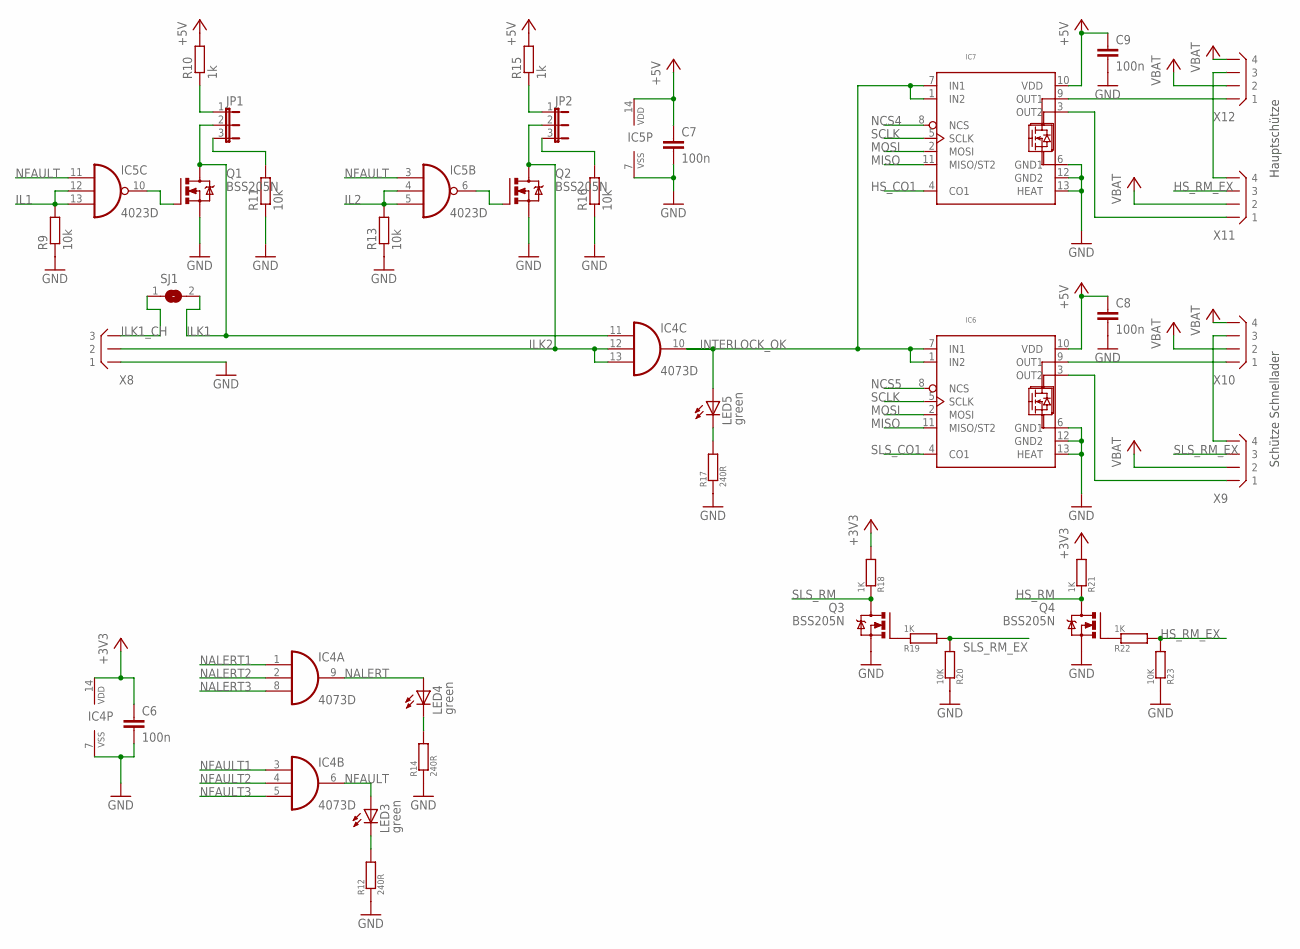
[picture p83: schematic BMS_Master.sch, sheet 4, Safety Systems]

Parts:
C6, C7, C8, C9: 100n; C0805
IC4: 4073D; SO14
IC5: 4023D; SO14
IC6, IC7: TLE8102SGN; INF-PG-DSO-12-11_N_1PRIMARY
JP1, JP2: JP2E; JP2
LED3, LED4, LED5: green; CHIPLED_0805
Q1, Q2, Q3, Q4: BSS205N; SOT23
R9, R11, R13, R16: 10k; R0805
R10, R15: 1k; R0805
R12, R14, R17: 240R; R0805
R18, R19, R21, R22: 1K; R0805
R20, R23: 10K; R0805
SJ1: SJ
X8: B3B-XH
X9, X10, X11, X12: B4B-XH

Connections:
+3V3: C6.1, IC4.14 (VDD), R18.2, R21.2; also elsewhere on the board
+5V: C7.1, C8.1, C9.1, IC5.14 (VDD), IC6.10 (VDD), IC7.10 (VDD), R10.2, R15.2; also elsewhere on the board
GND: C6.2, C7.2, C8.2, C9.2, IC4.7 (VSS), IC5.7 (VSS), IC6.6 (GND1), IC6.12 (GND2), IC6.13 (HEAT), IC7.6 (GND1), IC7.12 (GND2), IC7.13 (HEAT), Q1.2 (S), Q2.2 (S), Q3.2 (S), Q4.2 (S), R9.1, R11.1, R12.1, R13.1, R14.1, R16.1, R17.1, R20.1, R23.1, X8.P$1 (1); also elsewhere on the board
HS_CO1: IC7.4 (CO1); also elsewhere on the board
HS_RM: Q4.3 (D), R21.1; also elsewhere on the board
HS_RM_EX: R22.2, R23.2, X11.P$3 (3)
IL1: IC5.12 (I1), IC5.13 (I2), R9.2; also elsewhere on the board
IL2: IC5.4 (I1), IC5.5 (I2), R13.2; also elsewhere on the board
ILK1: IC4.11 (I0), JP1.2, Q1.3 (D), SJ1.2; also elsewhere on the board
ILK1_CH: SJ1.1, X8.P$3 (3); also elsewhere on the board
ILK2: IC4.12 (I1), IC4.13 (I2), JP2.2, Q2.3 (D), X8.P$2 (2)
INTERLOCK_OK: IC4.10 (O), IC6.1 (IN2), IC6.7 (IN1), IC7.1 (IN2), IC7.7 (IN1), LED5.A; also elsewhere on the board
MISO: IC6.11 (MISO/ST2), IC7.11 (MISO/ST2); also elsewhere on the board
MOSI: IC6.2 (MOSI), IC7.2 (MOSI); also elsewhere on the board
unnamed: X9.P$4 (4), X10.P$3 (3)
unnamed: IC7.3 (OUT2), X11.P$1 (1)
unnamed: IC6.9 (OUT1), X10.P$1 (1)
unnamed: X11.P$4 (4), X12.P$3 (3)
unnamed: IC6.3 (OUT2), X9.P$1 (1)
unnamed: IC7.9 (OUT1), X12.P$1 (1)
unnamed: JP1.1, R10.1
unnamed: IC5.10 (O), Q1.1 (G)
unnamed: IC5.6 (O), Q2.1 (G)
unnamed: JP2.1, R15.1
unnamed: JP2.3, R16.2
unnamed: JP1.3, R11.2
unnamed: LED5.C, R17.2
unnamed: LED4.C, R14.2
unnamed: LED3.C, R12.2
unnamed: Q3.1 (G), R19.1
unnamed: Q4.1 (G), R22.1
NALERT: IC4.9 (O), LED4.A; also elsewhere on the board
NALERT1: IC4.1 (I0); also elsewhere on the board
NALERT2: IC4.2 (I1); also elsewhere on the board
NALERT3: IC4.8 (I2); also elsewhere on the board
NCS4: IC7.8 (NCS); also elsewhere on the board
NCS5: IC6.8 (NCS); also elsewhere on the board
NFAULT: IC4.6 (O), IC5.3 (I0), IC5.11 (I0), LED3.A; also elsewhere on the board
NFAULT1: IC4.3 (I0); also elsewhere on the board
NFAULT2: IC4.4 (I1); also elsewhere on the board
NFAULT3: IC4.5 (I2); also elsewhere on the board
SCLK: IC6.5 (SCLK), IC7.5 (SCLK); also elsewhere on the board
SLS_CO1: IC6.4 (CO1); also elsewhere on the board
SLS_RM: Q3.3 (D), R18.1; also elsewhere on the board
SLS_RM_EX: R19.2, R20.2, X9.P$3 (3)
VBAT: X9.P$2 (2), X10.P$2 (2), X10.P$4 (4), X11.P$2 (2), X12.P$2 (2), X12.P$4 (4); also elsewhere on the board

Notes on the sheet:
Hauptschütze
Schütze Schnellader

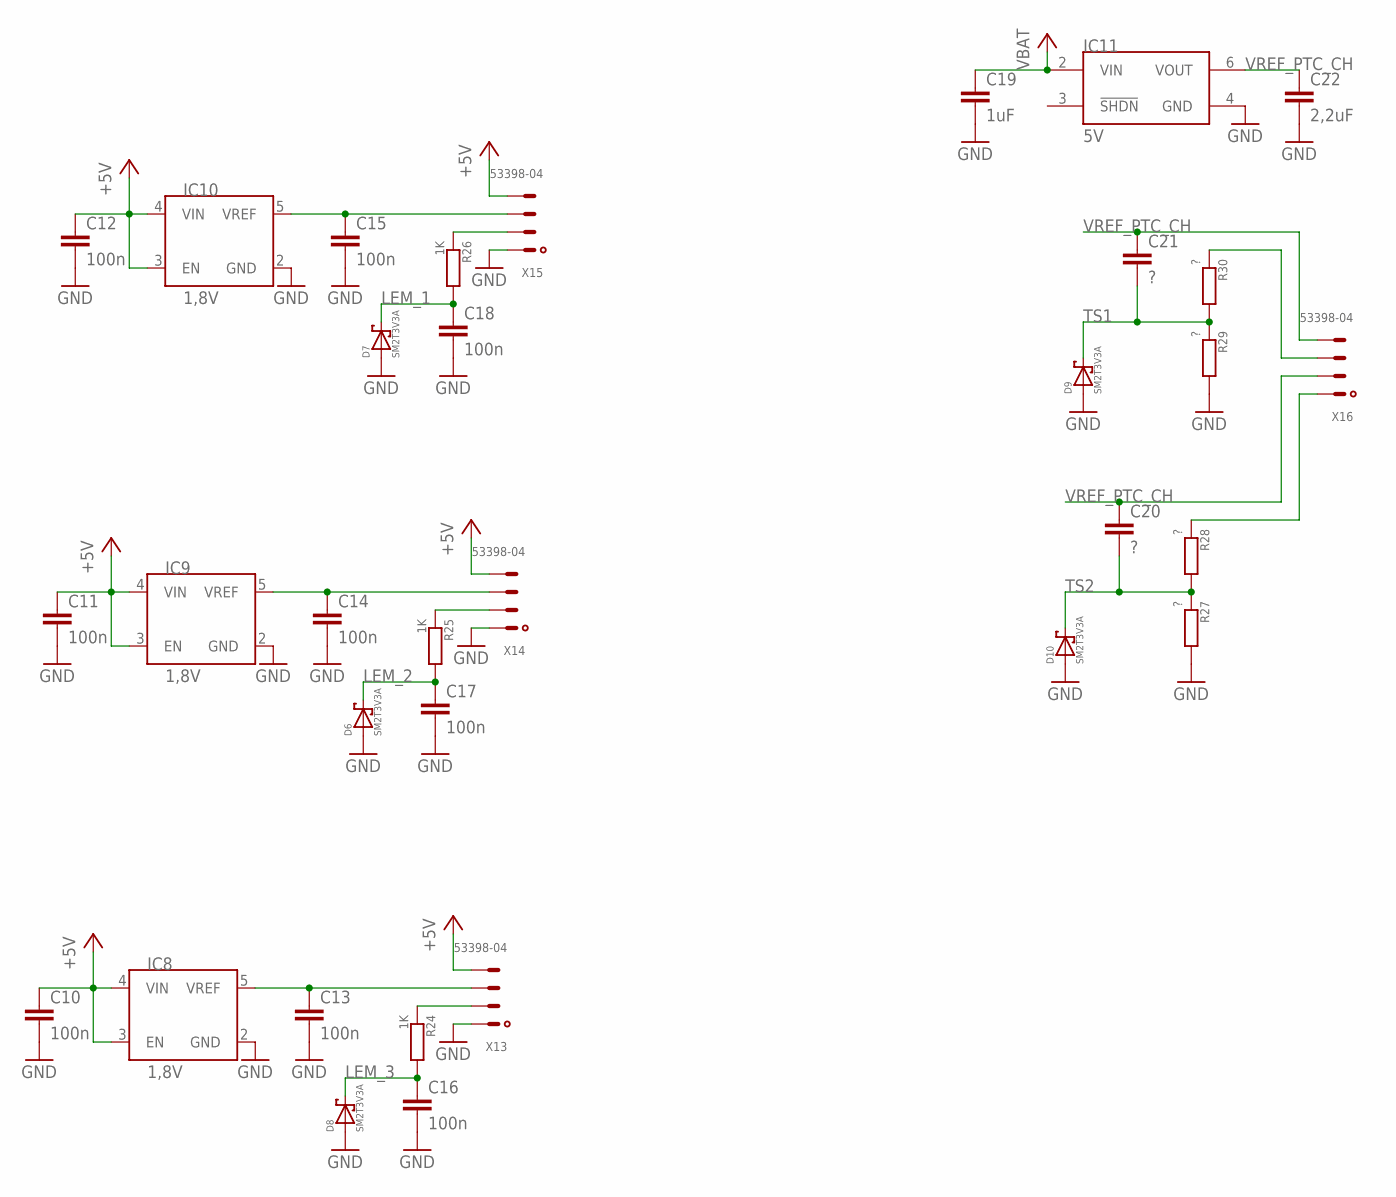
[picture p84: schematic BMS_Master.sch, sheet 5, Analog: - Current Measurment - Charger Temperatur]

Parts:
C10, C11, C12, C13, C14, C15, C16, C17, C18: 100n; C0805
C19: 1uF; C0805
C20, C21: ?; C0805
C22: 2,2uF; C0805
D6, D7, D8, D9, D10: SM2T3V3A
IC8, IC9, IC10: 1,8V; SOT23-5L
IC11: 5V; SO08
R24, R25, R26: 1K; R0805
R27, R28, R29, R30: ?; R0805
X13, X14, X15, X16: 53398-04

Connections:
+5V: C10.1, C11.1, C12.1, IC8.3 (EN), IC8.4 (VIN), IC9.3 (EN), IC9.4 (VIN), IC10.3 (EN), IC10.4 (VIN), X13.4, X14.4, X15.4; also elsewhere on the board
GND: C10.2, C11.2, C12.2, C13.2, C14.2, C15.2, C16.2, C17.2, C18.2, C19.2, C22.2, D6.P$1, D6.P$11, D7.P$1, D7.P$11, D8.P$1, D8.P$11, D9.P$1, D9.P$11, D10.P$1, D10.P$11, IC8.2 (GND), IC9.2 (GND), IC10.2 (GND), IC11.4 (GND), R27.2, R29.2, X13.1, X14.1, X15.1; also elsewhere on the board
LEM_1: C18.1, D7.P$2, R26.2; also elsewhere on the board
LEM_2: C17.1, D6.P$2, R25.2; also elsewhere on the board
LEM_3: C16.1, D8.P$2, R24.2; also elsewhere on the board
unnamed: C13.1, IC8.5 (VREF), X13.3
unnamed: R26.1, X15.2
unnamed: C14.1, IC9.5 (VREF), X14.3
unnamed: R30.1, X16.3
unnamed: R25.1, X14.2
unnamed: C15.1, IC10.5 (VREF), X15.3
unnamed: R24.1, X13.2
unnamed: R28.1, X16.1
TS1: C21.2, D9.P$2, R29.1, R30.2; also elsewhere on the board
TS2: C20.2, D10.P$2, R27.1, R28.2; also elsewhere on the board
VBAT: C19.1, IC11.2 (VIN); also elsewhere on the board
VREF_PTC_CH: C20.1, C21.1, C22.1, IC11.6 (VOUT), X16.2, X16.4

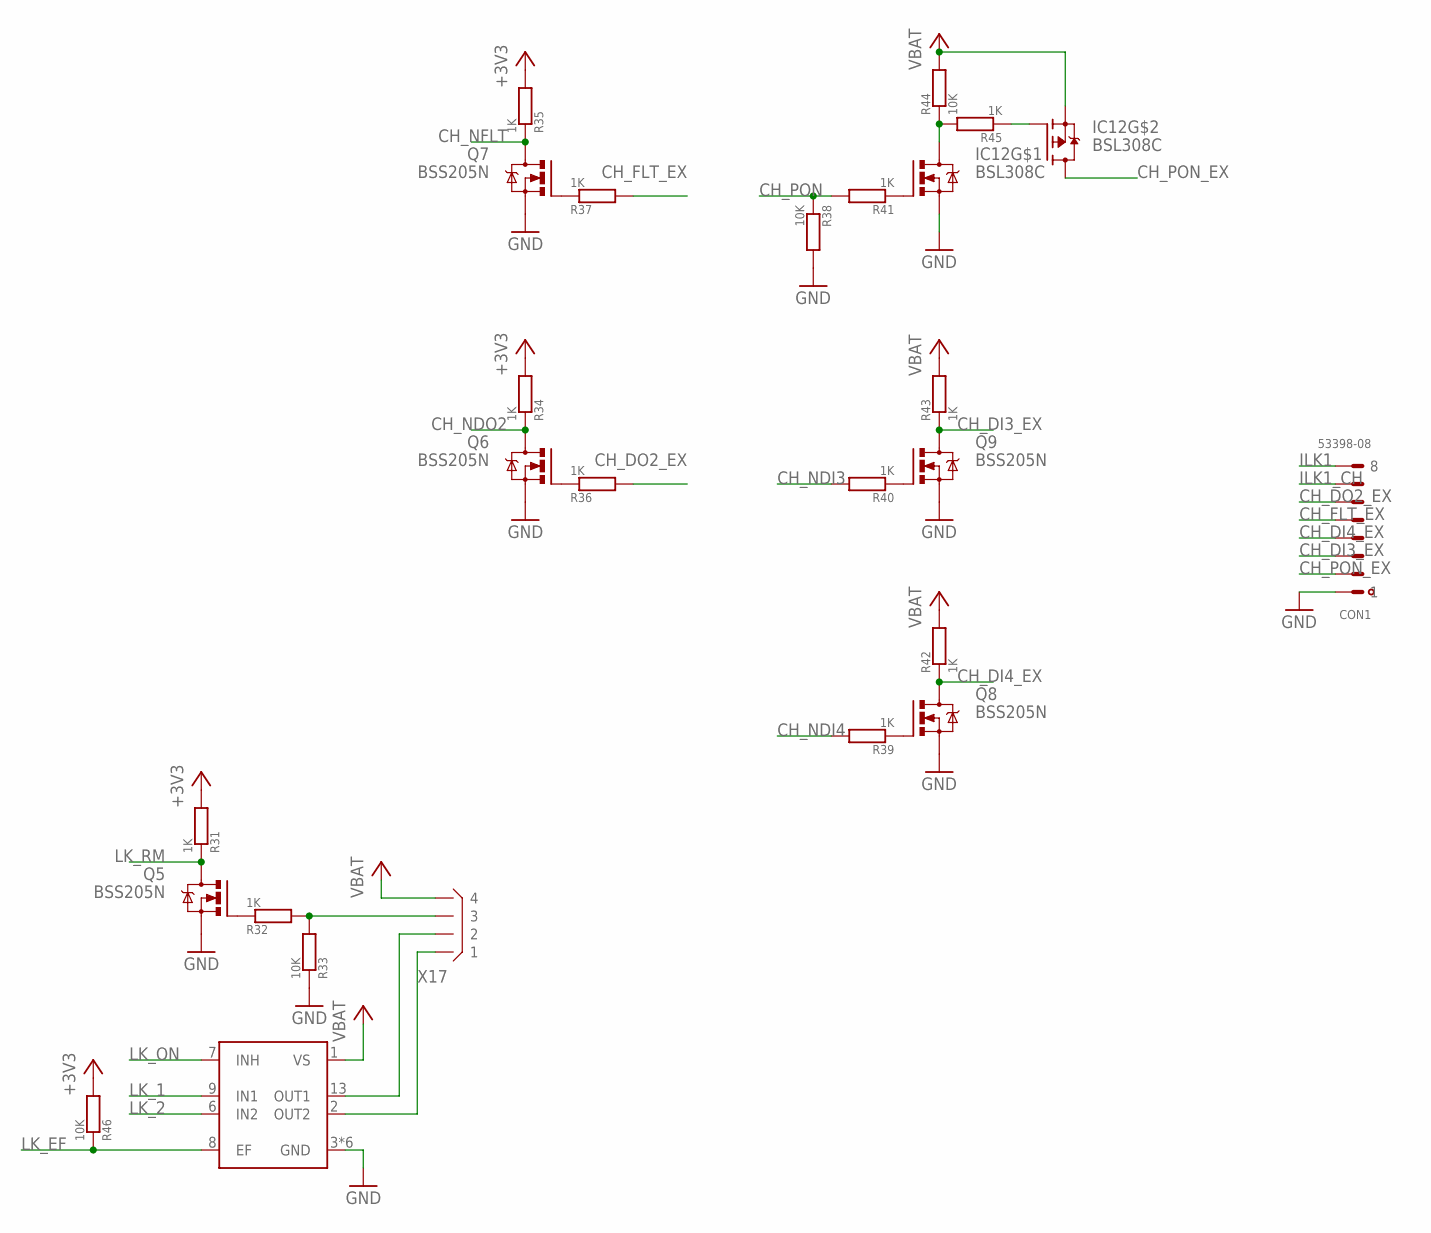
[picture p85: schematic BMS_Master.sch, sheet 6, Charger Interface]

Parts:
CON1: 53398-08
IC12: BSL308C; TSOP-6
IC13: TLE4207GM; INF-PG-DSO-14-22_M_1PRIMARY
Q5, Q6, Q7, Q8, Q9: BSS205N; SOT23
R31, R32, R34, R35, R36, R37, R39, R40, R41, R42, R43, R45: 1K; R0805
R33, R38, R44, R46: 10K; R0805
X17: B4B-XH

Connections:
+3V3: R31.2, R34.2, R35.2, R46.2; also elsewhere on the board
CH_DI3_EX: CON1.3, Q9.3 (D), R43.1
CH_DI4_EX: CON1.4, Q8.3 (D), R42.1
CH_DO2_EX: CON1.6, R36.2
CH_FLT_EX: CON1.5, R37.2
CH_NDI3: R40.2; also elsewhere on the board
CH_NDI4: R39.2; also elsewhere on the board
CH_NDO2: Q6.3 (D), R34.1; also elsewhere on the board
CH_NFLT: Q7.3 (D), R35.1; also elsewhere on the board
CH_PON: R38.1, R41.2; also elsewhere on the board
CH_PON_EX: CON1.2, IC12.P$4 (D)
GND: CON1.1, IC12.P$5 (S), IC13.3 (GND), IC13.4 (GND), IC13.5 (GND), IC13.10 (GND), IC13.11 (GND), IC13.12 (GND), Q5.2 (S), Q6.2 (S), Q7.2 (S), Q8.2 (S), Q9.2 (S), R33.1, R38.2; also elsewhere on the board
ILK1: CON1.8; also elsewhere on the board
ILK1_CH: CON1.7; also elsewhere on the board
LK_1: IC13.9 (IN1); also elsewhere on the board
LK_2: IC13.6 (IN2); also elsewhere on the board
LK_EF: IC13.8 (EF), R46.1; also elsewhere on the board
LK_ON: IC13.7 (INH); also elsewhere on the board
LK_RM: Q5.3 (D), R31.1; also elsewhere on the board
unnamed: Q6.1 (G), R36.1
unnamed: Q9.1 (G), R40.1
unnamed: Q5.1 (G), R32.1
unnamed: R32.2, R33.2, X17.P$3 (3)
unnamed: IC12.P$3 (G), R45.1
unnamed: IC13.13 (OUT1), X17.P$2 (2)
unnamed: IC13.2 (OUT2), X17.P$1 (1)
unnamed: IC12.P$1 (G), R41.1
unnamed: Q8.1 (G), R39.1
unnamed: Q7.1 (G), R37.1
unnamed: IC12.P$6 (D), R44.1, R45.2
VBAT: IC12.P$2 (S), IC13.1 (VS), R42.2, R43.2, R44.2, X17.P$4 (4); also elsewhere on the board

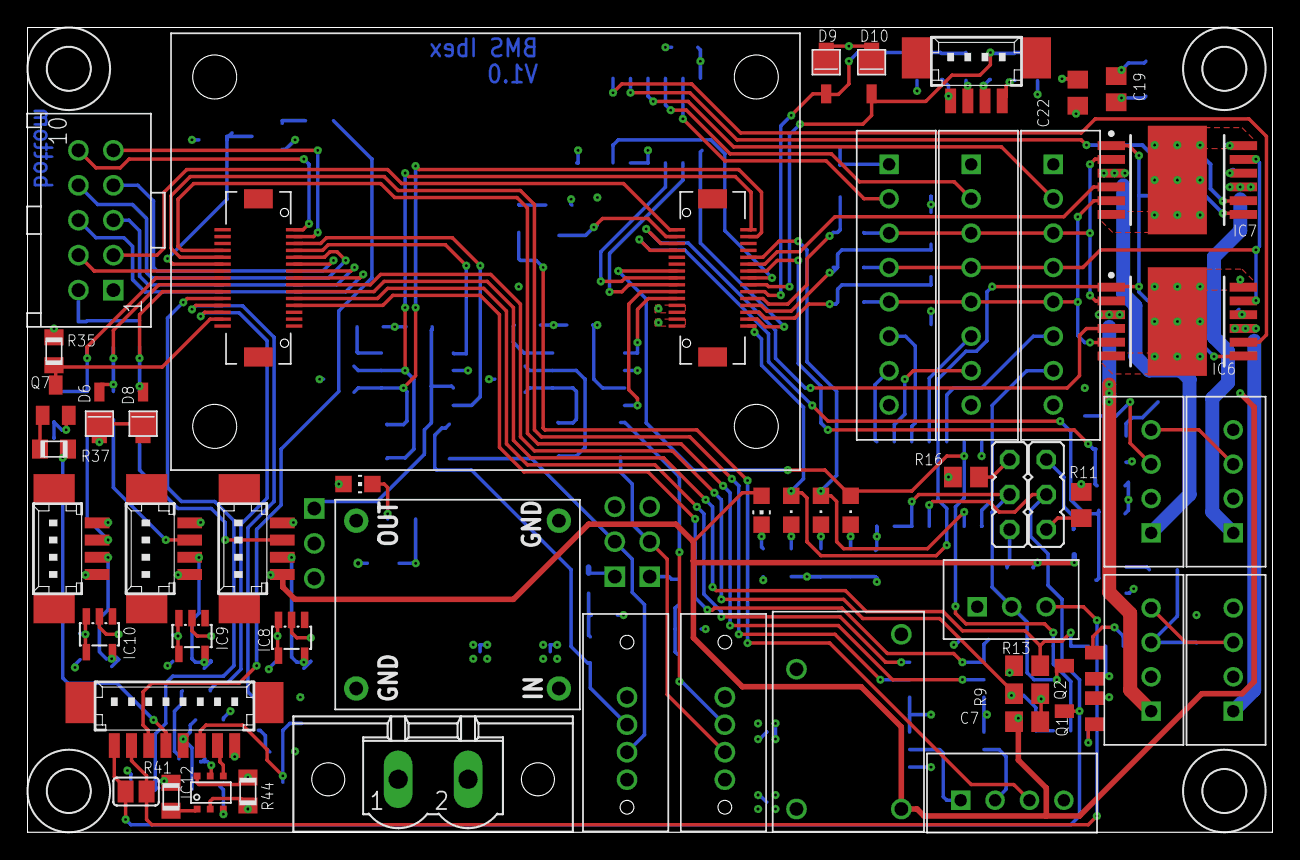
[picture p86: board HW/projects/ibex/BMS_Ibex/Master/BMS_Master_V1/BMS_Master.brd from above]

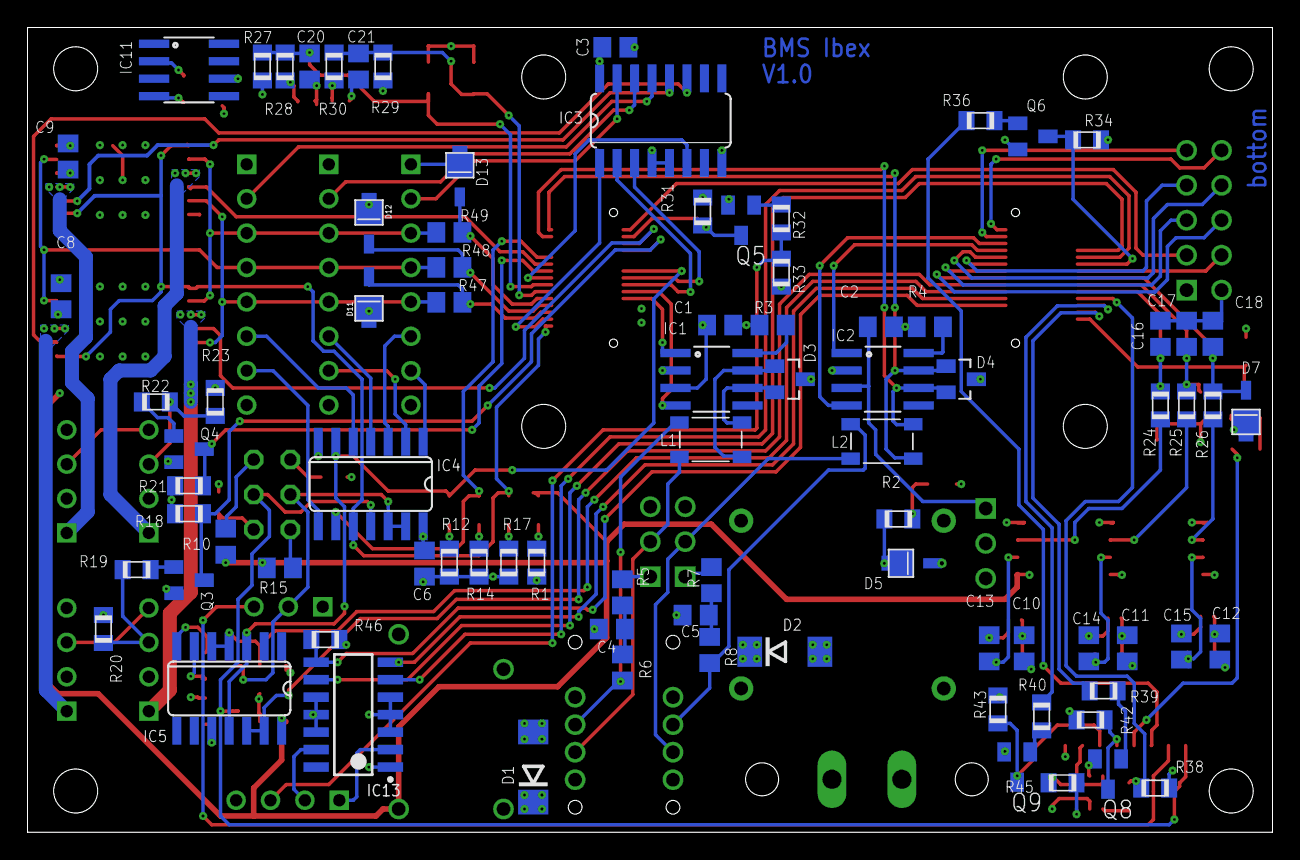
[picture p87: board HW/projects/ibex/BMS_Ibex/Master/BMS_Master_V1/BMS_Master.brd from below]

Board: 4 copper layers, 90.5 x 58.5 mm, 144 parts (84 on the bottom side), 125 nets.
