TERA-TU-Graz/BatteryManagement_2017/HW/projects/ibex/BMS_Ibex/Bus_Isolator/Bus_Isolator_V1/Bus_Isolator.brd

## EAGLE design HW/projects/ibex/BMS_Ibex/Bus_Isolator/Bus_Isolator_V1/Bus_Isolator.brd (2017-08-10, an earlier design)

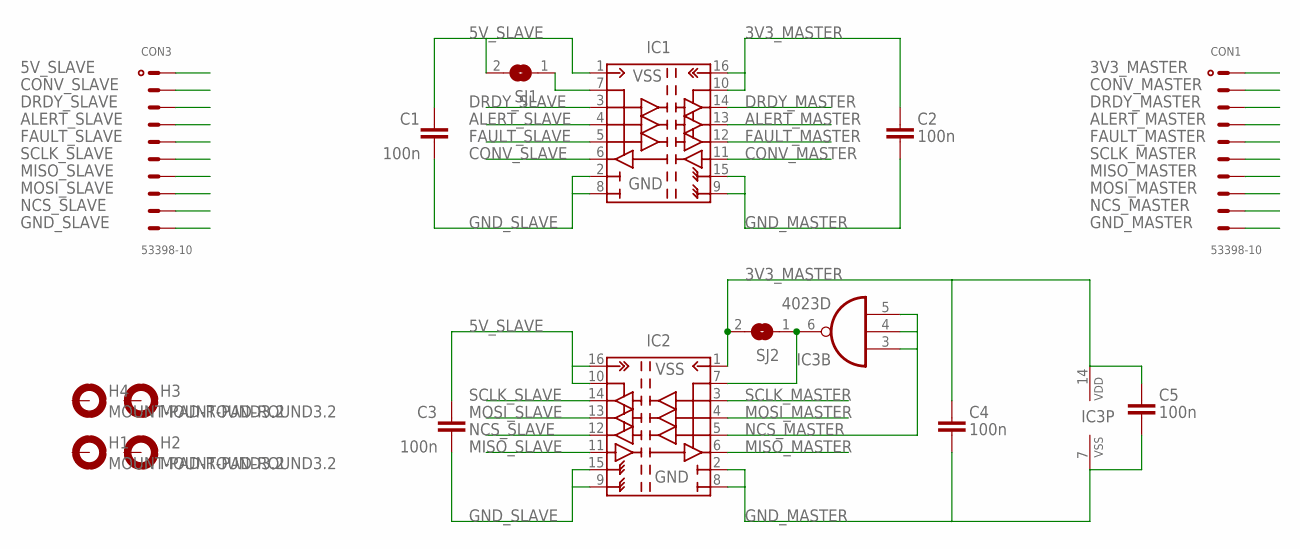
[picture p88: schematic Bus_Isolator.sch]

Parts:
C1, C2, C3, C4, C5: 100n; C0805
CON1, CON3: 53398-10
H1, H2, H3, H4: MOUNT-PAD-ROUND3.2; 3,2-PAD
IC1, IC2: ISO7241; R-PDSO-G16
IC3: 4023D; SO14
SJ1, SJ2: SJ

Connections:
3V3_MASTER: C2.2, C4.2, C5.2, CON1.1, IC1.10 (EN2), IC1.16 (VCC2), IC2.1 (VCC1), IC3.14 (VDD), SJ2.2
5V_SLAVE: C1.2, C3.2, CON3.1, IC1.1 (VCC1), IC2.10 (EN2), IC2.16 (VCC2), SJ1.2
ALERT_MASTER: CON1.4, IC1.13 (OUT_B)
ALERT_SLAVE: CON3.4, IC1.4 (IN_B)
CONV_MASTER: CON1.2, IC1.11 (IN_D)
CONV_SLAVE: CON3.2, IC1.6 (OUT_D)
DRDY_MASTER: CON1.3, IC1.14 (OUT_A)
DRDY_SLAVE: CON3.3, IC1.3 (IN_A)
FAULT_MASTER: CON1.5, IC1.12 (OUT_C)
FAULT_SLAVE: CON3.5, IC1.5 (IN_C)
GND_MASTER: C2.1, C4.1, C5.1, CON1.10, IC1.9 (GND22), IC1.15 (GND21), IC2.2 (GND11), IC2.8 (GND12), IC3.7 (VSS)
GND_SLAVE: C1.1, C3.1, CON3.10, IC1.2 (GND11), IC1.8 (GND12), IC2.9 (GND22), IC2.15 (GND21)
MISO_MASTER: CON1.7, IC2.6 (OUT_D)
MISO_SLAVE: CON3.7, IC2.11 (IN_D)
MOSI_MASTER: CON1.8, IC2.4 (IN_B)
MOSI_SLAVE: CON3.8, IC2.13 (OUT_B)
unnamed: IC1.7 (EN1), SJ1.1
unnamed: IC2.7 (EN1), IC3.6 (O), SJ2.1
NCS_MASTER: CON1.9, IC2.5 (IN_C), IC3.3 (I0), IC3.4 (I1), IC3.5 (I2)
NCS_SLAVE: CON3.9, IC2.12 (OUT_C)
SCLK_MASTER: CON1.6, IC2.3 (IN_A)
SCLK_SLAVE: CON3.6, IC2.14 (OUT_A)

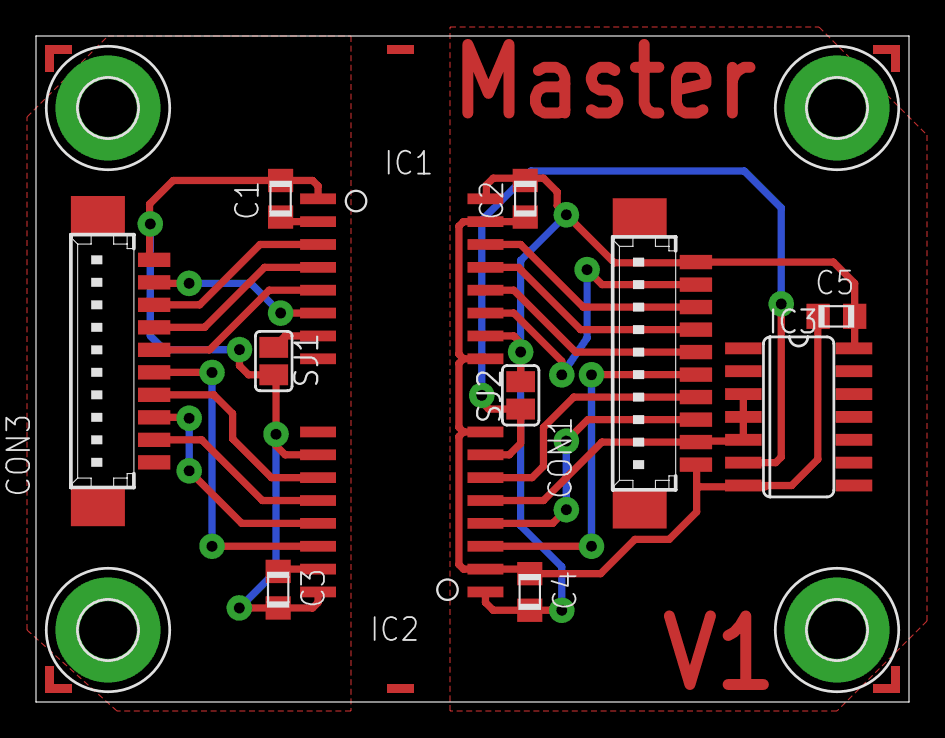
[picture p89: board HW/projects/ibex/BMS_Ibex/Bus_Isolator/Bus_Isolator_V1/Bus_Isolator.b… from above]

Board: 2 copper layers, 48.5 x 37.0 mm, 16 parts (0 on the bottom side), 22 nets.
