TERA-TU-Graz/BatteryManagement_2017/HW/projects/ibex/BMS_Ibex/Interlock/InterlockV1-bad/Interlock.brd

## EAGLE design HW/projects/ibex/BMS_Ibex/Interlock/InterlockV1-bad/Interlock.brd (2017-08-10)

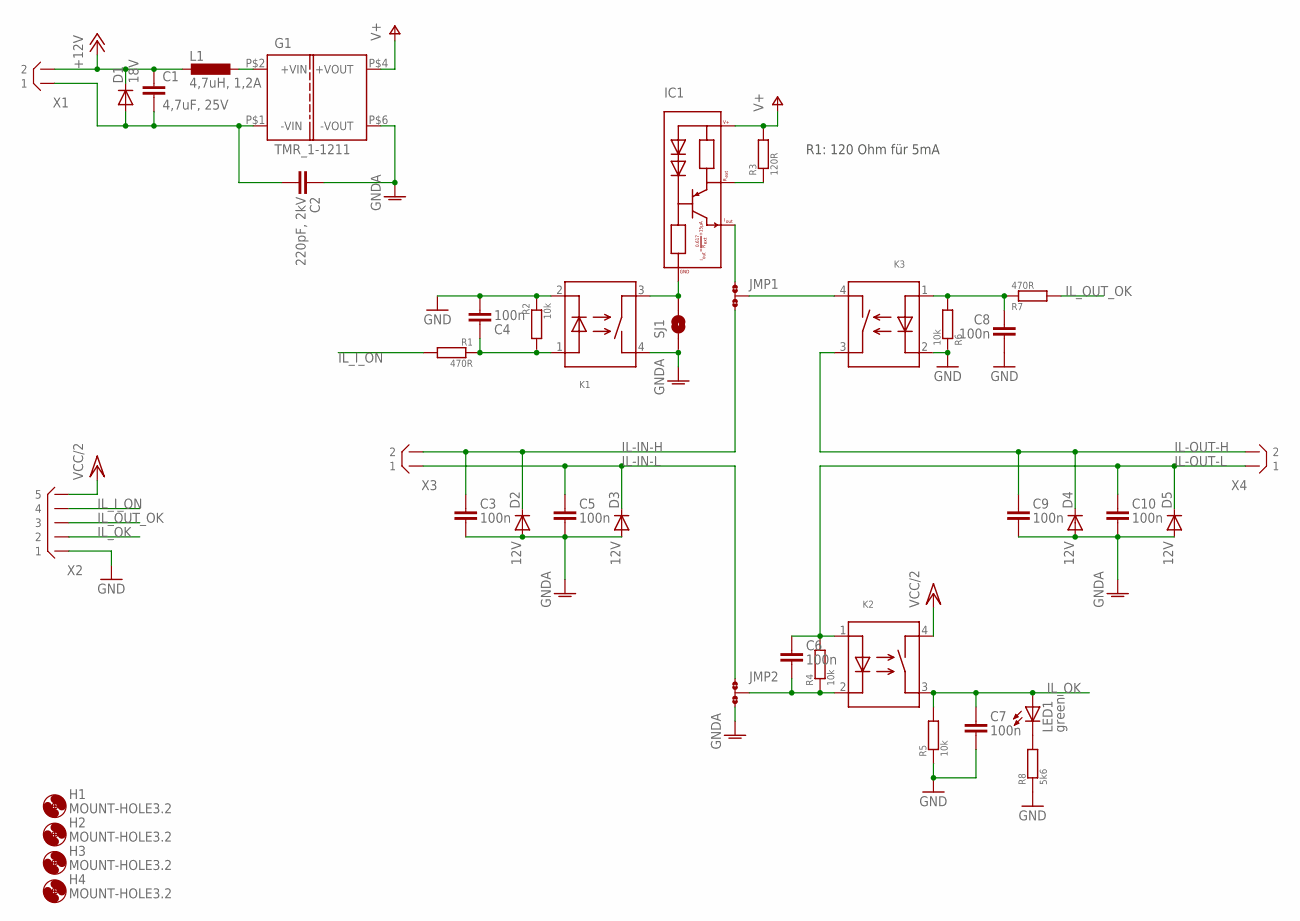
[picture p90: schematic Interlock.sch]

Parts:
C1: 4,7uF, 25V; C0805
C2: 220pF, 2kV; C1210_HV
C3, C4, C5, C6, C7, C8, C9, C10: 100n; C0805
D1: 18V; DO214AA
D2, D3, D4, D5: 12V; DO214AA
G1: TMR_1-1211; TMR_1-??1?
H1, H2, H3, H4: MOUNT-HOLE3.2; 3,2
IC1: PSSI2021SAY; SOT353
JMP1, JMP2: 0R-JUMPA; A0R-JMP
K1, K2, K3: ASSR-1218; SO-4
L1: 4,7uH, 1,2A; L3225M
LED1: green; CHIPLED_0805
R1, R7: 470R; R0805
R2, R4, R5, R6: 10k; R0805
R3: 120R; R0805
R8: 5k6; R0805
SJ1: SOLDERJUMPERNO; SJ_2S-NO
X1, X3, X4: B2B-XH
X2: B5B-XH

Connections:
+12V: C1.1, D1.C, L1.2, X1.P$2 (2)
GND: C4.1, C7.1, C8.1, K1.2 (I-), K3.2 (I-), R2.1, R5.1, R6.1, R8.1, X2.P$1 (1)
GNDA: C2.P$2 (2), C3.1, C5.1, C9.1, C10.1, D2.A, D3.A, D4.A, D5.A, G1.P$6 (-VOUT), JMP2.1, K1.4 (O1), SJ1.1
IL-IN-H: C3.2, D2.C, JMP1.3, X3.P$2 (2)
IL-IN-L: C5.2, D3.C, JMP2.3, X3.P$1 (1)
IL-OUT-H: C9.2, D4.C, K3.3 (O2), X4.P$2 (2)
IL-OUT-L: C6.2, C10.2, D5.C, K2.1 (I+), R4.2, X4.P$1 (1)
IL_I_ON: R1.2, X2.P$4 (4)
IL_OK: C7.2, K2.3 (O2), LED1.A, R5.2, X2.P$2 (2)
IL_OUT_OK: R7.2, X2.P$3 (3)
unnamed: IC1.4 (REXT), R3.1
unnamed: G1.P$2 (+VIN), L1.1
unnamed: C8.2, K3.1 (I+), R6.2, R7.1
unnamed: JMP1.2, K3.4 (O1)
unnamed: C1.2, C2.P$1 (1), D1.A, G1.P$1 (-VIN), X1.P$1 (1)
unnamed: IC1.2 (IOUT), JMP1.1
unnamed: C6.1, JMP2.2, K2.2 (I-), R4.1
unnamed: IC1.3 (GND), K1.3 (O2), SJ1.2
unnamed: C4.2, K1.1 (I+), R1.1, R2.2
unnamed: LED1.C, R8.2
V+: G1.P$4 (+VOUT), IC1.5 (VSS), R3.2
VCC/2: K2.4 (O1), X2.P$5 (5)

Notes on the sheet:
R1: 120 Ohm für 5mA

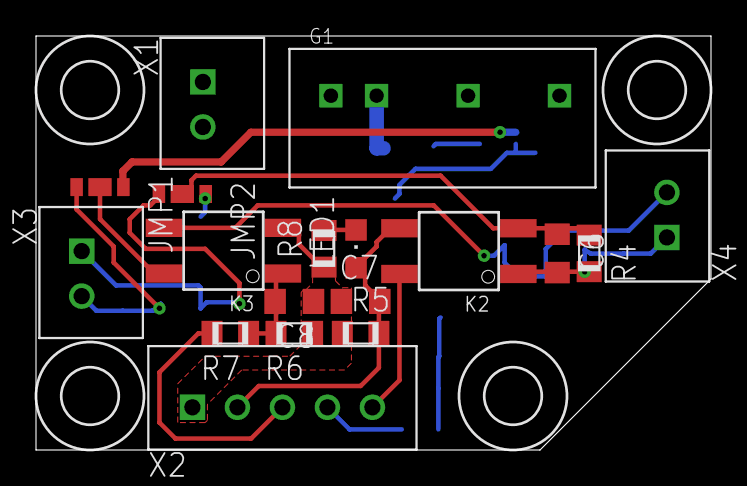
[picture p91: board HW/projects/ibex/BMS_Ibex/Interlock/InterlockV1-bad/Interlock.brd from above]

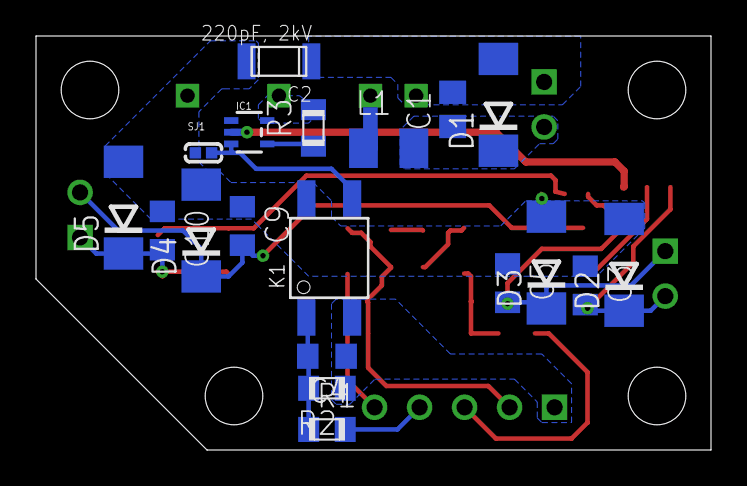
[picture p92: board HW/projects/ibex/BMS_Ibex/Interlock/InterlockV1-bad/Interlock.brd from below]

Board: 4 copper layers, 37.5 x 23.0 mm, 41 parts (19 on the bottom side), 22 nets.
