TERA-TU-Graz/BatteryManagement_2017/HW/projects/ibex/BMS_Ibex/Bus_Isolator/Bus_Isolator_V2/Bus_Isolator.brd

## EAGLE design HW/projects/ibex/BMS_Ibex/Bus_Isolator/Bus_Isolator_V2/Bus_Isolator.brd (2017-08-10, an earlier design)

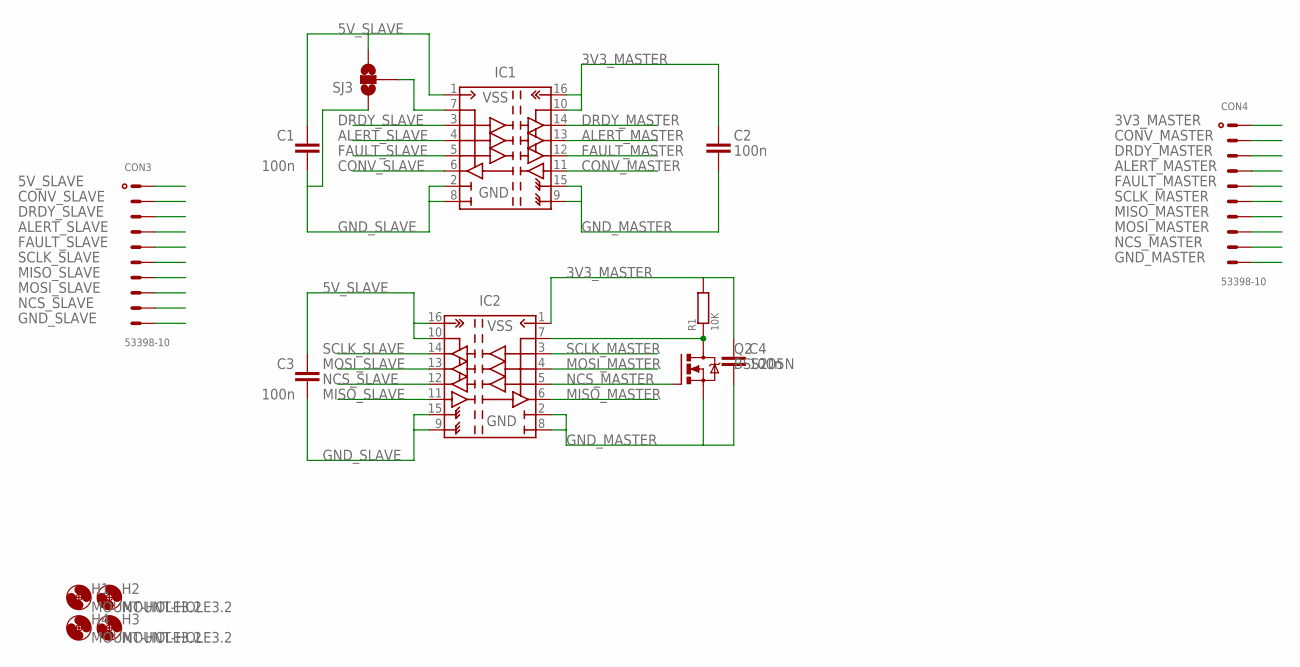
[picture p93: schematic Bus_Isolator.sch]

Parts:
C1, C2, C3, C4: 100n; C0805
CON3, CON4: 53398-10
H1, H2, H3, H4: MOUNT-HOLE3.2; 3,2
IC1, IC2: ISO7241; R-PDSO-G16
Q2: BSS205N; SOT23
R1: 10K; R0805
SJ3: SOLDERJUMPER_2WAYS; SJ_3

Connections:
3V3_MASTER: C2.2, C4.2, CON4.1, IC1.10 (EN2), IC1.16 (VCC2), IC2.1 (VCC1), R1.2
5V_SLAVE: C1.2, C3.2, CON3.1, IC1.1 (VCC1), IC2.10 (EN2), IC2.16 (VCC2), SJ3.3
ALERT_MASTER: CON4.4, IC1.13 (OUT_B)
ALERT_SLAVE: CON3.4, IC1.4 (IN_B)
CONV_MASTER: CON4.2, IC1.11 (IN_D)
CONV_SLAVE: CON3.2, IC1.6 (OUT_D)
DRDY_MASTER: CON4.3, IC1.14 (OUT_A)
DRDY_SLAVE: CON3.3, IC1.3 (IN_A)
FAULT_MASTER: CON4.5, IC1.12 (OUT_C)
FAULT_SLAVE: CON3.5, IC1.5 (IN_C)
GND_MASTER: C2.1, C4.1, CON4.10, IC1.9 (GND22), IC1.15 (GND21), IC2.2 (GND11), IC2.8 (GND12), Q2.2 (S)
GND_SLAVE: C1.1, C3.1, CON3.10, IC1.2 (GND11), IC1.8 (GND12), IC2.9 (GND22), IC2.15 (GND21), SJ3.1
MISO_MASTER: CON4.7, IC2.6 (OUT_D)
MISO_SLAVE: CON3.7, IC2.11 (IN_D)
MOSI_MASTER: CON4.8, IC2.4 (IN_B)
MOSI_SLAVE: CON3.8, IC2.13 (OUT_B)
unnamed: IC1.7 (EN1), SJ3.2
unnamed: IC2.7 (EN1), Q2.3 (D), R1.1
NCS_MASTER: CON4.9, IC2.5 (IN_C), Q2.1 (G)
NCS_SLAVE: CON3.9, IC2.12 (OUT_C)
SCLK_MASTER: CON4.6, IC2.3 (IN_A)
SCLK_SLAVE: CON3.6, IC2.14 (OUT_A)

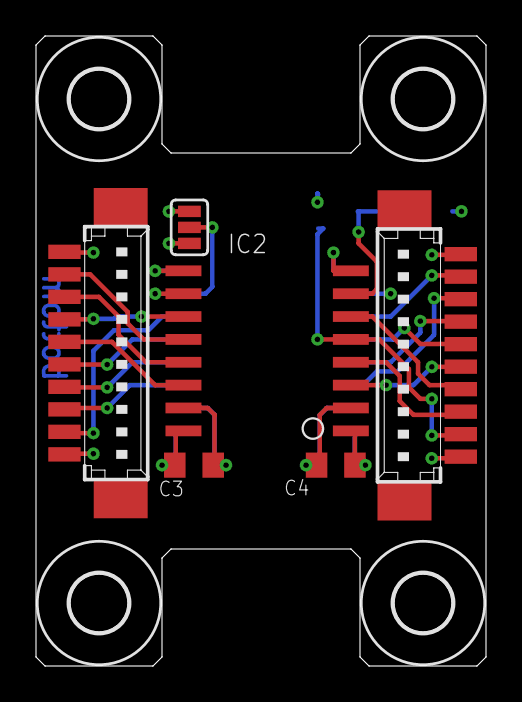
[picture p94: board HW/projects/ibex/BMS_Ibex/Bus_Isolator/Bus_Isolator_V2/Bus_Isolator.b… from above]

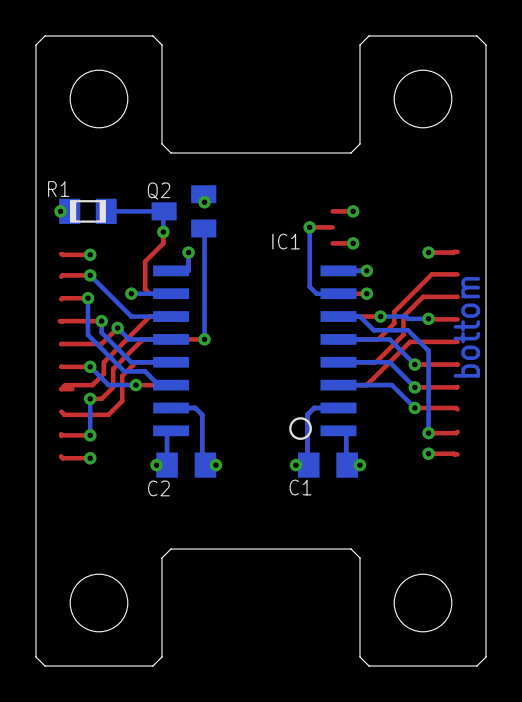
[picture p95: board HW/projects/ibex/BMS_Ibex/Bus_Isolator/Bus_Isolator_V2/Bus_Isolator.b… from below]

Board: 4 copper layers, 25.0 x 35.0 mm, 15 parts (5 on the bottom side), 22 nets.
