TERA-TU-Graz/BatteryManagement_2017/HW/projects/ibex/bordnet_and_charger_interface/BordnetzwandlerV1/Bordnetzwandler.brd

## EAGLE design HW/projects/ibex/bordnet_and_charger_interface/BordnetzwandlerV1/Bordnetzwandler.brd (2017-08-10, an earlier design)

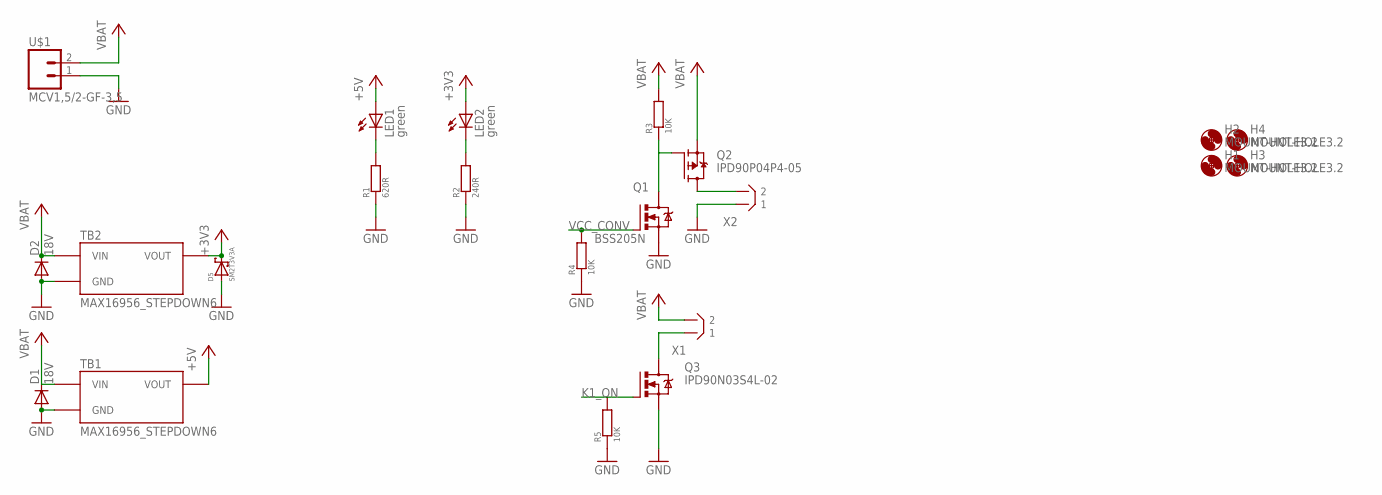
[picture p96: schematic Bordnetzwandler.sch, sheet 1, Supply]

Parts:
D1, D2: 18V; DO214AA
D5: SM2T3V3A
H1, H2, H3, H4: MOUNT-HOLE3.2; 3,2
LED1, LED2: green; CHIP-LED0805
Q1: BSS205N; SOT23
Q2: IPD90P04P4-05; TO252
Q3: IPD90N03S4L-02; TO252
R1: 620R; R0805
R2: 240R; R0805
R3, R4, R5: 10K; R0805
TB1, TB2: MAX16956_STEPDOWN6
U$1: MCV1,5/2-GF-3,5
X1, X2: B2B-XH

Connections:
+3V3: D5.P$2, LED2.A, TB2.VOUT; also elsewhere on the board
+5V: LED1.A, TB1.VOUT; also elsewhere on the board
GND: D1.A, D2.A, D5.P$1, D5.P$11, Q1.2 (S), Q3.3 (S), R1.1, R2.1, R4.1, R5.1, TB1.GND, TB1.GND2 (GND), TB2.GND, TB2.GND2 (GND), U$1.1, X2.P$1 (1); also elsewhere on the board
K1_ON: Q3.1 (G), R5.2; also elsewhere on the board
unnamed: LED1.C, R1.2
unnamed: LED2.C, R2.2
unnamed: Q1.3 (D), Q2.1 (G), R3.1
unnamed: Q2.2 (D), X2.P$2 (2)
unnamed: Q3.2 (D), X1.P$1 (1)
VBAT: D1.C, D2.C, Q2.3 (S), R3.2, TB1.VIN, TB2.VIN, U$1.2, X1.P$2 (2); also elsewhere on the board
VCC_CONV: Q1.1 (G), R4.2; also elsewhere on the board
