TERA-TU-Graz/BatteryManagement_2017/HW/projects/ibex/bordnet_and_charger_interface/BordnetzwandlerV1/Bordnetzwandler.brd

## EAGLE design HW/projects/ibex/bordnet_and_charger_interface/BordnetzwandlerV1/Bordnetzwandler.brd (continued)

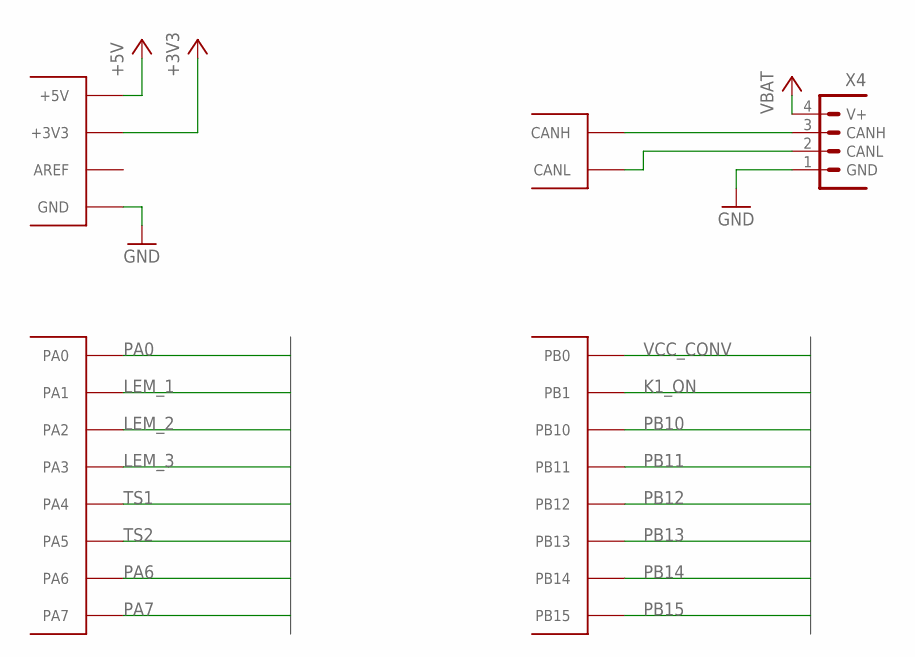
[picture p97: schematic Bordnetzwandler.sch, sheet 2, Prozessor]

Parts:
CANIO_1: STM32F103XX_CAN-IO-EXPANDER; STM32F103XX_CANIO-EXPANDER
X4: CIOC_4-1-FV-A_CAN-BELEGUNG; CIOC_4-1-FV

Connections:
+3V3: CANIO_1.VCC (+3V3); also elsewhere on the board
+5V: CANIO_1.+5V; also elsewhere on the board
CAN1_H: CANIO_1.CANH, X4.3 (CANH)
CAN1_L: CANIO_1.CANL, X4.2 (CANL)
GND: CANIO_1.GND1 (GND), X4.1 (GND); also elsewhere on the board
K1_ON: CANIO_1.PB1; also elsewhere on the board
LEM_1: CANIO_1.PA1; also elsewhere on the board
LEM_2: CANIO_1.PA2; also elsewhere on the board
LEM_3: CANIO_1.PA3; also elsewhere on the board
PA0: CANIO_1.PA0
PA6: CANIO_1.PA6
PA7: CANIO_1.PA7
PB10: CANIO_1.PB10
PB11: CANIO_1.PB11
PB12: CANIO_1.PB12
PB13: CANIO_1.PB13
PB14: CANIO_1.PB14
PB15: CANIO_1.PB15
TS1: CANIO_1.PA4; also elsewhere on the board
TS2: CANIO_1.PA5; also elsewhere on the board
VBAT: X4.4 (V+); also elsewhere on the board
VCC_CONV: CANIO_1.PB0; also elsewhere on the board

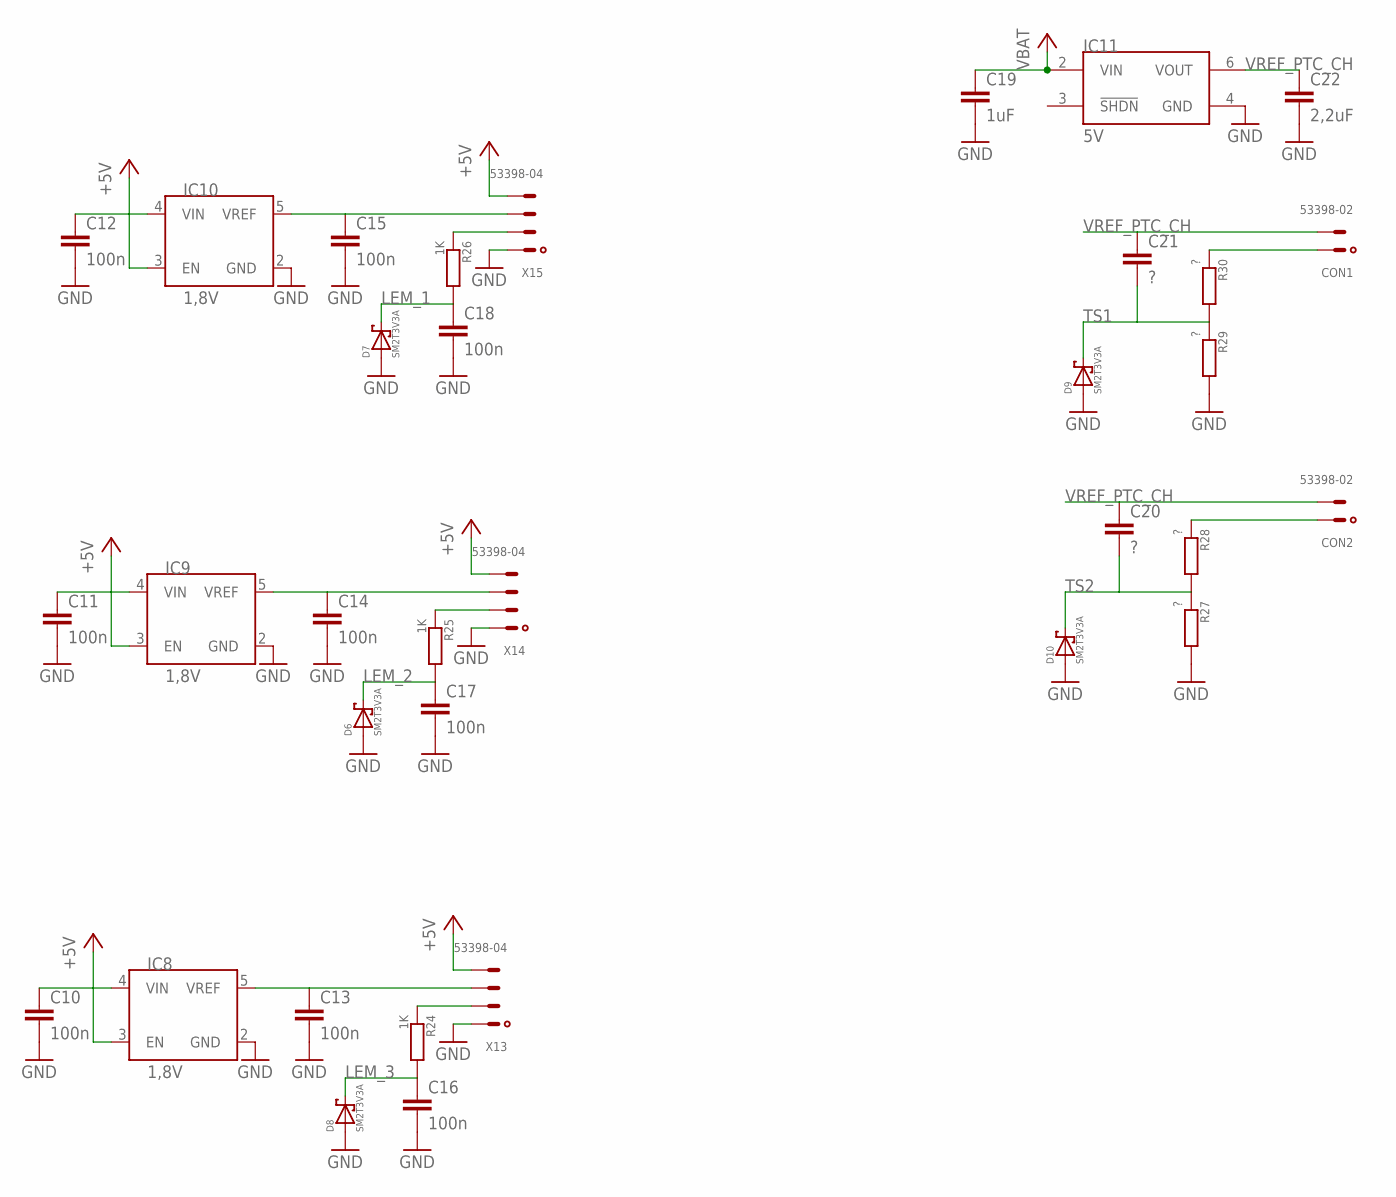
[picture p98: schematic Bordnetzwandler.sch, sheet 3, IO]

Parts:
C10, C11, C12, C13, C14, C15, C16, C17, C18: 100n; C0805
C19: 1uF; C0805
C20, C21: ?; C0805
C22: 2,2uF; C0805
CON1, CON2: 53398-02
D6, D7, D8, D9, D10: SM2T3V3A
IC8, IC9, IC10: 1,8V; SOT23-5L
IC11: 5V; SO08
R24, R25, R26: 1K; R0805
R27, R28, R29, R30: ?; R0805
X13, X14, X15: 53398-04

Connections:
+5V: C10.1, C11.1, C12.1, IC8.3 (EN), IC8.4 (VIN), IC9.3 (EN), IC9.4 (VIN), IC10.3 (EN), IC10.4 (VIN), X13.4, X14.4, X15.4; also elsewhere on the board
GND: C10.2, C11.2, C12.2, C13.2, C14.2, C15.2, C16.2, C17.2, C18.2, C19.2, C22.2, D6.P$1, D6.P$11, D7.P$1, D7.P$11, D8.P$1, D8.P$11, D9.P$1, D9.P$11, D10.P$1, D10.P$11, IC8.2 (GND), IC9.2 (GND), IC10.2 (GND), IC11.4 (GND), R27.2, R29.2, X13.1, X14.1, X15.1; also elsewhere on the board
LEM_1: C18.1, D7.P$2, R26.2; also elsewhere on the board
LEM_2: C17.1, D6.P$2, R25.2; also elsewhere on the board
LEM_3: C16.1, D8.P$2, R24.2; also elsewhere on the board
unnamed: C13.1, IC8.5 (VREF), X13.3
unnamed: R26.1, X15.2
unnamed: C14.1, IC9.5 (VREF), X14.3
unnamed: CON1.1, R30.1
unnamed: R25.1, X14.2
unnamed: C15.1, IC10.5 (VREF), X15.3
unnamed: R24.1, X13.2
unnamed: CON2.1, R28.1
TS1: C21.2, D9.P$2, R29.1, R30.2; also elsewhere on the board
TS2: C20.2, D10.P$2, R27.1, R28.2; also elsewhere on the board
VBAT: C19.1, IC11.2 (VIN); also elsewhere on the board
VREF_PTC_CH: C20.1, C21.1, C22.1, CON1.2, CON2.2, IC11.6 (VOUT)

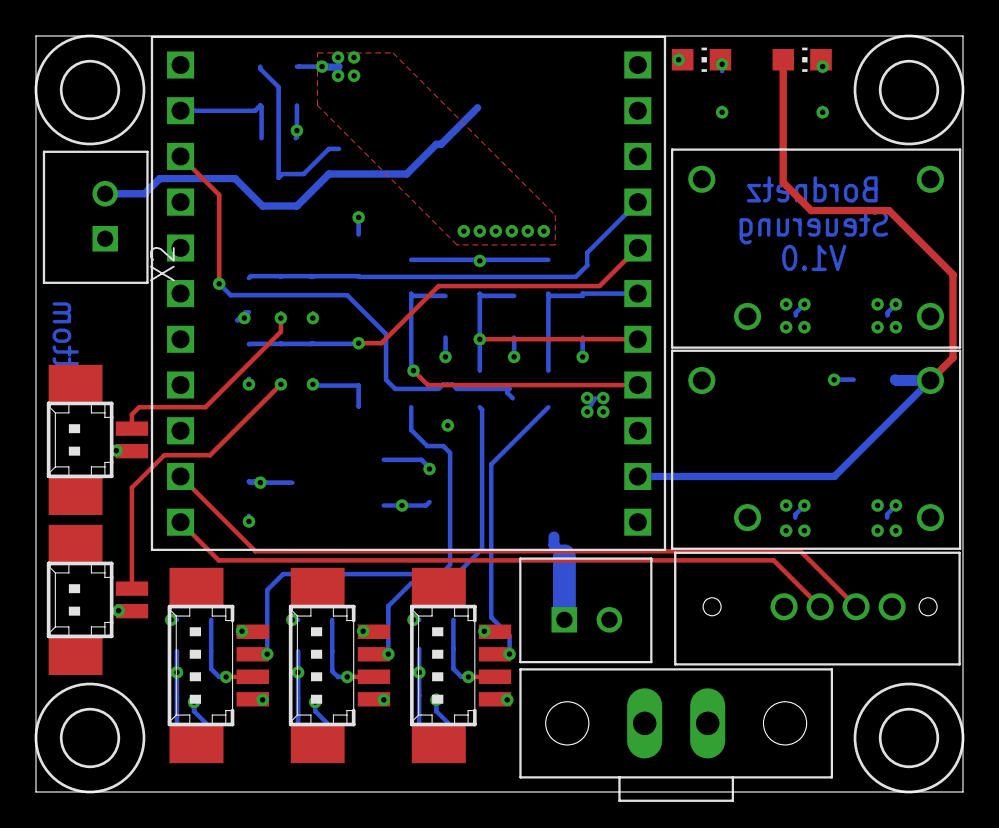
[picture p99: board HW/projects/ibex/bordnet_and_charger_interface/BordnetzwandlerV1/Bord… from above]

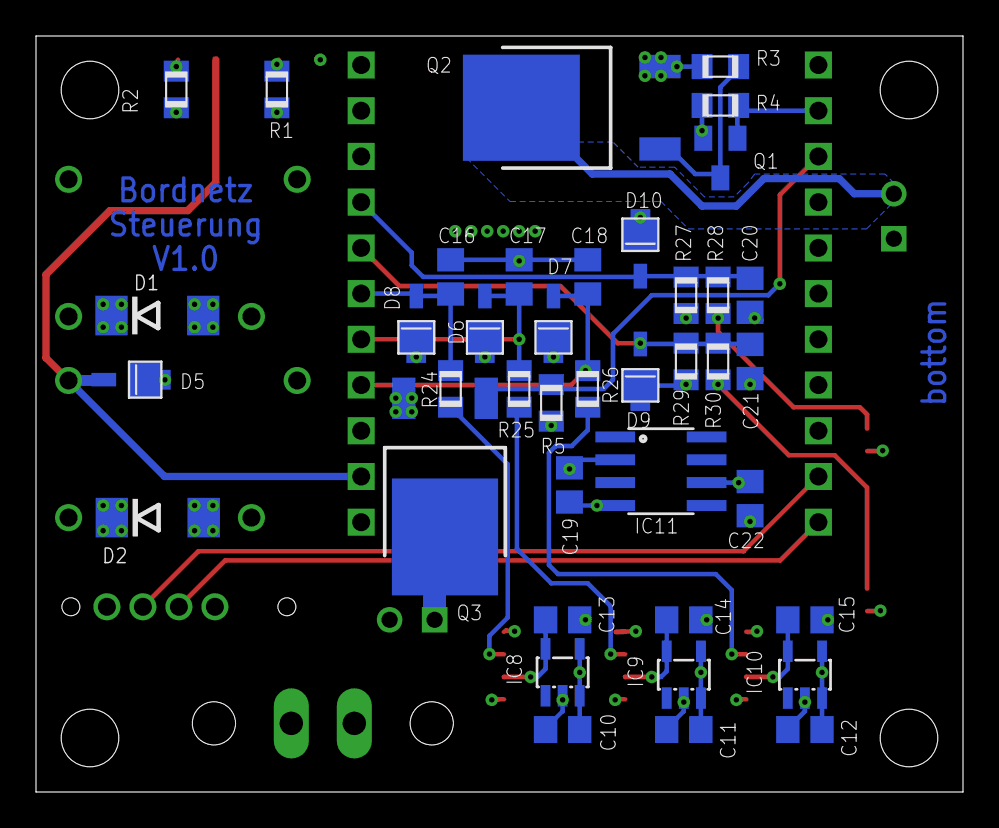
[picture p100: board HW/projects/ibex/bordnet_and_charger_interface/BordnetzwandlerV1/Bord… from below]

Board: 4 copper layers, 51.5 x 42.0 mm, 58 parts (40 on the bottom side), 27 nets.
