TERA-TU-Graz/BatteryManagement_2017/HW/projects/ibex/BMS_Ibex/Vorladeschaltung/Vorladeschaltung V1/Vorladeschaltung.brd

## EAGLE design HW/projects/ibex/BMS_Ibex/Vorladeschaltung/Vorladeschaltung V1/Vorladeschaltung.brd (2017-08-10)

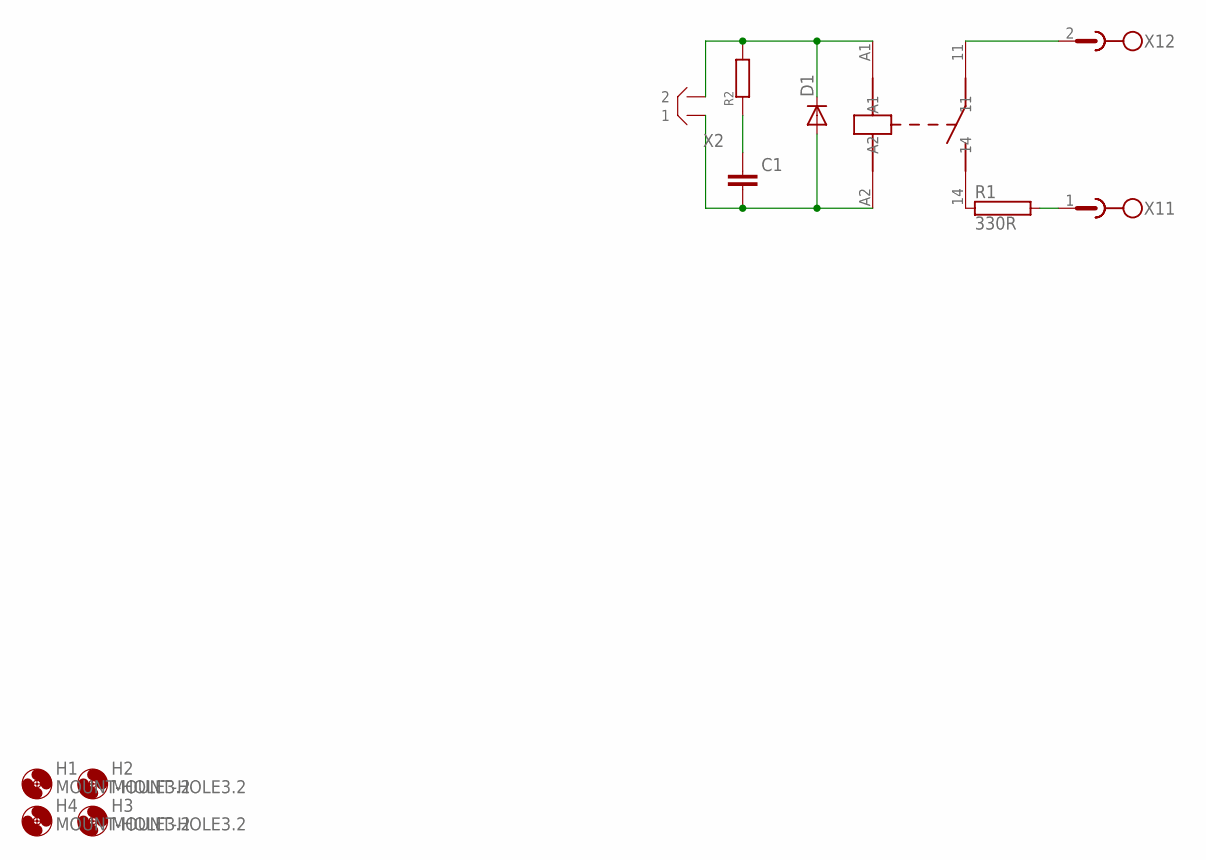
[picture p101: schematic Vorladeschaltung.sch]

Parts:
C1: CSTD; C0805
D1: DIODE-SOD323-W; SOD323-W
H1, H2, H3, H4: MOUNT-HOLE3.2; 3,2
K1: OJ-SH-112DMBIG; RELAIS-TE-OJ-BIG
R1: 330R; WH25
R2: R; R0805
X1: MSTBX2MSTBA2; MSTBA2
X2: B-BIG2B-XH; B2B-XH-BIG

Connections:
unnamed: K1.14, R1.1
unnamed: D1.C, K1.A1, R2.2, X2.P$2 (2)
unnamed: C1.1, D1.A, K1.A2, X2.P$1 (1)
unnamed: K1.11, X1.2
unnamed: R1.2, X1.1
unnamed: C1.2, R2.1

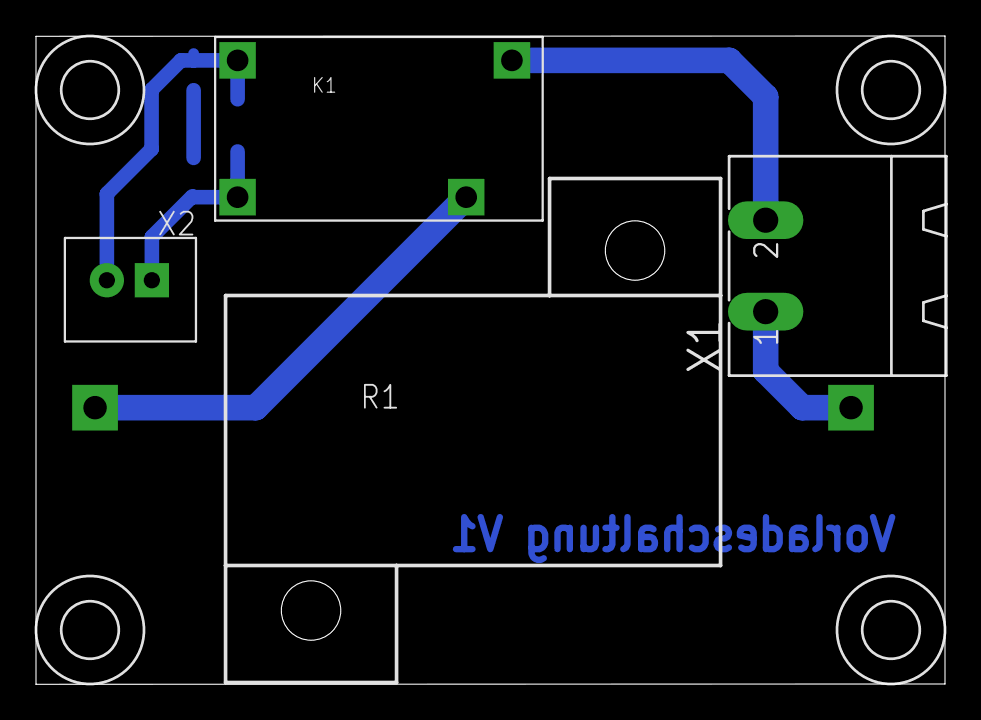
[picture p102: board Vorladeschaltung.brd from above]

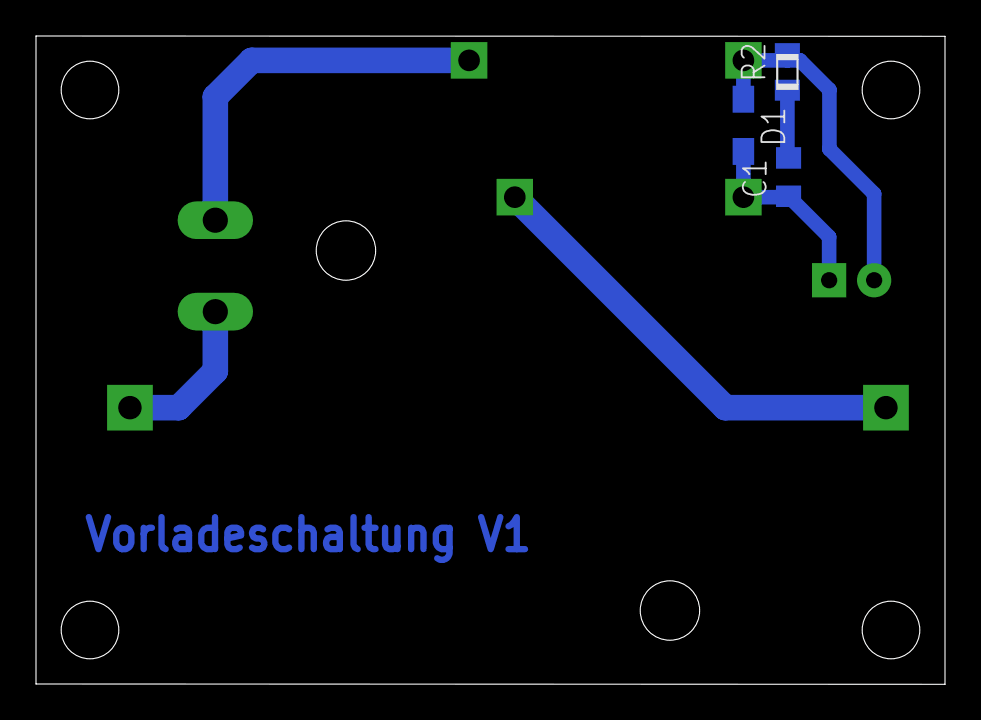
[picture p103: board Vorladeschaltung.brd from below]

Board: 4 copper layers, 50.5 x 36.0 mm, 11 parts (3 on the bottom side), 6 nets.
