TERA-TU-Graz/BatteryManagement_2017/HW/projects/ibex/BMS_Ibex/HostInterfaceSplitter/HostInterfaceSplitter-V1/HostInterfaceSplitter.brd

## EAGLE design HW/projects/ibex/BMS_Ibex/HostInterfaceSplitter/HostInterfaceSplitter-V1/HostInterfaceSplitter.brd (2017-08-10, an earlier design)

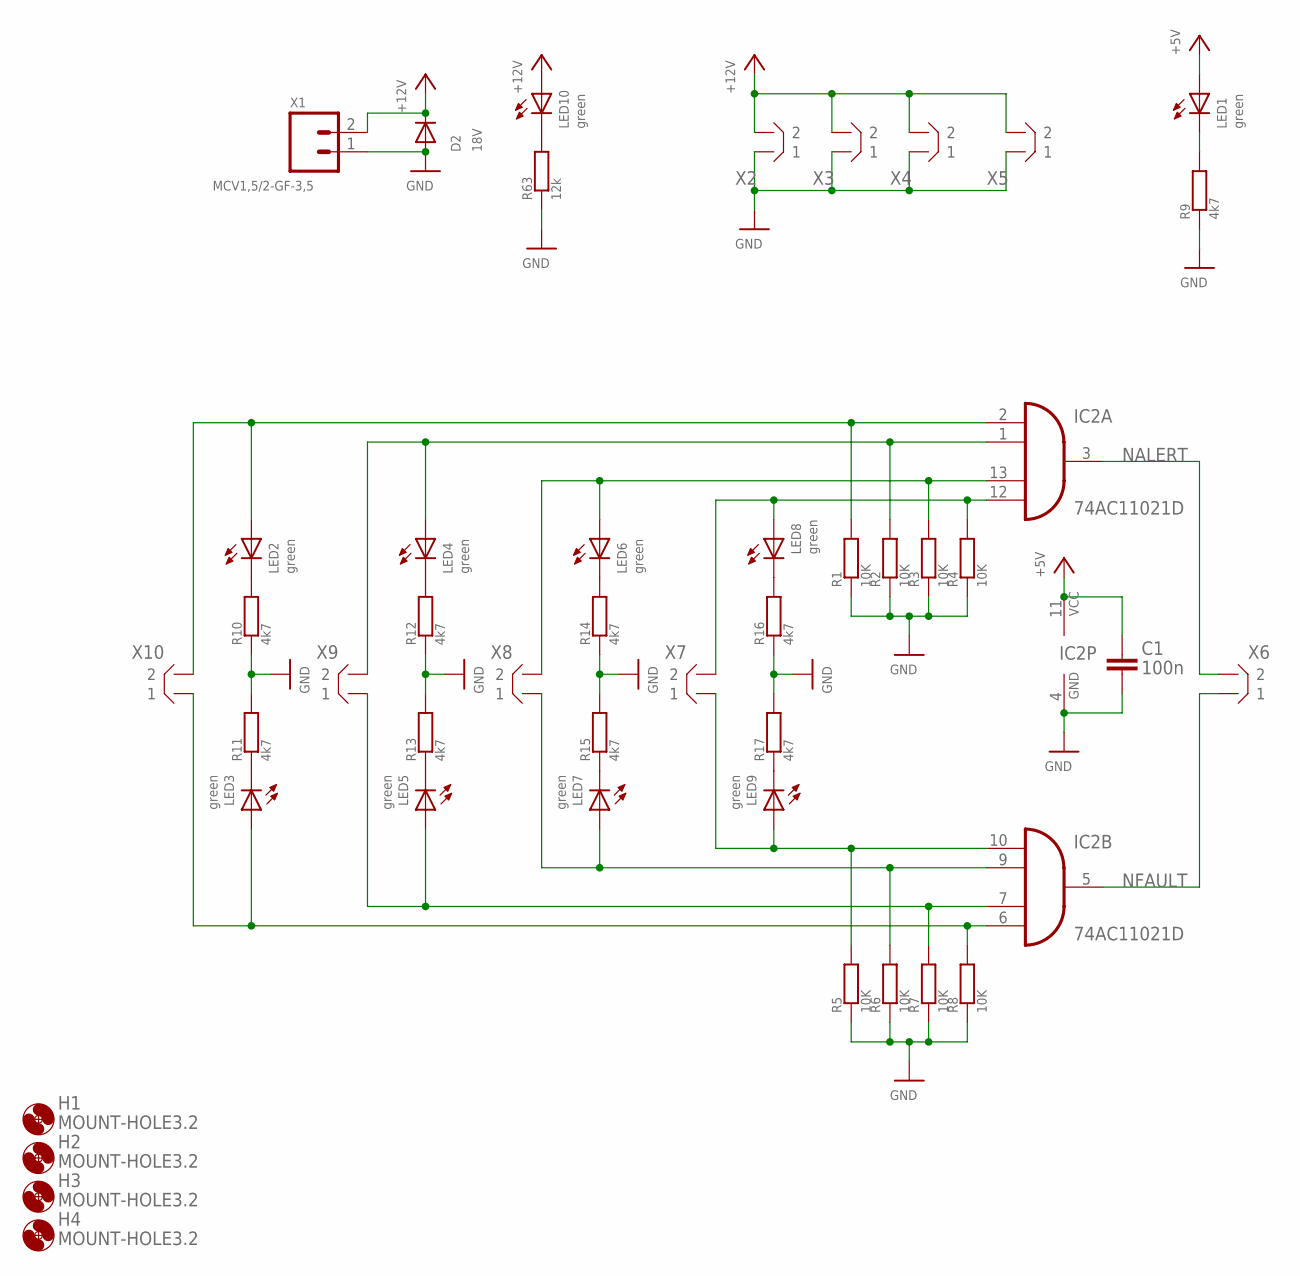
[picture p104: schematic HostInterfaceSplitter.sch, sheet 1]

Parts:
C1: 100n; C0603
D2: 18V; DO214AA
H1, H2, H3, H4: MOUNT-HOLE3.2; 3,2
IC2: 74AC11021D; SO14
LED1, LED2, LED3, LED4, LED5, LED6, LED7, LED8, LED9, LED10: green; CHIP-LED0805
R1, R2, R3, R4, R5, R6, R7, R8: 10K; R0603
R9, R10, R11, R12, R13, R14, R15, R16, R17: 4k7; R0805
R63: 12k; R0805
X1: MCV1,5/2-GF-3,5
X2, X3, X4, X5, X6, X7, X8, X9, X10: B2B-XH

Connections:
+5V: C1.2, IC2.11 (VCC), LED1.A; also elsewhere on the board
+12V: D2.C, LED10.A, X1.2, X2.P$2 (2), X3.P$2 (2), X4.P$2 (2), X5.P$2 (2)
GND: C1.1, D2.A, IC2.4 (GND), R1.1, R2.1, R3.1, R4.1, R5.1, R6.1, R7.1, R8.1, R9.1, R10.1, R11.2, R12.1, R13.2, R14.1, R15.2, R16.1, R17.2, R63.1, X1.1, X2.P$1 (1), X3.P$1 (1), X4.P$1 (1), X5.P$1 (1); also elsewhere on the board
unnamed: IC2.6 (I3), LED3.A, R8.2, X10.P$1 (1)
unnamed: IC2.12 (I3), LED8.A, R4.2, X7.P$2 (2)
unnamed: IC2.13 (I2), LED6.A, R3.2, X8.P$2 (2)
unnamed: IC2.1 (I1), LED4.A, R2.2, X9.P$2 (2)
unnamed: IC2.2 (I0), LED2.A, R1.2, X10.P$2 (2)
unnamed: IC2.7 (I2), LED5.A, R7.2, X9.P$1 (1)
unnamed: IC2.9 (I1), LED7.A, R6.2, X8.P$1 (1)
unnamed: IC2.10 (I0), LED9.A, R5.2, X7.P$1 (1)
unnamed: LED1.C, R9.2
unnamed: LED2.C, R10.2
unnamed: LED3.C, R11.1
unnamed: LED4.C, R12.2
unnamed: LED5.C, R13.1
unnamed: LED6.C, R14.2
unnamed: LED7.C, R15.1
unnamed: LED8.C, R16.2
unnamed: LED9.C, R17.1
unnamed: LED10.C, R63.2
NALERT: IC2.3 (O), X6.P$2 (2)
NFAULT: IC2.5 (O), X6.P$1 (1)

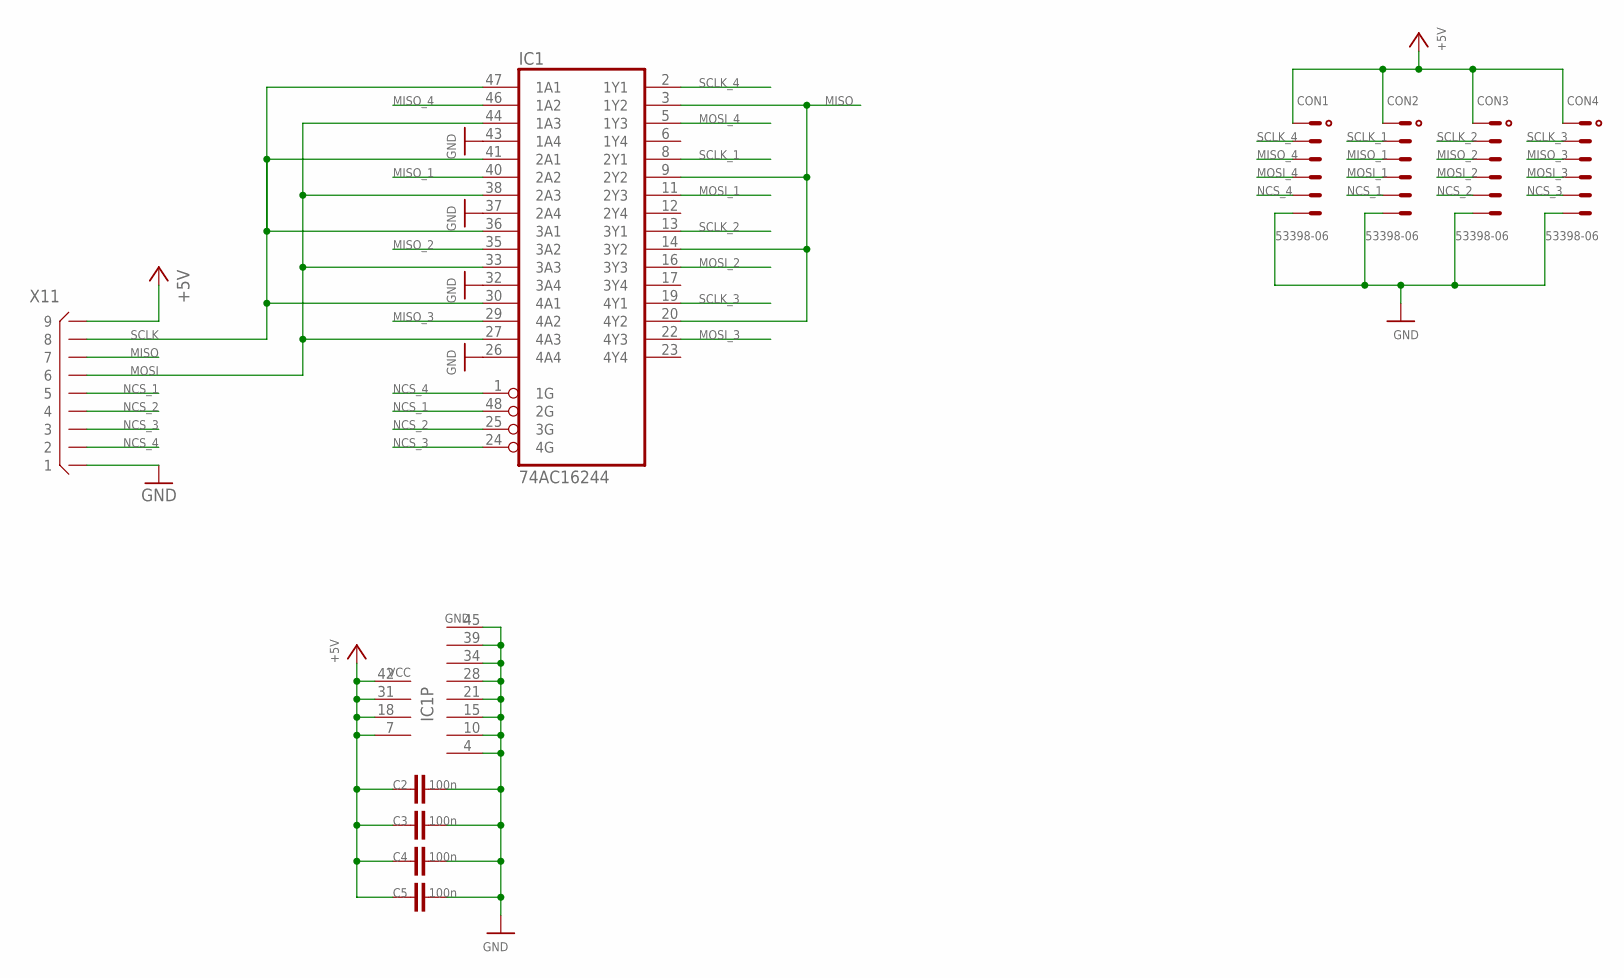
[picture p105: schematic HostInterfaceSplitter.sch, sheet 2]

Parts:
C2, C3, C4, C5: 100n; C0603
CON1, CON2, CON3, CON4: 53398-06
IC1: 74AC16244; SSOP48DL
X11: B9B-XH

Connections:
+5V: C2.2, C3.2, C4.2, C5.2, CON1.1, CON2.1, CON3.1, CON4.1, IC1.7 (VCC), IC1.18 (VCC), IC1.31 (VCC), IC1.42 (VCC), X11.P$9 (9); also elsewhere on the board
GND: C2.1, C3.1, C4.1, C5.1, CON1.6, CON2.6, CON3.6, CON4.6, IC1.4 (GND), IC1.10 (GND), IC1.15 (GND), IC1.21 (GND), IC1.26 (4A4), IC1.28 (GND), IC1.32 (3A4), IC1.34 (GND), IC1.37 (2A4), IC1.39 (GND), IC1.43 (1A4), IC1.45 (GND), X11.P$1 (1); also elsewhere on the board
MISO: IC1.3 (1Y2), IC1.9 (2Y2), IC1.14 (3Y2), IC1.20 (4Y2), X11.P$7 (7)
MISO_1: CON2.3, IC1.40 (2A2)
MISO_2: CON3.3, IC1.35 (3A2)
MISO_3: CON4.3, IC1.29 (4A2)
MISO_4: CON1.3, IC1.46 (1A2)
MOSI: IC1.27 (4A3), IC1.33 (3A3), IC1.38 (2A3), IC1.44 (1A3), X11.P$6 (6)
MOSI_1: CON2.4, IC1.11 (2Y3)
MOSI_2: CON3.4, IC1.16 (3Y3)
MOSI_3: CON4.4, IC1.22 (4Y3)
MOSI_4: CON1.4, IC1.5 (1Y3)
NCS_1: CON2.5, IC1.48 (2G), X11.P$5 (5)
NCS_2: CON3.5, IC1.25 (3G), X11.P$4 (4)
NCS_3: CON4.5, IC1.24 (4G), X11.P$3 (3)
NCS_4: CON1.5, IC1.1 (1G), X11.P$2 (2)
SCLK: IC1.30 (4A1), IC1.36 (3A1), IC1.41 (2A1), IC1.47 (1A1), X11.P$8 (8)
SCLK_1: CON2.2, IC1.8 (2Y1)
SCLK_2: CON3.2, IC1.13 (3Y1)
SCLK_3: CON4.2, IC1.19 (4Y1)
SCLK_4: CON1.2, IC1.2 (1Y1)

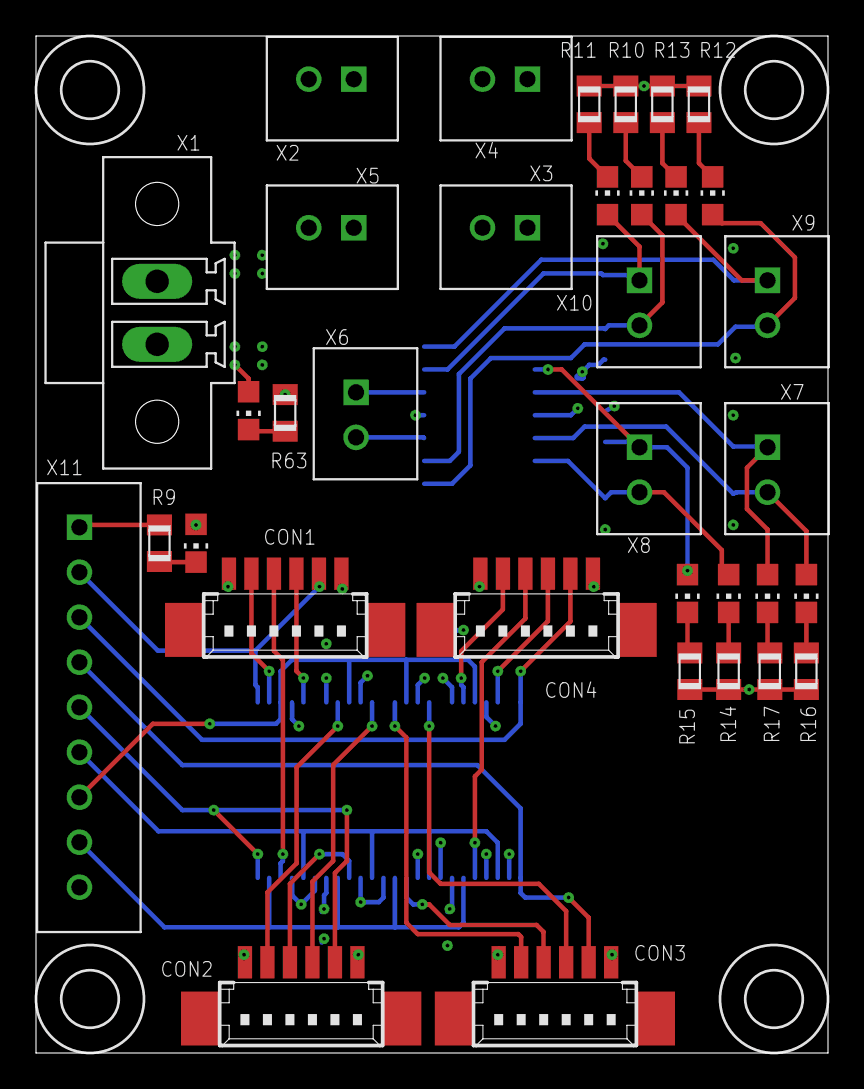
[picture p106: board HostInterfaceSplitter.brd from above]

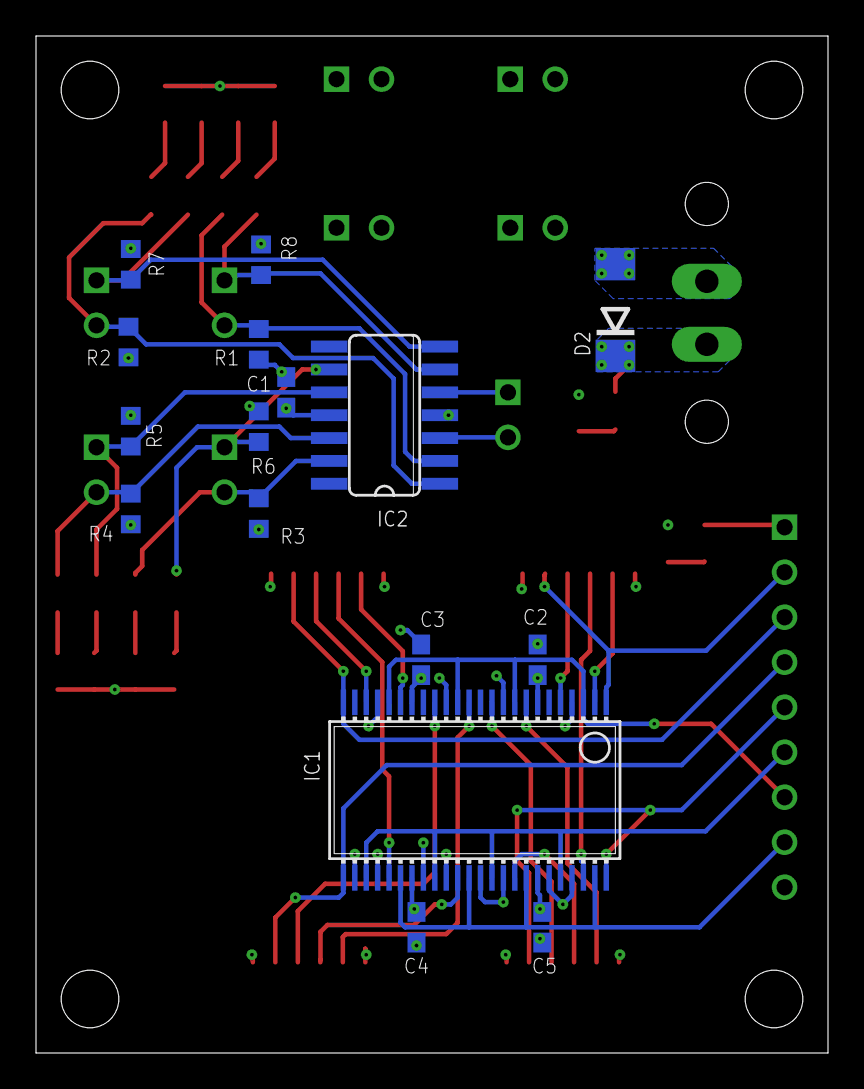
[picture p107: board HostInterfaceSplitter.brd from below]

Board: 4 copper layers, 44.0 x 56.5 mm, 55 parts (16 on the bottom side), 42 nets.
