TERA-TU-Graz/BatteryManagement_2017/HW/projects/ibex/BMS_Ibex/Bus_Isolator_trager/trager_v1/Bus_isolator_trager.brd

## EAGLE design HW/projects/ibex/BMS_Ibex/Bus_Isolator_trager/trager_v1/Bus_isolator_trager.brd (2017-08-10)

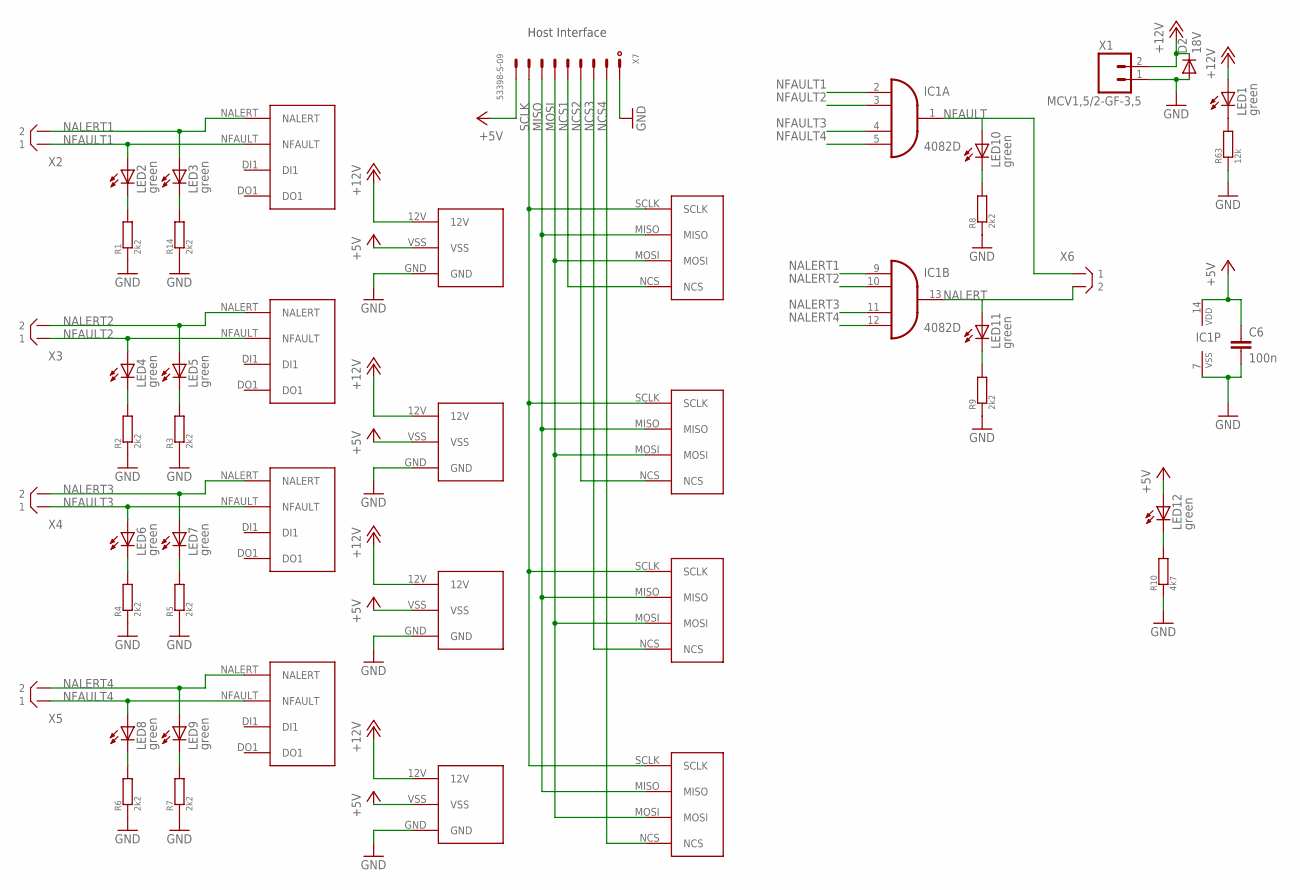
[picture p108: schematic Bus_isolator_trager.sch]

Parts:
A1, A2, A3, A4: SPI_ISOLATOR_V4
C6: 100n; C0603
D2: 18V; DO214AA
IC1: 4082D; SO14
LED1, LED12: green; CHIP-LED0805
LED2, LED3, LED4, LED5, LED6, LED7, LED8, LED9, LED10, LED11: green; CHIPLED_0805
R1, R2, R3, R4, R5, R6, R7, R8, R9, R14: 2k2; R0603
R10: 4k7; R0603
R63: 12k; R0603
X1: MCV1,5/2-GF-3,5
X2, X3, X4, X5, X6: B2B-XH
X7: 53398-S-09; 53398-09-S

Connections:
+5V: A1.VSS, A2.VSS, A3.VSS, A4.VSS, C6.1, IC1.14 (VDD), LED12.A, X7.9
+12V: A1.12V, A2.12V, A3.12V, A4.12V, D2.C, LED1.A, X1.2
GND: A1.GND, A2.GND, A3.GND, A4.GND, C6.2, D2.A, IC1.7 (VSS), R1.1, R2.1, R3.1, R4.1, R5.1, R6.1, R7.1, R8.1, R9.1, R10.1, R14.1, R63.1, X1.1, X7.1
MISO: A1.MISO, A2.MISO, A3.MISO, A4.MISO, X7.7
MOSI: A1.MOSI, A2.MOSI, A3.MOSI, A4.MOSI, X7.6
unnamed: LED2.C, R1.2
unnamed: LED4.C, R2.2
unnamed: LED5.C, R3.2
unnamed: LED6.C, R4.2
unnamed: LED7.C, R5.2
unnamed: LED8.C, R6.2
unnamed: LED9.C, R7.2
unnamed: LED10.C, R8.2
unnamed: LED11.C, R9.2
unnamed: LED12.C, R10.2
unnamed: LED3.C, R14.2
unnamed: LED1.C, R63.2
NALERT: IC1.13 (O), LED11.A, X6.P$2 (2)
NALERT1: A1.NALERT, IC1.9 (I0), LED3.A, X2.P$2 (2)
NALERT2: A2.NALERT, IC1.10 (I1), LED5.A, X3.P$2 (2)
NALERT3: A3.NALERT, IC1.11 (I2), LED7.A, X4.P$2 (2)
NALERT4: A4.NALERT, IC1.12 (I3), LED9.A, X5.P$2 (2)
NCS1: A1.NCS, X7.5
NCS2: A2.NCS, X7.4
NCS3: A3.NCS, X7.3
NCS4: A4.NCS, X7.2
NFAULT: IC1.1 (O), LED10.A, X6.P$1 (1)
NFAULT1: A1.NFAULT, IC1.2 (I0), LED2.A, X2.P$1 (1)
NFAULT2: A2.NFAULT, IC1.3 (I1), LED4.A, X3.P$1 (1)
NFAULT3: A3.NFAULT, IC1.4 (I2), LED6.A, X4.P$1 (1)
NFAULT4: A4.NFAULT, IC1.5 (I3), LED8.A, X5.P$1 (1)
SCLK: A1.SCLK, A2.SCLK, A3.SCLK, A4.SCLK, X7.8

Notes on the sheet:
Host Interface

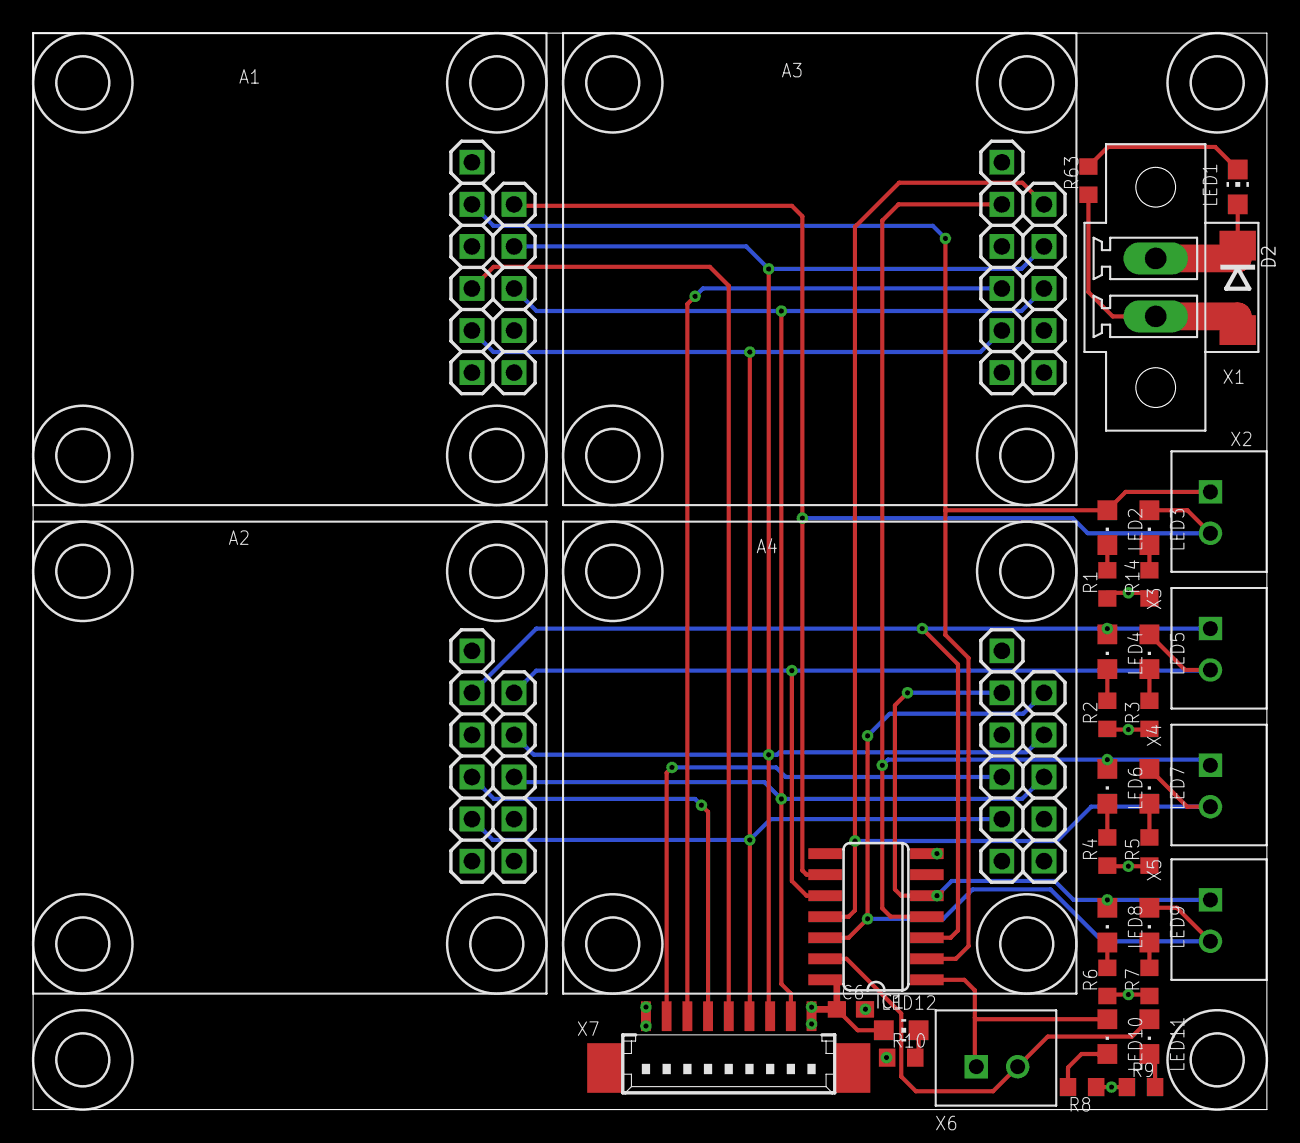
[picture p109: board Bus_isolator_trager.brd from above]

Board: 4 copper layers, 74.5 x 65.0 mm, 41 parts (0 on the bottom side), 32 nets.

Other parts of the board:
U$5, U$7, U$8: 3,2
