TERA-TU-Graz/BatteryManagement_2017/SW/Master/CubeMX_Master_HWv6p/CubeMX_Master_HWv6p.ioc

Mcu.UserName=STM32F405RGTx
PA1.GPIO_Label=LEM1
PA1.Signal=ADCx_IN1
PA10.GPIO_Label=CAN1_RS
PA10.Signal=GPIO_Output
PA11.Signal=CAN1_RX
PA12.Signal=CAN1_TX
PA13.Signal=SYS_JTMS-SWDIO
PA14.Signal=SYS_JTCK-SWCLK
PA15.Signal=SYS_JTDI
PA2.GPIO_Label=LEM2
PA2.Signal=ADCx_IN2
PA3.GPIO_Label=WHEEL_SPEED
PA3.Signal=S_TIM2_CH4
PA4.GPIO_Label=SPI1_CS_B0
PA4.Signal=GPIO_Output
PA5.Signal=SPI1_SCK
PA6.Signal=SPI1_MISO
PA7.Signal=SPI1_MOSI
PA8.GPIO_Label=SuperCharger_On
PA8.Signal=GPIO_Input
PA9.GPIO_Label=SuperCharger_Fault
PA9.Signal=GPIO_Input
PB0.GPIO_Label=SPI1_CS
PB0.Signal=GPIO_Output
PB1.GPIO_Label=Main_on
PB1.Signal=GPIO_Input
PB10.GPIO_Label=N_Alert
PB10.Signal=GPIO_Input
PB11.GPIO_Label=FAN_Fault
PB11.Signal=GPIO_Input
PB12.Signal=CAN2_RX
PB13.Signal=CAN2_TX
PB14.GPIO_Label=CAN2_RS
PB14.Signal=GPIO_Output
PB15.GPIO_Label=SPI1_CS_B1
PB15.Signal=GPIO_Output
PB2.GPIO_Label=Main_fault
PB2.Signal=GPIO_Input
PB3.Signal=SYS_JTDO-SWO
PB4.Signal=SYS_JTRST
PB5.GPIO_Label=LED1
PB5.Signal=GPIO_Output
PB6.GPIO_Label=Interlock_On1
PB6.Signal=GPIO_Output
PB7.GPIO_Label=Interlock_On2
PB7.Signal=GPIO_Output
PC0.GPIO_Label=TS1
PC0.Signal=ADCx_IN10
PC1.GPIO_Label=TS2
PC1.Signal=ADCx_IN11
PC10.Signal=UART4_TX
PC11.Signal=UART4_RX
PC12.GPIO_Label=LED3
PC12.Signal=GPIO_Output
PC13-ANTI_TAMP.GPIO_Label=BUTTON_ON
PC13-ANTI_TAMP.Signal=GPIO_Input
PC14-OSC32_IN.GPIO_Label=BUTTON_OFF
PC14-OSC32_IN.Signal=GPIO_Input
PC2.GPIO_Label=TS3
PC2.Signal=ADCx_IN12
PC3.GPIO_Label=TS4
PC3.Signal=ADCx_IN13
PC4.GPIO_Label=Interlock_OK
PC4.Signal=GPIO_Input
PC5.GPIO_Label=N_TMP_REF_SHDN
PC5.Signal=GPIO_Output
PC6.GPIO_Label=SPI1_CS_B2
PC6.Signal=GPIO_Output
PC7.GPIO_Label=N_Fault
PC7.Signal=GPIO_Input
PC8.GPIO_Label=Precharge_fault
PC8.Signal=GPIO_Input
PC9.GPIO_Label=FAN_PWM
PC9.Signal=S_TIM3_CH4
PD2.GPIO_Label=LED2
PD2.Signal=GPIO_Output
PH0-OSC_IN.Signal=RCC_OSC_IN
PH1-OSC_OUT.Signal=RCC_OSC_OUT
