TERA-TU-Graz/BatteryManagement_2017/(commit log)

2017-08-10 Adding kicad libs
2017-08-10 Adding PCB files
    [2xLowSideSwitch8A.sch, 2xRelaisWithRM.sch, BMS_Master.brd, BMS_Master.sch, BMS_Master_V5_kicad.kicad_pcb, BMS_Master_V5_kicad.sch, BMS_Master_V6_kicad.csv, BMS_Master_V6_kicad.kicad_pcb]
2018-10-28 Update github repo with designs for fennek 2018
    [2xLowSideSwitch8A.sch, BMS_Master_V7_kicad.csv, BMS_Master_V7_kicad.kicad_pcb, BalancerOneCell.sch, Chip.sch, Daisychain.sch, HV_distribution.sch, Host_connect.sch]
2018-10-28 Sync ibex bms with tera local
    [2xLowSideSwitch8A.sch, 2xRelaisWithRM.sch, BMS_Master_V6_kicad.kicad_pcb, BMS_Master_V6_kicad.sch, BalancerOneCell.sch, Bus_Isolator.kicad_pcb, Bus_Isolator.sch, Bus_Isolator_V3-2.kicad_pcb]
