TERA-TU-Graz/BatteryManagement_2017/(notices)

Notices in the files:
SW/Master/CubeMX_Master_HWv3/Inc/main.h:
COPYRIGHT(c) 2017 STMicroelectronics
(C) COPYRIGHT STMicroelectronics *****END OF FILE
HW/projects/fennek_2017_18/BMS/measurement_and_balancing/bms_board_V6__12s_fennek2017/bms_board.kicad_pcb:
©2017, Pöschl
© Pöschl Rene, Jan. 2017 Solderpad v0.51
HW/projects/fennek_2017_18/BMS/power_distribution/fennek_power_distribution_v2/bacup/fennek_power_distribution.kicad_pcb:
© Pöschl Rene,
Mar. 2017 Solderpad v0.51
HW/projects/fennek_2017_18/BMS/power_distribution/fennek_power_distribution_v2/fennek_power_distribution.kicad_pcb:
©Pöschl, Jun.2017
HW/projects/fennek_2017_18/BMS/master_fennek18/BMS_Master_V7 -- fennek18/BMS_Master_V7_kicad.kicad_pcb:
©Pöschl, 2018
©Pöschl, Apr. 2018
HW/projects/fennek_2017_18/BMS/measurement_and_balancing/bms_board_V6-1__12s_fennek2017/bms_board.kicad_pcb:
© Pöschl Rene, Mar. 2018 Solderpad v0.51
HW/projects/ibex/BMS_Ibex/HostInterfaceSplitter/HostInterfaceSplitter-V2.1/HostInterfaceSplitter-V2.kicad_pcb:
©2018 Pöschl
©Pöschl Rene, Apr. 2018
HW/projects/ibex/BMS_Ibex/Bus_Isolator/Bus_Isolator_V3.2/Bus_Isolator_V3-2.kicad_pcb:
©Pöschl, 2017
HW/projects/ibex/BMS_Ibex/Messboard/bms_board_V5.1/bms_board.kicad_pcb:
©Pöachl, Jun. 2017
HW/projects/ibex/BMS_Ibex/Master/BMS_Master_V6_kicad/BMS_Master_V6_kicad.kicad_pcb:
©Pöschl, 2016
©Pöschl, Jan.2017
HW/projects/ibex/BMS_Ibex/Interlock/InterlockV2.2-kicad/Interlock.kicad_pcb:
©Pöschl Rene, Apr. 2017
HW/projects/ibex/BMS_Ibex/Balancer/bms_balance_v4.1/bms_balance_v4.kicad_pcb:
©Pöschl, Apr 2017
parts and their libraries:
SparkFun: Licensing: CC v3.0 Share-Alike You are welcome to use this library for commercial purposes.
